Nuvoton-Israel/nuvoton-info/README.md

# Nuvoton Info
Information of Nuvoton's NPCM7xx:
 - Evaluation Board (EVB)
     https://github.com/Nuvoton-Israel/nuvoton-info/blob/master/npcm7xx-poleg/evaluation-board
 - RunBMC
     https://github.com/Nuvoton-Israel/nuvoton-info/blob/master/npcm7xx-poleg/RunBMC
 - graphics
     https://github.com/Nuvoton-Israel/nuvoton-info/blob/master/npcm7xx-poleg/Graphics
 
Contains BootBlock, u-boot and OpenBMC programming guide, tools and SW.

Openbmc features and capabilities on the EVB are are described [here](https://github.com/Nuvoton-Israel/openbmc/blob/master/meta-evb/meta-evb-nuvoton/meta-evb-npcm750/README.md).
