Nuvoton-Israel/nuvoton-info/npcm7xx-poleg/readme.txt

------------------------------------------------------------------------
Nuvoton Technology Corporation - Confidential
Poleg OpenBMC files and instructions
Copyright (c) 2017-2019 Nuvoton Technology Corporation. All Rights Reserved.
------------------------------------------------------------------------

Poleg npcm7xx-poleg files and instructions
==========================================

Folder content
==============
--evaluation-board - EVB board and SW (see readme.txt inside
--RunBMC           - RunBMC board and SW (see readme.txt inside
--Graphics         - Graphic drivers

----------------------------
For any help please contact:
tomer.maimon@nuvoton.com
avi.fishman@nuvoton.com
tali.perry@nuvoton.com
oshri.alkoby@nuvoton.com
----------------------------
