Nuvoton-Israel/nuvoton-info/npcm7xx-poleg/RunBMC/board_deliverables/Nuvoton_RunBMC_Module/RunBMC_NPCM7mnx_BOM_A.1.0.xlsx

Quantity | Value | Description | Part Reference
145 | 0.1uF | CAP CER X5R SMD 0.1uF 10% 10V 0201 | C1 C2 C3 C4 C5 C6 C7 C8 C9 C10 C11 C12 C13 C14 C15 C16 C17 C18 C19 C23 C25 C26 C28 C29 C31 C33 C34 C35 C37 C38 C39 C40 C41 C42 C43 C44 C45 C46 C47 C48 C49 C50 C51 C52 C53 C54 C55 C56 C61 C63 C64 C66 C67 C68 C72 C73 C74 C75 C76 C77 C78 C79 C80 C81 C82 C83 C84 C85 C89 C90 C91 C92 C93 C94 C95 C96 C97 C98 C99 C100 C101 C102 C103 C104 C105 C106 C107 C108 C109 C112 C113 C114 C116 C117 C118 C119 C120 C121 C123 C127 C128 C129 C131 C133 C134 C135 C136 C137 C138 C139 C141 C142 C143 C144 C146 C148 C150 C152 C154 C155 C157 C158 C161 C162 C164 C165 C167 C170 C171 C172 C174 C175 C176 C178 C179 C180 C181 C182 C183 C193 C194 C195 C200 C201 C202
28 | 4.7uF | CAP CER X5R SMD 4.7uF 10% 16V 0402 | C20 C21 C24 C30 C32 C36 C57 C58 C65 C70 C71 C87 C88 C110 C111 C115 C122 C124 C130 C140 C145 C163 C168 C169 C173 C177 C188 C191
22 | 22uF | CAP CER X5R SMD 22uF 20% 6.3V 0603 | C22 C27 C59 C60 C69 C86 C147 C149 C151 C153 C160 C166 C186 C187 C189 C190 C192 C196 C197 C199 C203 C204
1 | 1nF | CAP CER X5R SMD 1nF 10% 10V 0201 | C62
3 | 22pF | CAP CER X5R SMD 22pF 10% 10V 0201 | C125 C126 C184
1 | 1uF | CAP CER X7R SMD 1uF 10% 10V 0402 | C132
2 | 18pF | CAP CER NPO SMD 18pF 5% 16V 0402 | C156 C159
1 | 33pF | CAP CER X5R SMD 33pF 10% 10V 0201 | C185
2 | 2700pF | CAP CER X5R SMD 2700pF 10% 6.3V 0201 | C198 C205
2 | DSF01S30SL | Diode SMD Schottky 30V 100mA | D1 D2
1 | LED Green | FHD1105P-TR, 5mA, Green, 0402 | D3
1 | LED Amber | FHA1105P-TR, 5mA, Amber, 0402 | D4
1 | SMD D-ROW 8P 1.25MM | Con Recept SMD D-ROW 8P 1.25MM | J1
1 | SODIMM_260P | SODIMM_260P | J2
1 | 47uH | Inductor SMD 47uH 75mA SRF=11Mhz 10% 0805 | L1
11 | BK0603HR102-T | Bead SMD 1K@100MHz 220mA 1.15R 0201 | L2 L3 L4 L5 L7 L10 L11 L12 L13 L14 L15
3 | BK1005HS102-T | Bead SMD 1K@100MHz 300mA 580mR 0402 | L6 L18 L19
5 | BLM15PX121SN1D | Bead SMD 120R@100MHz 2A 55mR 0402 | L8 L9 L16 L17 L20
2 | 1.5uH | Inductor SMD 1.5uH at 1MHz 20% 54mR 3A | L21 L22
37 | 0R | RES SMD 0R 0201 | R1 R2 R53 R62 R66 R67 R138 R185 R193 R195 R196 R197 R198 R199 R200 R201 R202 R203 R204 R205 R206 R207 R208 R209 R216 R230 R231 R232 R233 R241 R242 R243 R244 R251 R252 R253 R274
25 | 10K | RES SMD 10K 1% 0201 | R3 R4 R5 R6 R8 R9 R163 R164 R165 R166 R167 R168 R169 R170 R171 R172 R173 R214 R215 R262 R265 R268 R269 R273 R275
91 | 24.9R | RES SMD 24.9R 1% 0201 | R7 R47 R48 R54 R57 R58 R59 R109 R110 R111 R112 R113 R114 R115 R116 R117 R118 R119 R120 R121 R122 R123 R124 R125 R126 R127 R128 R129 R130 R131 R132 R133 R134 R135 R136 R137 R139 R140 R141 R142 R143 R144 R145 R146 R147 R148 R149 R150 R151 R152 R153 R154 R155 R156 R174 R175 R176 R177 R178 R179 R180 R181 R182 R183 R184 R210 R211 R212 R213 R217 R218 R219 R220 R221 R222 R223 R224 R225 R226 R227 R228 R229 R248 R254 R255 R256 R257 R258 R259 R260 R261
9 | 100K | RES SMD 100K 1% 0201 | R10 R70 R71 R72 R73 R74 R75 R76 R77
20 | 4.7K | RES SMD 4.7K 1% 0201 | R11 R12 R55 R56 R189 R190 R191 R192 R234 R235 R236 R237 R238 R239 R240 R245 R246 R247 R249 R250
24 | 17R | RES SMD 17R 1% 0201 | R13 R14 R15 R16 R17 R18 R19 R20 R21 R22 R23 R24 R25 R26 R27 R28 R29 R30 R31 R32 R33 R34 R35 R36
4 | 240R | RES SMD 240R 0.5% 0201 | R37 R38 R158 R161
2 | 49R | RES SMD 49R 1% 0201 | R39 R40
4 | 1K | RES SMD 1K 1% 0201 | R41 R42 R159 R162
3 | 200R | RES SMD 200R 1% 0201 | R43 R186 R187
3 | 75R | RES SMD 75R 0201 | R44 R45 R46
3 | 150R | RES SMD 150R 0201 | R49 R50 R51
1 | 3.74K | RES SMD 3.74K 1% 0201 | R52
2 | 220R | RES SMD 220R 1% 0201 | R60 R61
13 | 100R | RES SMD 100R 1% 0201 | R63 R64 R65 R68 R69 R101 R102 R103 R104 R105 R106 R107 R108
22 | 6.8K | RES SMD 6.8K 1% 0201 | R78 R79 R80 R81 R82 R83 R84 R85 R86 R87 R88 R89 R90 R91 R92 R93 R94 R95 R96 R97 R98 R99
1 | 20R | RES SMD 20R 1% 0201 | R100
2 | 100K | RES SMD 100K 1% 0201 | R157 R160
1 | 1.5K | RES SMD 1.5K 1% 0201 | R188
1 | 1.24K | RES SMD 1.24K 1% 0201 | R194
1 | 51K | RES SMD 51K 1% 0201 | R263
4 | 24K | RES SMD 24K 1% 0201 | R264 R267 R272 R278
1 | 30K | RES SMD 30K 1% 0201 | R266
2 | 8.2K | RES SMD 8.2K 1% 0201 | R270 R276
1 | 12K | RES SMD 12K 1% 0201 | R271
1 | 11.3K | RES SMD 11.3K 1% 0201 | R277
14 | Test Point Pad 20X20mil | Test Point Pad 20X20 mil for Scope Probing | TP1 TP2 TP3 TP4 TP5 TP6 TP7 TP8 TP9 TP10 TP11 TP12 TP13 TP14
2 | 74LVC1G11DW-7 | IC Single 3 Input AND Gate | U2 U4
1 | ECS-2520MV-250-CN-TR | Crystal Clock OSC SMD | U3
1 | ATtiny1634 QFN20 | Micro-Controller | U5
1 | TXS0102DCUR | IC 2-Bit Bidirectional Voltage-Level Translator for Open-Drain and Push-Pull 8-VFSOP | U8
1 | BCM54612EB1KMLG | IC 10/100/1000 BASE-T Gigabit Ethernet transceiver with RGMII MAC 3.3V MLP-48 | U9
1 | 74CBTLV3245 | Bus-Switch 8bit | U10
1 | AP22802AW5-7 | Load Switch | U11
1 | 74AHC1G00SE-7 | IC Single 3 Input AND Gate | U12
2 | MX66L51235F | IC Memory SMD Quad / Dual SPI Flash 512Mbit 2.7-3.6V 8-WSON | U13 U14
1 | M24xxx | I2C EEPROM M24xxx | U15
1 | M95512 | IC Memory SMD Quad / Dual SPI Flash 512Mbit 2.7-3.6V 8-WSON | U16
1 | TMP75 | TMP75 | U17
1 | SPI-2-Dual_UART_SC16IS75(6)2IBS | SC16IS75(6)2IBS | U18
2 | RT9059GQW | IC Linear SMD Regulator 3A 10WDFN | U19 U20
1 | NPCM750R | IC Microcontroller SMD BMC 2D Graphic Core KVM FCBGA-517 3.3V-2.5V | U1
2 | BD9A300MUV | IC Synchronous PWM Switching Buck Regulator 18Vmax SOIC8 | U21 U22
1 | APX823-29W5G-7 | IC Logic SMD Reset Controller Cirquit 2.973V | U23
1 | MT40A512M16HA-083E | IC Memory SMD SDRAM (DDR4-3200) 4Gb (256MX16) 1.2V FBGA-96 | U6
1 | H26M41204HPR | IC Memory eMMC 8GB v5.0-compliant 3.3V WFBGA-153 | U7
1 | 25MHz | Crystal SMD 25MHz 30ppm 18pF 3.2 X 2.5mm BGA-4 | Y1
1 | 24Mhz | Crystal SMD 24MHz 30ppm 10pF 3.2 X 2.5mm BGA-4 | Y2
