Nuvoton-Israel/nuvoton-info/npcm7xx-poleg/evaluation-board/readme.txt

------------------------------------------------------------------------
Nuvoton Technology Corporation - Confidential
Poleg OpenBMC files and instructions
Copyright (c) 2017-2018 Nuvoton Technology Corporation. All Rights Reserved.
------------------------------------------------------------------------

Poleg OpenBMC files and instructions
====================================

Building instructions:
======================
	In order to build Nuvoton OpenBMC use:
	======================================
	https://github.com/Nuvoton-Israel/openbmc/releases/tag/npcm-v2.3-181030
	Follow instructions at the README.md inside
	Nuvoton OpenBMC builds both Nuvoton u-boot and linux.
	
	To build them separately:

	In order to build Nuvoton linux use:
	====================================
	https://github.com/Nuvoton-Israel/linux
	Branch Poleg-4.17.04-OpenBMC
	To build it run:
		make ARCH=arm PolegSVB_defconfig
		make uImage nuvoton-npcm750-evb.dtb modules CROSS_COMPILE=arm-none-linux-gnueabi- ARCH=arm LOADADDR=0x8000

	In order to build Nuvoton u-boot use:
	=====================================
	https://github.com/Nuvoton-Israel/u-boot
	Follow build instructions see:
	https://github.com/Nuvoton-Israel/u-boot/blob/npcm7xx/HowToBuild-npcm7xx.txt

Loading to Evaluation Board and running instructions:
=====================================================
	Use the provided Evaluation board (EB) with the pre-built images:
	=================================================================
	For initial EB setup see:
	- ./board_deliverables/NPCM750x_EVB_Quick_Setup_Guide.pdf
	For loading images to EB and running them.
	- ./sw_deliverables/NPCM7xx_OpenBMC_Programming.pdf
	
	Testing your peripheral access:
	===============================
	The following shell script contains examples for reading / writing to peripherals
	- ./sw_deliverables/linux_peripheral_testings.sh

FTP CONTENTS
============
Eval_Board
|   readme.txt - this readme file
|
|---sw_deliverables
|   |   NPCM7xx_OpenBMC_Programming.pdf - describes how to update the EB
|   |   uboot_env_parameters.txt - uboot environment that will load and run the OpenBMC_linux_X.X.X
|   |   linux_peripheral_testings.sh - shell script with examples for reading / writing to peripherals
|   |
|   \---npcm7xx_v2.3 - built images of Nuvoton OpenBMC
|           image-bmc    - The entire 32MB image including BootBlock, u-boot, linux kernel
|                          and file system, can be programmed into the beginning of flash
|           image-u-boot - Includes only BootBlock and u-boot and their headers can be
|                          programmed into the beginning of flash
|           image-kernel - FIT image that includes linux kernel, device tree and an
|                          initial file system, can be loaded to the linux area in flash
|           image-rofs   - Main (and large) OpenBMC file system, can be loaded to the
|                          rofs area in flash
|           uboot_env_parameters.txt - uboot environment that will load this image
|
|---board_deliverables
|       NPCM750x_EVB_Quick_Setup_Guide.pdf  - How to work with the EB 
|       NPCM750x_EB_ver.A1.1_COMPLETE.pdf   - EVB schematics
|
\---Graphics
        Poleg_Graphics_Drivers_3.0.zip - Graphic drivers for BIOS, UEFI, Windows and linux

----------------------------
For any help please contact:
tomer.maimon@nuvoton.com
avi.fishman@nuvoton.com
tali.perry@nuvoton.com
oshri.alkoby@nuvoton.com
----------------------------
