Nuvoton-Israel/nuvoton-info/npcm7xx-poleg/evaluation-board/board_deliverables/NPCM750x_EB_ver.A1.1_COMPLETE.pdf

# NPCM750x Evaluation Board

# Schematics, Layout, Assembly and BOM

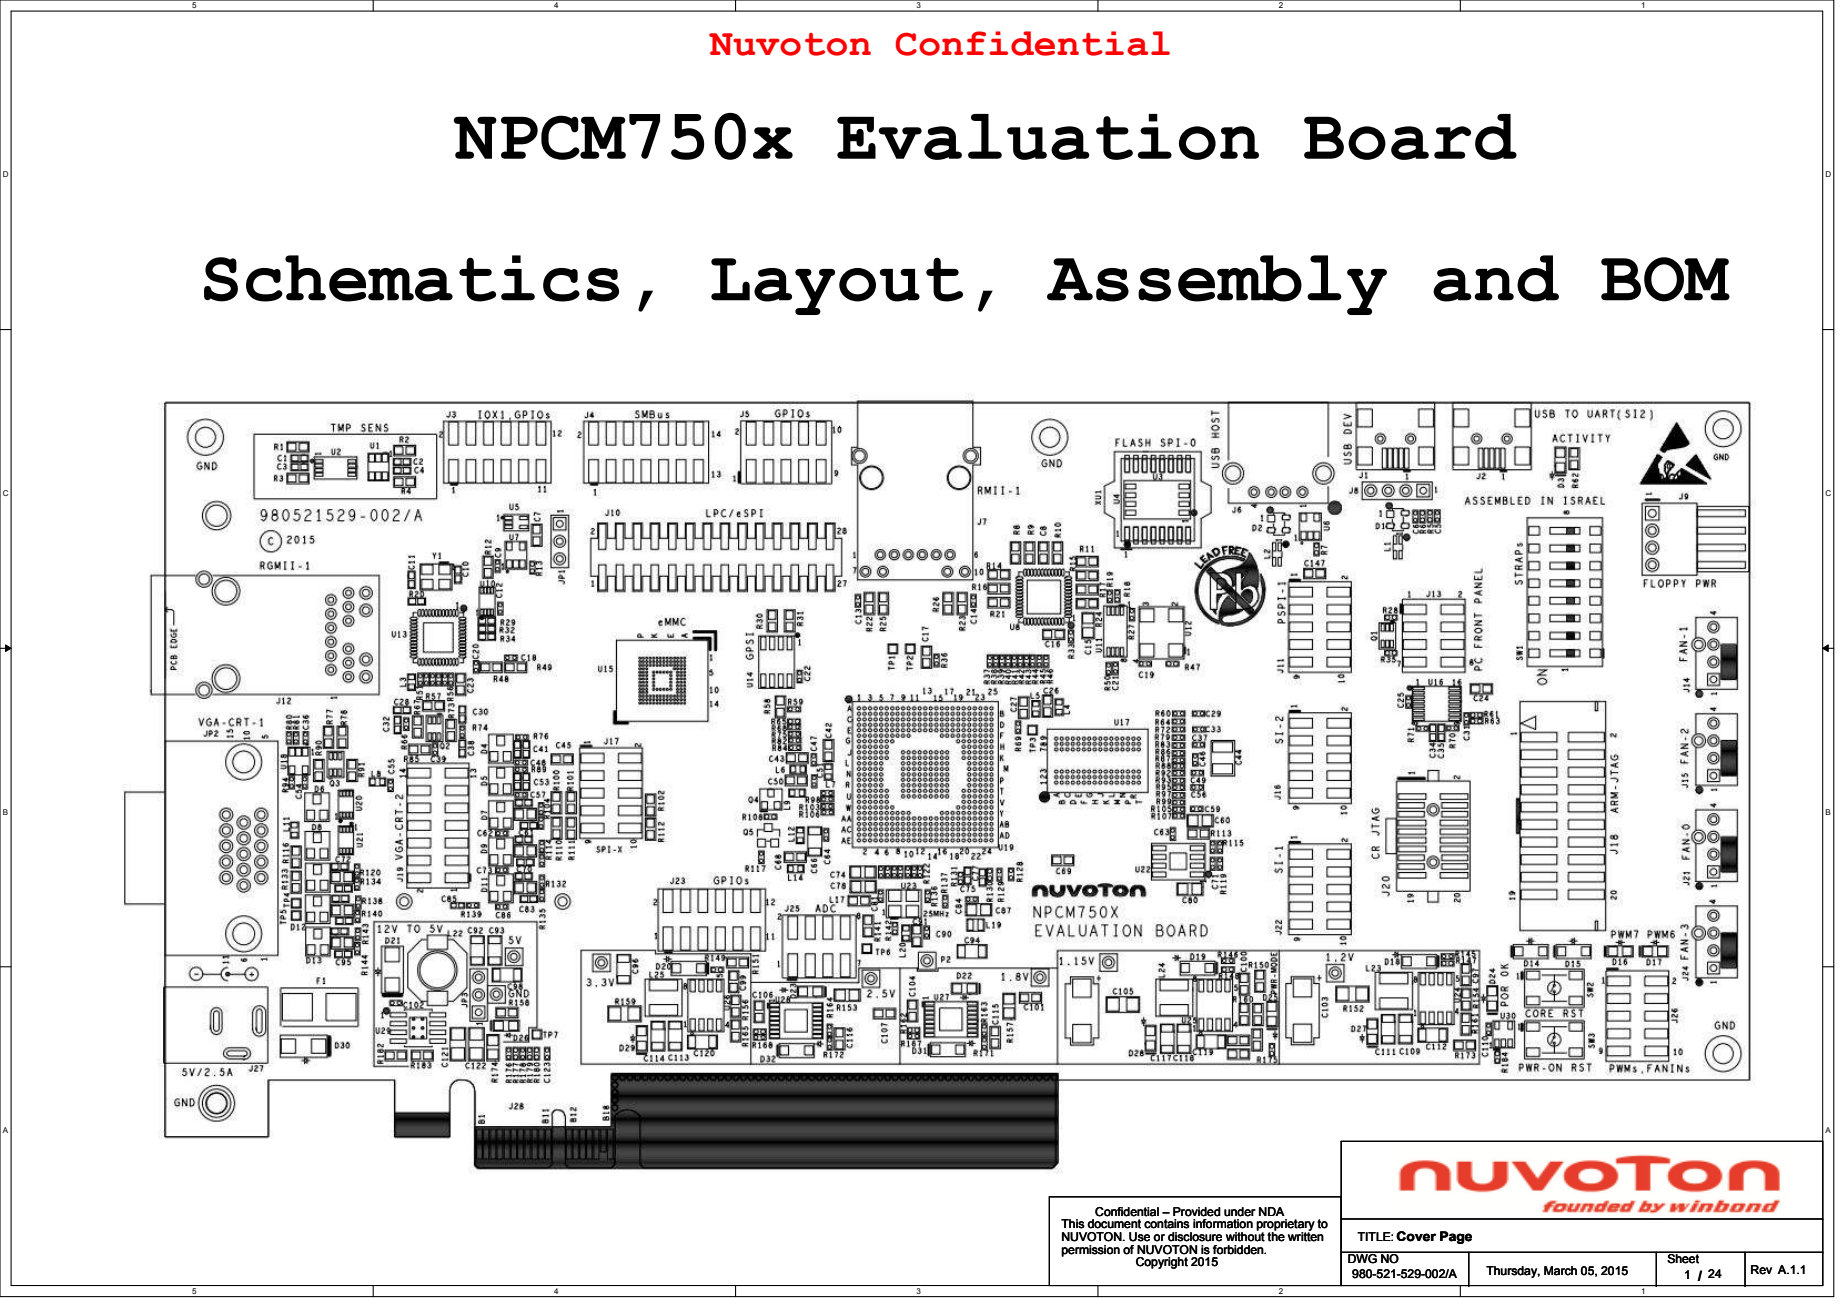
[picture p30: page 1]
Nuvoton Confidential; DWG NO; Rev; Sheet; TITLE:; Copyright 2015; Cover Page; Thursday, March 05, 2015

This document contains information proprietary to
NUVOTON. Use or disclosure without the written
permission of NUVOTON is forbidden.

Confidential – Provided under NDA

# NPCM750x

## PCIe x1

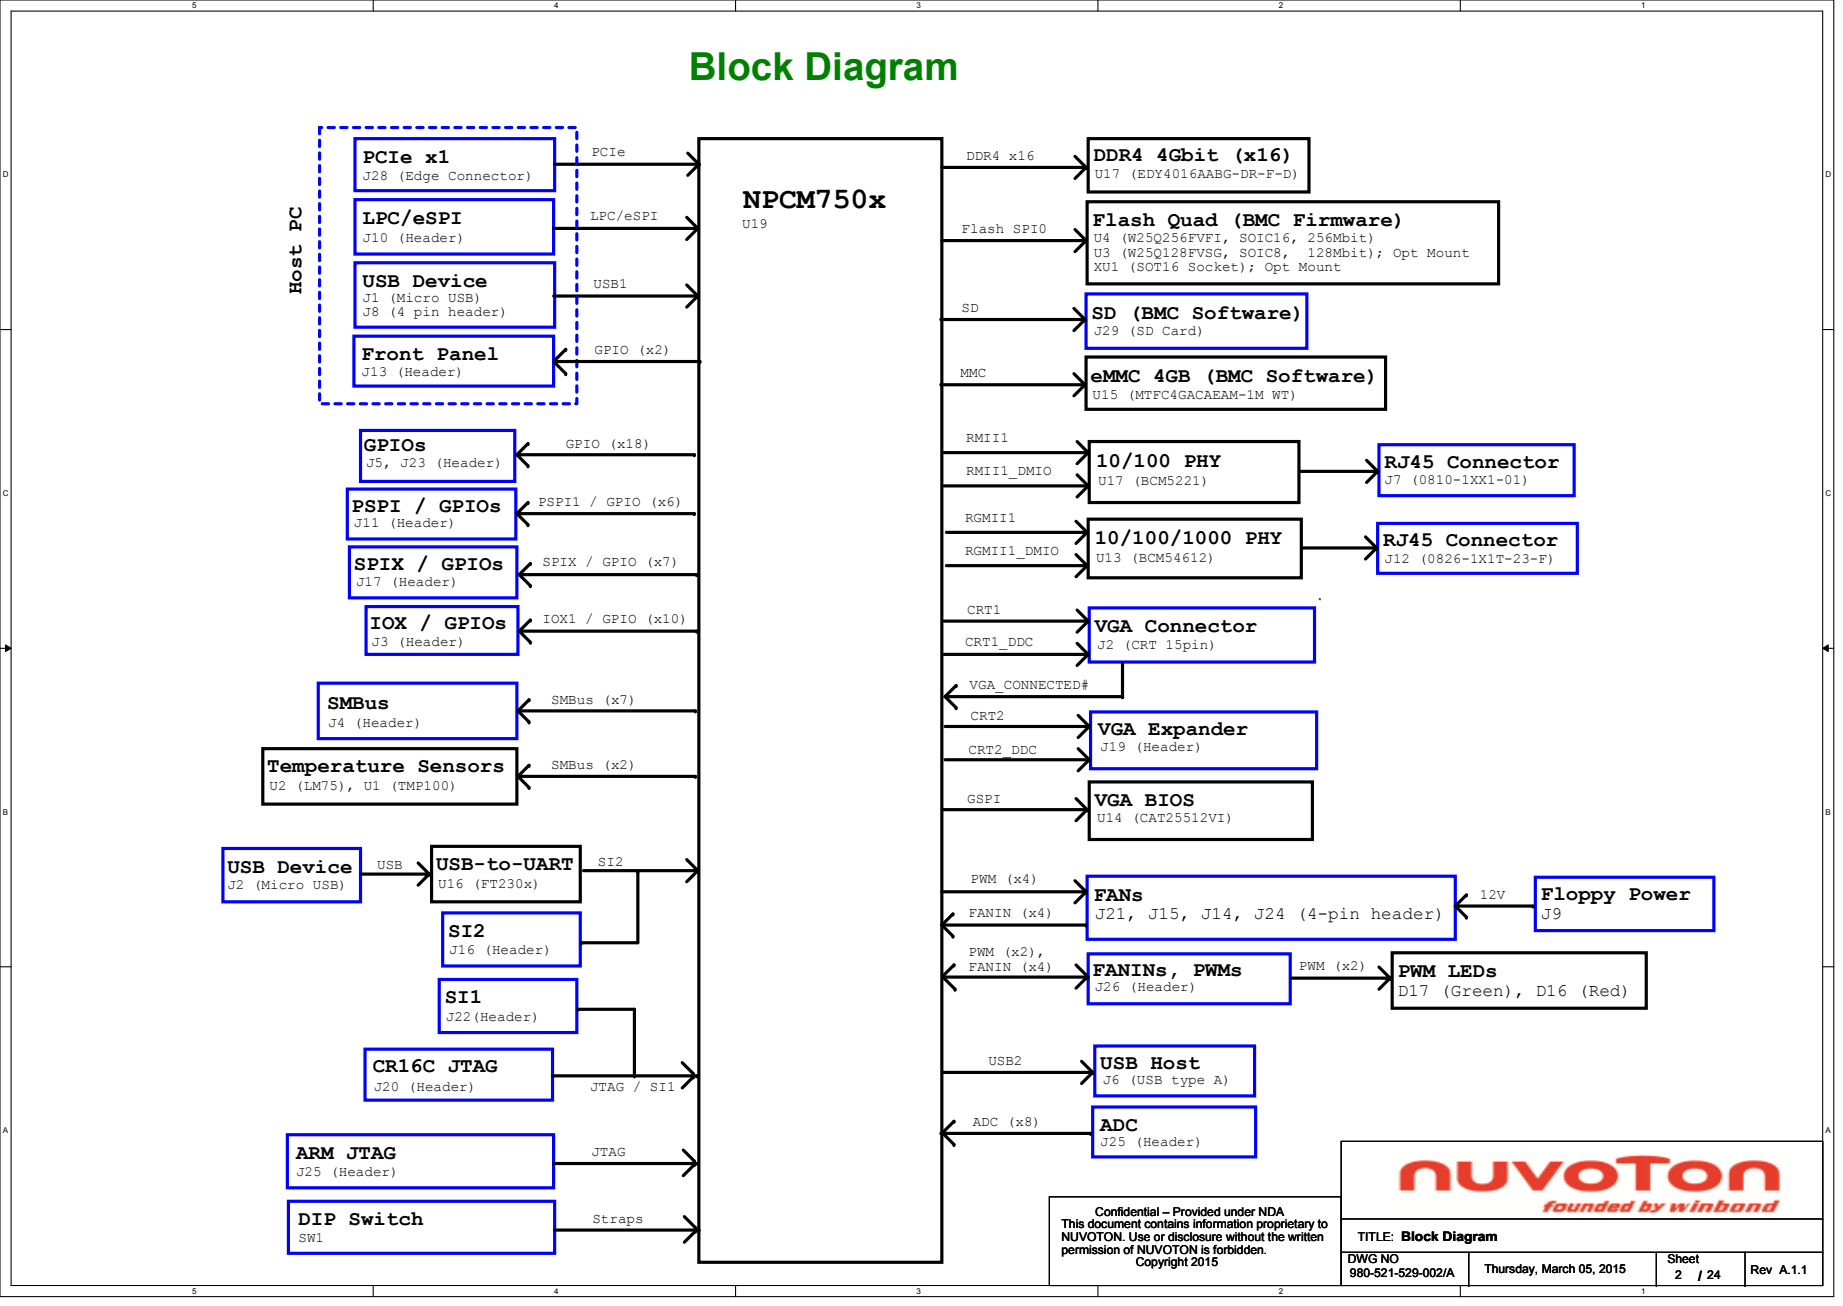
[picture p31: page 2]

Flash Quad (BMC Firmware)
U4 (W25Q256FVFI, SOIC16, 256Mbit)
U3 (W25Q128FVSG, SOIC8, 128Mbit); Opt Mount
XU1 (SOT16 Socket); Opt Mount

# Power Tree

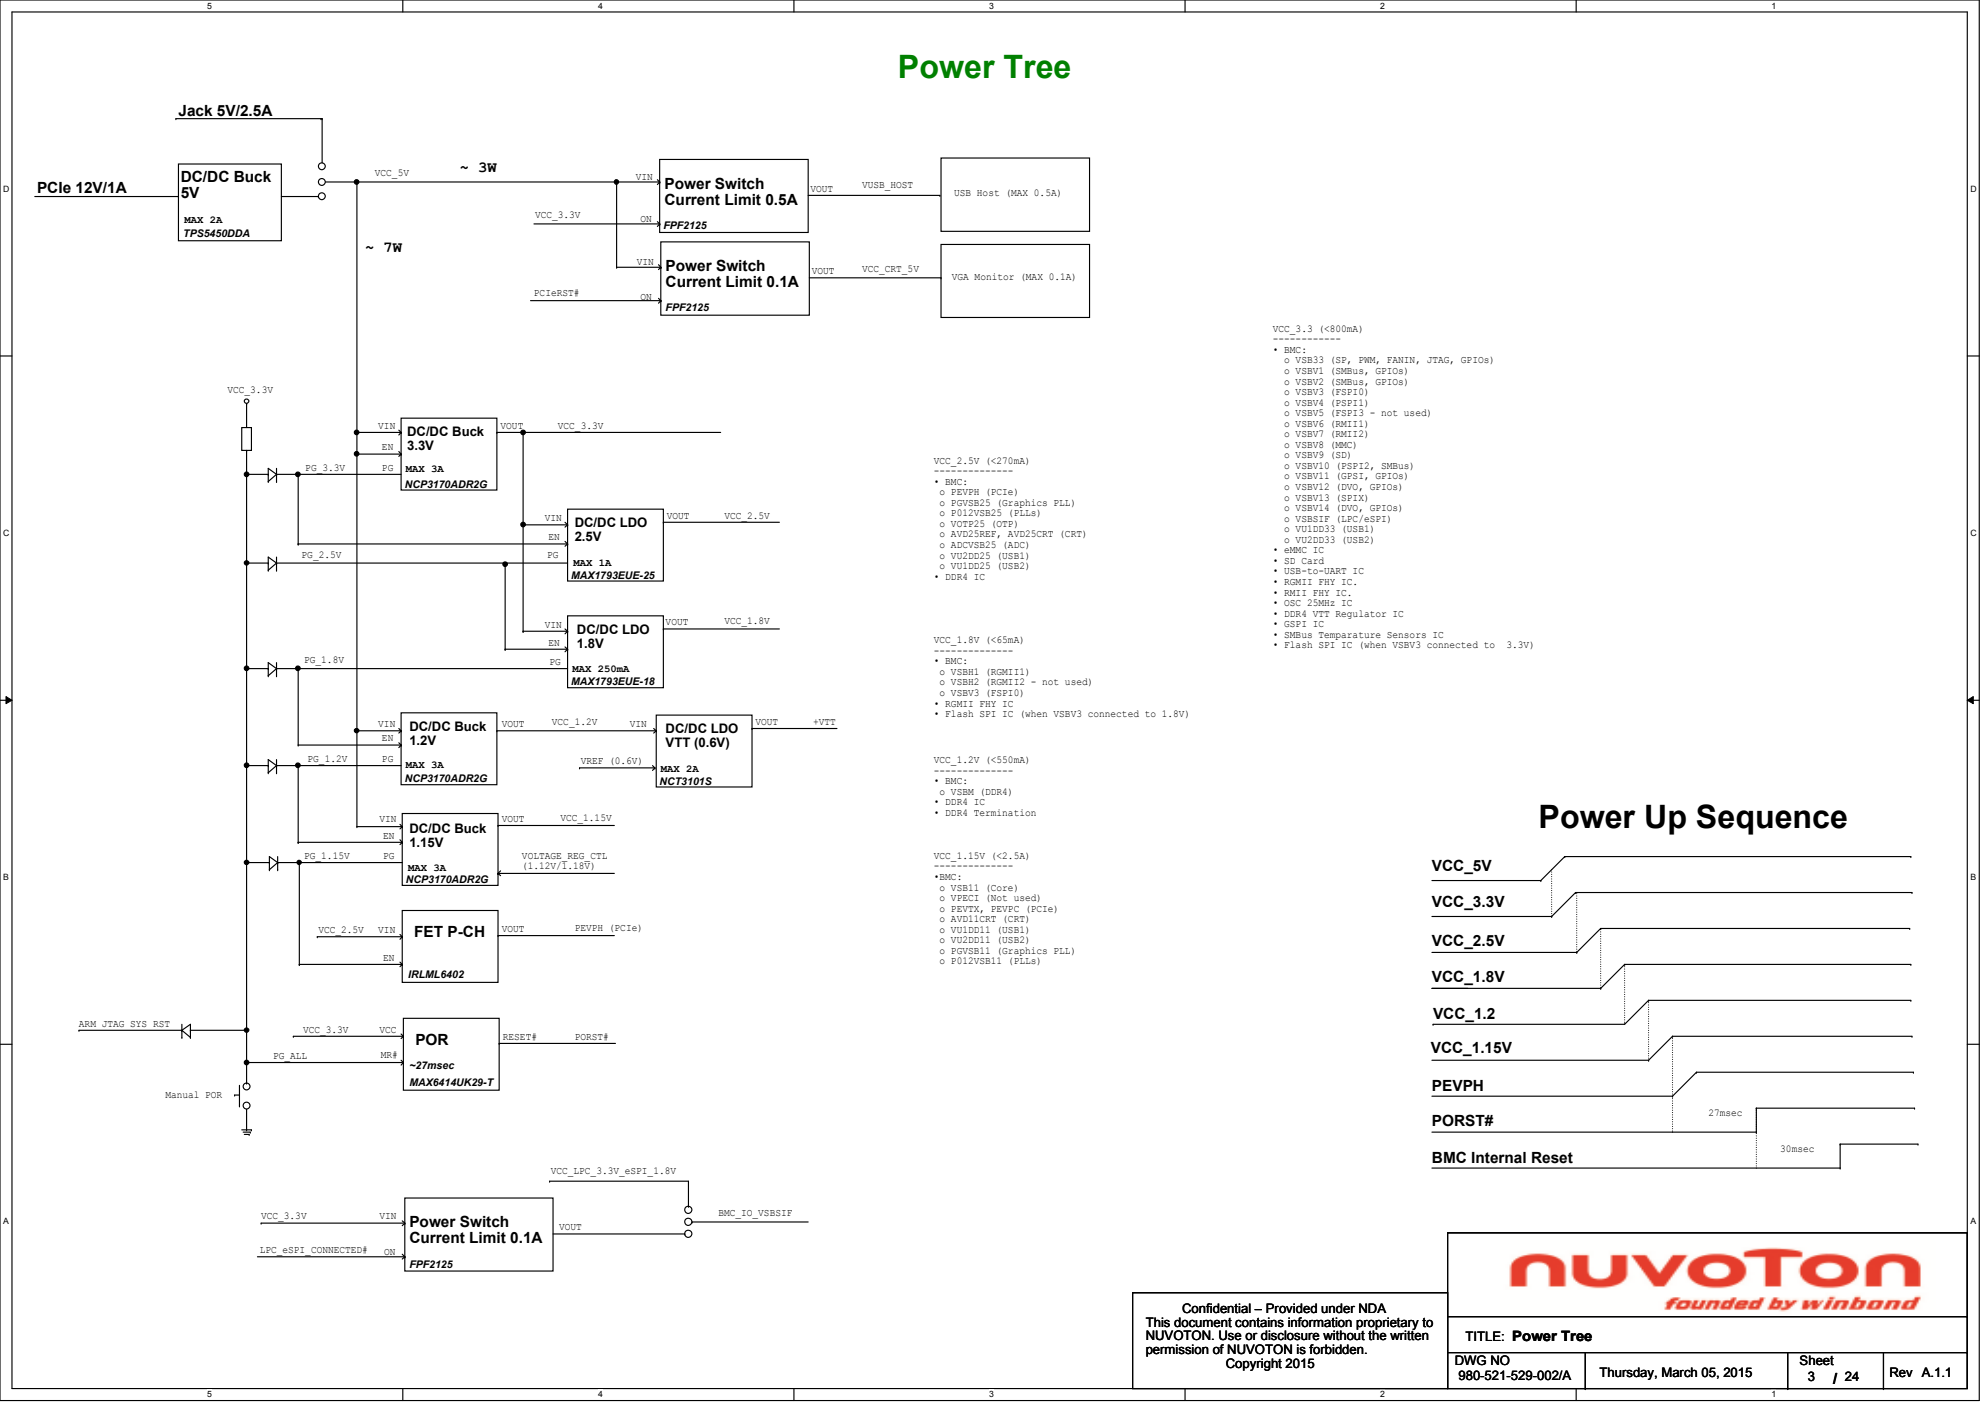
[picture p32: page 3]
VCC_5V; Power Switch; Current Limit 0.5A; FPF2125; Power Switch Current Limit 0.1A; PCIeRST#; VIN; VOUT; VCC_3.3V; DC/DC Buck 3.3V; NCP3170ADR2G; DC/DC Buck 1.2V; DC/DC Buck 1.15V; VCC_1.2V; VCC_1.15V; FET P-CH VOUT; PEVPH (PCIe); IRLML6402; POR; RESET#; PORST#; MAX6414UK29-T; ~27msec PG_ALL; VCC ARM JTAG SYS RST; Manual POR; VOLTAGE_REG_CTL (1.12V/1.18V); VCC_2.5V; VCC_3.3 (<800mA) ------------ • BMC:; 27msec; VCC_1.8V; VCC_1.2; PEVPH; VCC_CRT_5V; VUSB_HOST; LPC_eSPI_CONNECTED#; BMC_IO_VSBSIF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

USB Host (MAX 0.5A)

VGA Monitor (MAX 0.1A)

• VSB33 (SP, PWM, FANIN, JTAG, GPIOs)
• VSBV1 (SMBus, GPIOs)
• VSBV2 (SMBus, GPIOs)
• VSBV3 (FSPI0)
• VSBV4 (PSPI1)
• VSBV5 (FSPI3 - not used)
• VSBV6 (RMII1)
• VSBV7 (RMII2)
• VSBV8 (MMC)
• VSBV9 (SD)
• VSBV10 (PSPI2, SMBus)
• VSBV11 (GPSI, GPIOs)
• VSBV12 (DVO, GPIOs)
• VSBV13 (SPIX)
• VSBV14 (DVO, GPIOs)
• VSBSIF (LPC/eSPI)
• VU1DD33 (USB1)
• VU2DD33 (USB2)
• eMMC IC
• SD Card
• USB-to-UART IC
• RGMII FHY IC.
• RMII FHY IC.
• OSC 25MHz IC
• DDR4 VTT Regulator IC
• GSPI IC
• SMBus Temparature Sensors IC
• Flash SPI IC (when VSBV3 connected to 3.3V)

• VSBH1 (RGMII1)
• VSBH2 (RGMII2 - not used)
• RGMII FHY IC
• Flash SPI IC (when VSBV3 connected to 1.8V)

DC/DC LDO
VTT (0.6V)

Power Up Sequence

30msec BMC Internal Reset

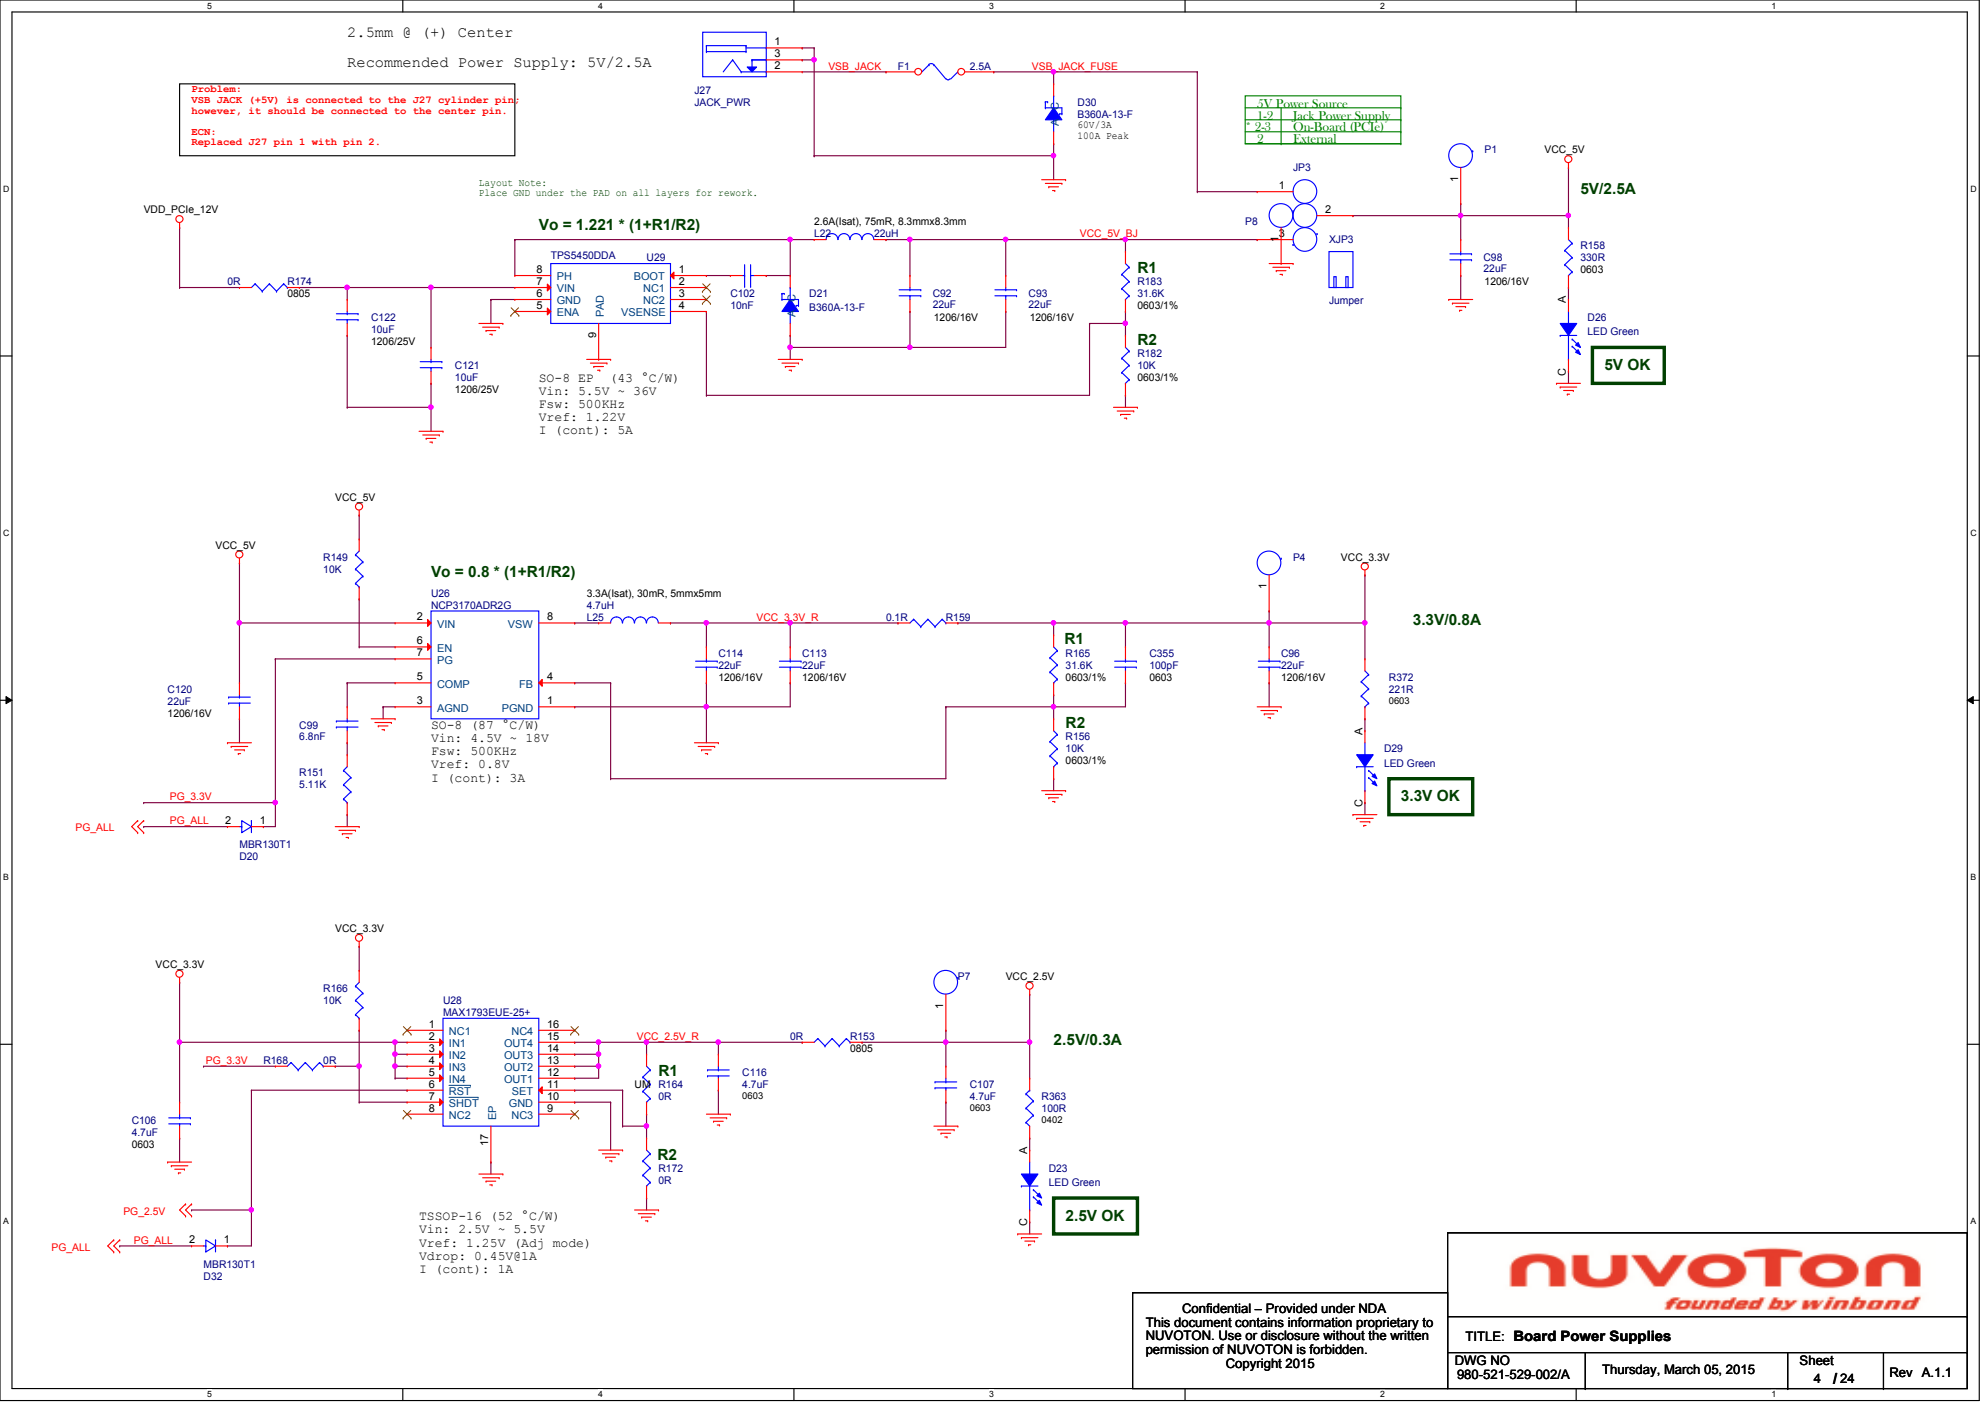
[picture p33: page 4]

Problem:
VSB JACK (+5V) is connected to the J27 cylinder pin;
however, it should be connected to the center pin.

ECN:
Replaced J27 pin 1 with pin 2.

Layout Note:
Place GND under the PAD on all layers for rework.

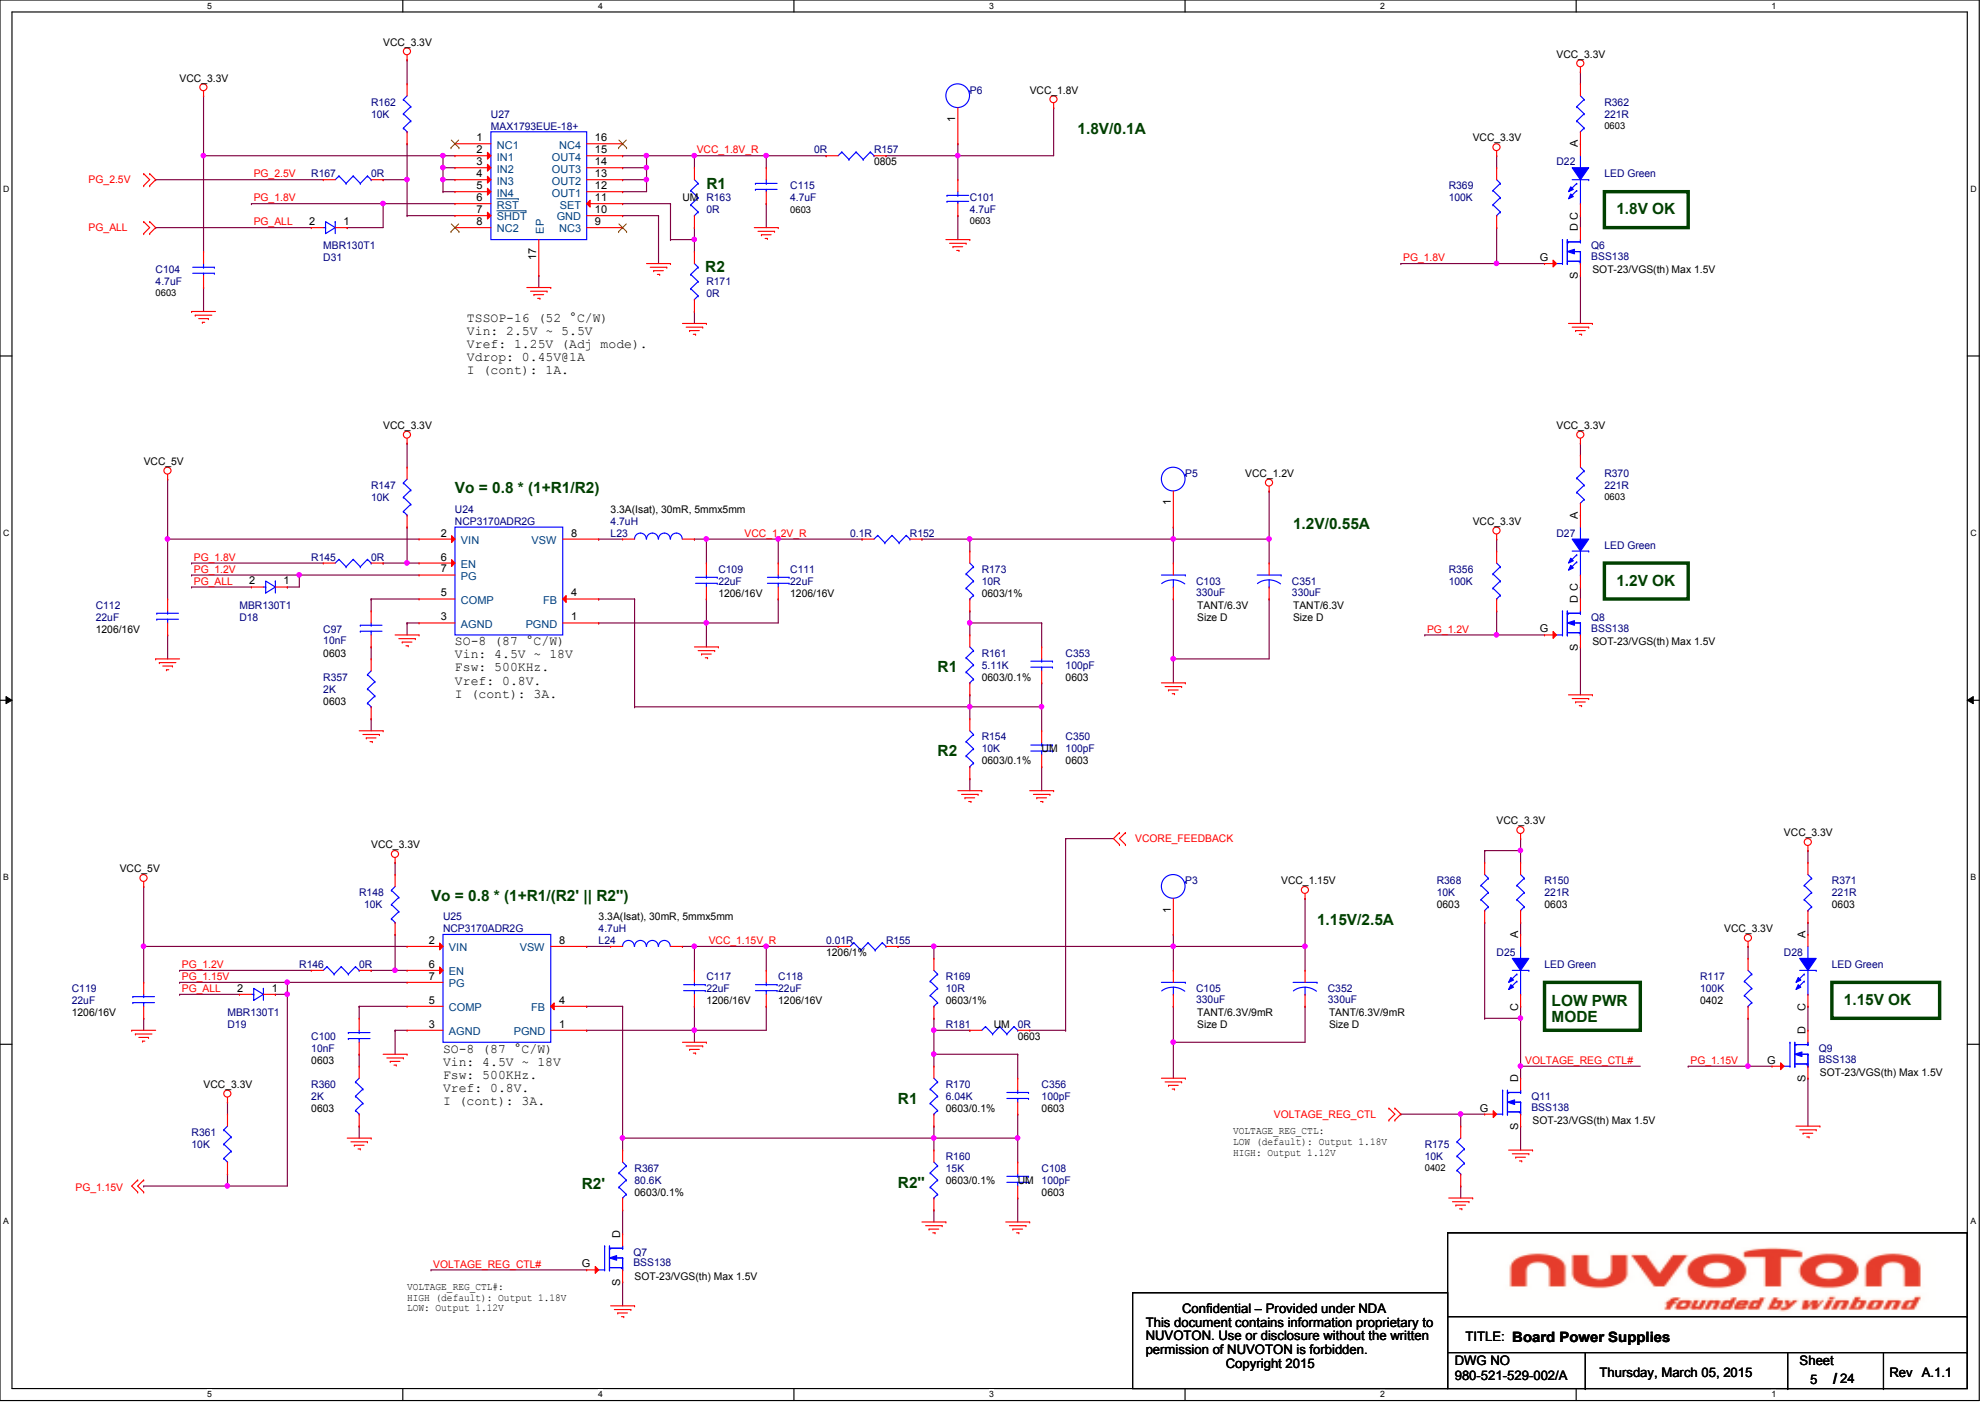
[picture p34: page 5]

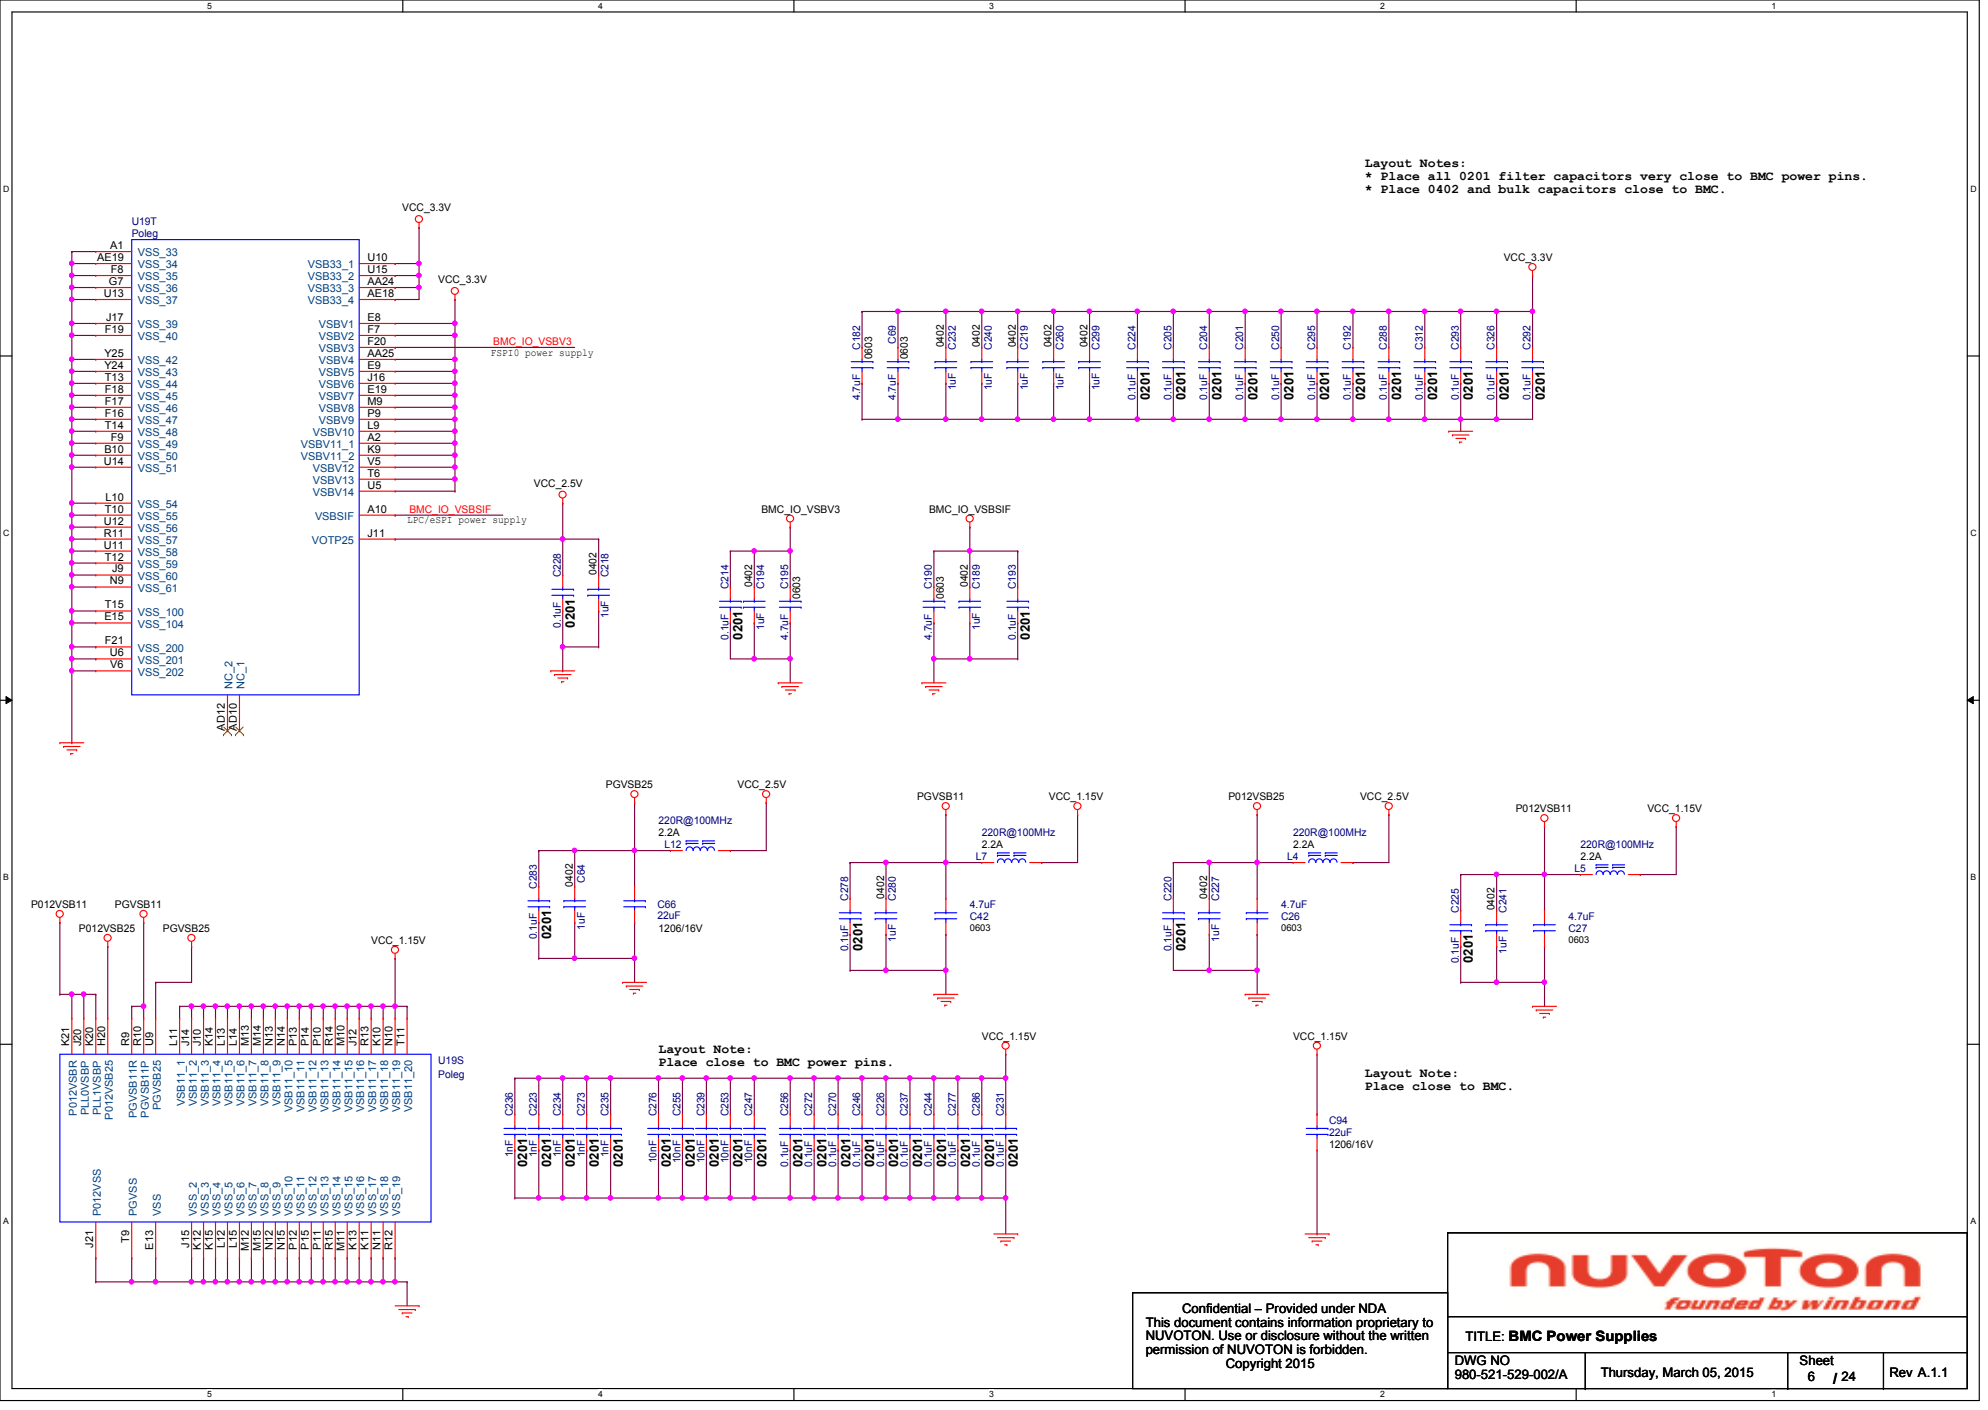
[picture p35: page 6]

Layout Notes:
* Place all 0201 filter capacitors very close to BMC power pins.
* Place 0402 and bulk capacitors close to BMC.

BMC_IO_VSBSIF
LPC/eSPI power supply

Layout Note:
Place close to BMC power pins.

Place close to BMC.

# Clock and Resets

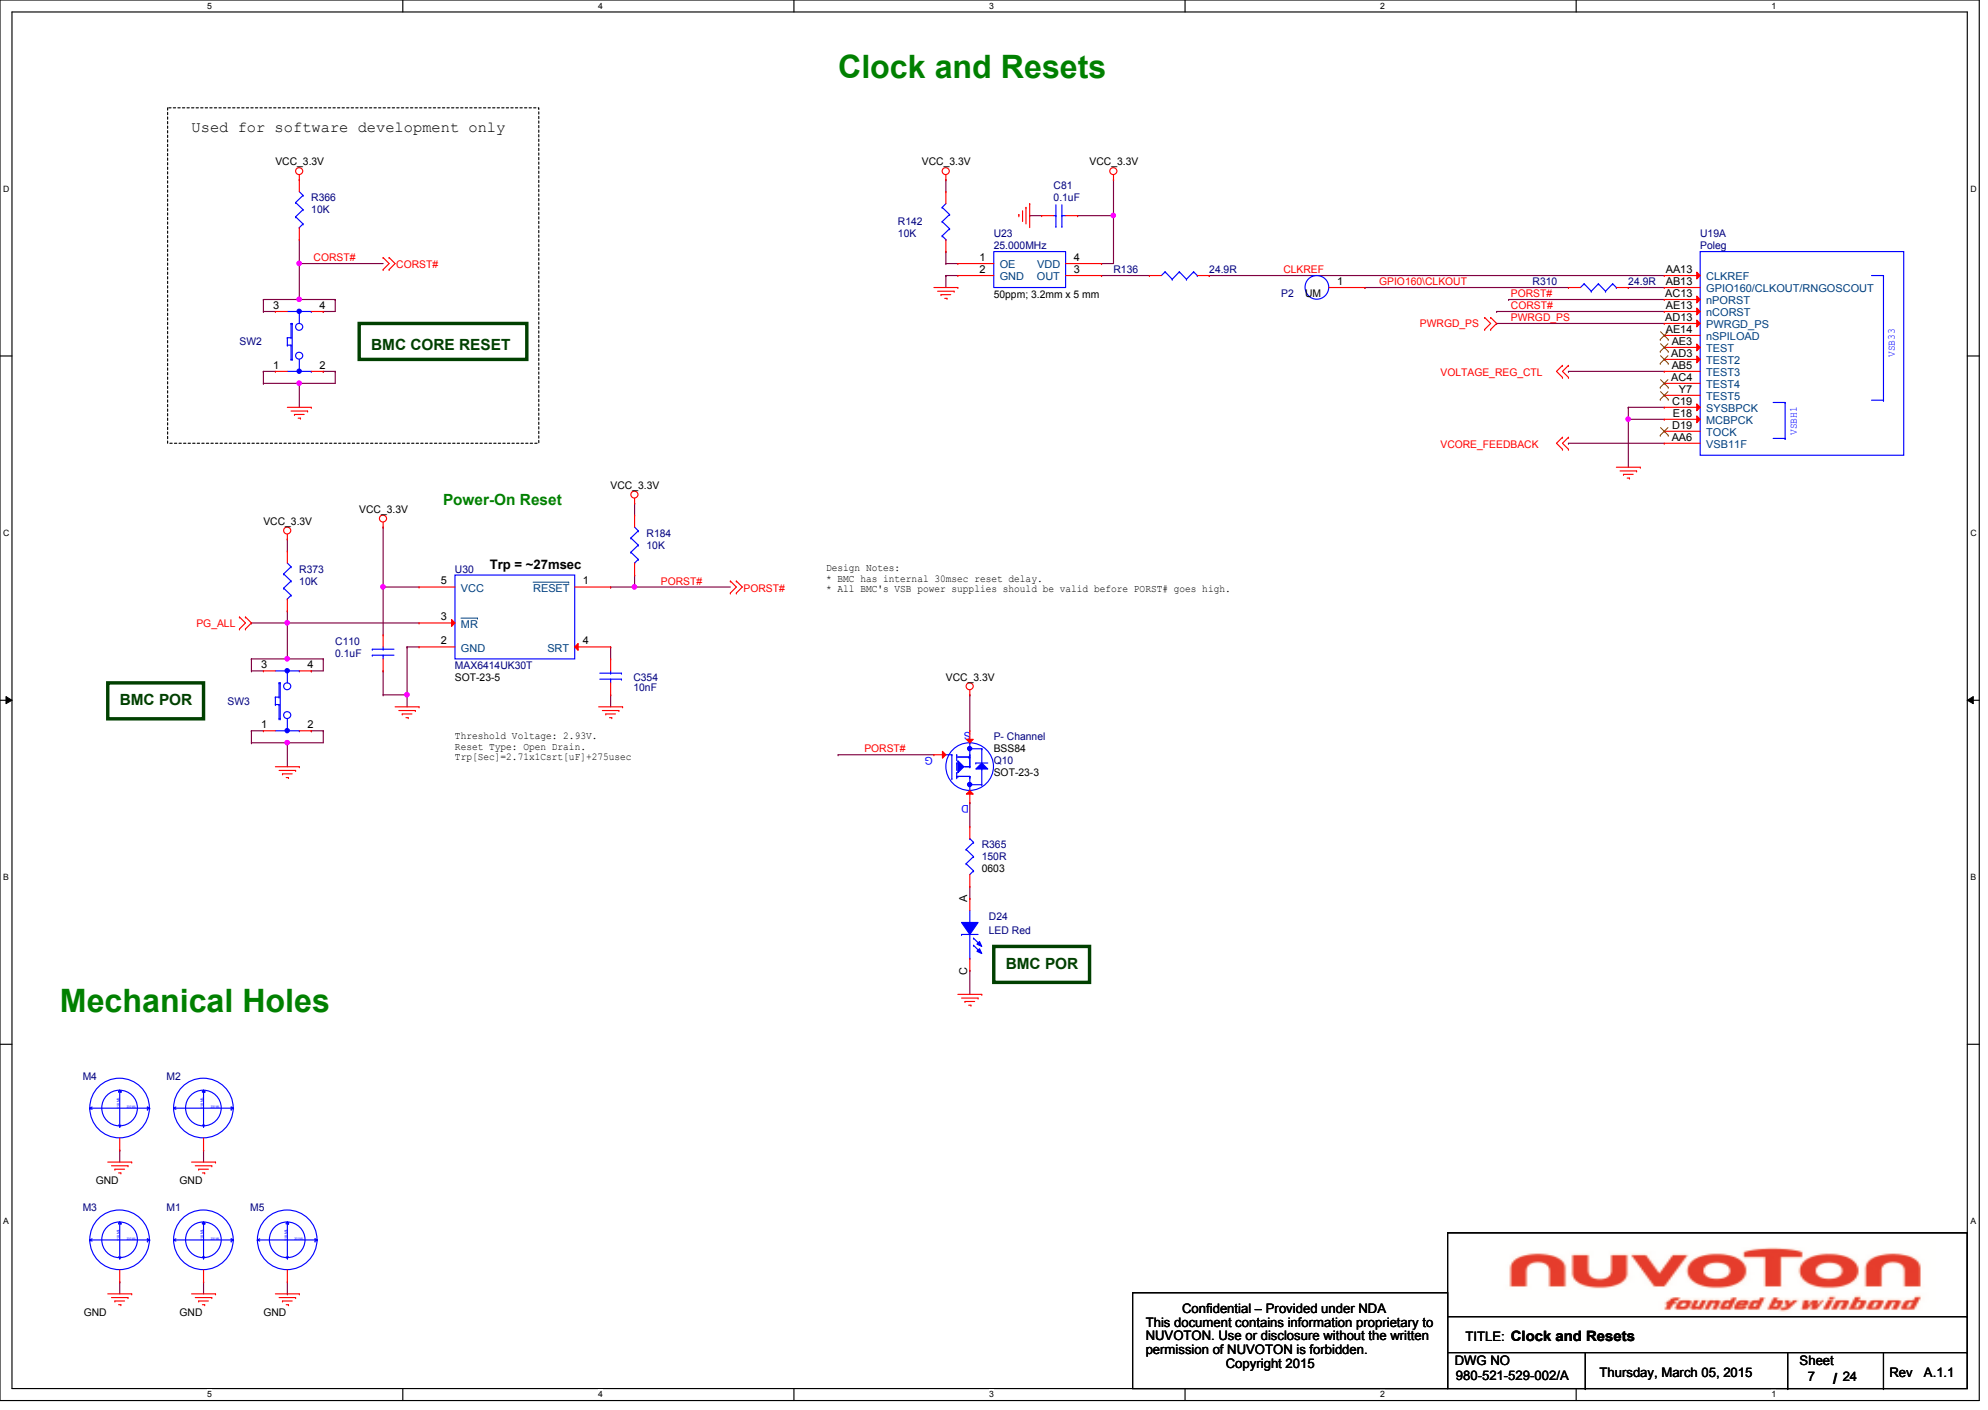
[picture p36: page 7]

Used for software development only

Design Notes:
* BMC has internal 30msec reset delay.
* All BMC's VSB power supplies should be valid before PORST# goes high.

Threshold Voltage: 2.93V.
Reset Type: Open Drain.
Trp[Sec]=2.71x1Csrt[uF]+275usec

# DDR4

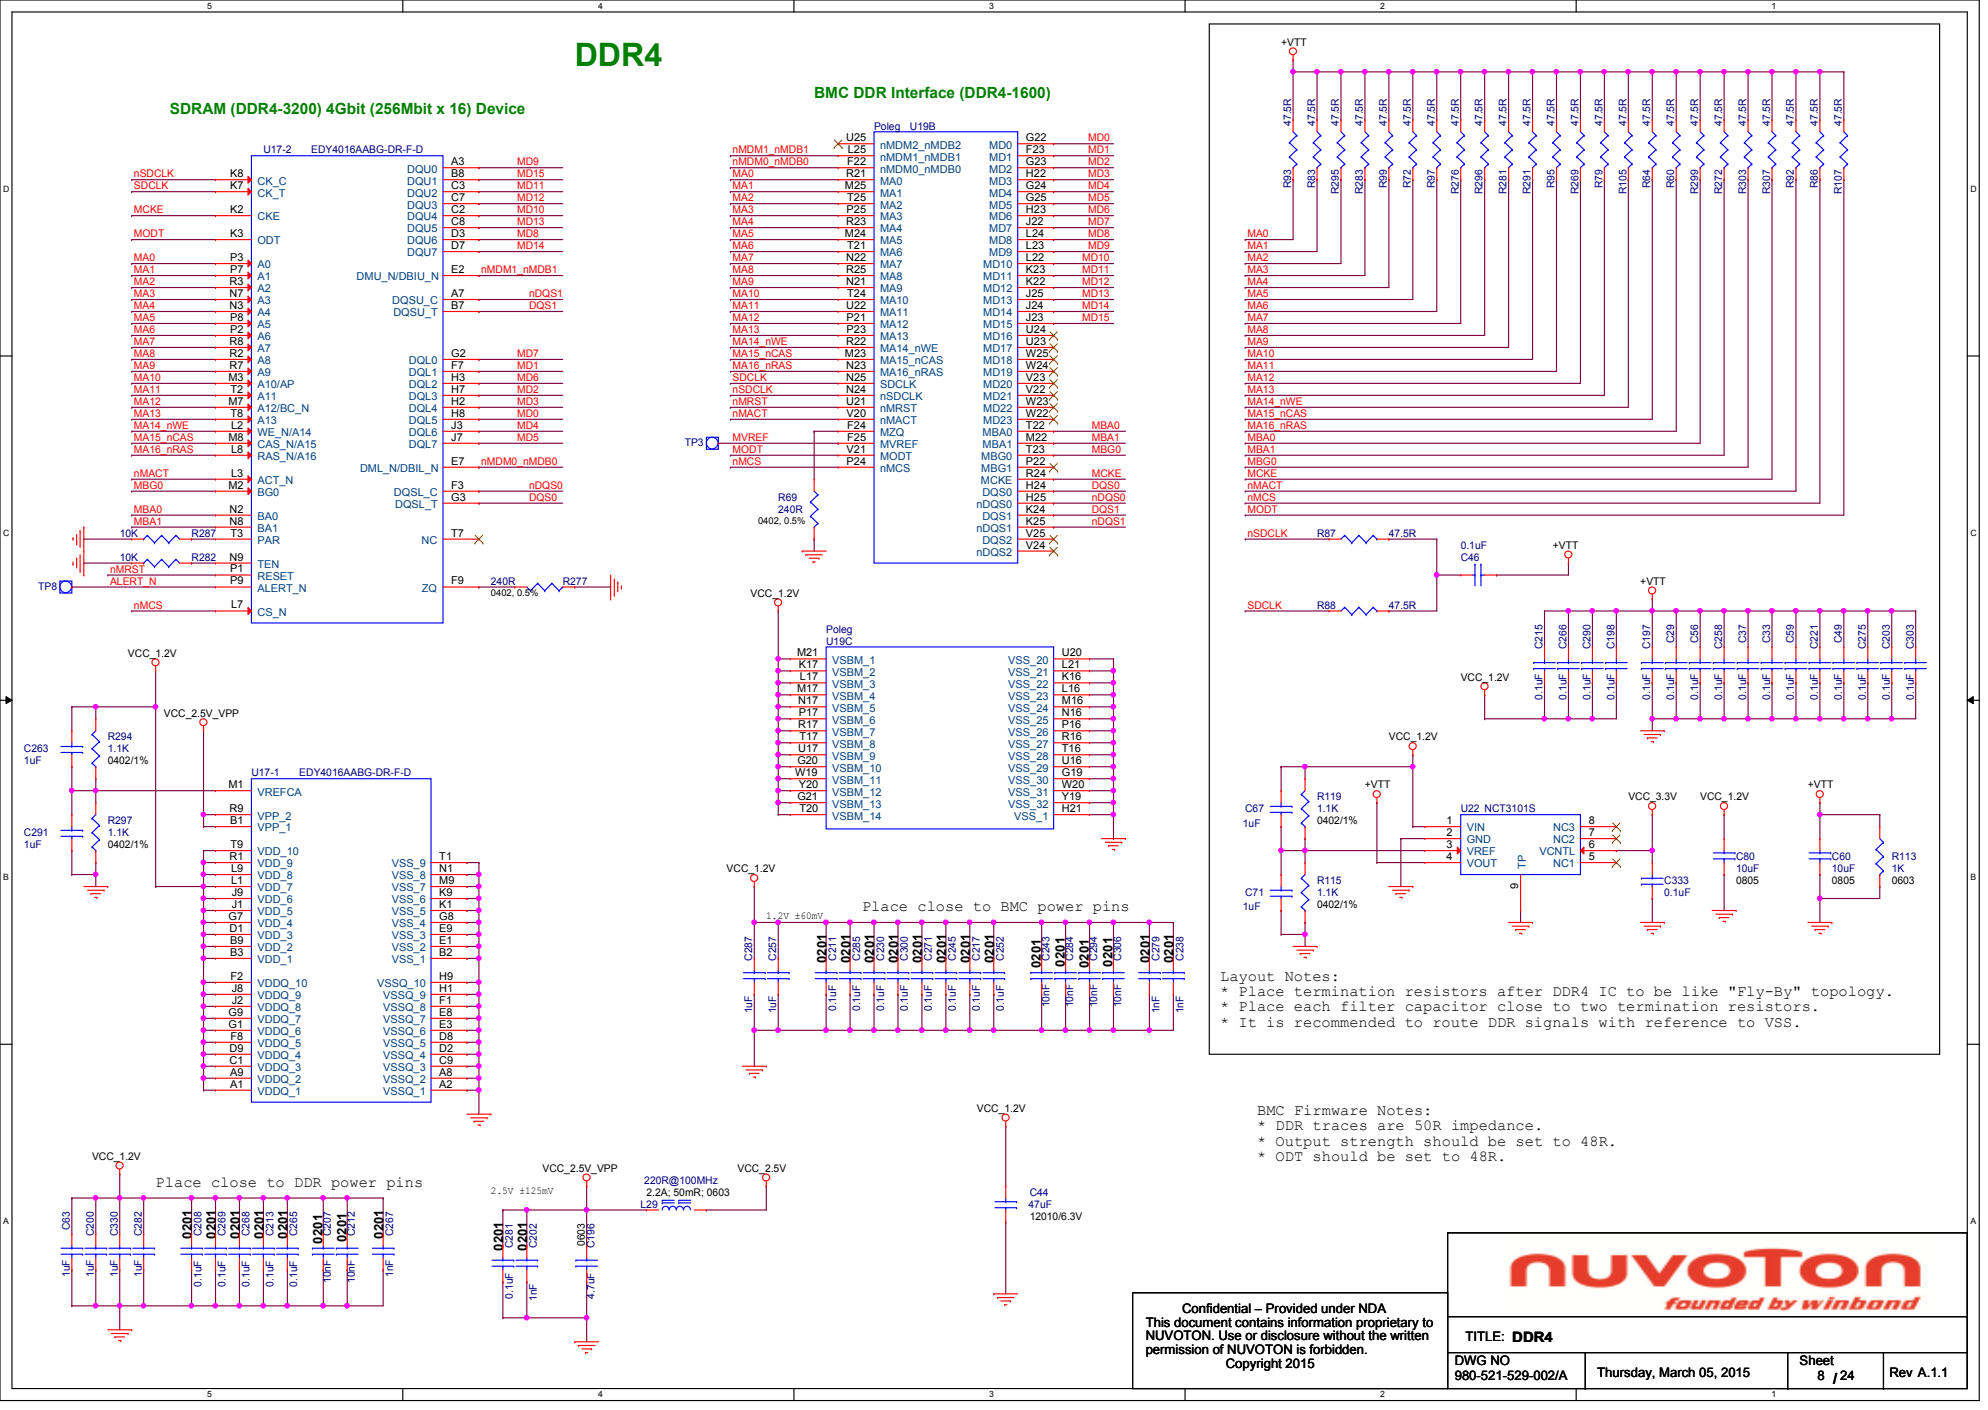
[picture p37: page 8]

Place close to BMC power pins

Layout Notes:
* Place termination resistors after DDR4 IC to be like "Fly-By" topology.
* Place each filter capacitor close to two termination resistors.
* It is recommended to route DDR signals with reference to VSS.

BMC Firmware Notes:
* DDR traces are 50R impedance.
* Output strength should be set to 48R.
* ODT should be set to 48R.

Place close to DDR power pins

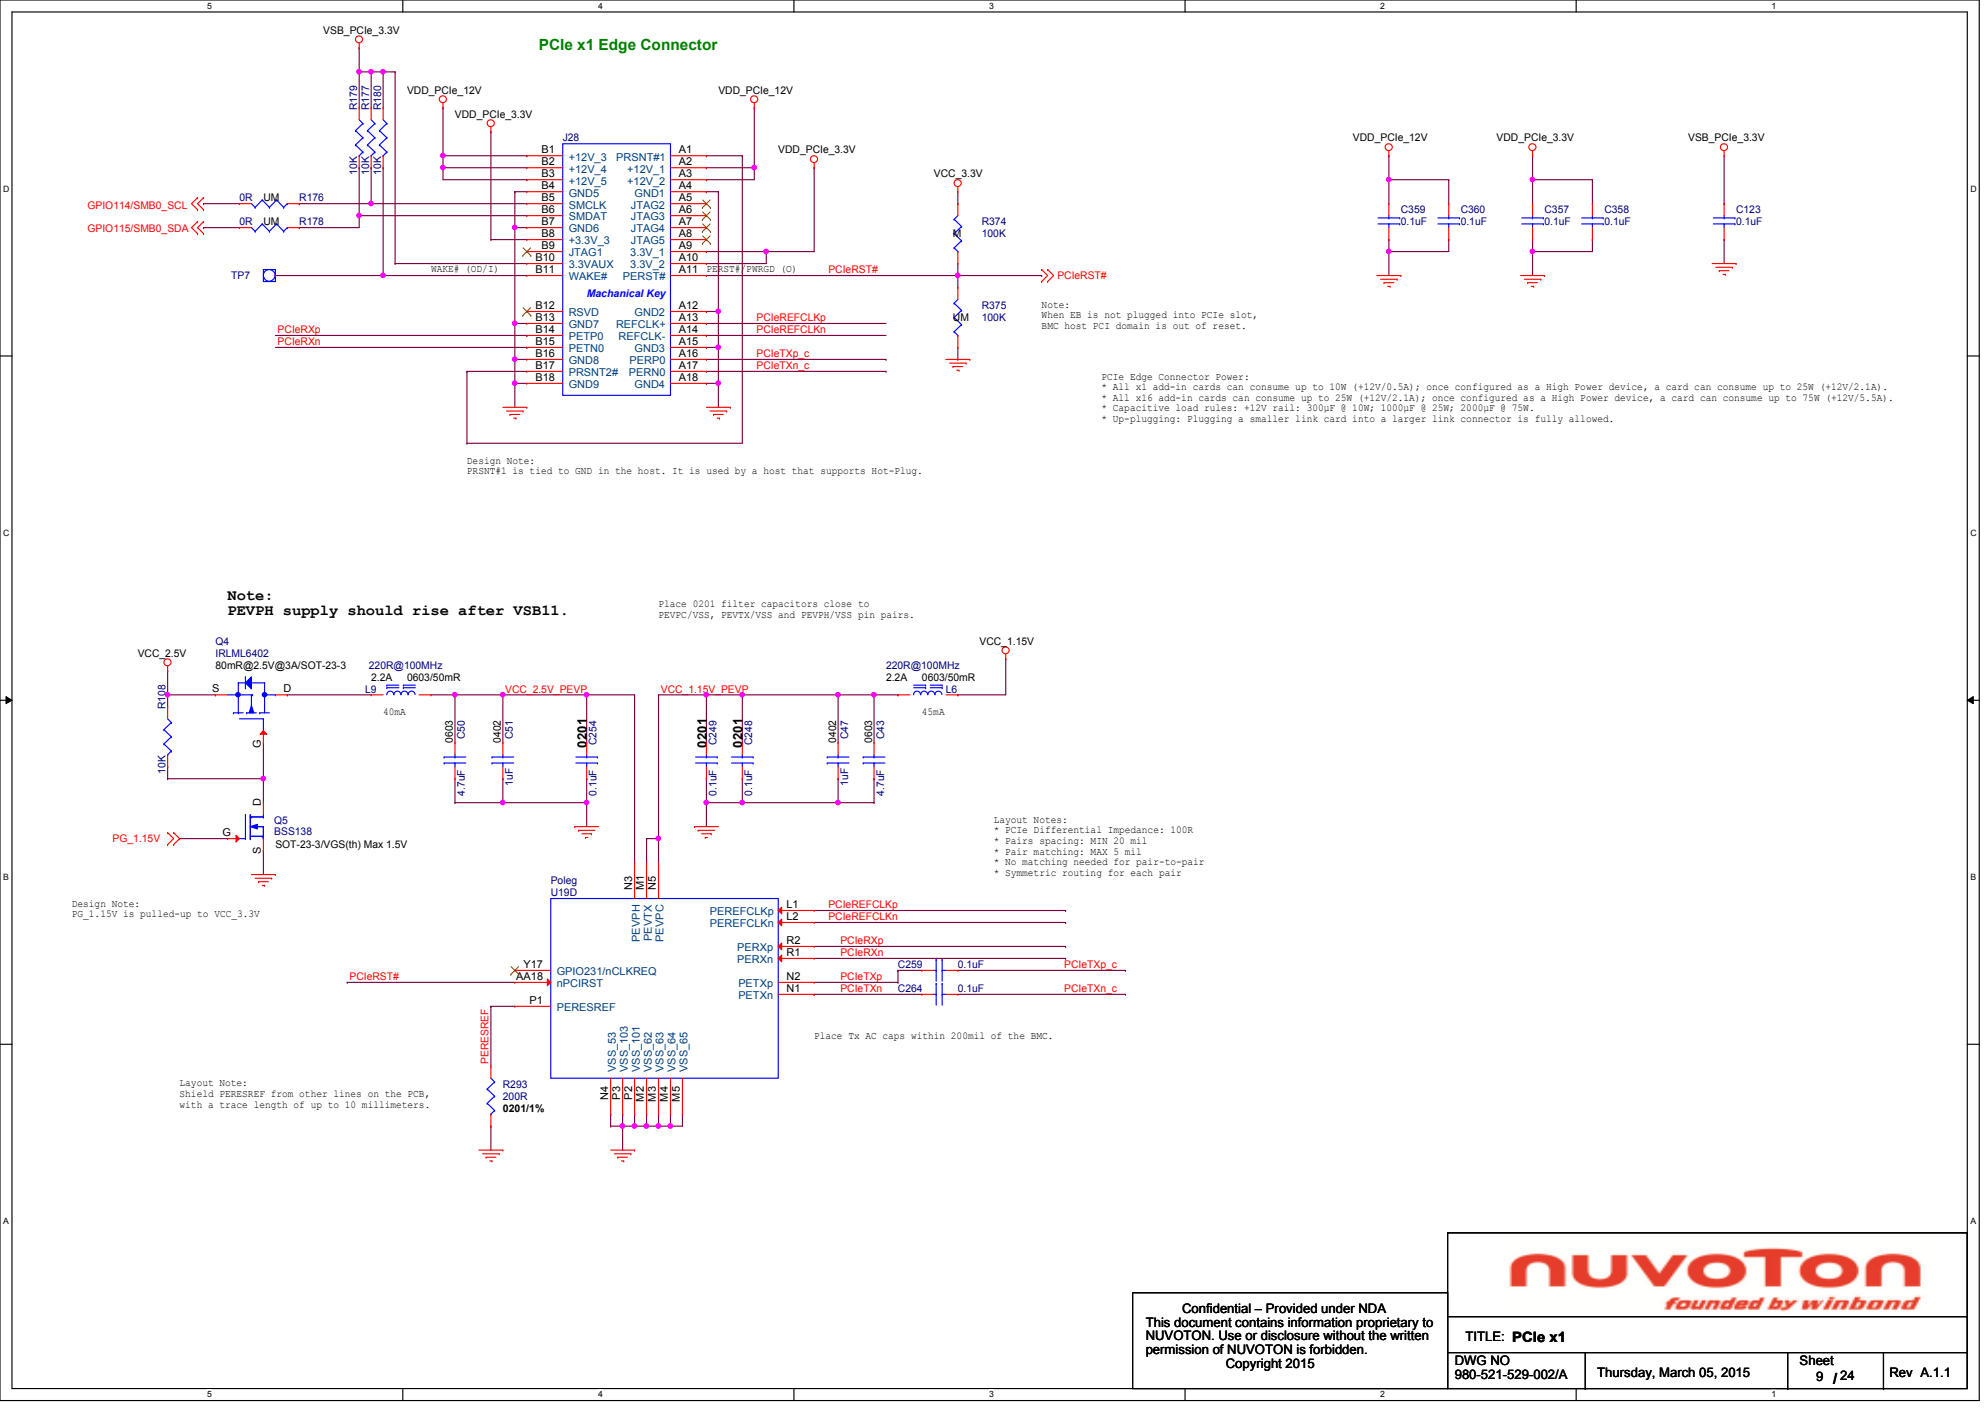
[picture p38: page 9]

Note:
When EB is not plugged into PCIe slot,
BMC host PCI domain is out of reset.

PCIe Edge Connector Power:
* All x1 add-in cards can consume up to 10W (+12V/0.5A); once configured as a High Power device, a card can consume up to 25W (+12V/2.1A).
* All x16 add-in cards can consume up to 25W (+12V/2.1A); once configured as a High Power device, a card can consume up to 75W (+12V/5.5A).
* Capacitive load rules: +12V rail: 300µF @ 10W; 1000µF @ 25W; 2000µF @ 75W.
* Up-plugging: Plugging a smaller link card into a larger link connector is fully allowed.

Design Note:
PRSNT#1 is tied to GND in the host. It is used by a host that supports Hot-Plug.

PEVPH supply should rise after VSB11.

Place 0201 filter capacitors close to
PEVPC/VSS, PEVTX/VSS and PEVPH/VSS pin pairs.

Layout Notes:
* PCIe Differential Impedance: 100R
* Pairs spacing: MIN 20 mil
* Pair matching: MAX 5 mil
* No matching needed for pair-to-pair
* Symmetric routing for each pair

PG_1.15V is pulled-up to VCC_3.3V

Place Tx AC caps within 200mil of the BMC.

Layout Note:
Shield PERESREF from other lines on the PCB,
with a trace length of up to 10 millimeters.

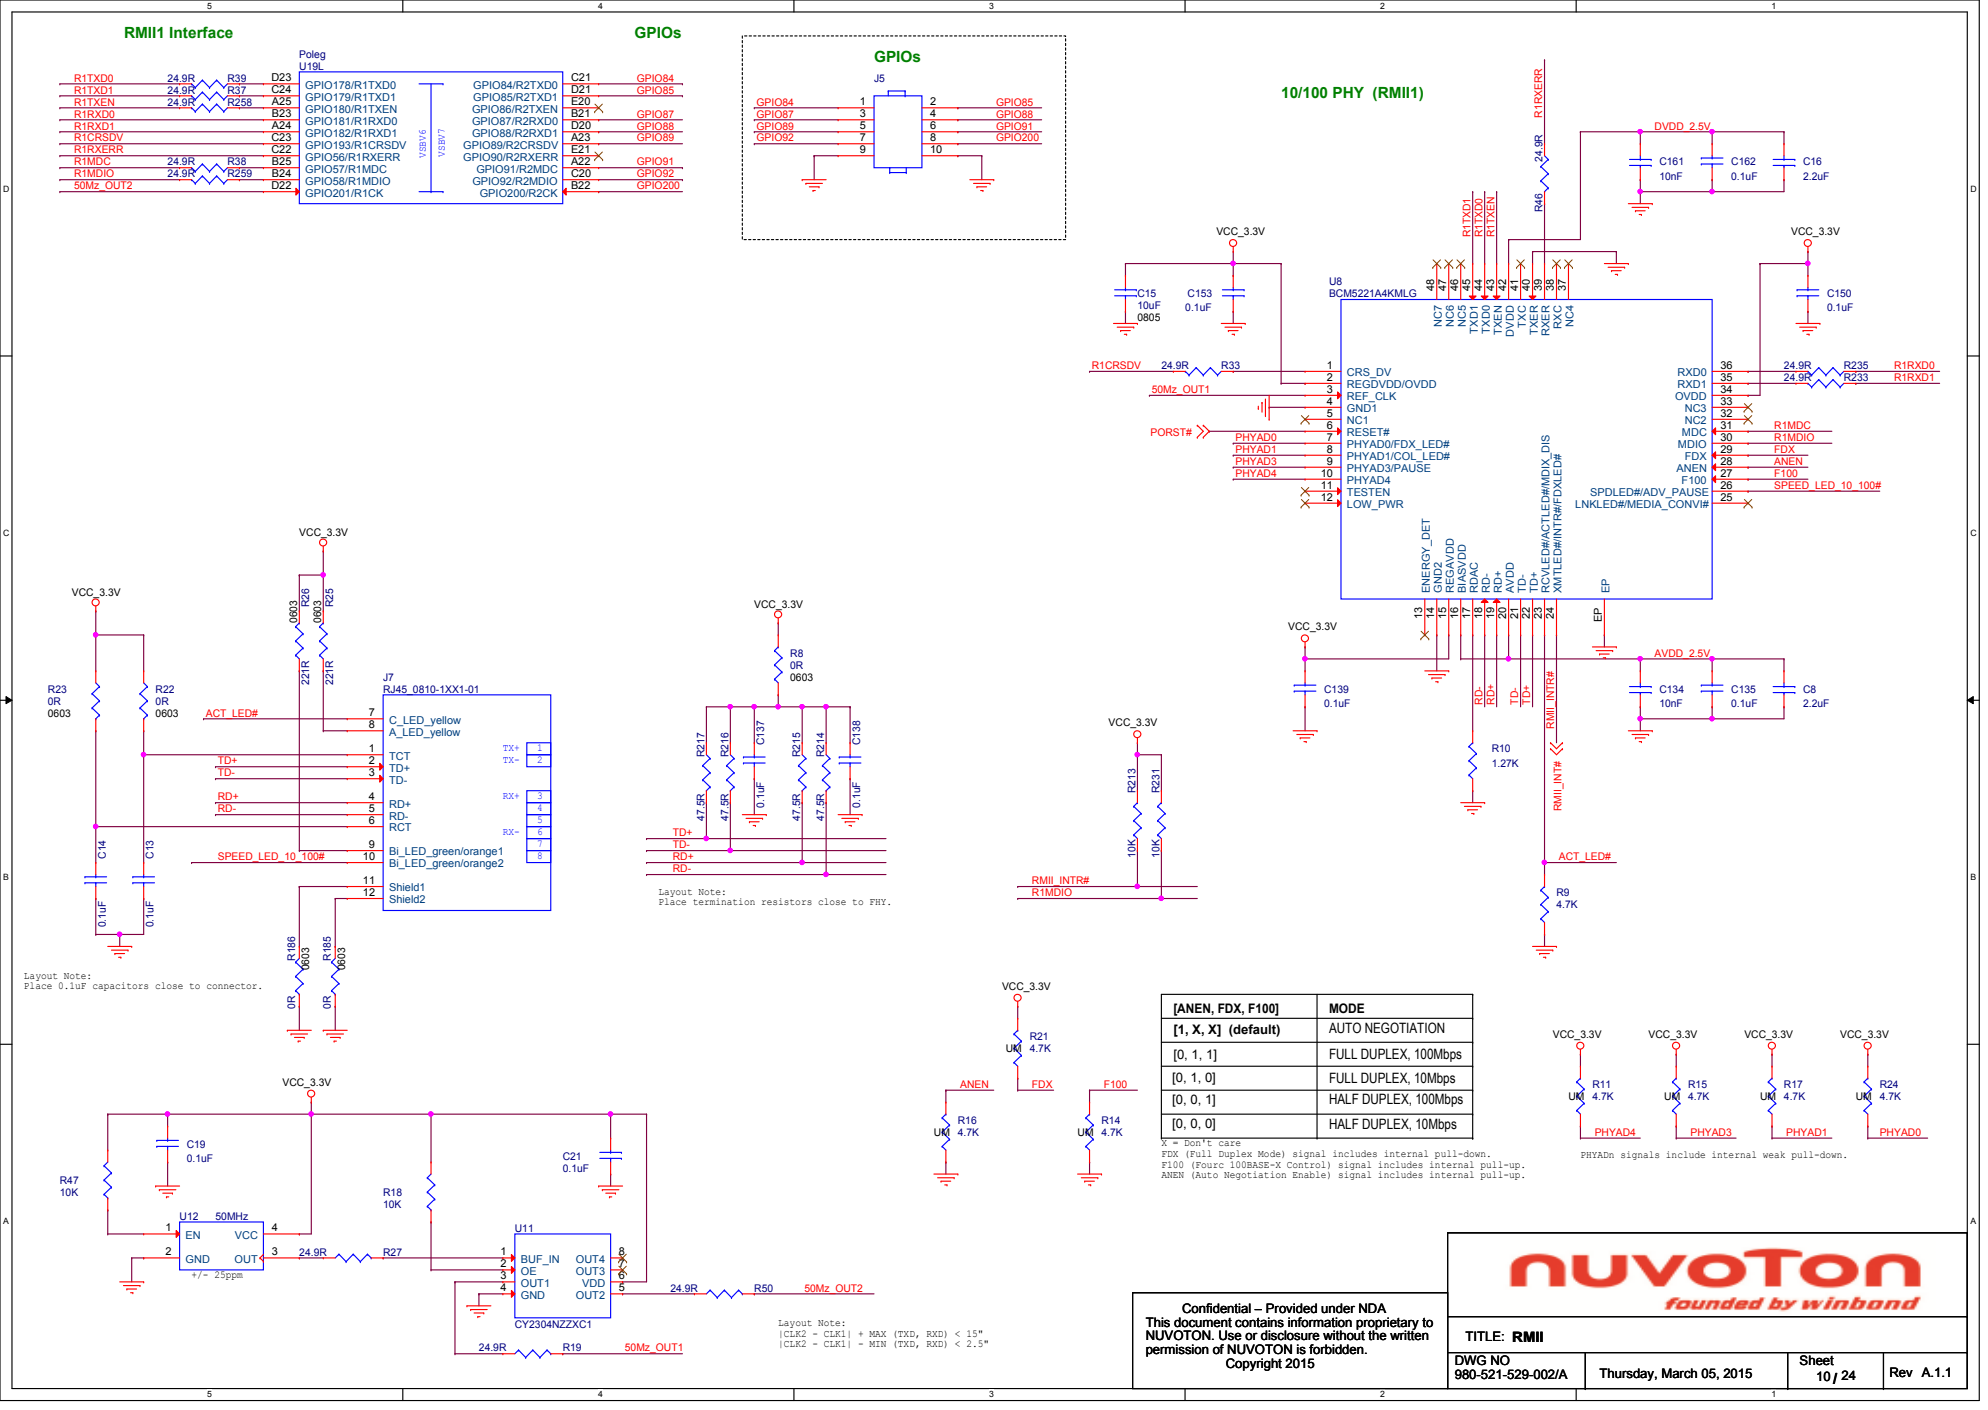
[picture p39: page 10]

Layout Note:
Place termination resistors close to FHY.

Place 0.1uF capacitors close to connector.

[ANEN, FDX, F100] | MODE
[1, X, X] (default) | AUTO NEGOTIATION

[0, 1, 1] | FULL DUPLEX, 100Mbps

[0, 1, 0] | FULL DUPLEX, 10Mbps
[0, 0, 1] | HALF DUPLEX, 100Mbps

[0, 0, 0] | HALF DUPLEX, 10Mbps

X = Don't care
FDX (Full Duplex Mode) signal includes internal pull-down.
F100 (Fourc 100BASE-X Control) signal includes internal pull-up.
ANEN (Auto Negotiation Enable) signal includes internal pull-up.

PHYADn signals include internal weak pull-down.

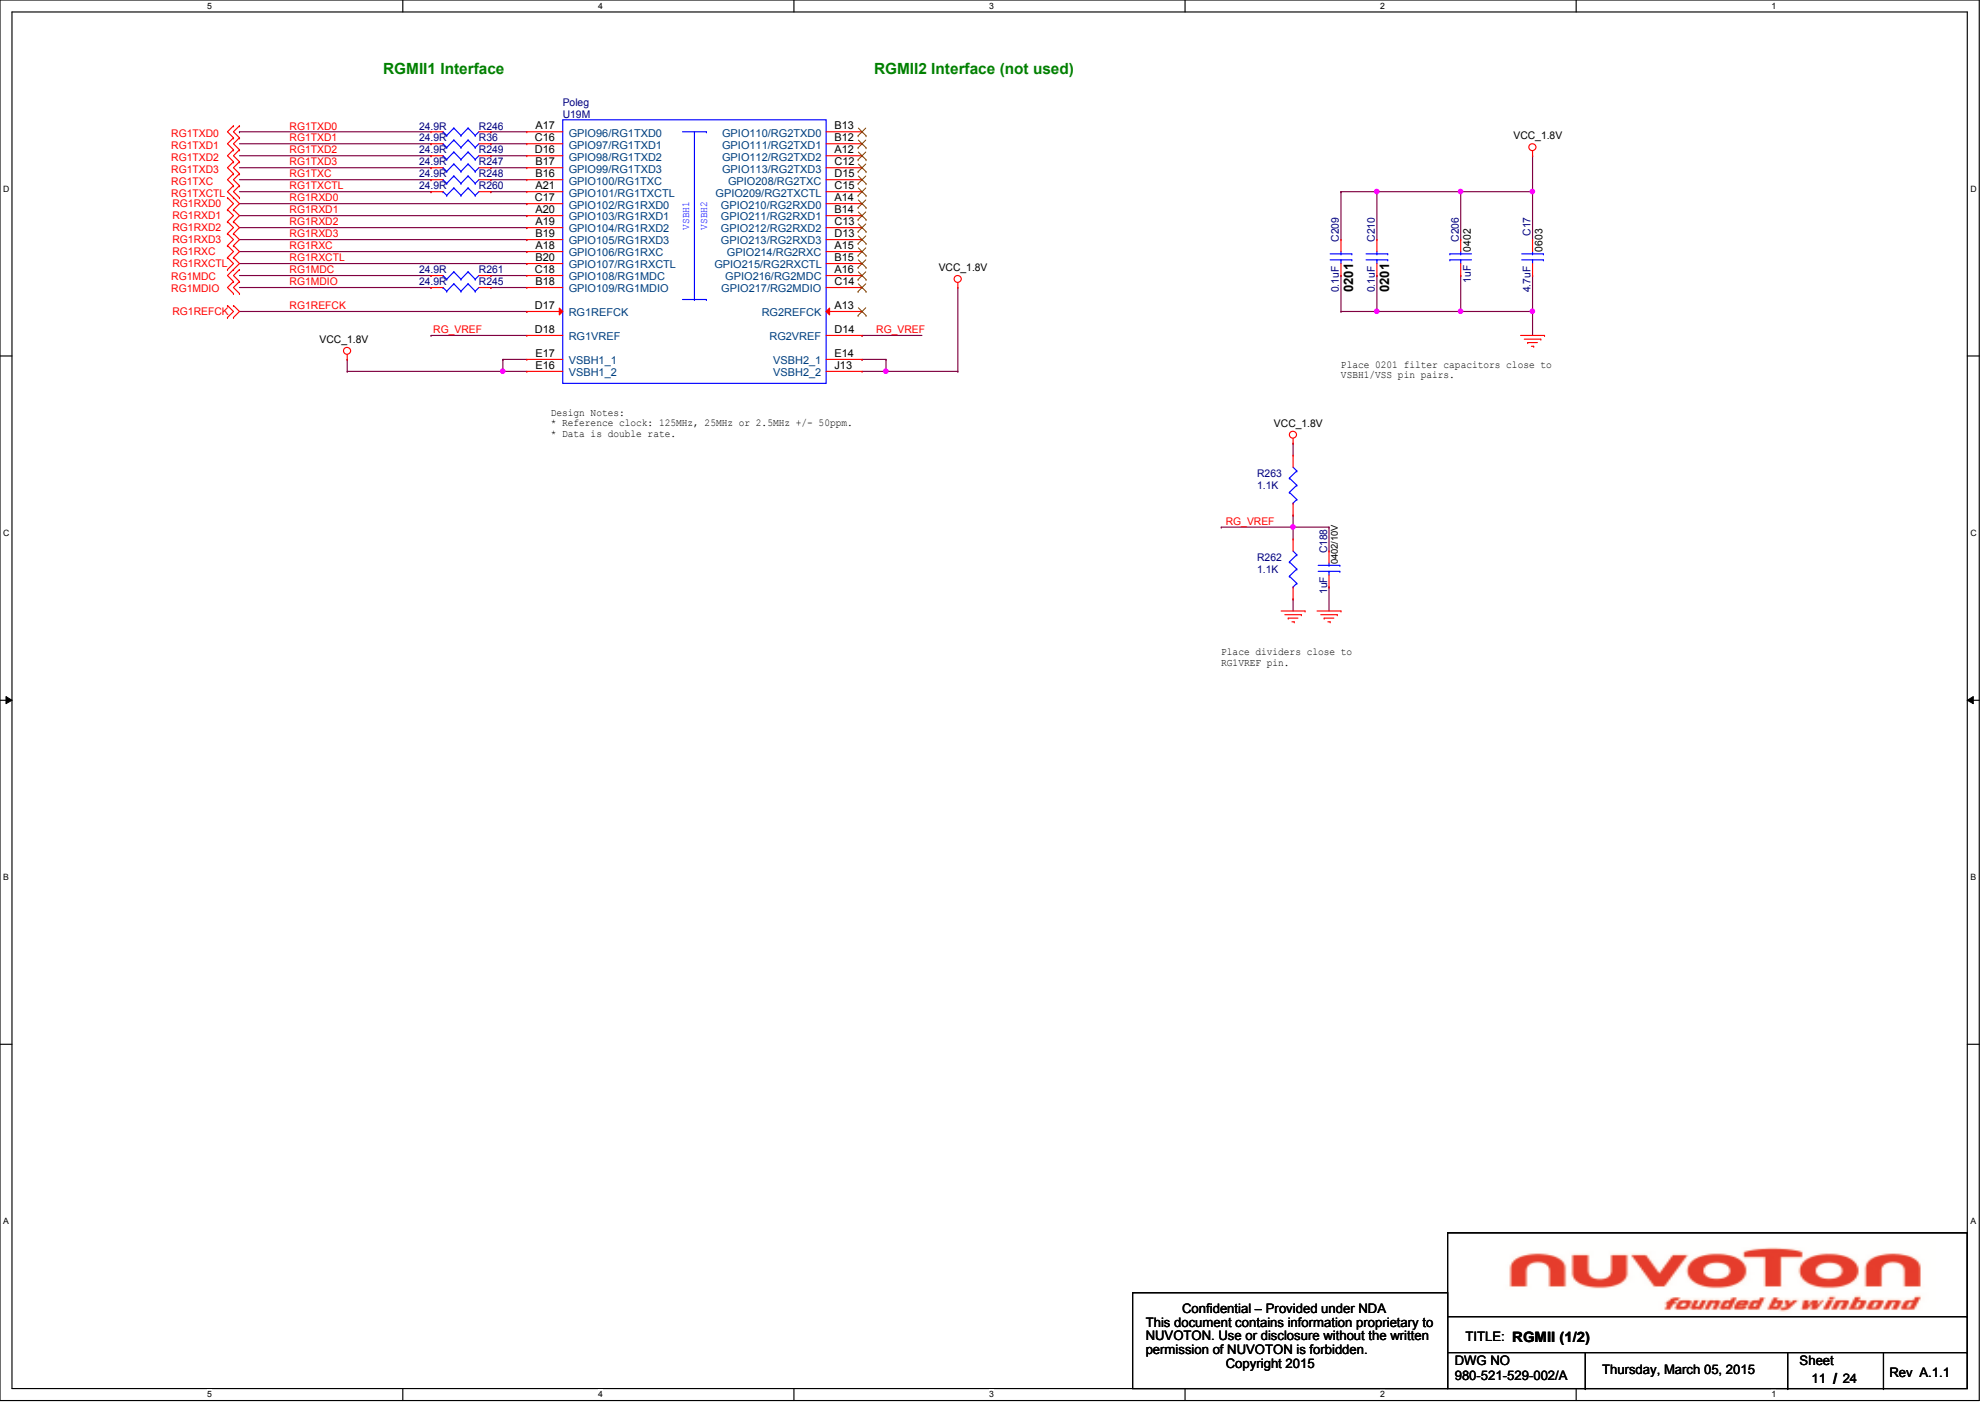
[picture p40: page 11]

Place 0201 filter capacitors close to
VSBH1/VSS pin pairs.

Design Notes:
* Reference clock: 125MHz, 25MHz or 2.5MHz +/- 50ppm.
* Data is double rate.

Place dividers close to
RG1VREF pin.

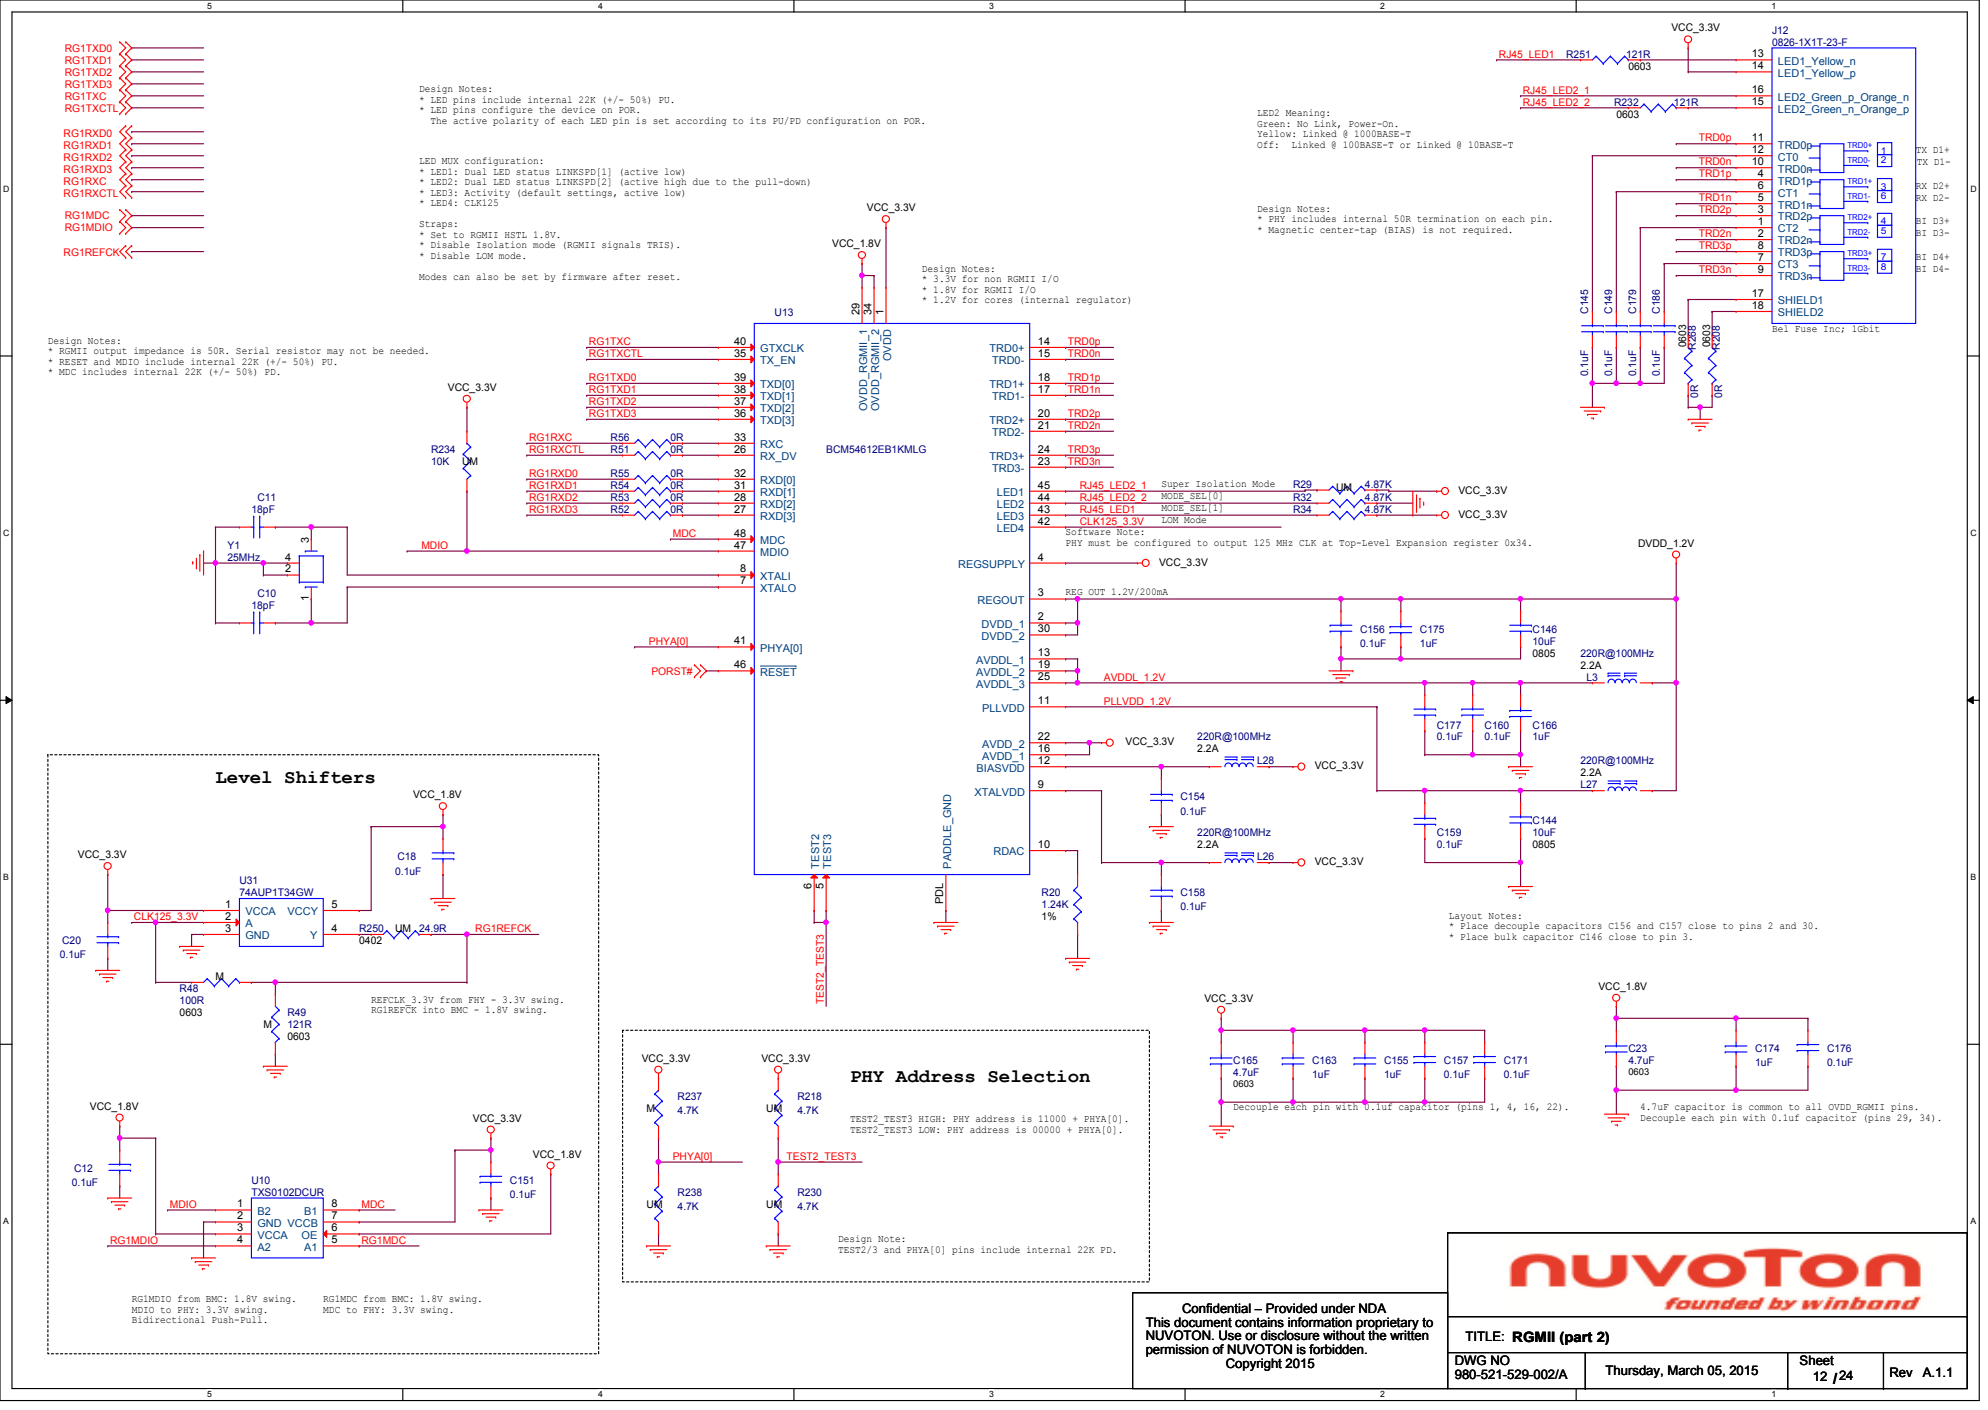
[picture p41: page 12]

Design Notes:
* LED pins include internal 22K (+/- 50%) PU.
* LED pins configure the device on POR.
The active polarity of each LED pin is set according to its PU/PD configuration on POR.

LED2 Meaning:
Green: No Link, Power-On.
Yellow: Linked @ 1000BASE-T
Off: Linked @ 100BASE-T or Linked @ 10BASE-T

LED MUX configuration:
* LED1: Dual LED status LINKSPD[1] (active low)
* LED2: Dual LED status LINKSPD[2] (active high due to the pull-down)
* LED3: Activity (default settings, active low)
* LED4: CLK125

* PHY includes internal 50R termination on each pin.
* Magnetic center-tap (BIAS) is not required.

Straps:
* Set to RGMII HSTL 1.8V.
* Disable Isolation mode (RGMII signals TRIS).
* Disable LOM mode.

Modes can also be set by firmware after reset.

* 3.3V for non RGMII I/O
* 1.8V for RGMII I/O
* 1.2V for cores (internal regulator)

* RGMII output impedance is 50R. Serial resistor may not be needed.
* RESET and MDIO include internal 22K (+/- 50%) PU.
* MDC includes internal 22K (+/- 50%) PD.

RJ45_LED2_1
RJ45_LED2_2
RJ45_LED1
CLK125_3.3V
Software Note:
PHY must be configured to output 125 MHz CLK at Top-Level Expansion register 0x34.

Layout Notes:
* Place decouple capacitors C156 and C157 close to pins 2 and 30.
* Place bulk capacitor C146 close to pin 3.

TEST2_TEST3 HIGH: PHY address is 11000 + PHYA[0].
TEST2_TEST3 LOW: PHY address is 00000 + PHYA[0].

Decouple each pin with 0.1uf capacitor (pins 29, 34).

Design Note:
TEST2/3 and PHYA[0] pins include internal 22K PD.

RG1MDIO from BMC: 1.8V swing.
MDIO to PHY: 3.3V swing.
Bidirectional Push-Pull.

RG1MDC from BMC: 1.8V swing.
MDC to FHY: 3.3V swing.

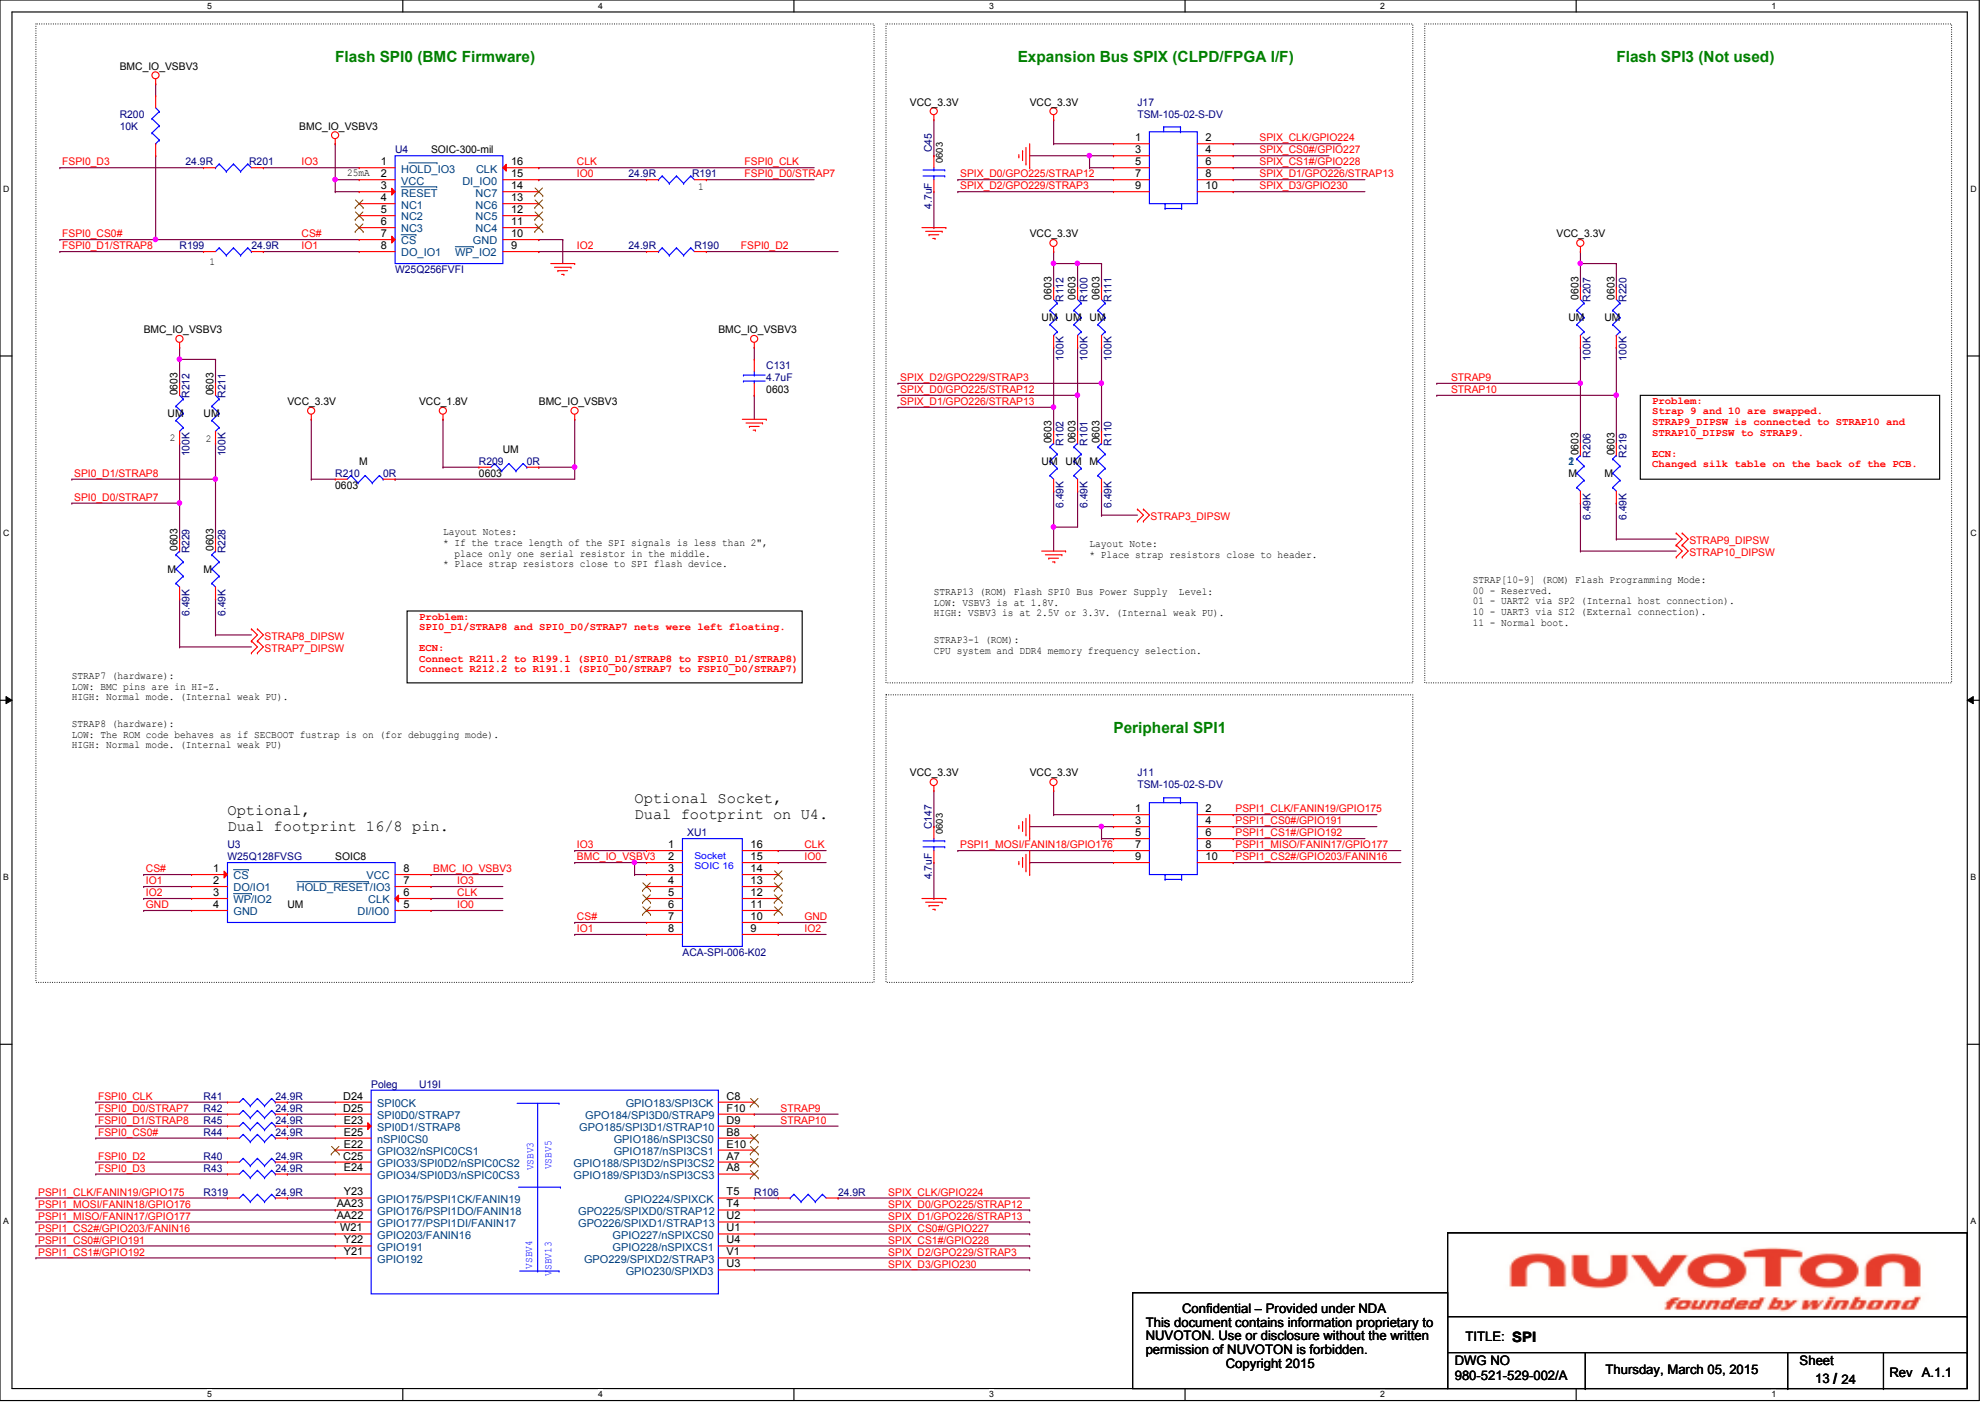
[picture p42: page 13]

Problem:
Strap 9 and 10 are swapped.
STRAP9_DIPSW is connected to STRAP10 and
STRAP10_DIPSW to STRAP9.

ECN:
Changed silk table on the back of the PCB.

Layout Notes:
* If the trace length of the SPI signals is less than 2",
place only one serial resistor in the middle.
* Place strap resistors close to SPI flash device.

Layout Note:
* Place strap resistors close to header.

STRAP[10-9] (ROM) Flash Programming Mode:
00 - Reserved.
01 - UART2 via SP2 (Internal host connection).
10 - UART3 via SI2 (External connection).
11 - Normal boot.

STRAP13 (ROM) Flash SPI0 Bus Power Supply Level:
LOW: VSBV3 is at 1.8V.
HIGH: VSBV3 is at 2.5V or 3.3V. (Internal weak PU).

SPI0_D1/STRAP8 and SPI0_D0/STRAP7 nets were left floating.

STRAP3-1 (ROM):
CPU system and DDR4 memory frequency selection.

Connect R211.2 to R199.1 (SPI0_D1/STRAP8 to FSPI0_D1/STRAP8) Connect R212.2 to R191.1 (SPI0_D0/STRAP7 to FSPI0_D0/STRAP7)

STRAP7 (hardware):
LOW: BMC pins are in HI-Z.
HIGH: Normal mode. (Internal weak PU).

STRAP8 (hardware):
LOW: The ROM code behaves as if SECBOOT fustrap is on (for debugging mode).
HIGH: Normal mode. (Internal weak PU)

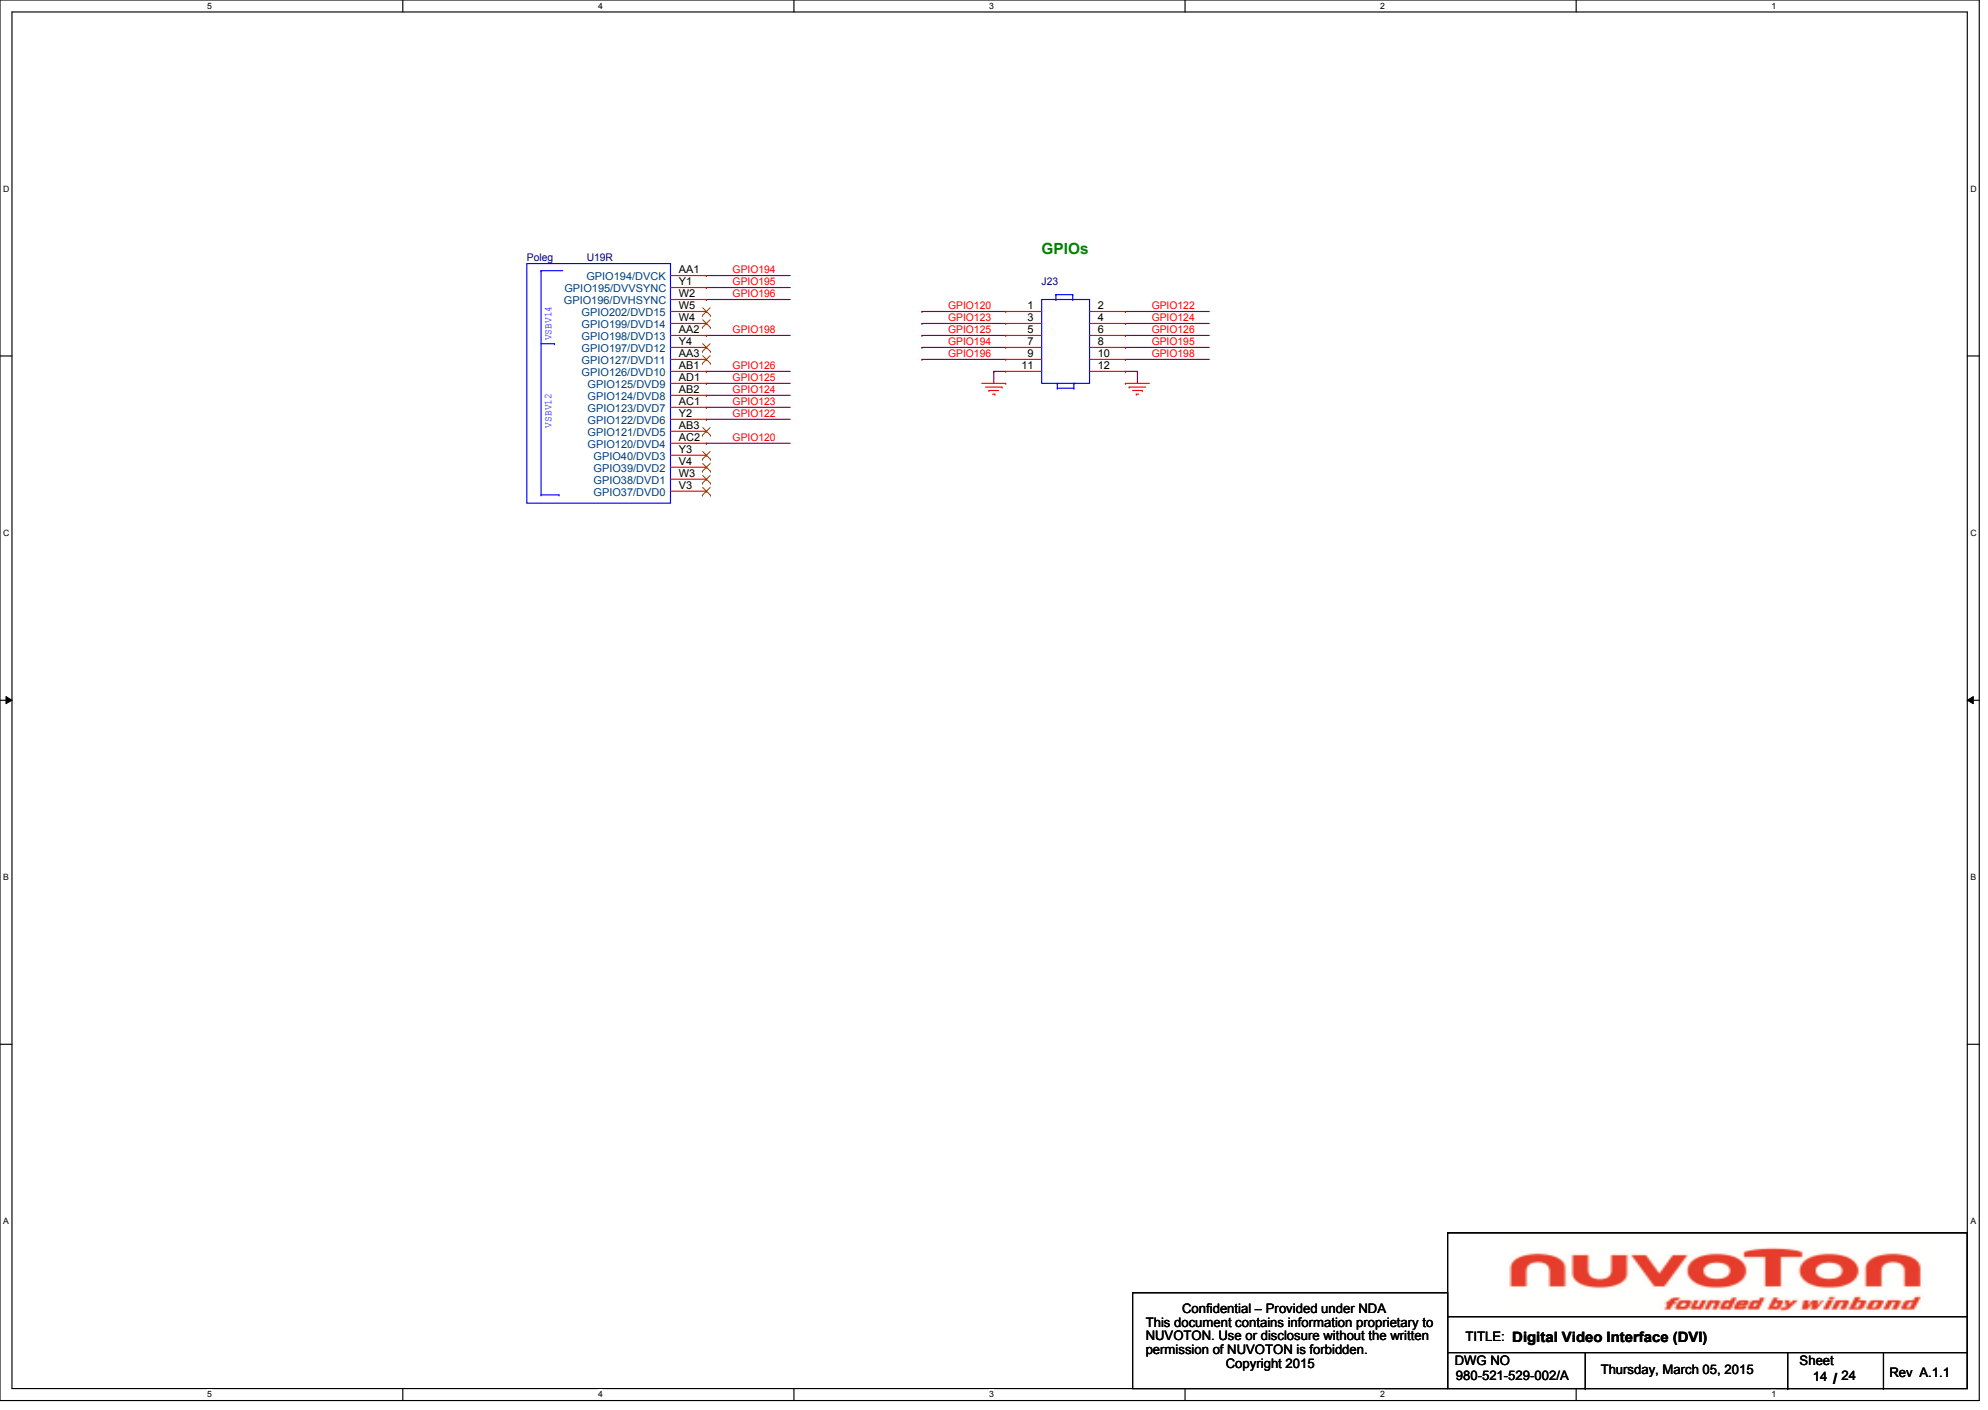
[picture p43: page 14]
GPIOs; GPIO194 GPIO195 GPIO196; GPIO198; GPIO126 GPIO125; GPIO123; GPIO120; GPIO124; GPIO122; GPIO125; GPIO126; GPIO194; GPIO195; GPIO196; Thursday, March 05, 2015; 14 24 DWG NO; Rev Sheet; VSBV12 VSBV14; Poleg; GPIO194/DVCK; GPIO195/DVVSYNC; GPIO196/DVHSYNC; GPIO37/DVD0; V3 GPIO38/DVD1; W3 GPIO39/DVD2; V4 GPIO40/DVD3; Y3 GPIO120/DVD4; AC2 GPIO121/DVD5; AB3 GPIO122/DVD6; Y2 GPIO123/DVD7; AC1 GPIO124/DVD8; AB2 GPIO125/DVD9; AD1 GPIO126/DVD10; AB1 GPIO127/DVD11; AA3 GPIO197/DVD12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

Digital Video Interface (DVI)

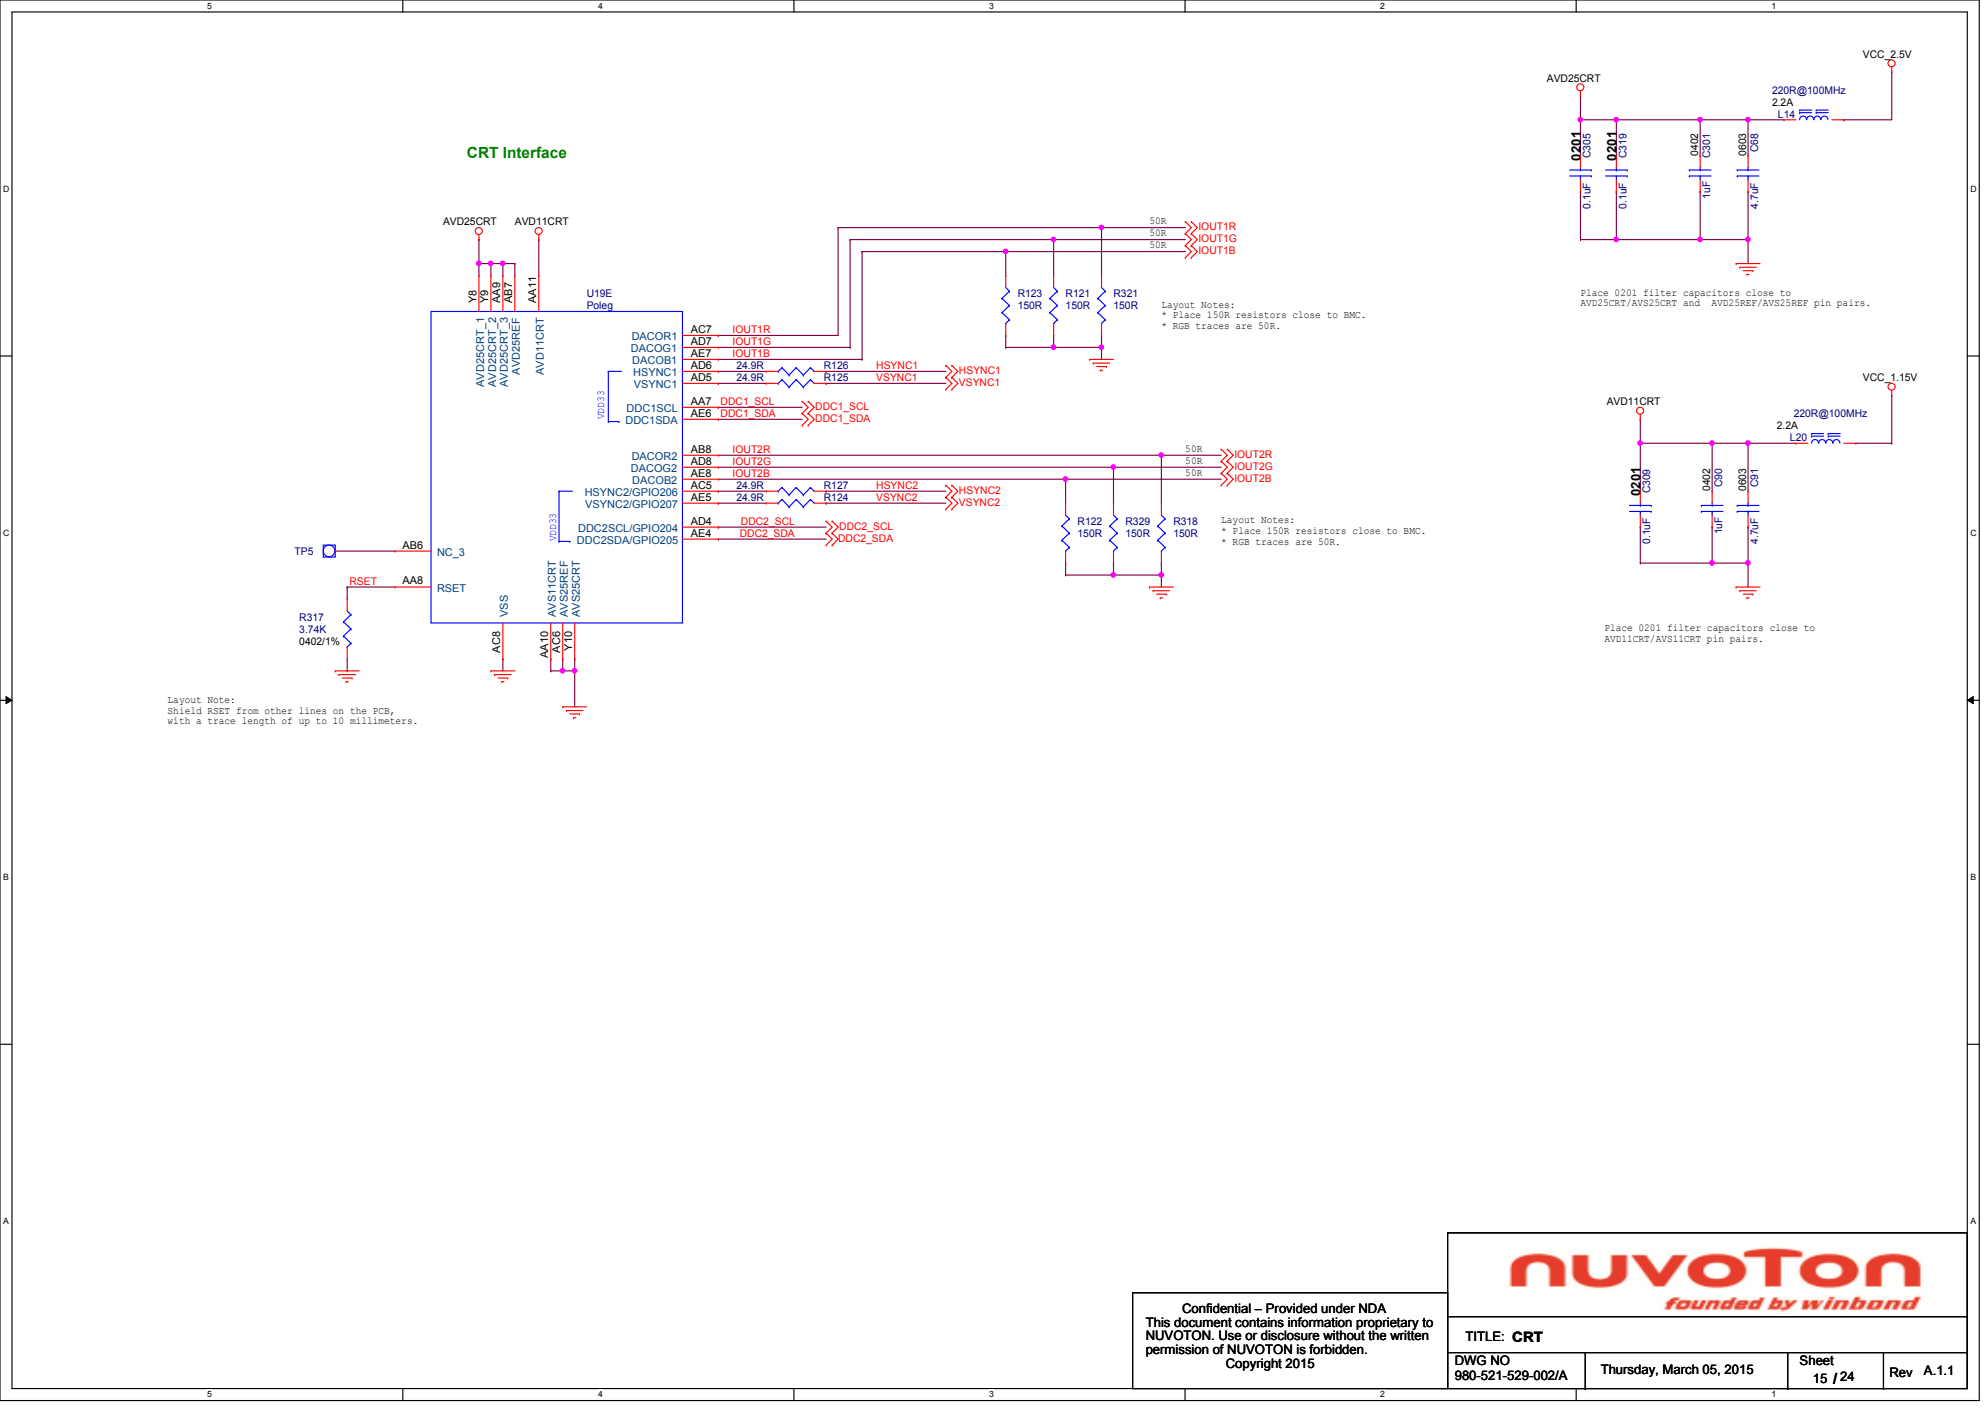
[picture p44: page 15]

Place 0201 filter capacitors close to
AVD25CRT/AVS25CRT and AVD25REF/AVS25REF pin pairs.

Layout Notes:
* Place 150R resistors close to BMC.
* RGB traces are 50R.

AVD11CRT/AVS11CRT pin pairs.

Layout Note:
Shield RSET from other lines on the PCB,
with a trace length of up to 10 millimeters.

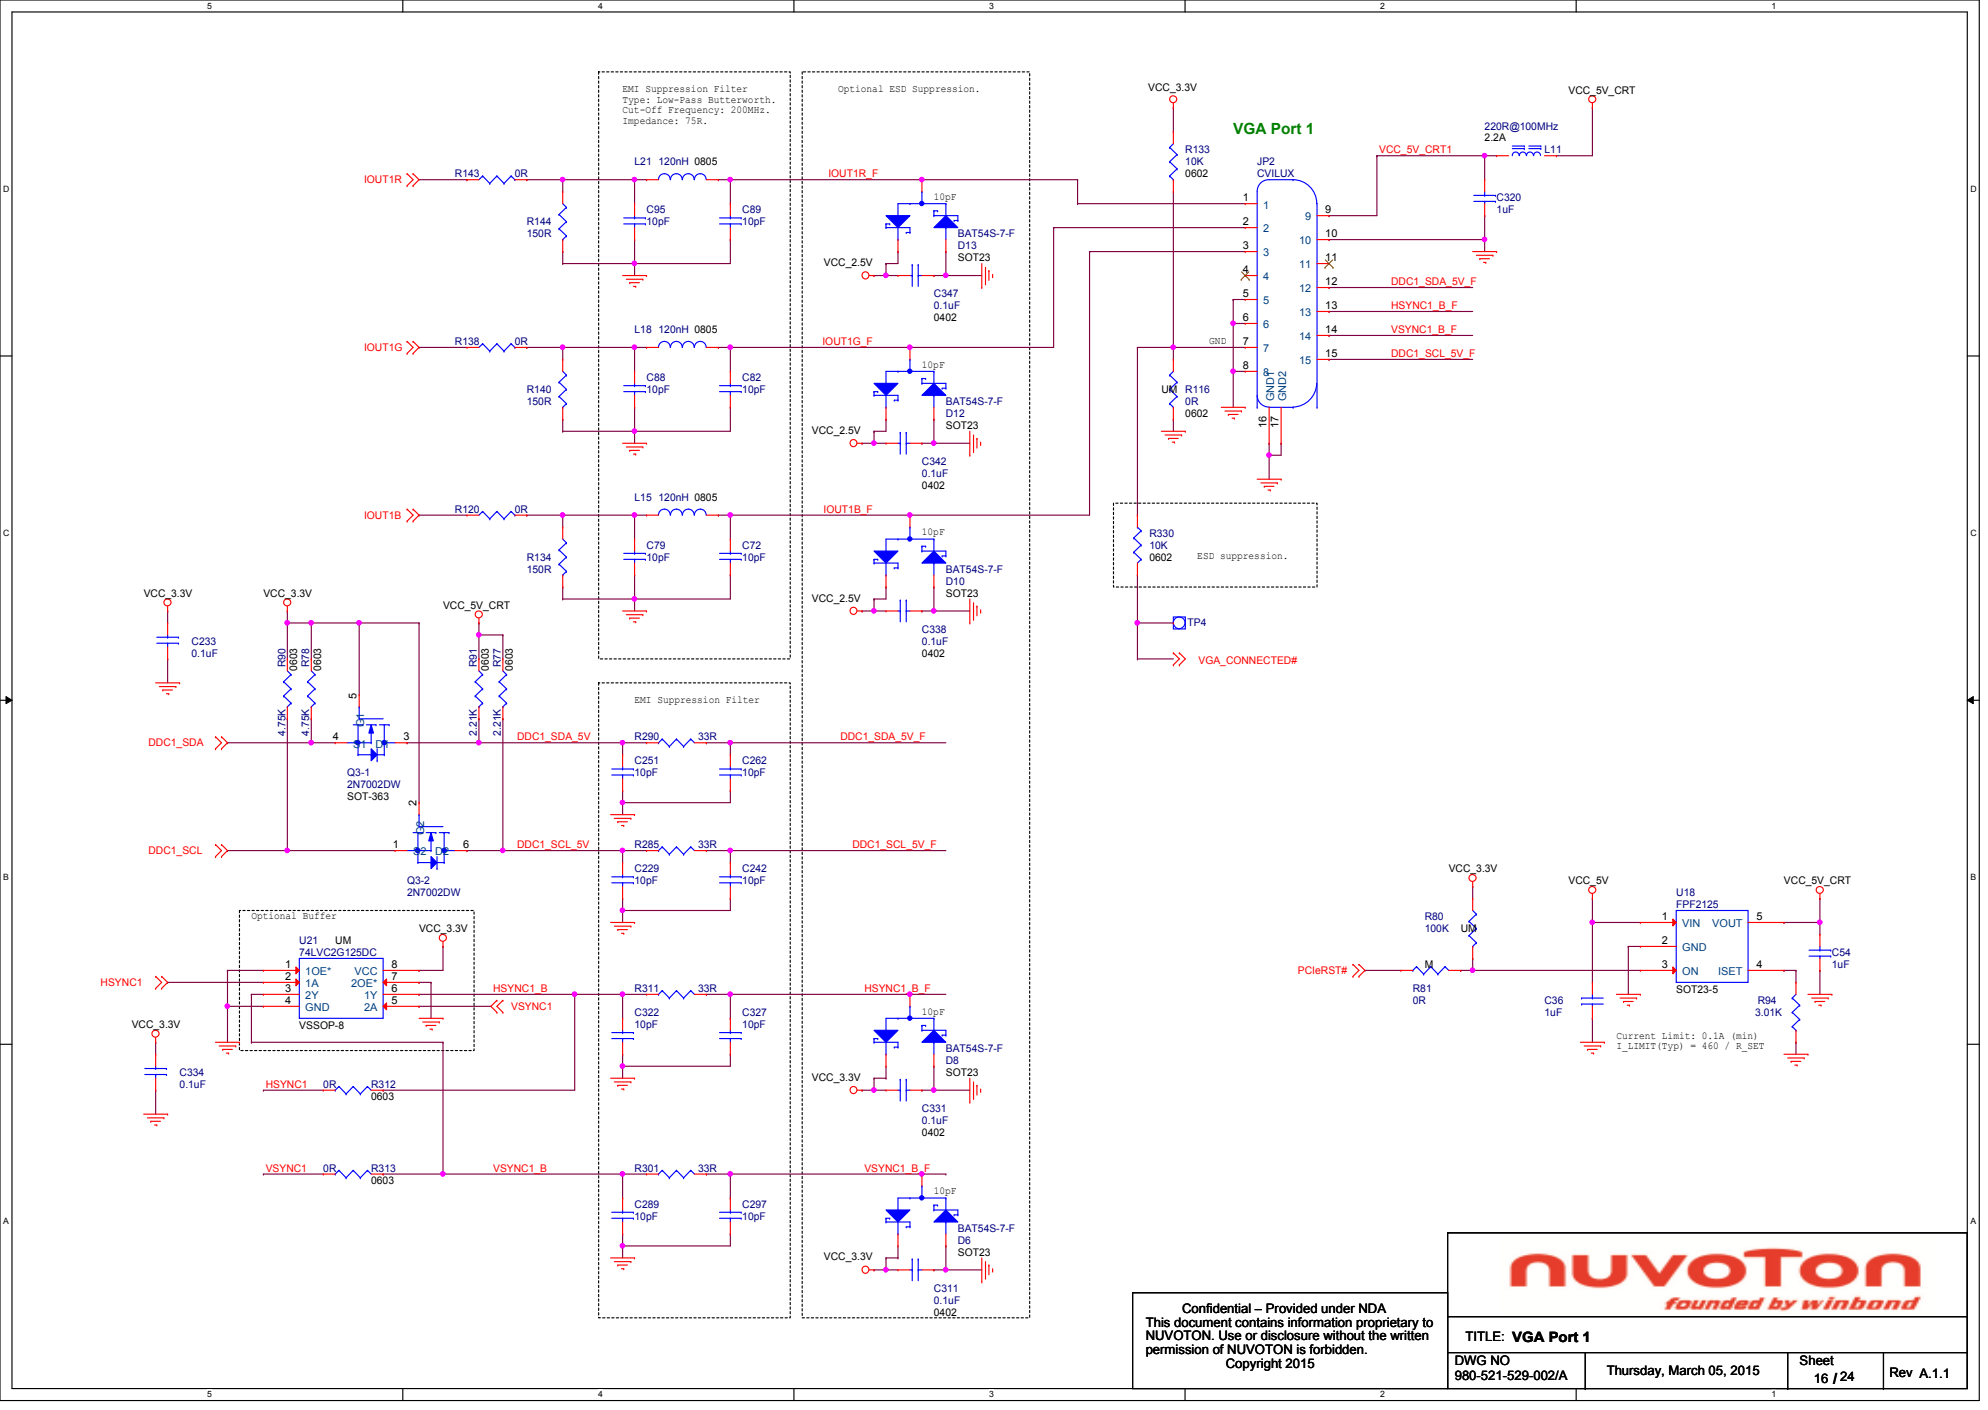
[picture p45: page 16]

EMI Suppression Filter
Type: Low-Pass Butterworth.
Cut-Off Frequency: 200MHz.
Impedance: 75R.

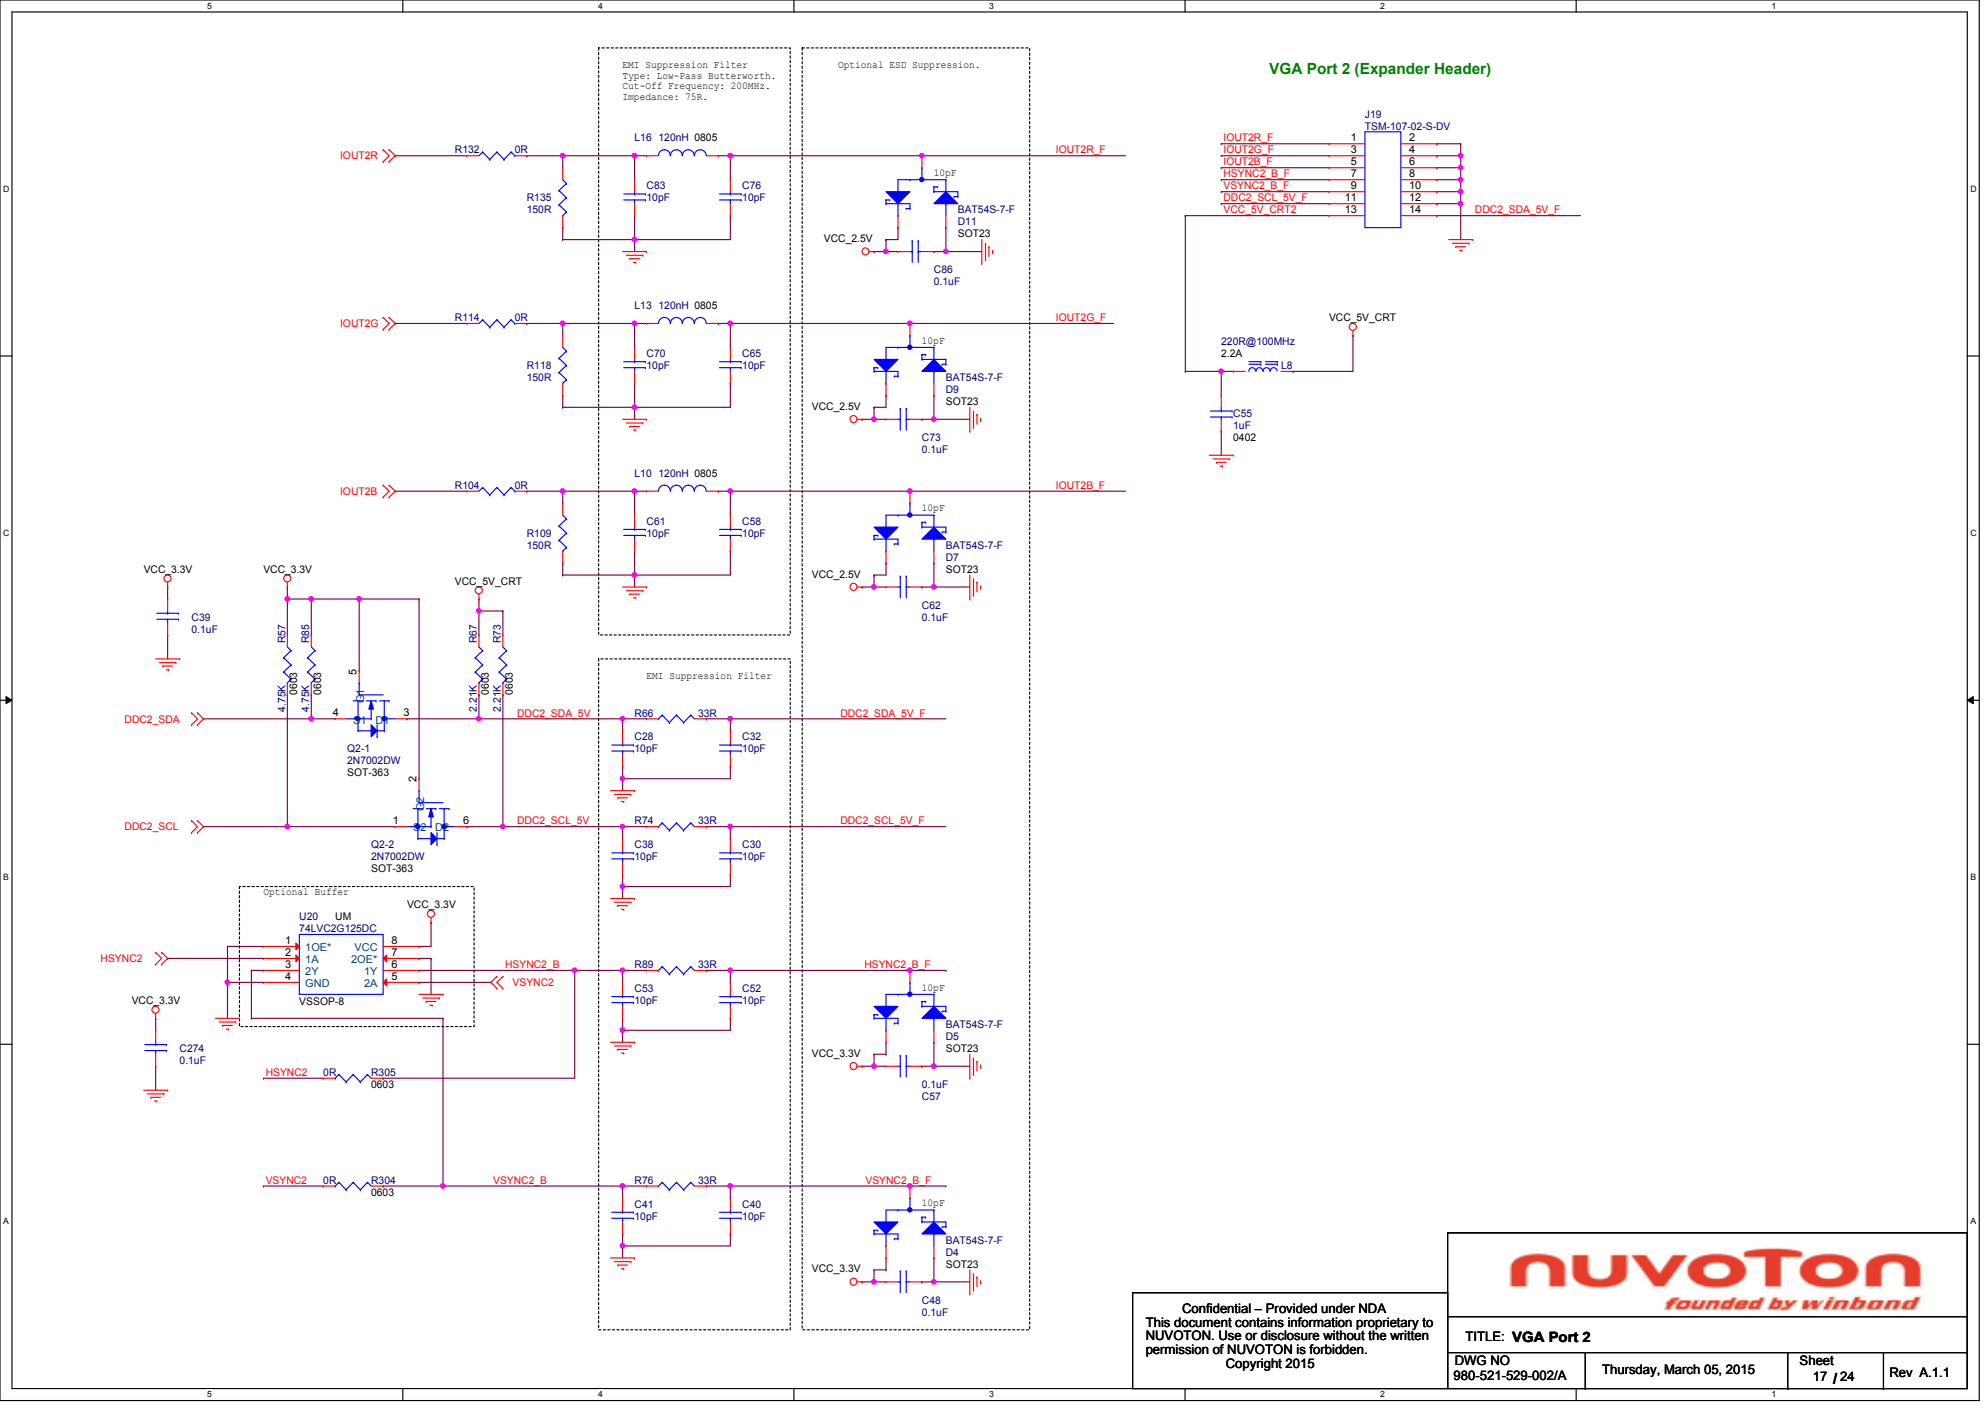
[picture p46: page 17]

EMI Suppression Filter
Type: Low-Pass Butterworth.
Cut-Off Frequency: 200MHz.
Impedance: 75R.

VGA Port 2 (Expander Header)

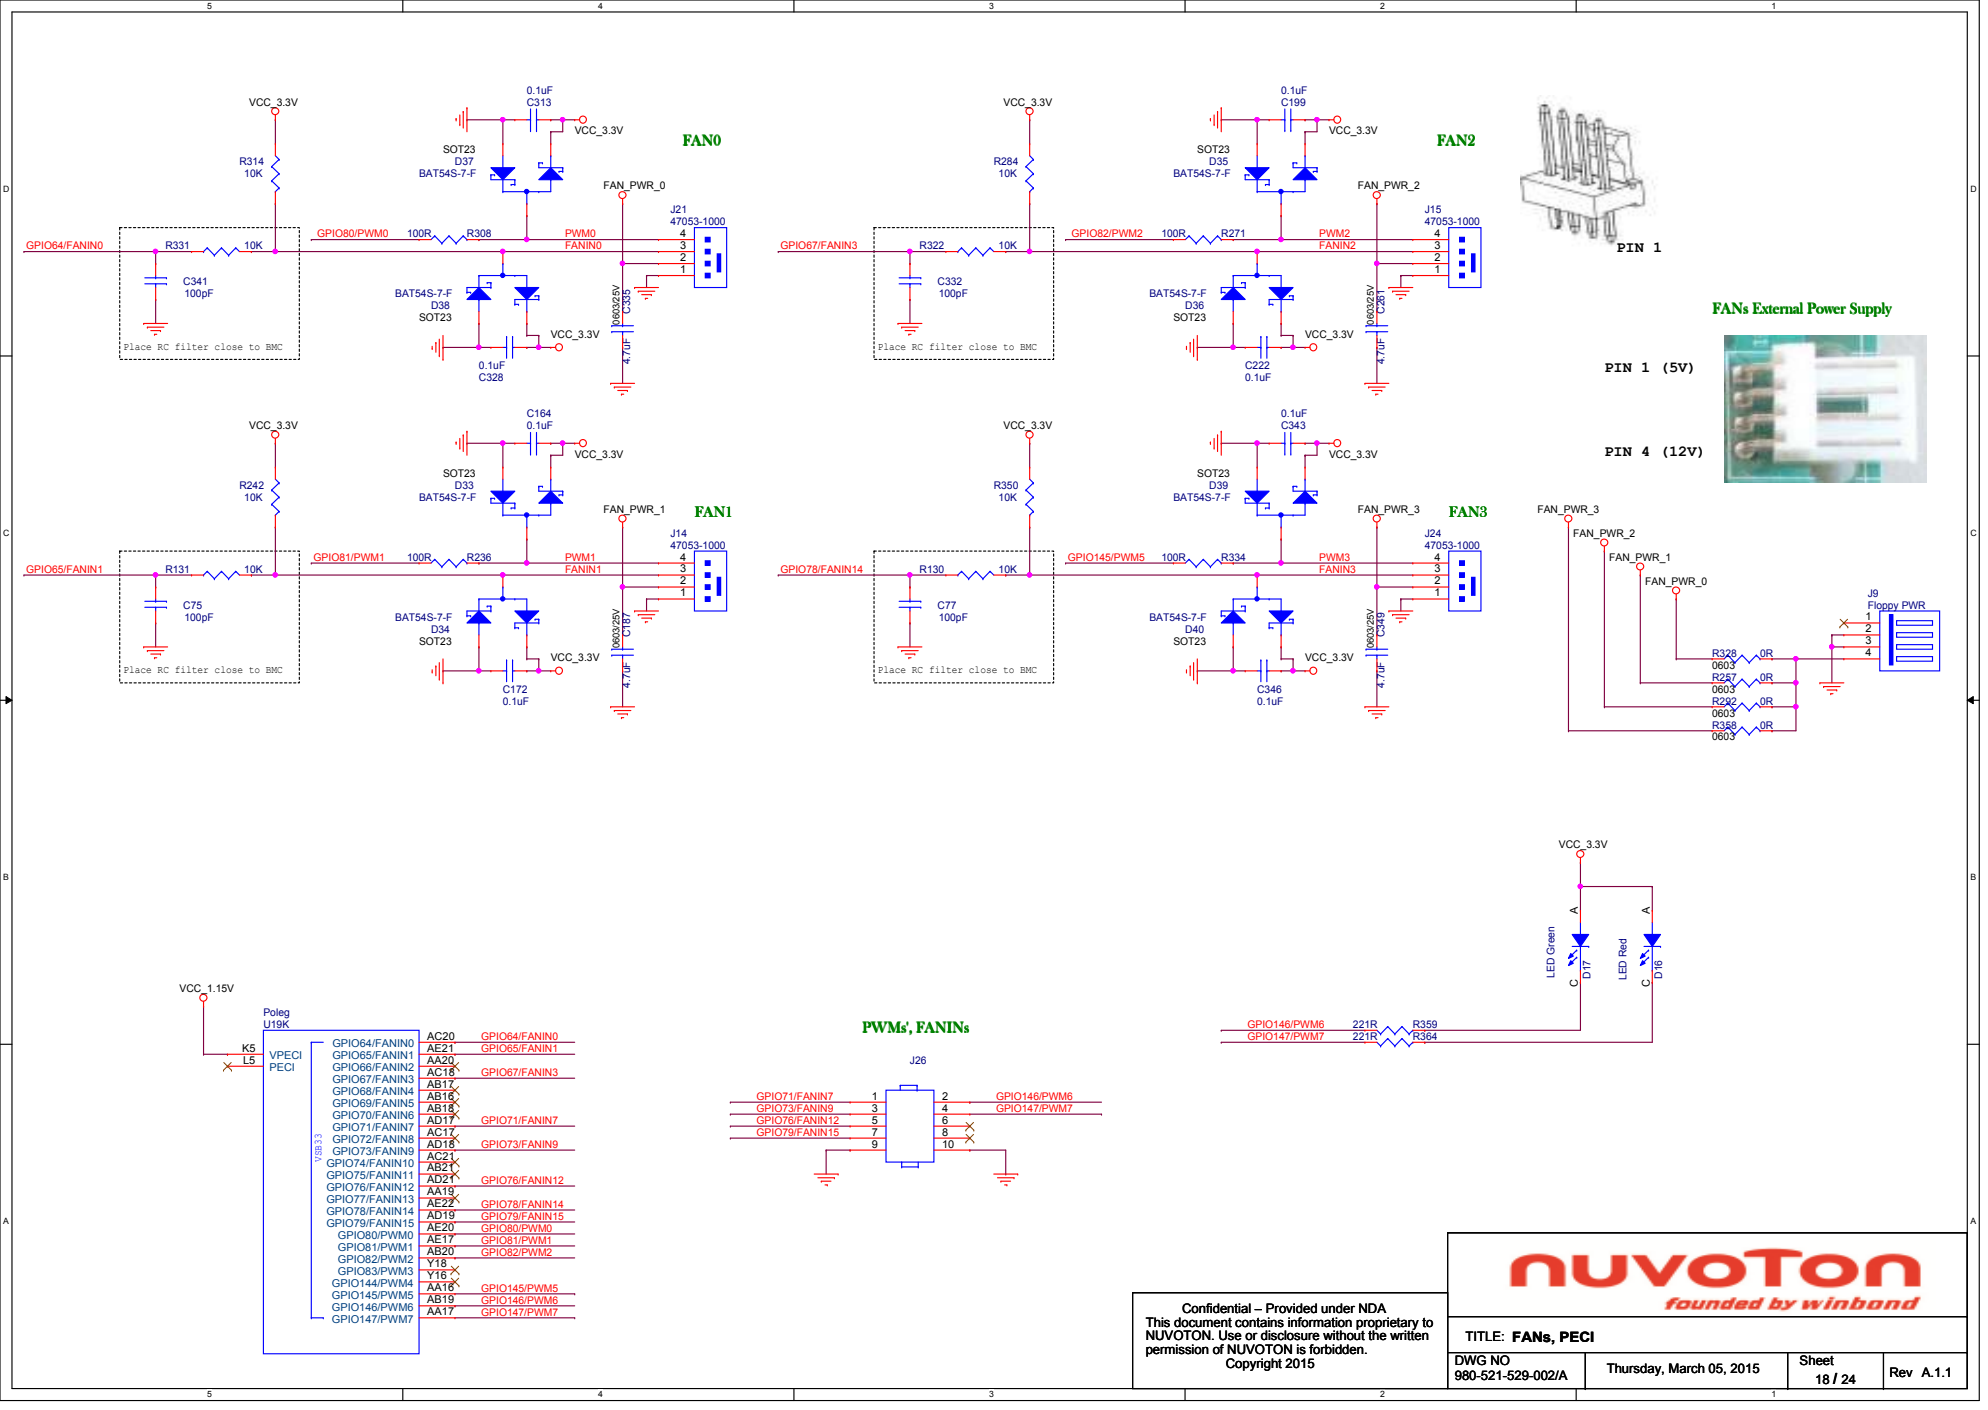
[picture p47: page 18]

FANs External Power Supply

Place RC filter close to BMC

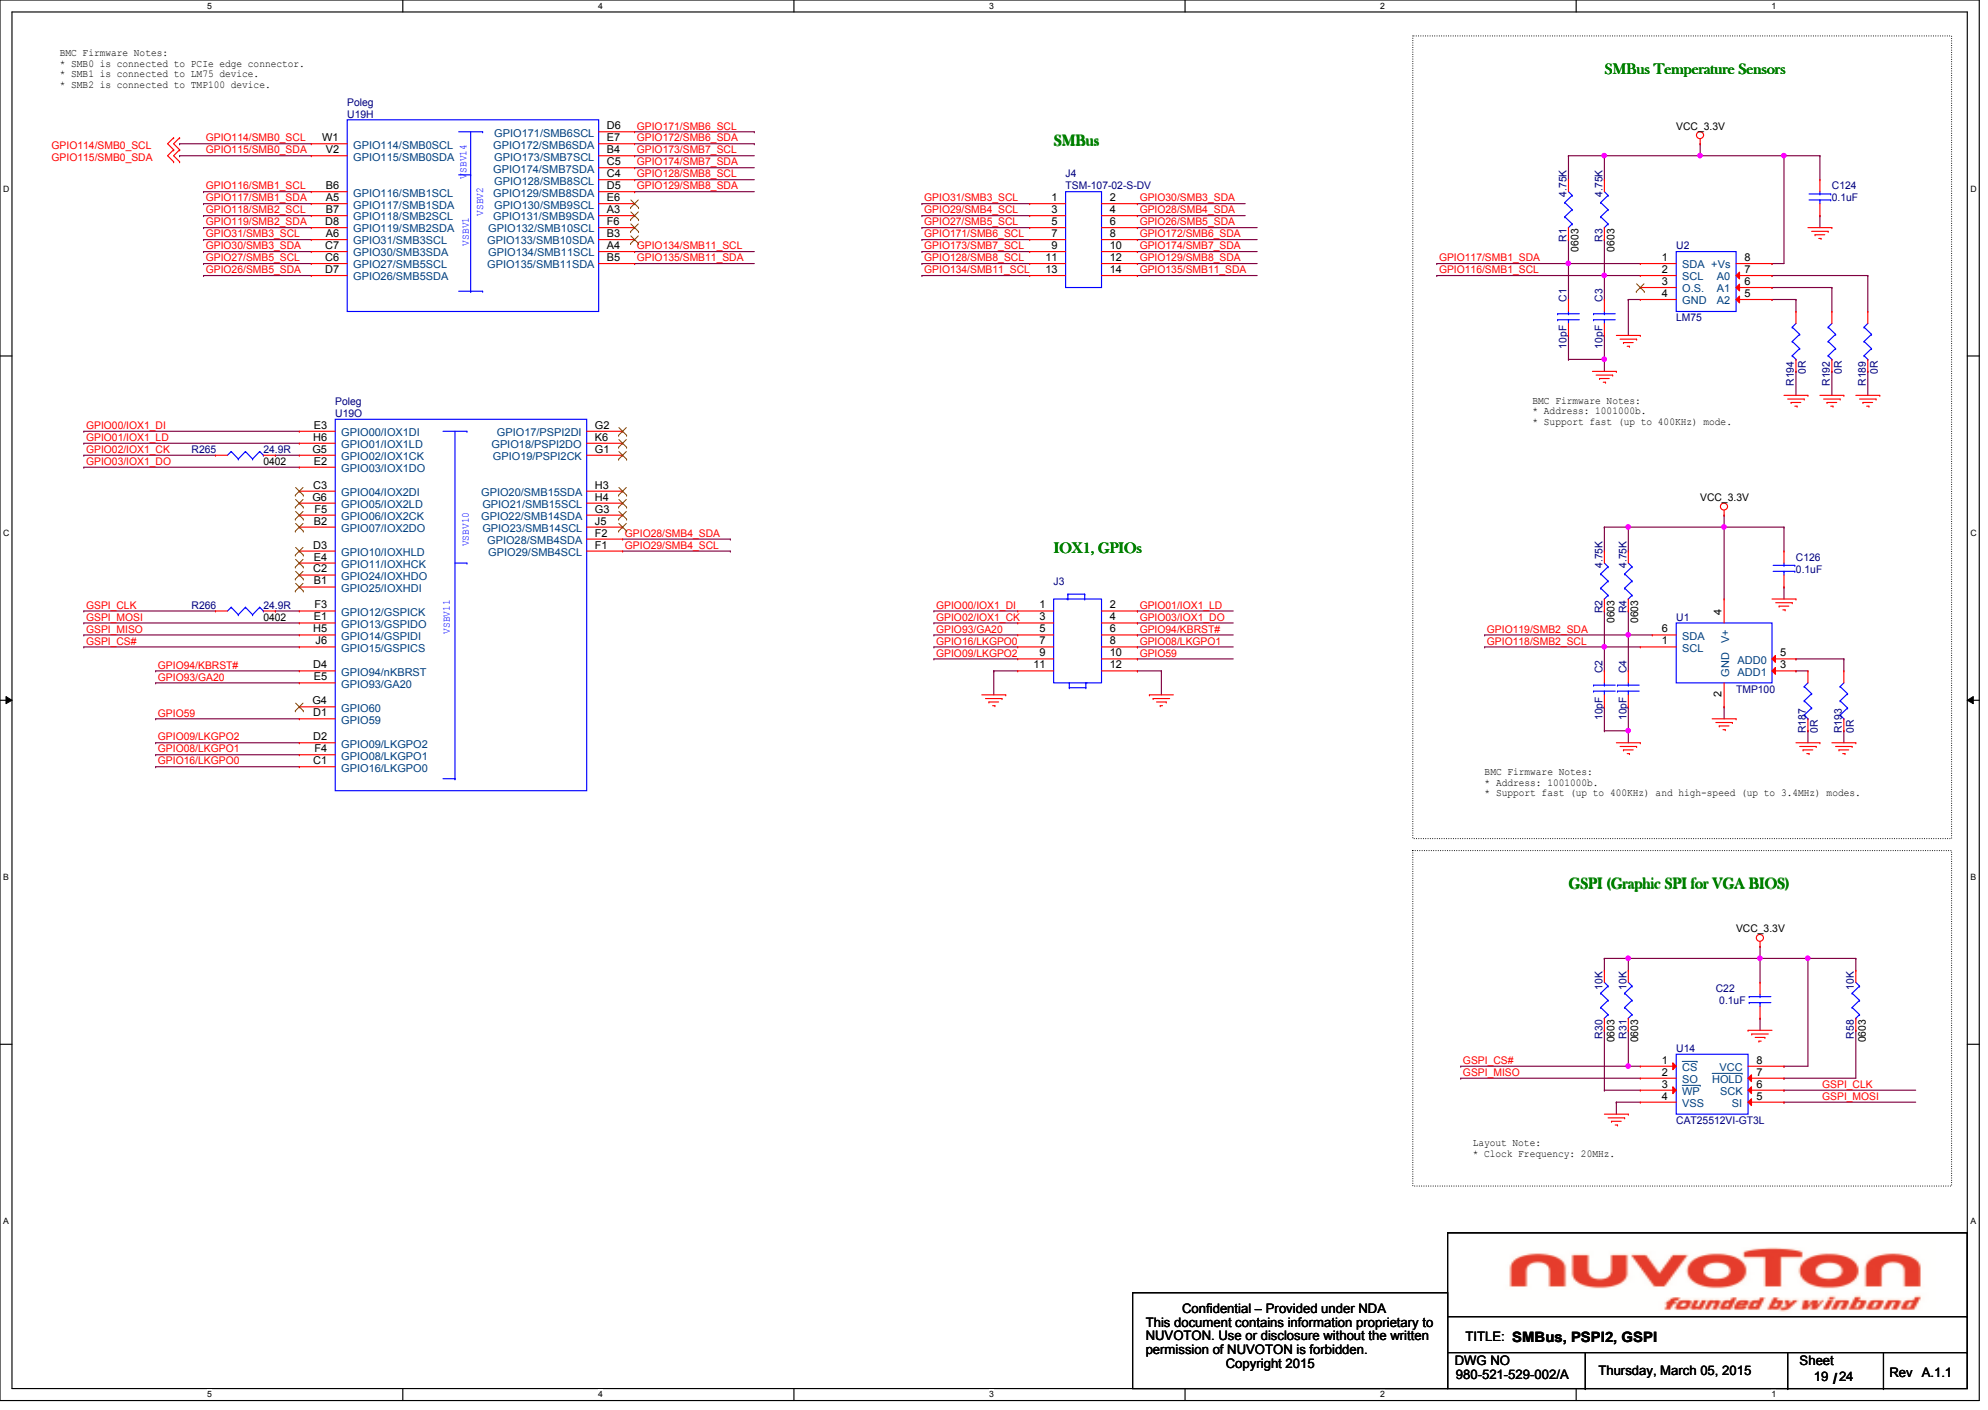
[picture p48: page 19]

BMC Firmware Notes:
* SMB0 is connected to PCIe edge connector.
* SMB1 is connected to LM75 device.
* SMB2 is connected to TMP100 device.

* Address: 1001000b.
* Support fast (up to 400KHz) mode.

* Support fast (up to 400KHz) and high-speed (up to 3.4MHz) modes.

GSPI (Graphic SPI for VGA BIOS)

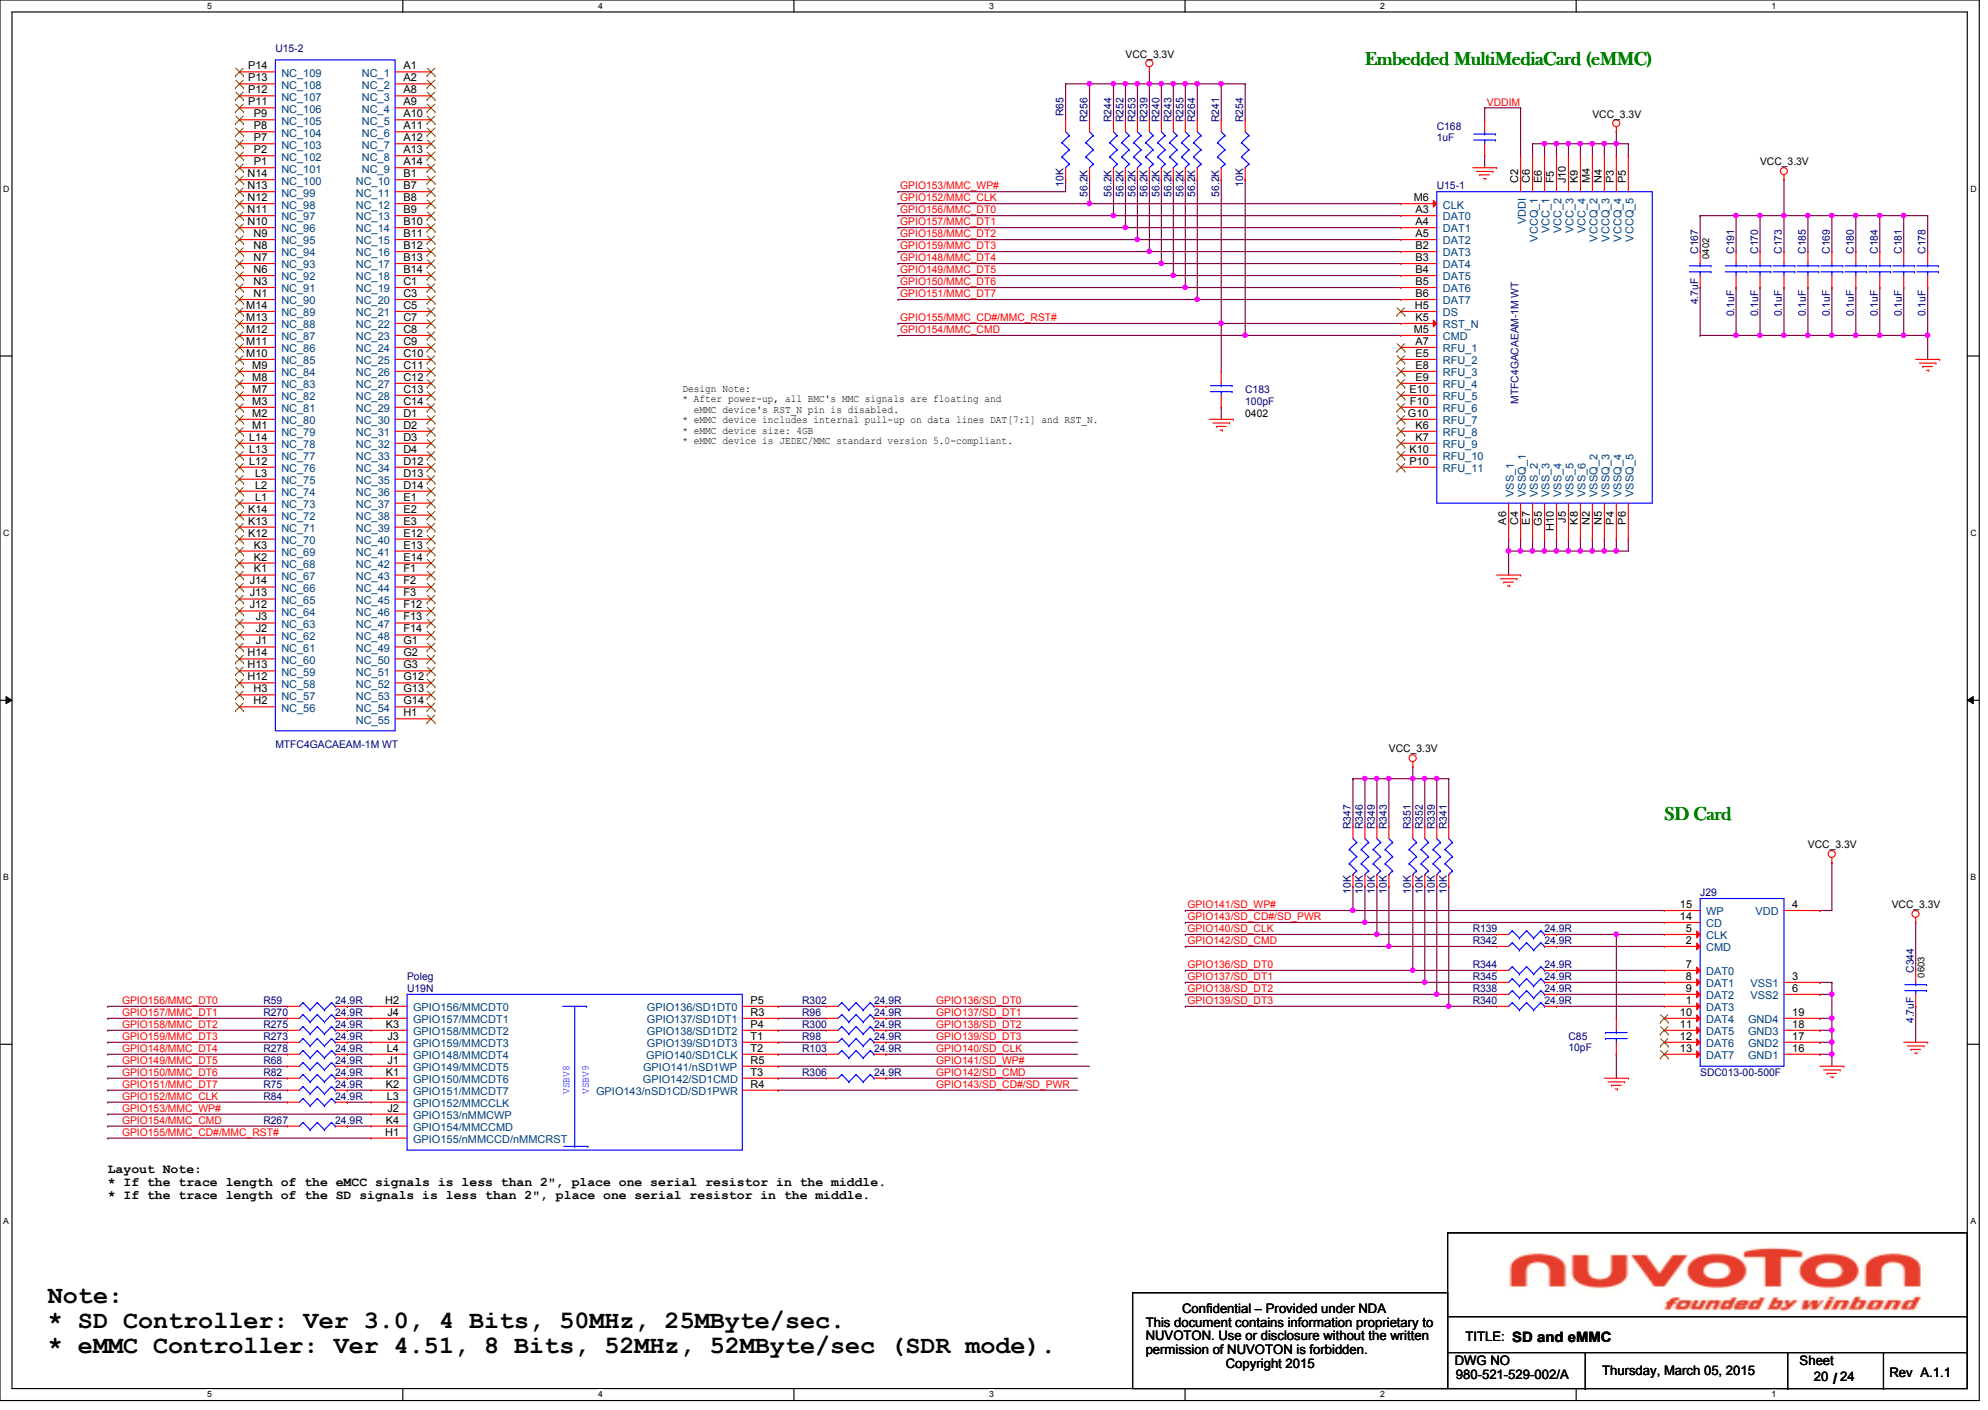
[picture p49: page 20]

Design Note:
* After power-up, all BMC's MMC signals are floating and
eMMC device's RST_N pin is disabled.
* eMMC device includes internal pull-up on data lines DAT[7:1] and RST_N.
* eMMC device size: 4GB
* eMMC device is JEDEC/MMC standard version 5.0-compliant.

Layout Note:
* If the trace length of the eMCC signals is less than 2", place one serial resistor in the middle.
* If the trace length of the SD signals is less than 2", place one serial resistor in the middle.

Note:
* SD Controller: Ver 3.0, 4 Bits, 50MHz, 25MByte/sec.
* eMMC Controller: Ver 4.51, 8 Bits, 52MHz, 52MByte/sec (SDR mode).

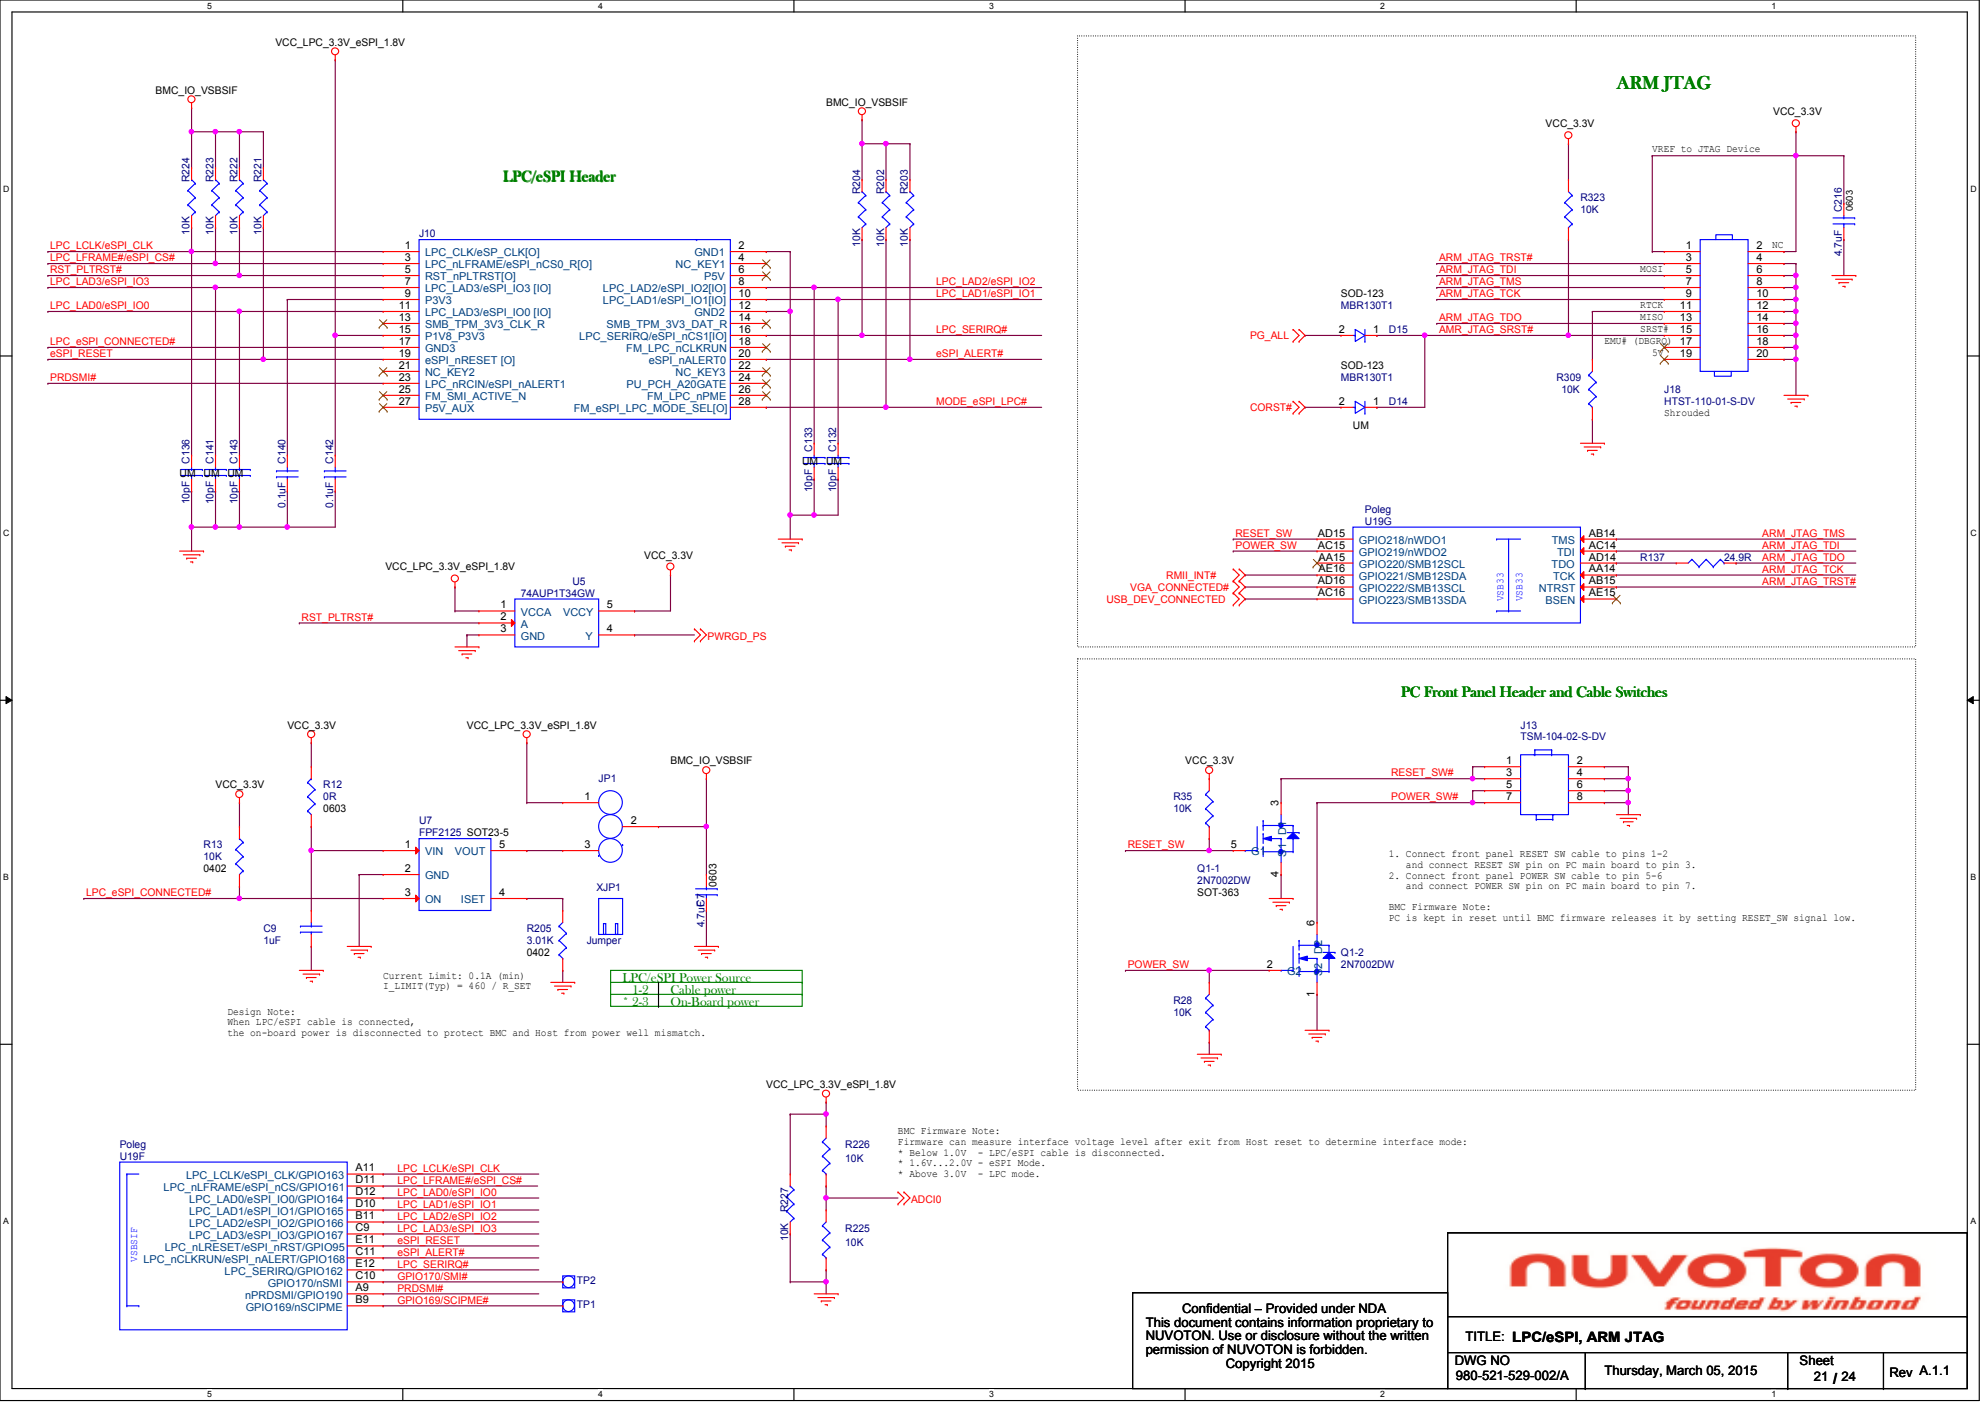
[picture p50: page 21]

VREF to JTAG Device

PC Front Panel Header and Cable Switches

1. Connect front panel RESET SW cable to pins 1-2
and connect RESET SW pin on PC main board to pin 3.
2. Connect front panel POWER SW cable to pin 5-6
and connect POWER SW pin on PC main board to pin 7.

BMC Firmware Note:
PC is kept in reset until BMC firmware releases it by setting RESET_SW signal low.

On-Board power Design Note:

When LPC/eSPI cable is connected,
the on-board power is disconnected to protect BMC and Host from power well mismatch.

Firmware can measure interface voltage level after exit from Host reset to determine interface mode:
* Below 1.0V - LPC/eSPI cable is disconnected.
* 1.6V...2.0V - eSPI Mode.
* Above 3.0V - LPC mode.

LPC/eSPI, ARM JTAG

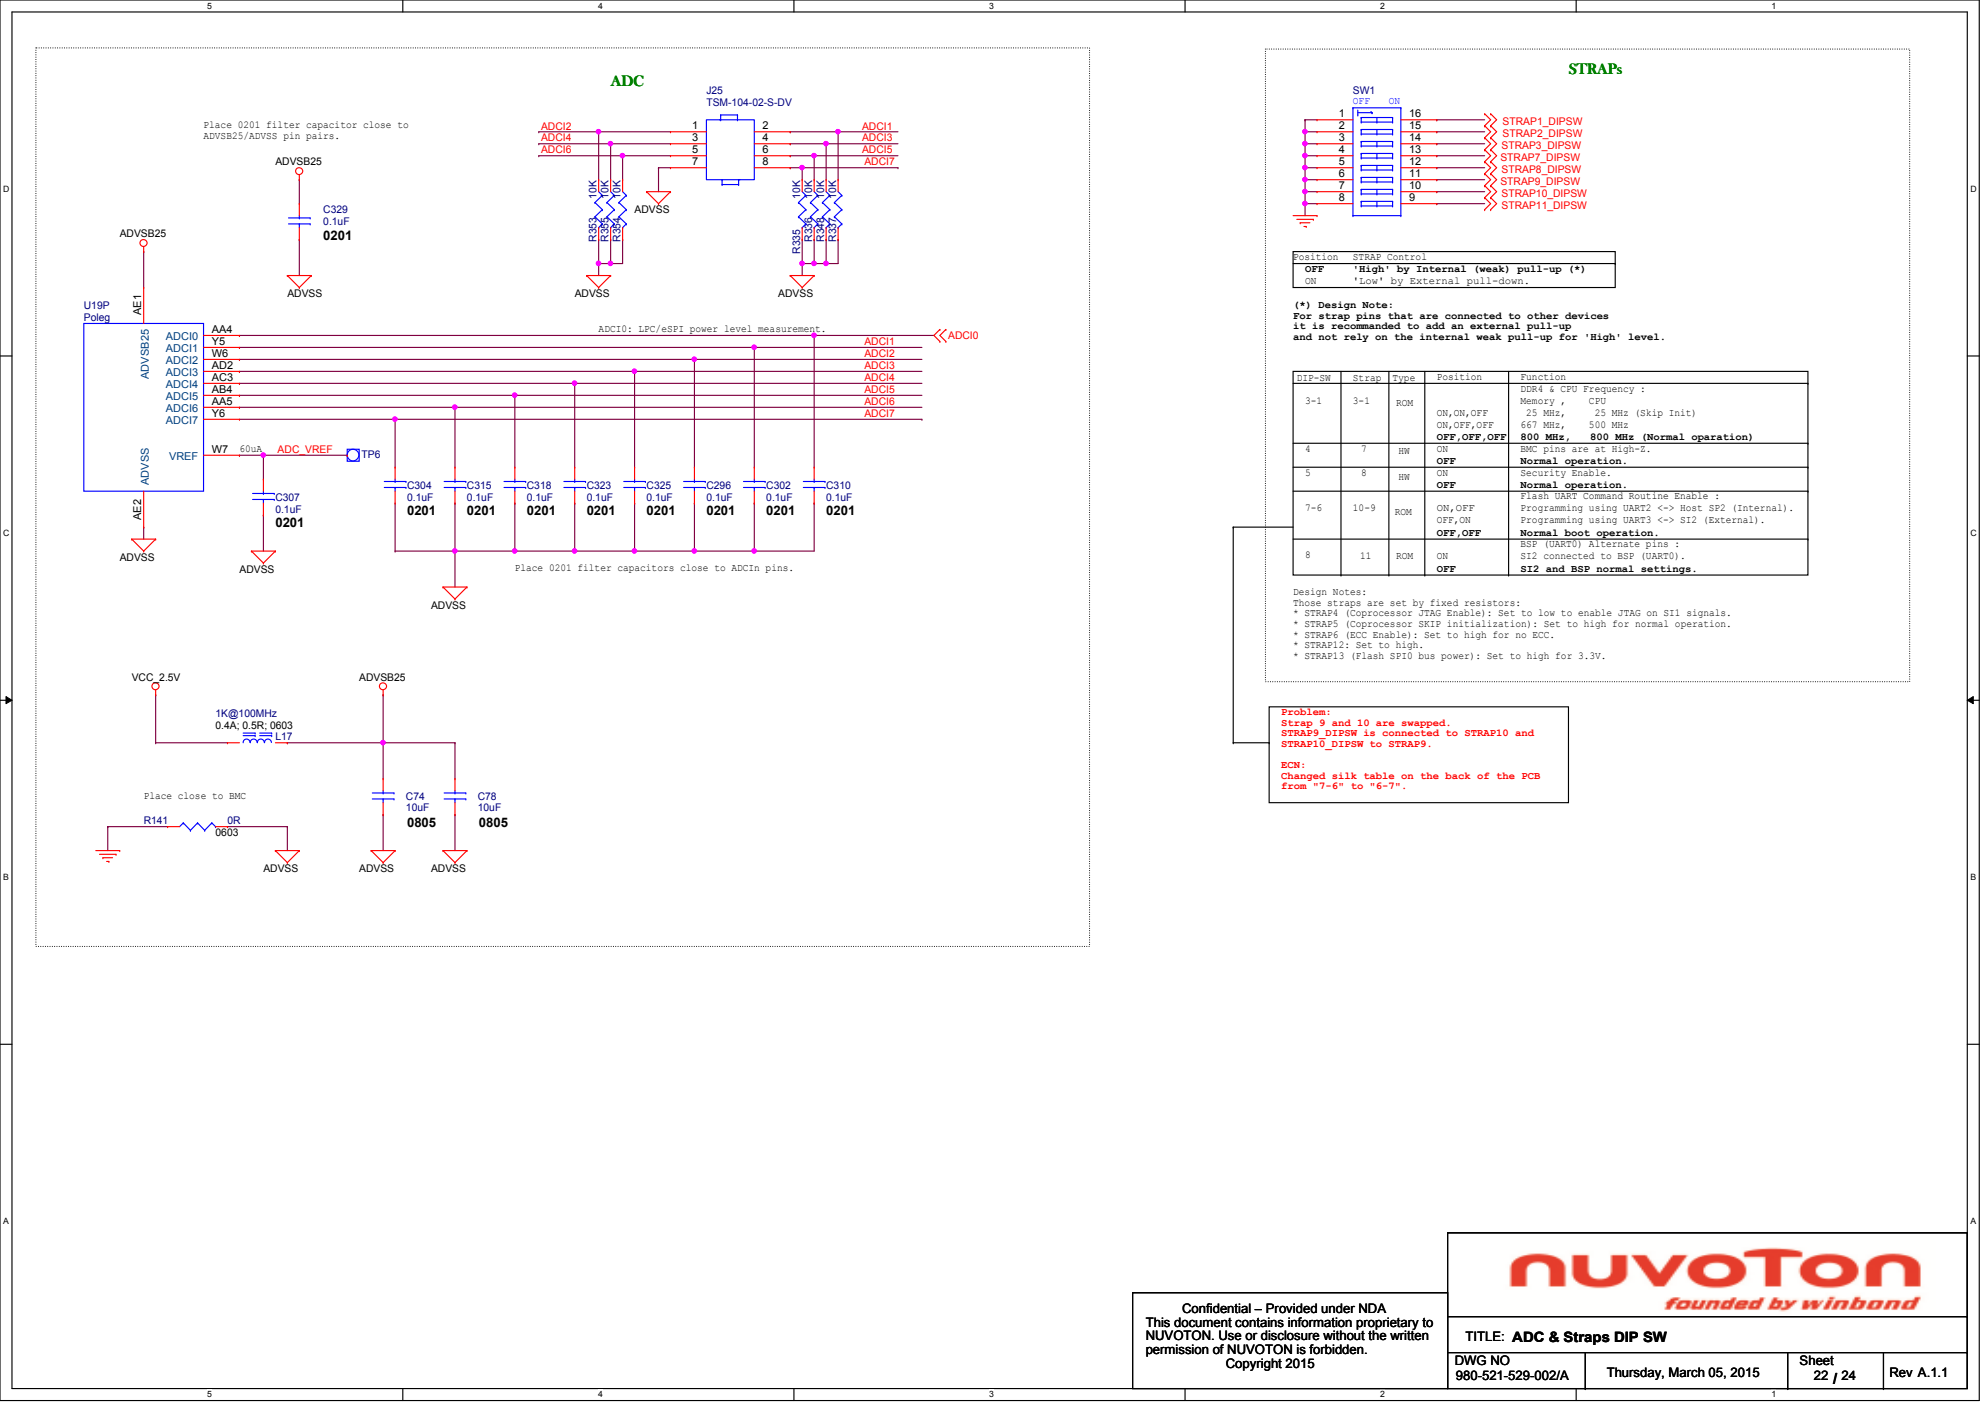
[picture p51: page 22]

Place 0201 filter capacitor close to
ADVSB25/ADVSS pin pairs.

STRAP Control
'High' by Internal (weak) pull-up (*)

(*) Design Note:
For strap pins that are connected to other devices
it is recommanded to add an external pull-up
and not rely on the internal weak pull-up for 'High' level.

ADCI0: LPC/eSPI power level measurement.

Security Enable.
Normal operation.
Flash UART Command Routine Enable :
Programming using UART2 <-> Host SP2 (Internal).
Programming using UART3 <-> SI2 (External).
Normal boot operation.
BSP (UART0) Alternate pins :
SI2 connected to BSP (UART0).
SI2 and BSP normal settings.

Place 0201 filter capacitors close to ADCIn pins.

Design Notes:
Those straps are set by fixed resistors:
* STRAP4 (Coprocessor JTAG Enable): Set to low to enable JTAG on SI1 signals.
* STRAP5 (Coprocessor SKIP initialization): Set to high for normal operation.
* STRAP6 (ECC Enable): Set to high for no ECC.
* STRAP12: Set to high.
* STRAP13 (Flash SPI0 bus power): Set to high for 3.3V.

Problem:
Strap 9 and 10 are swapped.
STRAP9_DIPSW is connected to STRAP10 and
STRAP10_DIPSW to STRAP9.

ECN:
Changed silk table on the back of the PCB
from "7-6" to "6-7".

Place close to BMC

ADC & Straps DIP SW

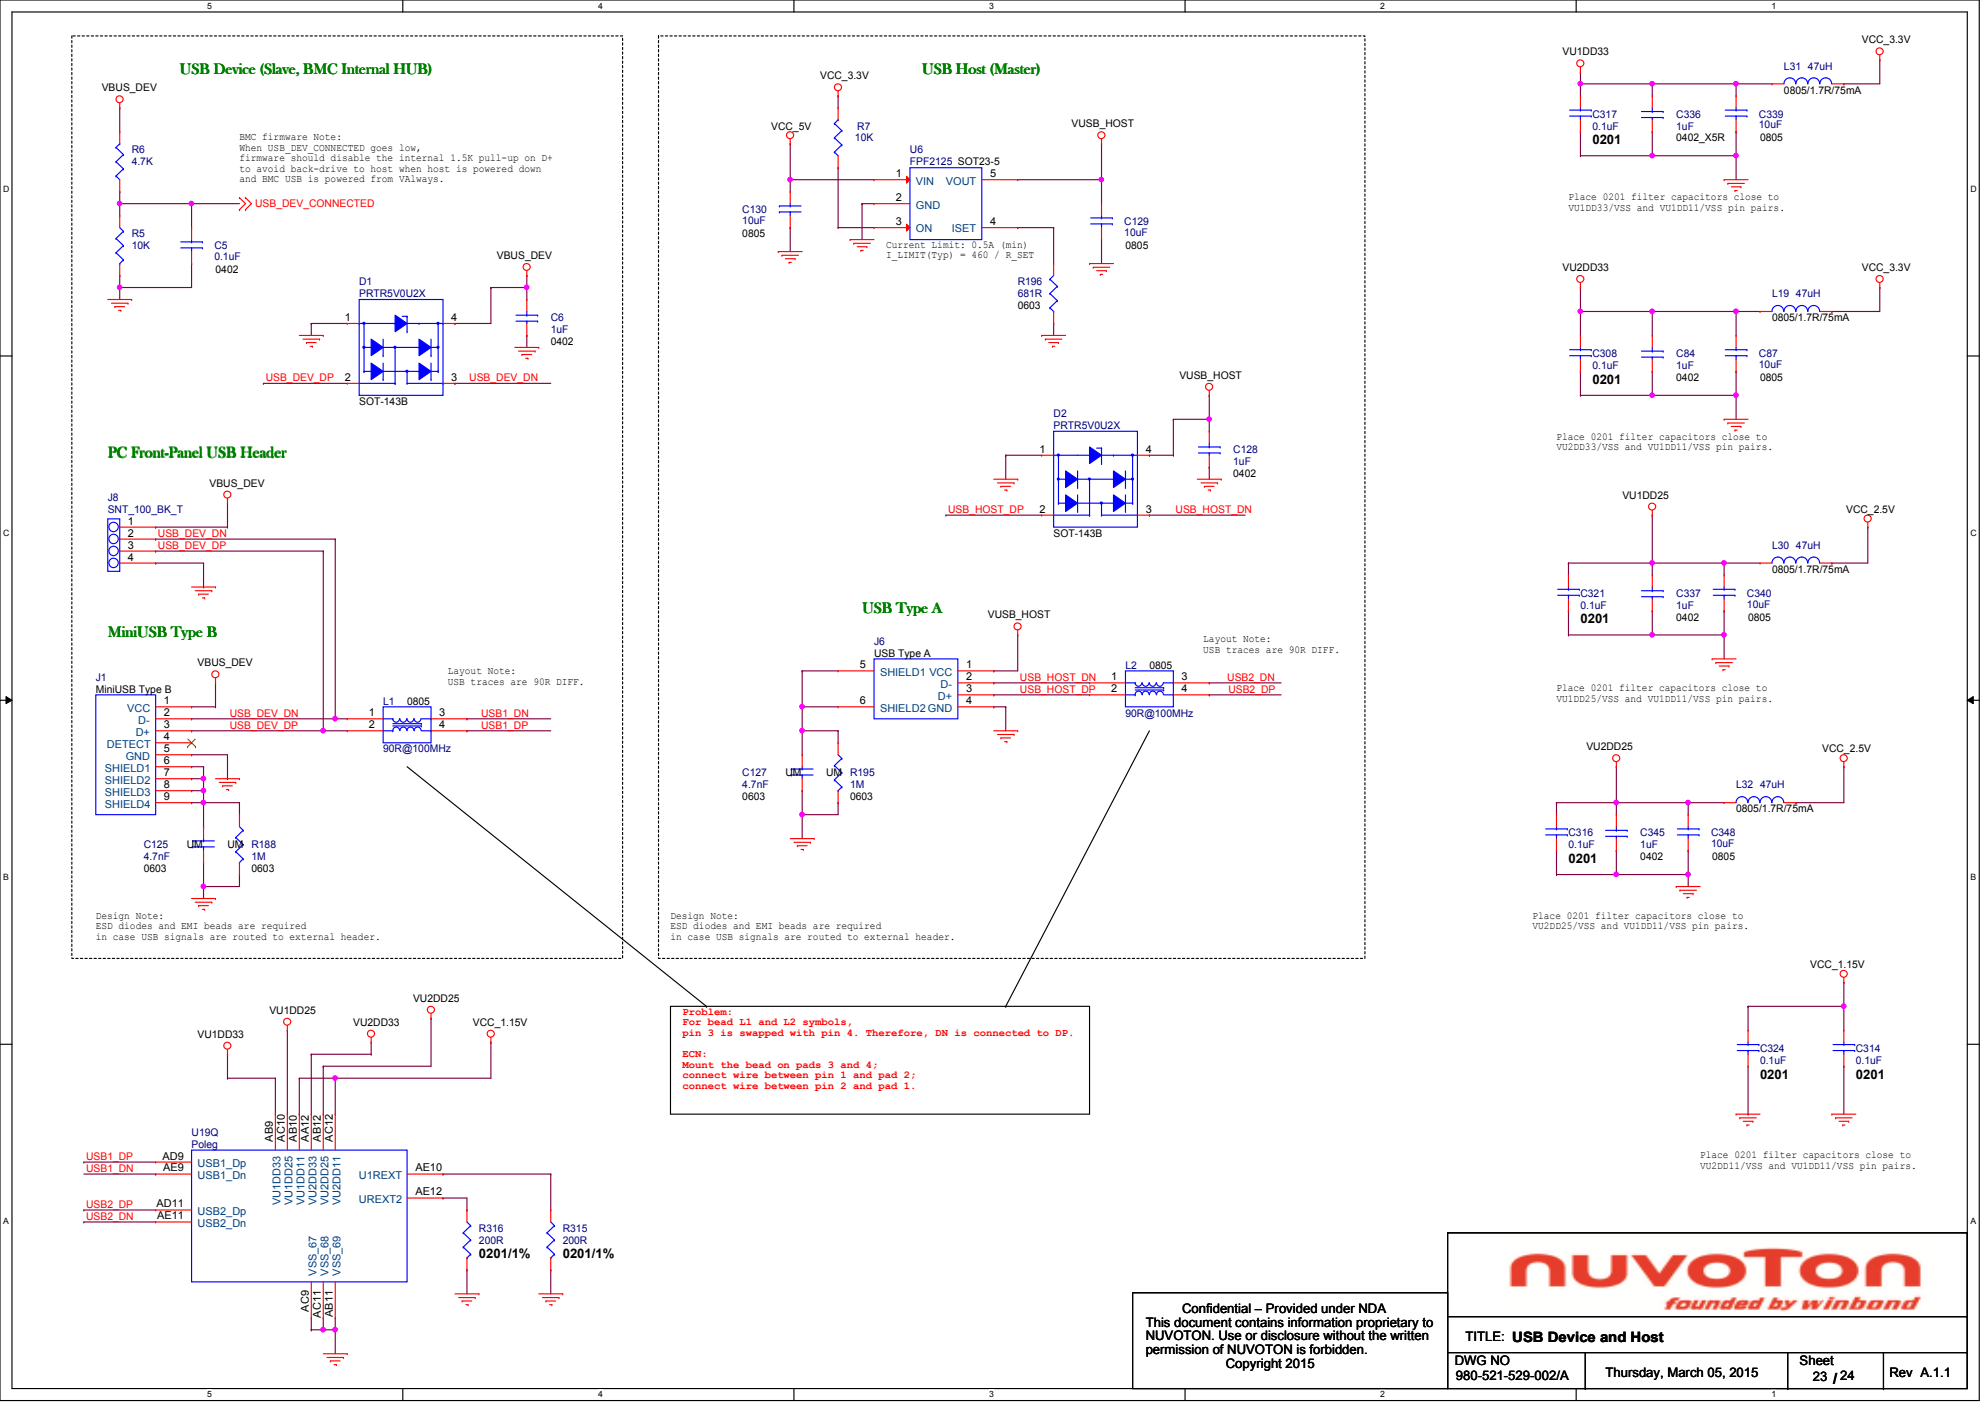
[picture p52: page 23]

BMC firmware Note:
When USB_DEV_CONNECTED goes low,
firmware should disable the internal 1.5K pull-up on D+
to avoid back-drive to host when host is powered down
and BMC USB is powered from VAlways.

Place 0201 filter capacitors close to
VU1DD33/VSS and VU1DD11/VSS pin pairs.

PC Front-Panel USB Header

VU2DD33/VSS and VU1DD11/VSS pin pairs.

Layout Note:
USB traces are 90R DIFF.

VU1DD25/VSS and VU1DD11/VSS pin pairs.

Design Note:
ESD diodes and EMI beads are required
in case USB signals are routed to external header.

VU2DD25/VSS and VU1DD11/VSS pin pairs.

Problem:
For bead L1 and L2 symbols,
pin 3 is swapped with pin 4. Therefore, DN is connected to DP.

ECN:
Mount the bead on pads 3 and 4;
connect wire between pin 1 and pad 2;
connect wire between pin 2 and pad 1.

VU2DD11/VSS and VU1DD11/VSS pin pairs.

USB Device and Host

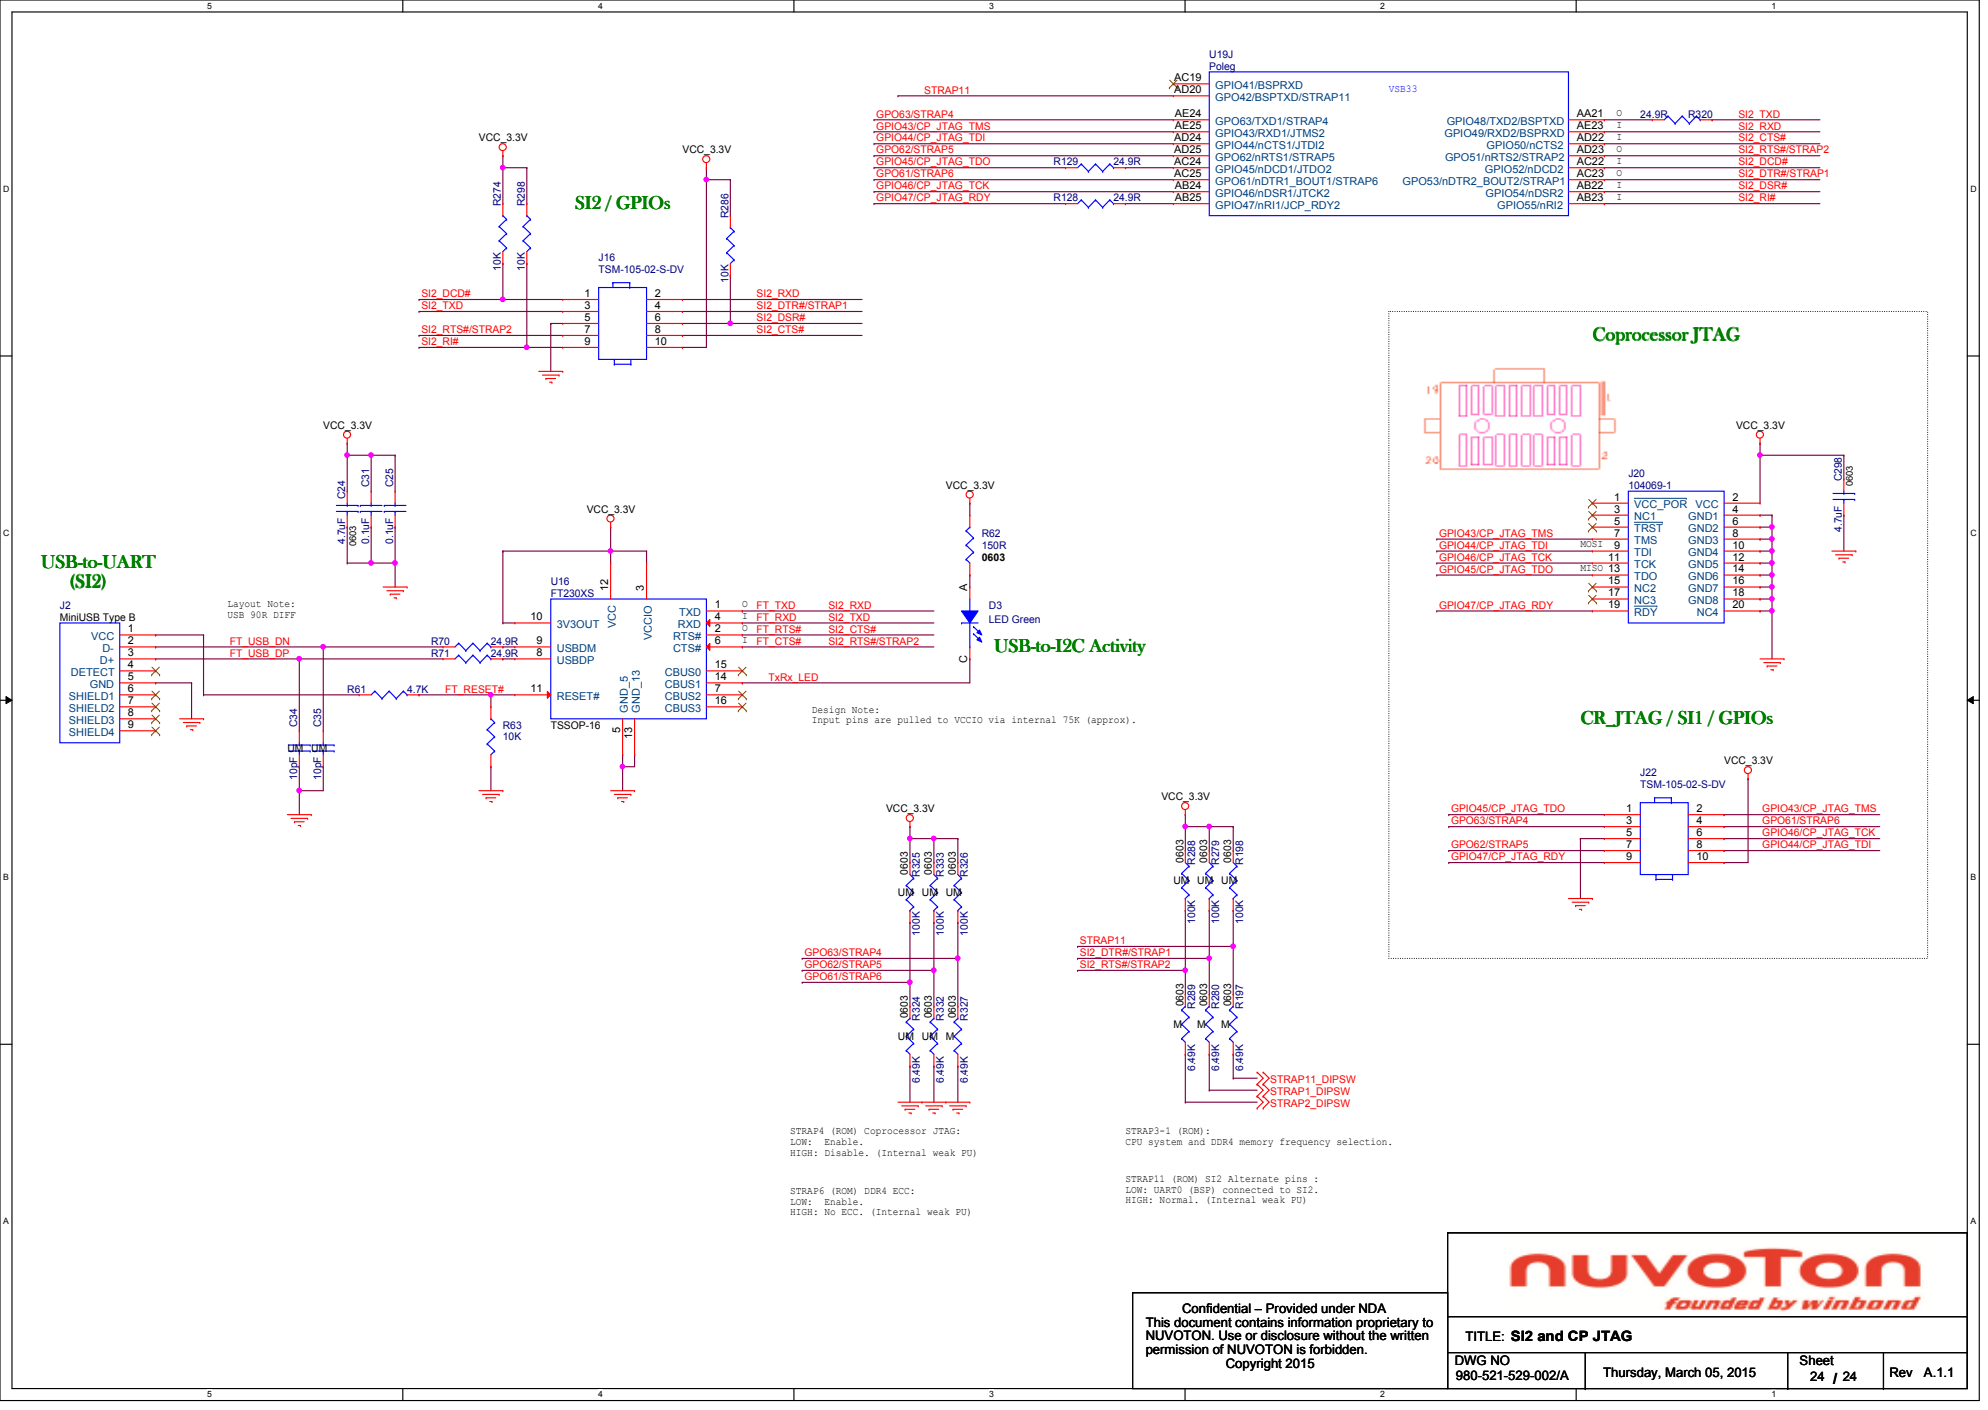
[picture p53: page 24]

Design Note:
Input pins are pulled to VCCIO via internal 75K (approx).

STRAP4 (ROM) Coprocessor JTAG:
LOW: Enable.
HIGH: Disable. (Internal weak PU)

STRAP3-1 (ROM):
CPU system and DDR4 memory frequency selection.

STRAP6 (ROM) DDR4 ECC:
HIGH: No ECC. (Internal weak PU)

STRAP11 (ROM) SI2 Alternate pins :
LOW: UART0 (BSP) connected to SI2.
HIGH: Normal. (Internal weak PU)

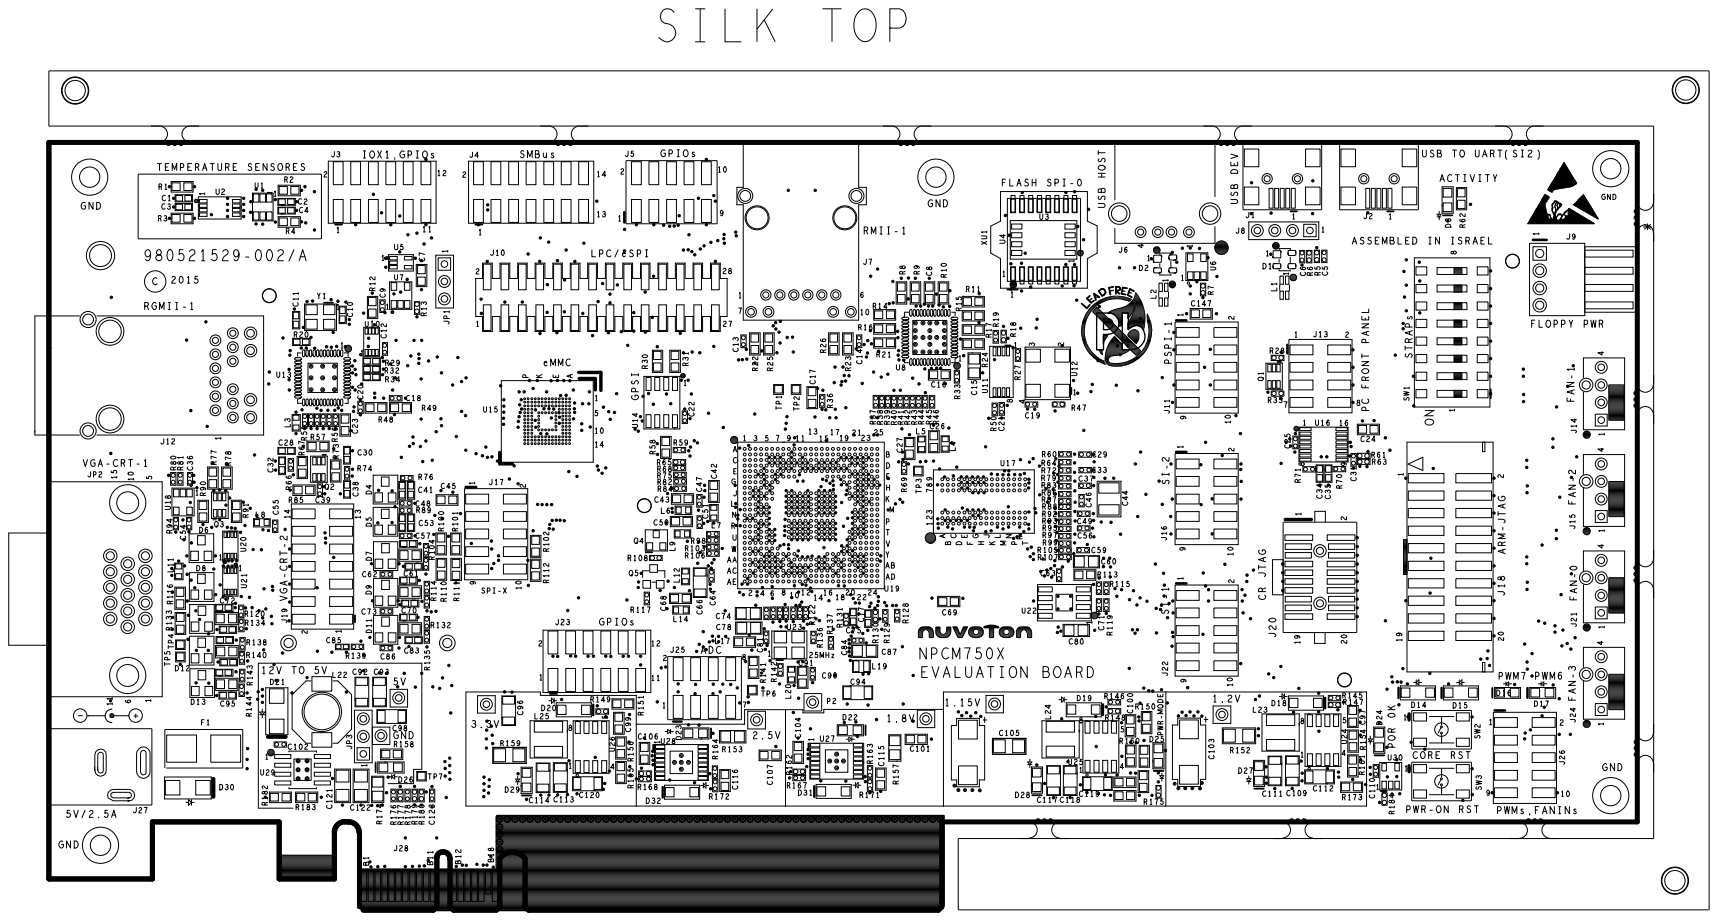
[picture p54: page 25]

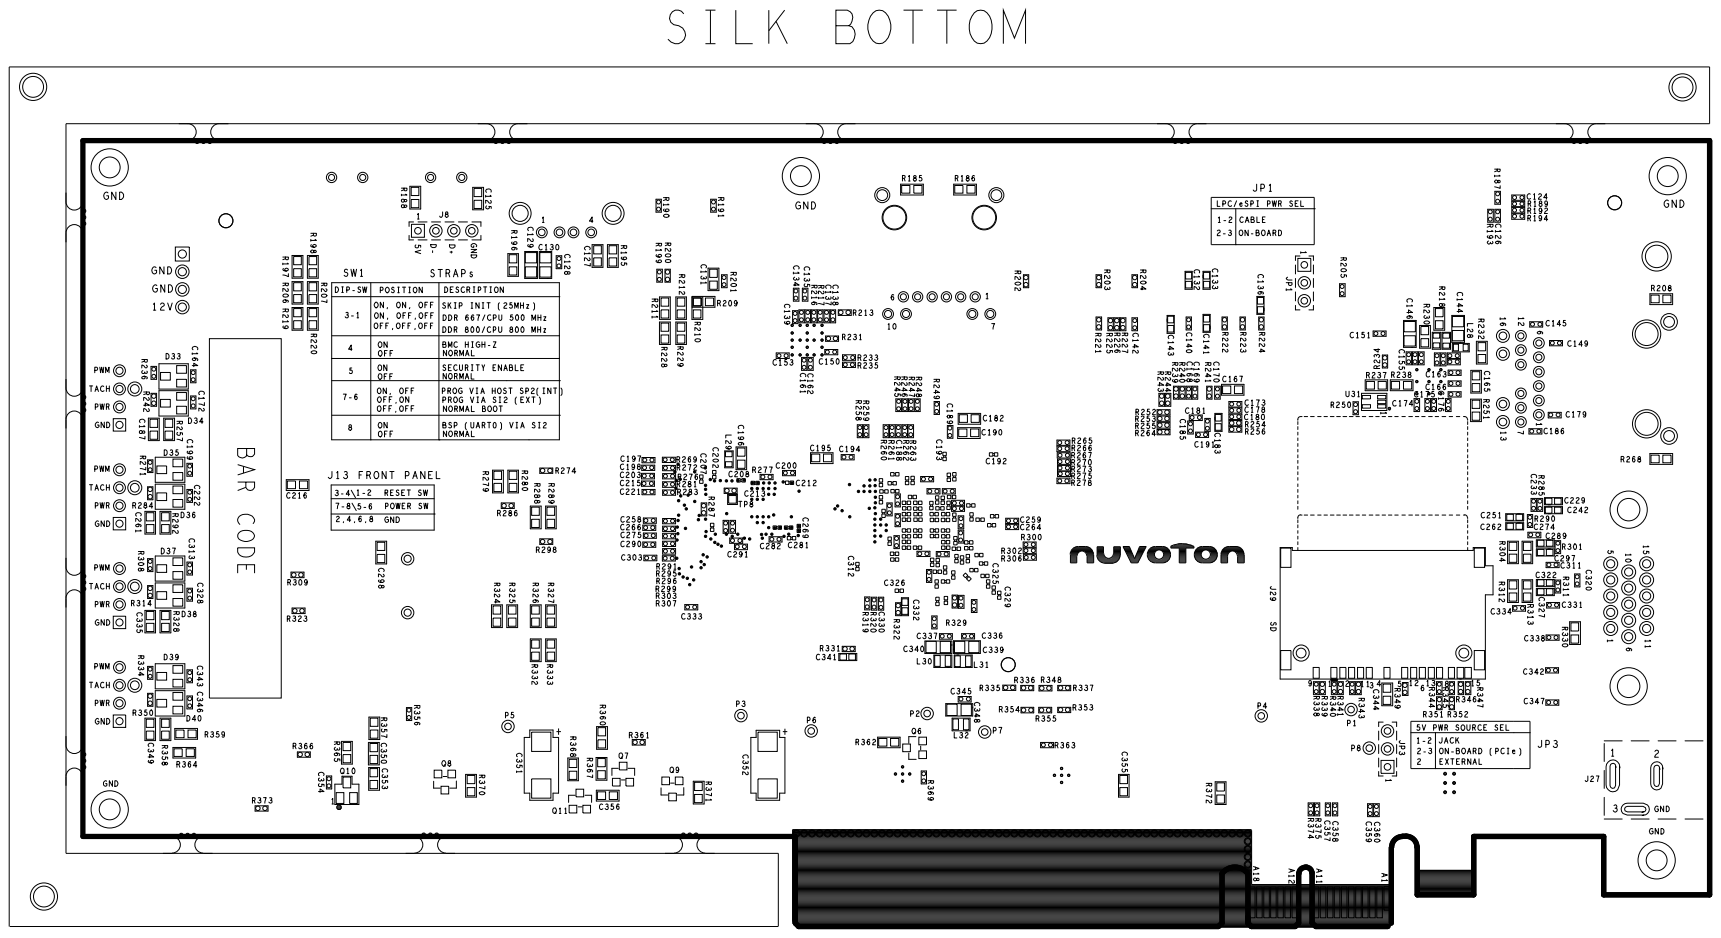
[picture p55: page 26]

# ASSEMBLY TOP

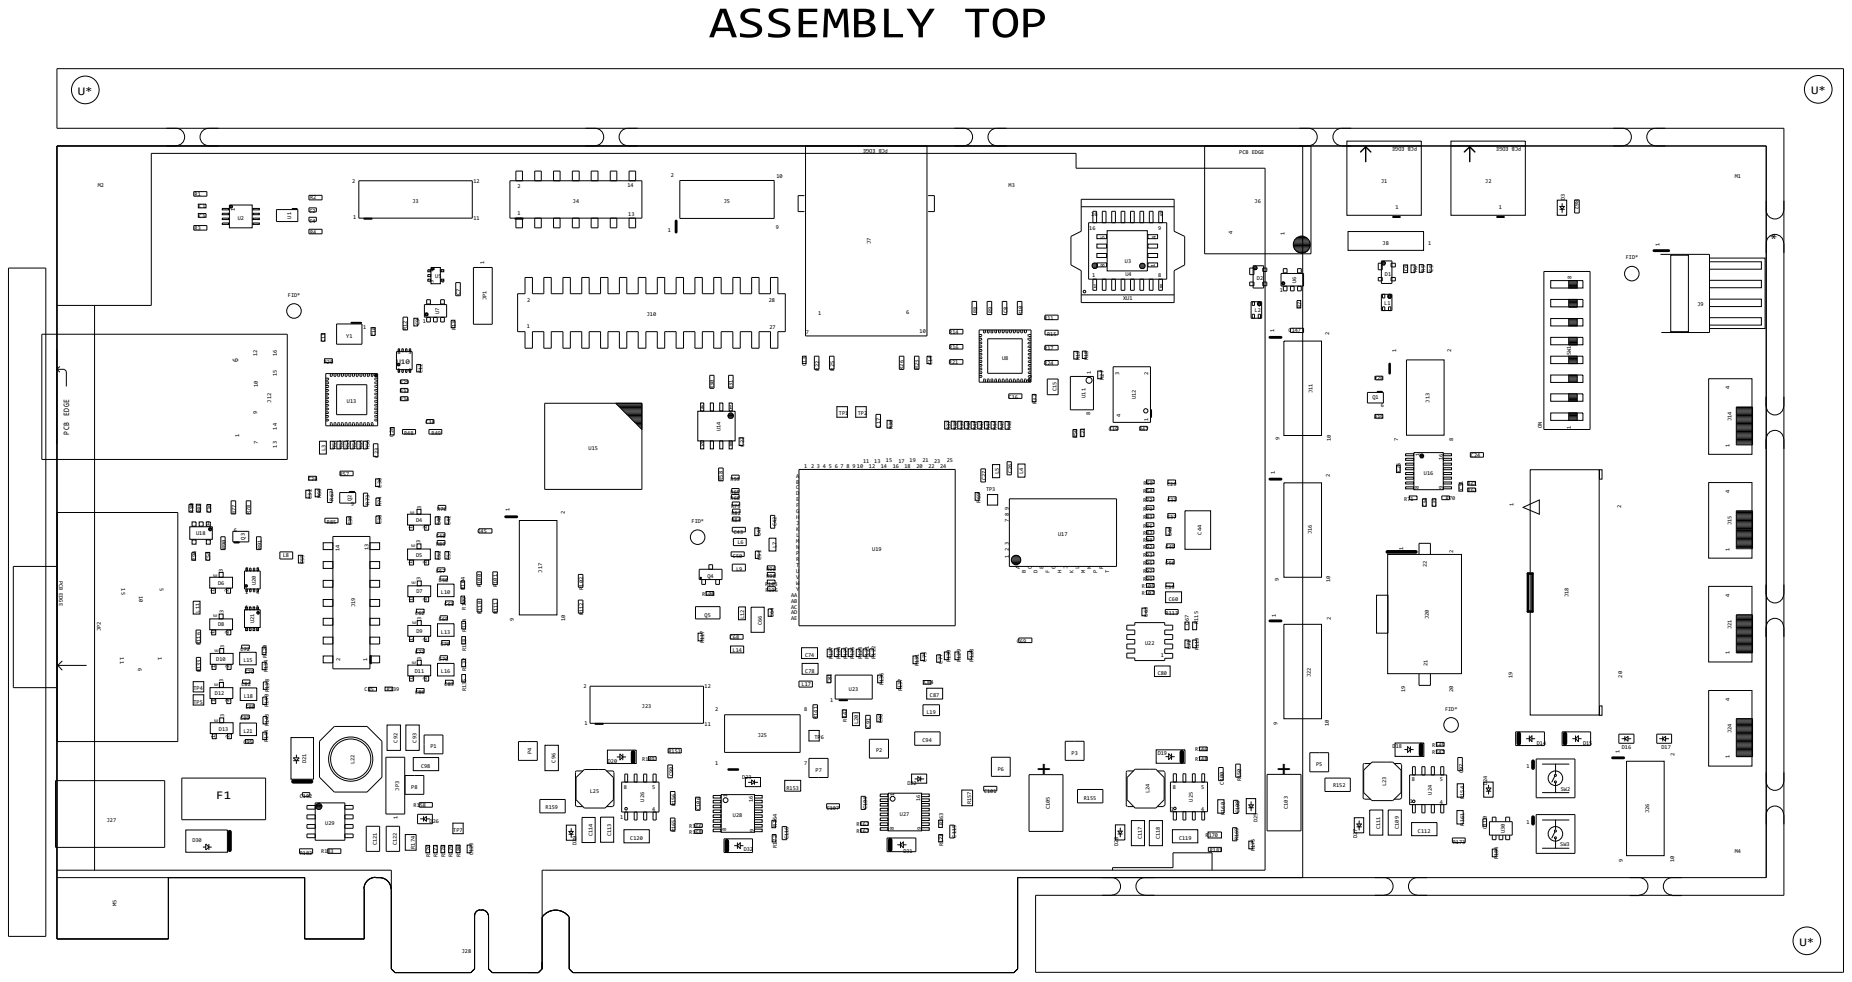
[picture p56: page 27]

PCB EDGE | J1 J8

# ASSEMBLY BOTTOM

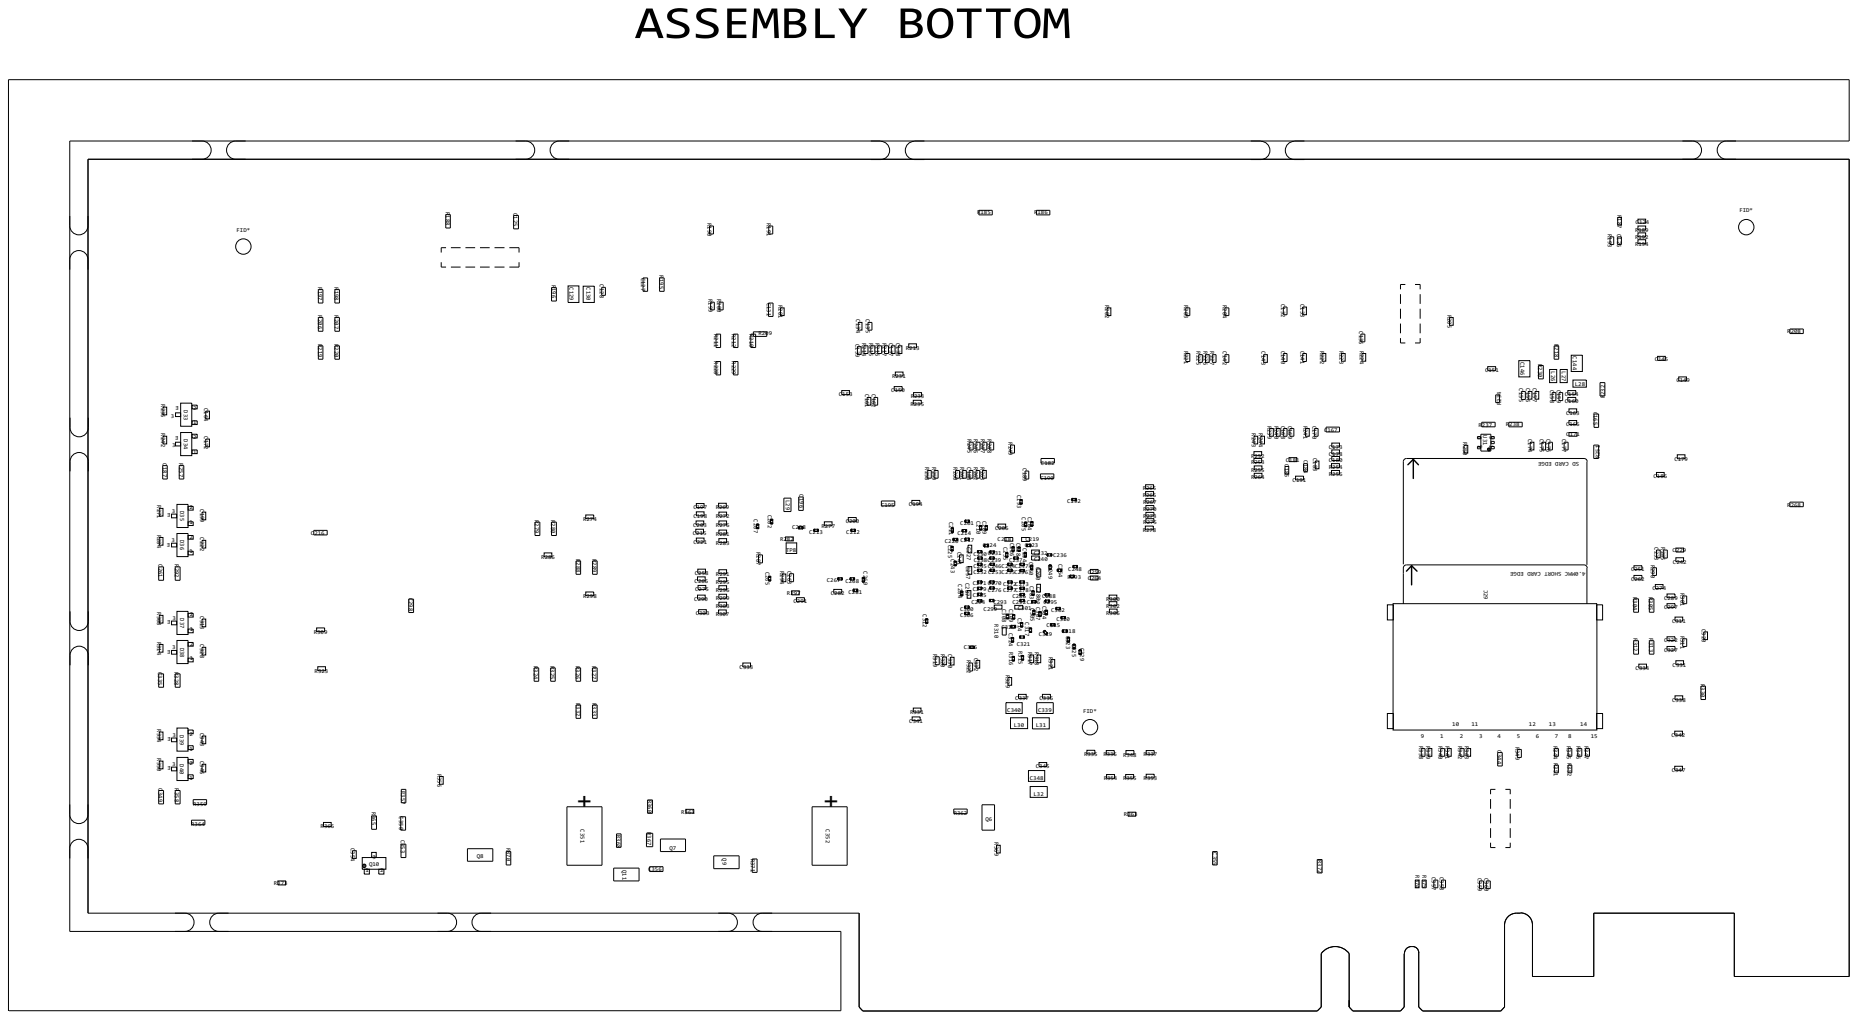
[picture p57: page 28]

# BOM

Part Number | Value | Mount | Part Reference | Description
880100015 | | UM | J28 | PCB PCIe Edge Connector X1
880400377 | | M | SW1 | SWITCH DIP SMD SPST 8 Switches FP=2.54mmX7.62mm
880500732 | 0.01R | M | R155 | RES SMD 0.01R 2W 1206
880500716 | 0.1R | M | R152 | RES SMD 0.1R 2W 1206
880500716 | 0.1R | M | R159 | RES SMD 0.1R 2W 1206
880600313 | 0.1uF | M | C5 | CAP CER X7R SMD 0.1uF 10% 16V 0402
880600313 | 0.1uF | M | C12 | CAP CER X7R SMD 0.1uF 10% 16V 0402
880600313 | 0.1uF | M | C13 | CAP CER X7R SMD 0.1uF 10% 16V 0402
880600313 | 0.1uF | M | C14 | CAP CER X7R SMD 0.1uF 10% 16V 0402
880600313 | 0.1uF | M | C18 | CAP CER X7R SMD 0.1uF 10% 16V 0402
880600313 | 0.1uF | M | C19 | CAP CER X7R SMD 0.1uF 10% 16V 0402
880600313 | 0.1uF | M | C20 | CAP CER X7R SMD 0.1uF 10% 16V 0402
880600313 | 0.1uF | M | C21 | CAP CER X7R SMD 0.1uF 10% 16V 0402
880600313 | 0.1uF | M | C22 | CAP CER X7R SMD 0.1uF 10% 16V 0402
880600313 | 0.1uF | M | C25 | CAP CER X7R SMD 0.1uF 10% 16V 0402
880600313 | 0.1uF | M | C29 | CAP CER X7R SMD 0.1uF 10% 16V 0402
880600313 | 0.1uF | M | C31 | CAP CER X7R SMD 0.1uF 10% 16V 0402
880600313 | 0.1uF | M | C33 | CAP CER X7R SMD 0.1uF 10% 16V 0402
880600313 | 0.1uF | M | C37 | CAP CER X7R SMD 0.1uF 10% 16V 0402
880600313 | 0.1uF | M | C39 | CAP CER X7R SMD 0.1uF 10% 16V 0402
880600313 | 0.1uF | M | C46 | CAP CER X7R SMD 0.1uF 10% 16V 0402
880600313 | 0.1uF | M | C48 | CAP CER X7R SMD 0.1uF 10% 16V 0402
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
880600337 | 1uF | M | C301 | CAP CER X7R SMD 1uF 10% 10V 0402
880600337 | 1uF | M | C320 | CAP CER X7R SMD 1uF 10% 10V 0402
880600337 | 1uF | M | C330 | CAP CER X7R SMD 1uF 10% 10V 0402
880600337 | 1uF | M | C336 | CAP CER X7R SMD 1uF 10% 10V 0402
880600337 | 1uF | M | C337 | CAP CER X7R SMD 1uF 10% 10V 0402
880600337 | 1uF | M | C345 | CAP CER X7R SMD 1uF 10% 10V 0402
880500455 | 2.21K | M | R67 | RES SMD 2.21K 1% 0603
880500455 | 2.21K | M | R73 | RES SMD 2.21K 1% 0603
880500455 | 2.21K | M | R77 | RES SMD 2.21K 1% 0603
880500455 | 2.21K | M | R91 | RES SMD 2.21K 1% 0603
880600308 | 2.2uF | M | C8 | CAP CER X7R SMD2.2uF 10% 16V 0603
880600308 | 2.2uF | M | C16 | CAP CER X7R SMD2.2uF 10% 16V 0603
880900889 | 2.5A | M | F1 | Fuse Block SMD Very-Fast-Acting 2.5A 125V
880500767 | 200R | M | R293 | RES SMD 200R 1% 0201
880500767 | 200R | M | R315 | RES SMD 200R 1% 0201
880500767 | 200R | M | R316 | RES SMD 200R 1% 0201
880900834 | 220R@100MHz | M | L3 | Bead SMD 220R@100MHz 2.2A 50mR 0603
880900834 | 220R@100MHz | M | L4 | Bead SMD 220R@100MHz 2.2A 50mR 0603
880900834 | 220R@100MHz | M | L5 | Bead SMD 220R@100MHz 2.2A 50mR 0603
880900834 | 220R@100MHz | M | L6 | Bead SMD 220R@100MHz 2.2A 50mR 0603
880900834 | 220R@100MHz | M | L7 | Bead SMD 220R@100MHz 2.2A 50mR 0603
880900834 | 220R@100MHz | M | L8 | Bead SMD 220R@100MHz 2.2A 50mR 0603
880900834 | 220R@100MHz | M | L9 | Bead SMD 220R@100MHz 2.2A 50mR 0603
880900834 | 220R@100MHz | M | L11 | Bead SMD 220R@100MHz 2.2A 50mR 0603
880900834 | 220R@100MHz | M | L12 | Bead SMD 220R@100MHz 2.2A 50mR 0603
880900834 | 220R@100MHz | M | L14 | Bead SMD 220R@100MHz 2.2A 50mR 0603
880900834 | 220R@100MHz | M | L20 | Bead SMD 220R@100MHz 2.2A 50mR 0603
880900834 | 220R@100MHz | M | L26 | Bead SMD 220R@100MHz 2.2A 50mR 0603
880900834 | 220R@100MHz | M | L27 | Bead SMD 220R@100MHz 2.2A 50mR 0603
880900834 | 220R@100MHz | M | L28 | Bead SMD 220R@100MHz 2.2A 50mR 0603
880900834 | 220R@100MHz | M | L29 | Bead SMD 220R@100MHz 2.2A 50mR 0603

880500621 | 221R | M | R25 | RES SMD 221R 1% 0603
880500621 | 221R | M | R26 | RES SMD 221R 1% 0603
880500621 | 221R | M | R150 | RES SMD 221R 1% 0603
880500621 | 221R | M | R359 | RES SMD 221R 1% 0603
880500621 | 221R | M | R362 | RES SMD 221R 1% 0603
880500621 | 221R | M | R364 | RES SMD 221R 1% 0603
880500621 | 221R | M | R370 | RES SMD 221R 1% 0603
880500621 | 221R | M | R371 | RES SMD 221R 1% 0603
880500621 | 221R | M | R372 | RES SMD 221R 1% 0603
880600357 | 22uF | M | C66 | CAP CER X5R SMD 22uF 10% 16V 1206
880600357 | 22uF | M | C92 | CAP CER X5R SMD 22uF 10% 16V 1206
880600357 | 22uF | M | C93 | CAP CER X5R SMD 22uF 10% 16V 1206
880600357 | 22uF | M | C94 | CAP CER X5R SMD 22uF 10% 16V 1206
880600357 | 22uF | M | C96 | CAP CER X5R SMD 22uF 10% 16V 1206
880600357 | 22uF | M | C98 | CAP CER X5R SMD 22uF 10% 16V 1206
880600357 | 22uF | M | C109 | CAP CER X5R SMD 22uF 10% 16V 1206
880600357 | 22uF | M | C111 | CAP CER X5R SMD 22uF 10% 16V 1206
880600357 | 22uF | M | C112 | CAP CER X5R SMD 22uF 10% 16V 1206
880600357 | 22uF | M | C113 | CAP CER X5R SMD 22uF 10% 16V 1206
880600357 | 22uF | M | C114 | CAP CER X5R SMD 22uF 10% 16V 1206
880600357 | 22uF | M | C117 | CAP CER X5R SMD 22uF 10% 16V 1206
880600357 | 22uF | M | C118 | CAP CER X5R SMD 22uF 10% 16V 1206
880600357 | 22uF | M | C119 | CAP CER X5R SMD 22uF 10% 16V 1206
880600357 | 22uF | M | C120 | CAP CER X5R SMD 22uF 10% 16V 1206
880900747 | 22uH | M | L22 | INDUCTOR POWER SMD Shielded 22uH at 100KHz 75mR 2.6A
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
880900883 | 90R@100MHz | M | L2 | Bead SMD 2012 Common Mode Filter 90R@100MHz, 0.19R@DC
880400910 | ACA-SPI-006-K02 | UM (order 20) XU1 | | Socket SMD For SPI Flash FP=1.27mm SOIC-16
880900822 | B360A-13-F | M | D21 | Diode SMD Schottky Rectifier 60V 3A
880900822 | B360A-13-F | M | D30 | Diode SMD Schottky Rectifier 60V 3A
880900502 | BAT54S-7-F | M | D4 | Diode SMD Schottky Barrier 30V 200mA 200mW SOT23
880900502 | BAT54S-7-F | M | D5 | Diode SMD Schottky Barrier 30V 200mA 200mW SOT23
880900502 | BAT54S-7-F | M | D6 | Diode SMD Schottky Barrier 30V 200mA 200mW SOT23
880900502 | BAT54S-7-F | M | D7 | Diode SMD Schottky Barrier 30V 200mA 200mW SOT23
880900502 | BAT54S-7-F | M | D8 | Diode SMD Schottky Barrier 30V 200mA 200mW SOT23
880900502 | BAT54S-7-F | M | D9 | Diode SMD Schottky Barrier 30V 200mA 200mW SOT23
880900502 | BAT54S-7-F | M | D10 | Diode SMD Schottky Barrier 30V 200mA 200mW SOT23
880900502 | BAT54S-7-F | M | D11 | Diode SMD Schottky Barrier 30V 200mA 200mW SOT23
880900502 | BAT54S-7-F | M | D12 | Diode SMD Schottky Barrier 30V 200mA 200mW SOT23
880900502 | BAT54S-7-F | M | D13 | Diode SMD Schottky Barrier 30V 200mA 200mW SOT23
880900502 | BAT54S-7-F | M | D33 | Diode SMD Schottky Barrier 30V 200mA 200mW SOT23
880900502 | BAT54S-7-F | M | D34 | Diode SMD Schottky Barrier 30V 200mA 200mW SOT23
880900502 | BAT54S-7-F | M | D35 | Diode SMD Schottky Barrier 30V 200mA 200mW SOT23
880900502 | BAT54S-7-F | M | D36 | Diode SMD Schottky Barrier 30V 200mA 200mW SOT23
880900502 | BAT54S-7-F | M | D37 | Diode SMD Schottky Barrier 30V 200mA 200mW SOT23
880900502 | BAT54S-7-F | M | D38 | Diode SMD Schottky Barrier 30V 200mA 200mW SOT23
880900502 | BAT54S-7-F | M | D39 | Diode SMD Schottky Barrier 30V 200mA 200mW SOT23
880900502 | BAT54S-7-F | M | D40 | Diode SMD Schottky Barrier 30V 200mA 200mW SOT23
880300892 | BCM5221A4KMLG | M | U8 | IC 10/100 BASE TX/FX transceiver, MII and RMII configurable 3.3V KML-48
880300893 | BCM54612EB1KMLG | M | U13 | IC 10/100/1000 BASE-T Gigabit Ethernet transceiver with RGMII MAC 3.3V MLP-48
880900765 | BSS138 | M | Q5 | TRAN MOSFET N-CHANNEL ENHANCEMENT
880900765 | BSS138 | M | Q6 | TRAN MOSFET N-CHANNEL ENHANCEMENT
880900765 | BSS138 | M | Q7 | TRAN MOSFET N-CHANNEL ENHANCEMENT
880900765 | BSS138 | M | Q8 | TRAN MOSFET N-CHANNEL ENHANCEMENT
880900765 | BSS138 | M | Q9 | TRAN MOSFET N-CHANNEL ENHANCEMENT
880900765 | BSS138 | M | Q11 | TRAN MOSFET N-CHANNEL ENHANCEMENT
880300870 | CAT25512VI-GT3L | M | U14 | IC Memory SMD 64Kx8 512 Kb SPI CMOS EEPROM SO-8 1.8V

880400809 | CVILUX | M | JP2 | CON D-TYPE VGA 15S R.A. pitch=2.29mm PCB
880300638 | CY2304NZZXC1 | M | U11 | IC Logic SMD 4-Output PCI-X & Buffer 3.3V
880300868 | EDY4016AABG-DR-F-D | M | U17 | IC Memory SMD SDRAM (DDR4-3200) 4Gb (256MX16) 1.2V FBGA-96
880400747 | Floppy PWR | M | J9 | Con floppy power
880300788 | FPF2125 | M | U6 | IC Switch Adjust Current Limit Vin=1.8-5.5V SOT23-5
880300788 | FPF2125 | M | U7 | IC Switch Adjust Current Limit Vin=1.8-5.5V SOT23-5
880300788 | FPF2125 | M | U18 | IC Switch Adjust Current Limit Vin=1.8-5.5V SOT23-5
880300899 | FT230XS | M | U16 | IC USB to serial UART interface VCC=5Vmax SSOP16
MECH_200RD118P | Hole_Spacer | UM | M1 | Plated Spacer Hole (Internal 3mm, External 5mm)
MECH_200RD118P | Hole_Spacer | UM | M2 | Plated Spacer Hole (Internal 3mm, External 5mm)
MECH_200RD118P | Hole_Spacer | UM | M3 | Plated Spacer Hole (Internal 3mm, External 5mm)
MECH_200RD118P | Hole_Spacer | UM | M4 | Plated Spacer Hole (Internal 3mm, External 5mm)
MECH_200RD118P | Hole_Spacer | UM | M5 | Plated Spacer Hole (Internal 3mm, External 5mm)
880400680 | HTST-110-01-S-DV | M | J18 | Con Recept SMD D-ROW 20P 2.54MM
880900726 | IRLML6402 | M | Q4 | MOSFET SMD P-Channel SOT-23 3.7A
880400891 | JACK_PWR | M | J27 | Con DC POWER JACK RA TH 2.5mm
880400010 | Jumper | M | XJP1 | JUMPER Socket 1-ROW 2.54mm Sq Black H=13.75mm
880400010 | Jumper | M | XJP3 | JUMPER Socket 1-ROW 2.54mm Sq Black H=13.75mm
880900777 | LED Green | M | D3 | LED SMD Green 570nm 5mA 1.95V 0805
880900777 | LED Green | M | D17 | LED SMD Green 570nm 5mA 1.95V 0805
880900777 | LED Green | M | D22 | LED SMD Green 570nm 5mA 1.95V 0805
880900777 | LED Green | M | D23 | LED SMD Green 570nm 5mA 1.95V 0805
880900777 | LED Green | M | D25 | LED SMD Green 570nm 5mA 1.95V 0805
880900777 | LED Green | M | D26 | LED SMD Green 570nm 5mA 1.95V 0805
880900777 | LED Green | M | D27 | LED SMD Green 570nm 5mA 1.95V 0805
880900777 | LED Green | M | D28 | LED SMD Green 570nm 5mA 1.95V 0805
880900777 | LED Green | M | D29 | LED SMD Green 570nm 5mA 1.95V 0805
880900778 | LED Red | M | D16 | LED SMD Red 570nm 5mA 1.8V 0805
880900778 | LED Red | M | D24 | LED SMD Red 570nm 5mA 1.8V 0805
880300667 | LM75 | M | U2 | IC Linear SMD Temp sensor & Watchdog 3.3V MSOP-8
880300553 | MAX1793EUE-18+ | M | U27 | IC Linear SMD Regulator 1A 1.8V TSSOP-16
880300554 | MAX1793EUE-25+ | M | U28 | IC Linear SMD Regulator 1A 3.3V TSSOP-16
880300776 | MAX6414UK30T | M | U30 | IC Reset Supervisor Low Power 6V 20mA
880900738 | MBR130T1 | UM | D14 | Diode Schottky SMD 1A 30V SOD-123
880900738 | MBR130T1 | M | D15 | Diode Schottky SMD 1A 30V SOD-123
880900738 | MBR130T1 | M | D18 | Diode Schottky SMD 1A 30V SOD-123
880900738 | MBR130T1 | M | D19 | Diode Schottky SMD 1A 30V SOD-123
880900738 | MBR130T1 | M | D20 | Diode Schottky SMD 1A 30V SOD-123
880900738 | MBR130T1 | M | D31 | Diode Schottky SMD 1A 30V SOD-123
880900738 | MBR130T1 | M | D32 | Diode Schottky SMD 1A 30V SOD-123
880300876 | MTFC4GACAEAM-1M WT | M | U15 | IC Memory eMMC 4GB v5.0-compliant 3.3V WFBGA-153
880400740 | MUSB-05-X-AB-SM-A | M | J1 | CON MINI USB Type AB
880400740 | MUSB-05-X-AB-SM-A | M | J2 | CON MINI USB Type AB
880300837 | NCP3170ADR2G | M | U24 | IC Synchronous PWM Switching Buck Regulator 18Vmax SOIC8
880300837 | NCP3170ADR2G | M | U25 | IC Synchronous PWM Switching Buck Regulator 18Vmax SOIC8
880300837 | NCP3170ADR2G | M | U26 | IC Synchronous PWM Switching Buck Regulator 18Vmax SOIC8
880300877 | NCT3101S | M | U22 | IC Bus Termination Regulator for DDR4 2A 7Vmax ESOP8
880900650 | P- Channel | M | Q10 | MOSFET SMD P-Channel Ehancment 50V 130mA 200mW SOT-23
880400774 | PH1M25-206GDBOOR8.3/7.5/3.81-U | M | J3 | Header SMD 2-ROW 12P FP=2.54mm Sq
880400774 | PH1M25-206GDBOOR8.3/7.5/3.81-U | M | J23 | Header SMD 2-ROW 12P FP=2.54mm Sq
880200714 | Poleg | M | U19 | IC Microcontroller SMD BMC 2D Graphic Core KVM FCBGA-517 3.3V-2.5V
880900884 | PRTR5V0U2X | M | D1 | Diode SMD Ultra low cap double rail2rail ESD Vr=3V SOT-143
880900884 | PRTR5V0U2X | M | D2 | Diode SMD Ultra low cap double rail2rail ESD Vr=3V SOT-143
880400793 | PTS525-S-M-10 | M | SW2 | Switch TACT SMD
880400793 | PTS525-S-M-10 | M | SW3 | Switch TACT SMD
880400968 | RJ45_0810-1XX1-01 | M | J7 | CON LAN TH include magnetics 10/100BASE-TX for BroadCom
880400888 | SDC013-00-500F | M | J29 | CONN SD MMC SMD SHORT 19P
880400038 | SNT_100_BK_T | M | J8 | Header S-row 4P male Straight 2.54 square
880300760 | TMP100 | M | U1 | IC Temprature Sensor With I²C Interface 2.7-5.5V SOT-23
880100008 | TP | M | TP1 | Terminal Test Point SMD 1mmX1mm
880100008 | TP | M | TP2 | Terminal Test Point SMD 1mmX1mm
880100008 | TP | M | TP3 | Terminal Test Point SMD 1mmX1mm
880100008 | TP | M | TP4 | Terminal Test Point SMD 1mmX1mm
880100008 | TP | M | TP5 | Terminal Test Point SMD 1mmX1mm
880100008 | TP | M | TP6 | Terminal Test Point SMD 1mmX1mm
880100008 | TP | M | TP7 | Terminal Test Point SMD 1mmX1mm
880100008 | TP | M | TP8 | Terminal Test Point SMD 1mmX1mm
880300882 | TPS5450DDA | M | U29 | IC SMD Step Down Converter 5A 36Vmax SOIC8
880400702 | TSM-104-02-S-DV | M | J13 | Header SMD D-ROW 8P MALE STRAIGHT
880400702 | TSM-104-02-S-DV | M | J25 | Header SMD D-ROW 8P MALE STRAIGHT
880400708 | TSM-105-02-S-DV | M | J5 | Header SMD 2-ROW 10P FP=2.54mm
880400708 | TSM-105-02-S-DV | M | J11 | Header SMD 2-ROW 10P FP=2.54mm
880400708 | TSM-105-02-S-DV | M | J16 | Header SMD 2-ROW 10P FP=2.54mm
880400708 | TSM-105-02-S-DV | M | J17 | Header SMD 2-ROW 10P FP=2.54mm
880400708 | TSM-105-02-S-DV | M | J22 | Header SMD 2-ROW 10P FP=2.54mm

880400708 | TSM-105-02-S-DV | M | J26 | Header SMD 2-ROW 10P FP=2.54mm
880400775 | TSM-107-02-S-DV | M | J4 | HEADER SMD 2-ROW 14P FP=2.54mm Sq
880400775 | TSM-107-02-S-DV | M | J19 | HEADER SMD 2-ROW 14P FP=2.54mm Sq
880400970 | TSM-114-02-S-DV | M | J10 | HEADER SMD 2-ROW 28P FP=2.54mm Sq
880300901 | TXS0102DCUR | M | U10 | IC 2-Bit Bidirectional Voltage-Level Translator for Open-Drain and Push-Pull SO-8
880400812 | USB-A-S_S-W-Th | M | J6 | CON USB TH TYPA A R.A
880300852 | W25Q128FVSG | UM | U3 | IC Memory SMD Quad / Dual SPI Flash 128Mbit 2.7-3.6V SOIC8
880300872 | W25Q256FVFI | M | U4 | IC Memory SMD Quad Flash 50MHz-SPI-QPI-Interface 256Mb 2.7V/3.6V SO-16
880100008 | TP | M | TP6 | Terminal Test Point SMD 1mmX1mm
880100008 | TP | M | TP7 | Terminal Test Point SMD 1mmX1mm
880100008 | TP | M | TP8 | Terminal Test Point SMD 1mmX1mm
880300882 | TPS5450DDA | M | U29 | IC SMD Step Down Converter 5A 36Vmax SOIC8
880400702 | TSM-104-02-S-DV | M | J13 | Header SMD D-ROW 8P MALE STRAIGHT
880400702 | TSM-104-02-S-DV | M | J25 | Header SMD D-ROW 8P MALE STRAIGHT
880400708 | TSM-105-02-S-DV | M | J11 | Header SMD 2-ROW 10P FP=2.54mm
880400708 | TSM-105-02-S-DV | M | J16 | Header SMD 2-ROW 10P FP=2.54mm
880400708 | TSM-105-02-S-DV | M | J17 | Header SMD 2-ROW 10P FP=2.54mm
880400708 | TSM-105-02-S-DV | M | J22 | Header SMD 2-ROW 10P FP=2.54mm
880400708 | TSM-105-02-S-DV | M | J26 | Header SMD 2-ROW 10P FP=2.54mm
880400708 | TSM-105-02-S-DV | M | J5 | Header SMD 2-ROW 10P FP=2.54mm
880400775 | TSM-107-02-S-DV | M | J19 | HEADER SMD 2-ROW 14P FP=2.54mm Sq
880400775 | TSM-107-02-S-DV | M | J4 | HEADER SMD 2-ROW 14P FP=2.54mm Sq
880400970 | TSM-114-02-S-DV | M | J10 | HEADER SMD 2-ROW 28P FP=2.54mm Sq
880300901 | TXS0102DCUR | M | U10 | IC 2-Bit Bidirectional Voltage-Level Translator for Open-Drain and Push-Pull SO-8
880400812 | USB-A-S_S-W-Th | M | J6 | CON USB TH TYPA A R.A
880300852 | W25Q128FVSG | UM | U3 | IC Memory SMD Quad / Dual SPI Flash 128Mbit 2.7-3.6V SOIC8
880300872 | W25Q256FVFI | M | U4 | IC Memory SMD Quad Flash 50MHz-SPI-QPI-Interface 256Mb 2.7V/3.6V SO-16
