Nuvoton-Israel/nuvoton-info/npcm7xx-poleg/RunBMC/board_deliverables/Nuvoton_RunBMC_Module/RunBMC_NPCM7mnx_schematics_A.1.0.pdf

# Nuvoton RunBMC NPCM7mnx-Based Module Reference Design

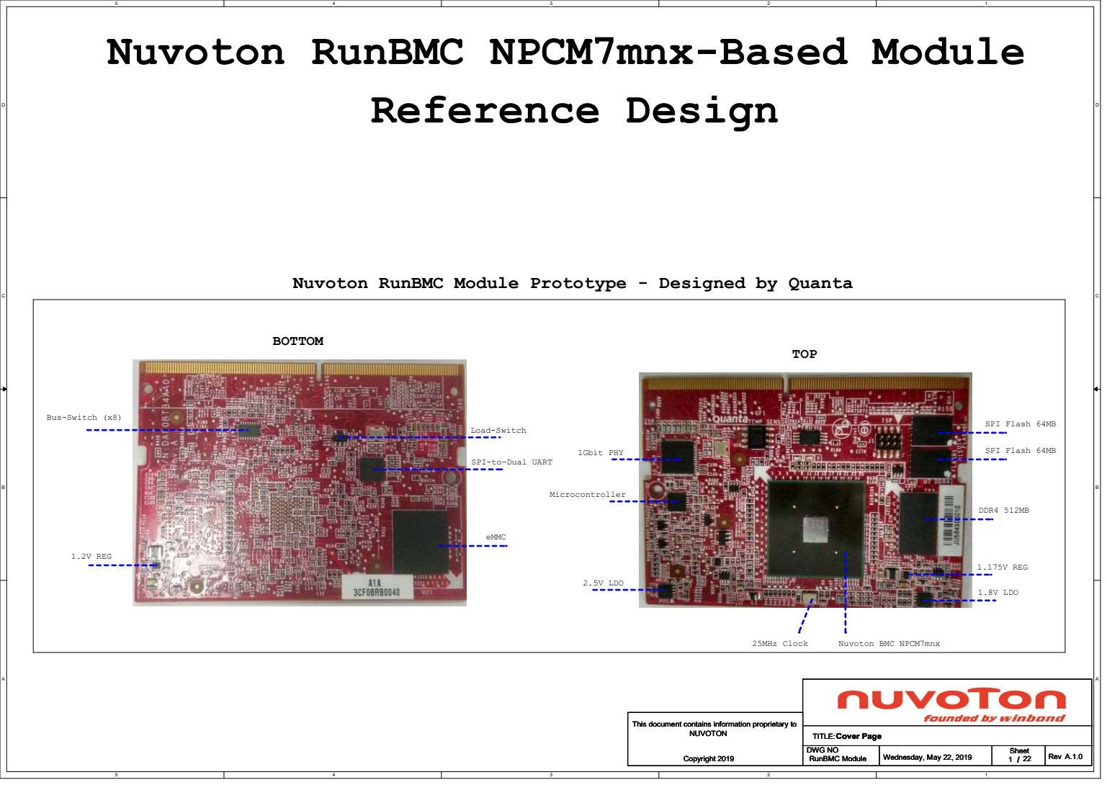
[picture p58: page 1]
Nuvoton BMC NPCM7mnx; DDR4 512MB; SPI Flash 64MB; 1Gbit PHY; Microcontroller; 25MHz Clock; eMMC; Bus-Switch (x8); Load-Switch; TOP; BOTTOM; 1.8V LDO; 2.5V LDO; 1.175V REG; 1.2V REG; DWG NO; Copyright 2019 NUVOTON; RunBMC Module; A.1.0 Cover Page; Wednesday, May 22, 2019; 22 DWG NO

Nuvoton RunBMC Module Prototype - Designed by Quanta

SPI-to-Dual UART

This document contains information proprietary to

Rev Sheet TITLE:

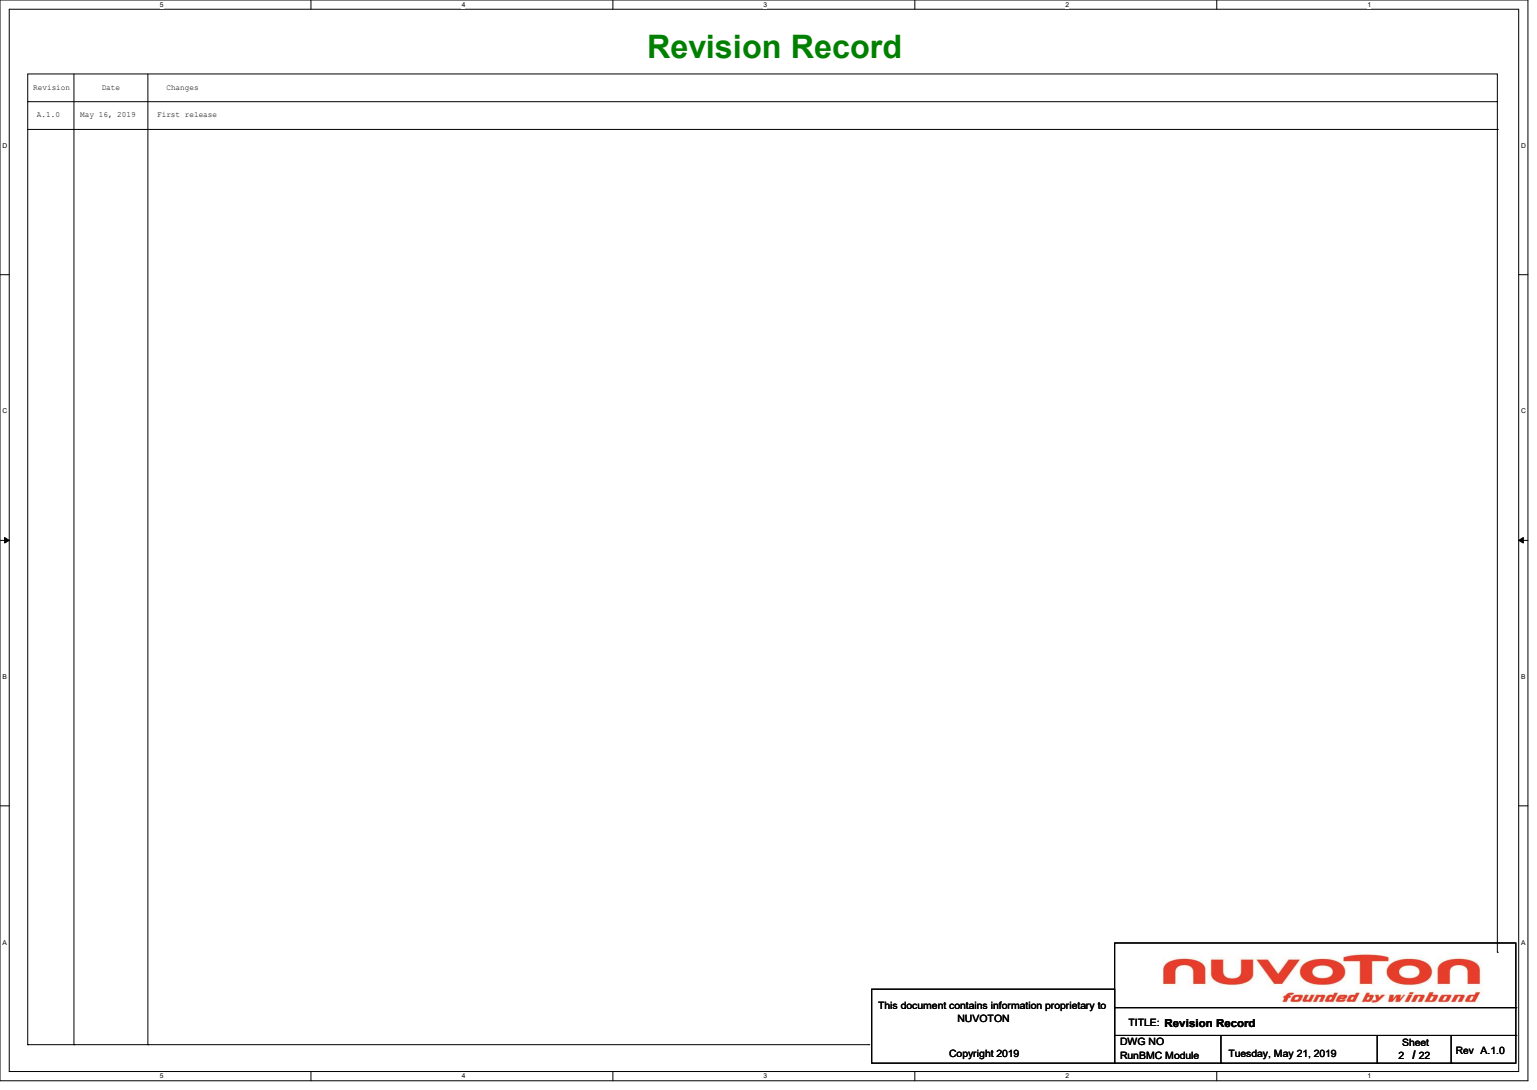
[picture p59: page 2]
Revision Record Revision; Changes; First release May 16, 2019; Date; Tuesday, May 21, 2019; 22 DWG NO

A.1.0 RunBMC Module Revision Record
DWG NO

# NPCM7mnx

# Connector I/F

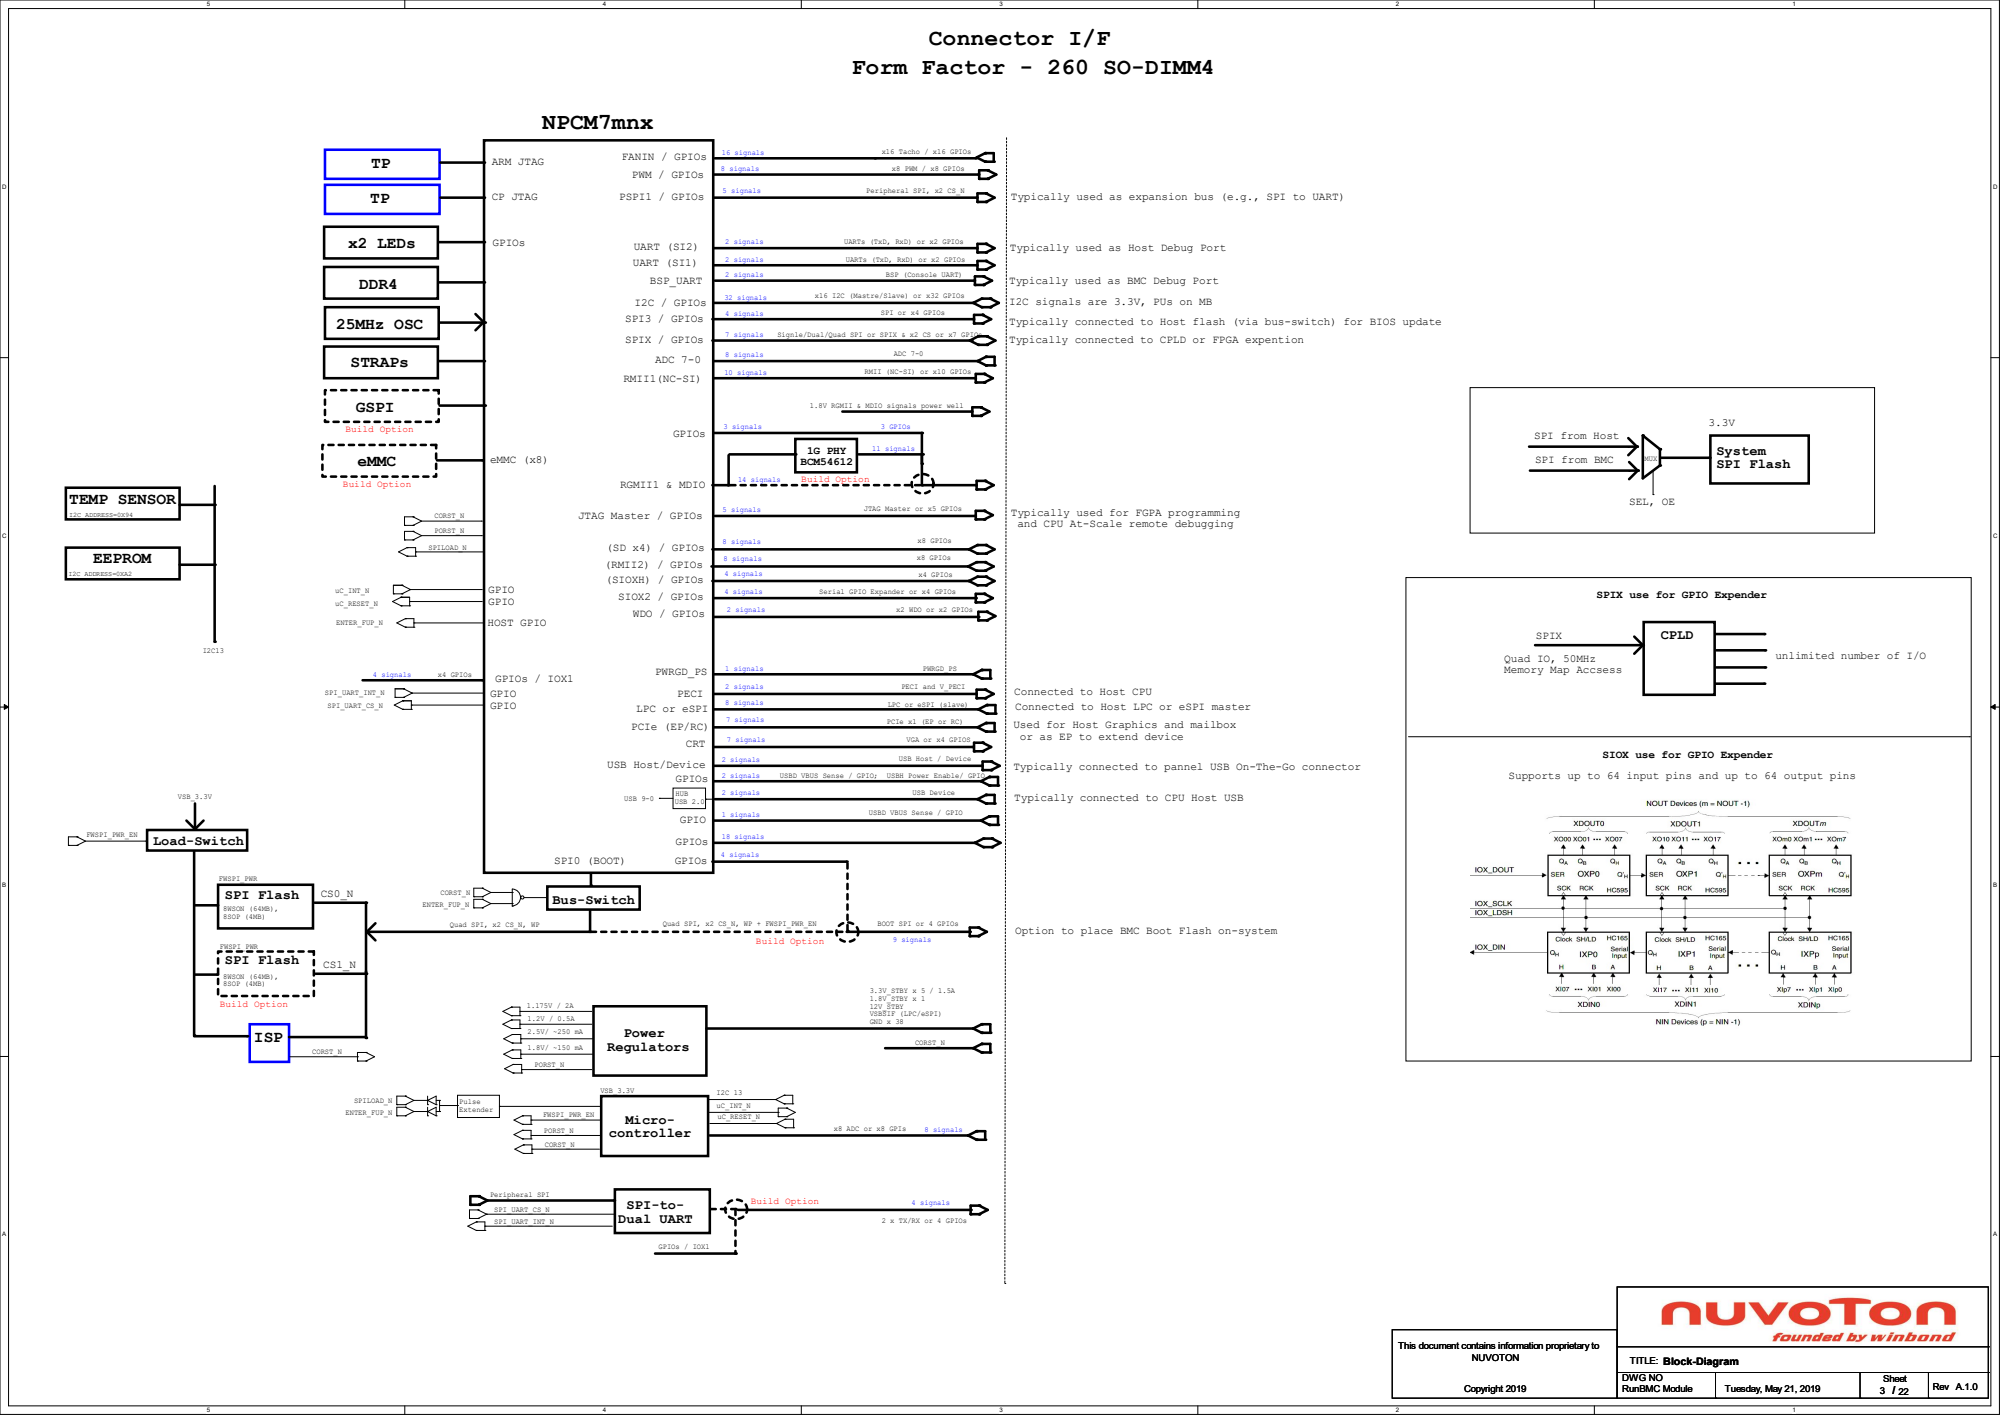
[picture p60: page 3]
RMII1(NC-SI); ADC 7-0; 10 signals; PCIe (EP/RC); 7 signals; FWSPI_PWR; VSB_3.3V; 4 signals SPI3 / GPIOs; 32 signals I2C / GPIOs; 2 signals UART (SI2); PSPI1 / GPIOs; HUB; 2 signals; USB 2.0 USB 9-0; 3.3V_STBY x 5 / 1.5A 1.8V_STBY x 1 12V_STBY VSBSIF (LPC/eSPI) GND x 38; BSP_UART; PWM / GPIOs; 16 signals; USB Device; 5 signals; 8 signals; 25MHz OSC; SPI0 (BOOT); 9 signals; SPI Flash; Build Option; Bus-Switch; Load-Switch; DDR4; System SPI Flash; Power Regulators; Micro- controller PORST_N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

Form Factor - 260 SO-DIMM4

FANIN / GPIOs 8 signals

Typically used as expansion bus (e.g., SPI to UART)

Typically used as BMC Debug Port
I2C signals are 3.3V, PUs on MB
Typically connected to Host flash (via bus-switch) for BIOS update

x16 I2C (Mastre/Slave) or x32 GPIOs

SPI or x4 GPIOs

RMII (NC-SI) or x10 GPIOs

1.8V RGMII & MDIO signals power well

SPI from Host
SPI from BMC

JTAG Master / GPIOs

Typically used for FGPA programming
and CPU At-Scale remote debugging

SPIX use for GPIO Expender

Quad IO, 50MHz
Memory Map Accsess

unlimited number of I/O

Connected to Host CPU

PCIe x1 (EP or RC)

Used for Host Graphics and mailbox
or as EP to extend device

SIOX use for GPIO Expender

2 signals USB Host/Device

USB Host / Device

Typically connected to pannel USB On-The-Go connector

Typically connected to CPU Host USB

Quad SPI, x2 CS_N, WP

Quad SPI, x2 CS_N, WP + FWSPI_PWR_EN

BOOT SPI or 4 GPIOs

Option to place BMC Boot Flash on-system

x8 ADC or x8 GPIs

2 x TX/RX or 4 GPIOs

/ This document contains information proprietary to Copyright 2019 NUVOTON

# 0201 C¹³ 0.1uF 0201 C27

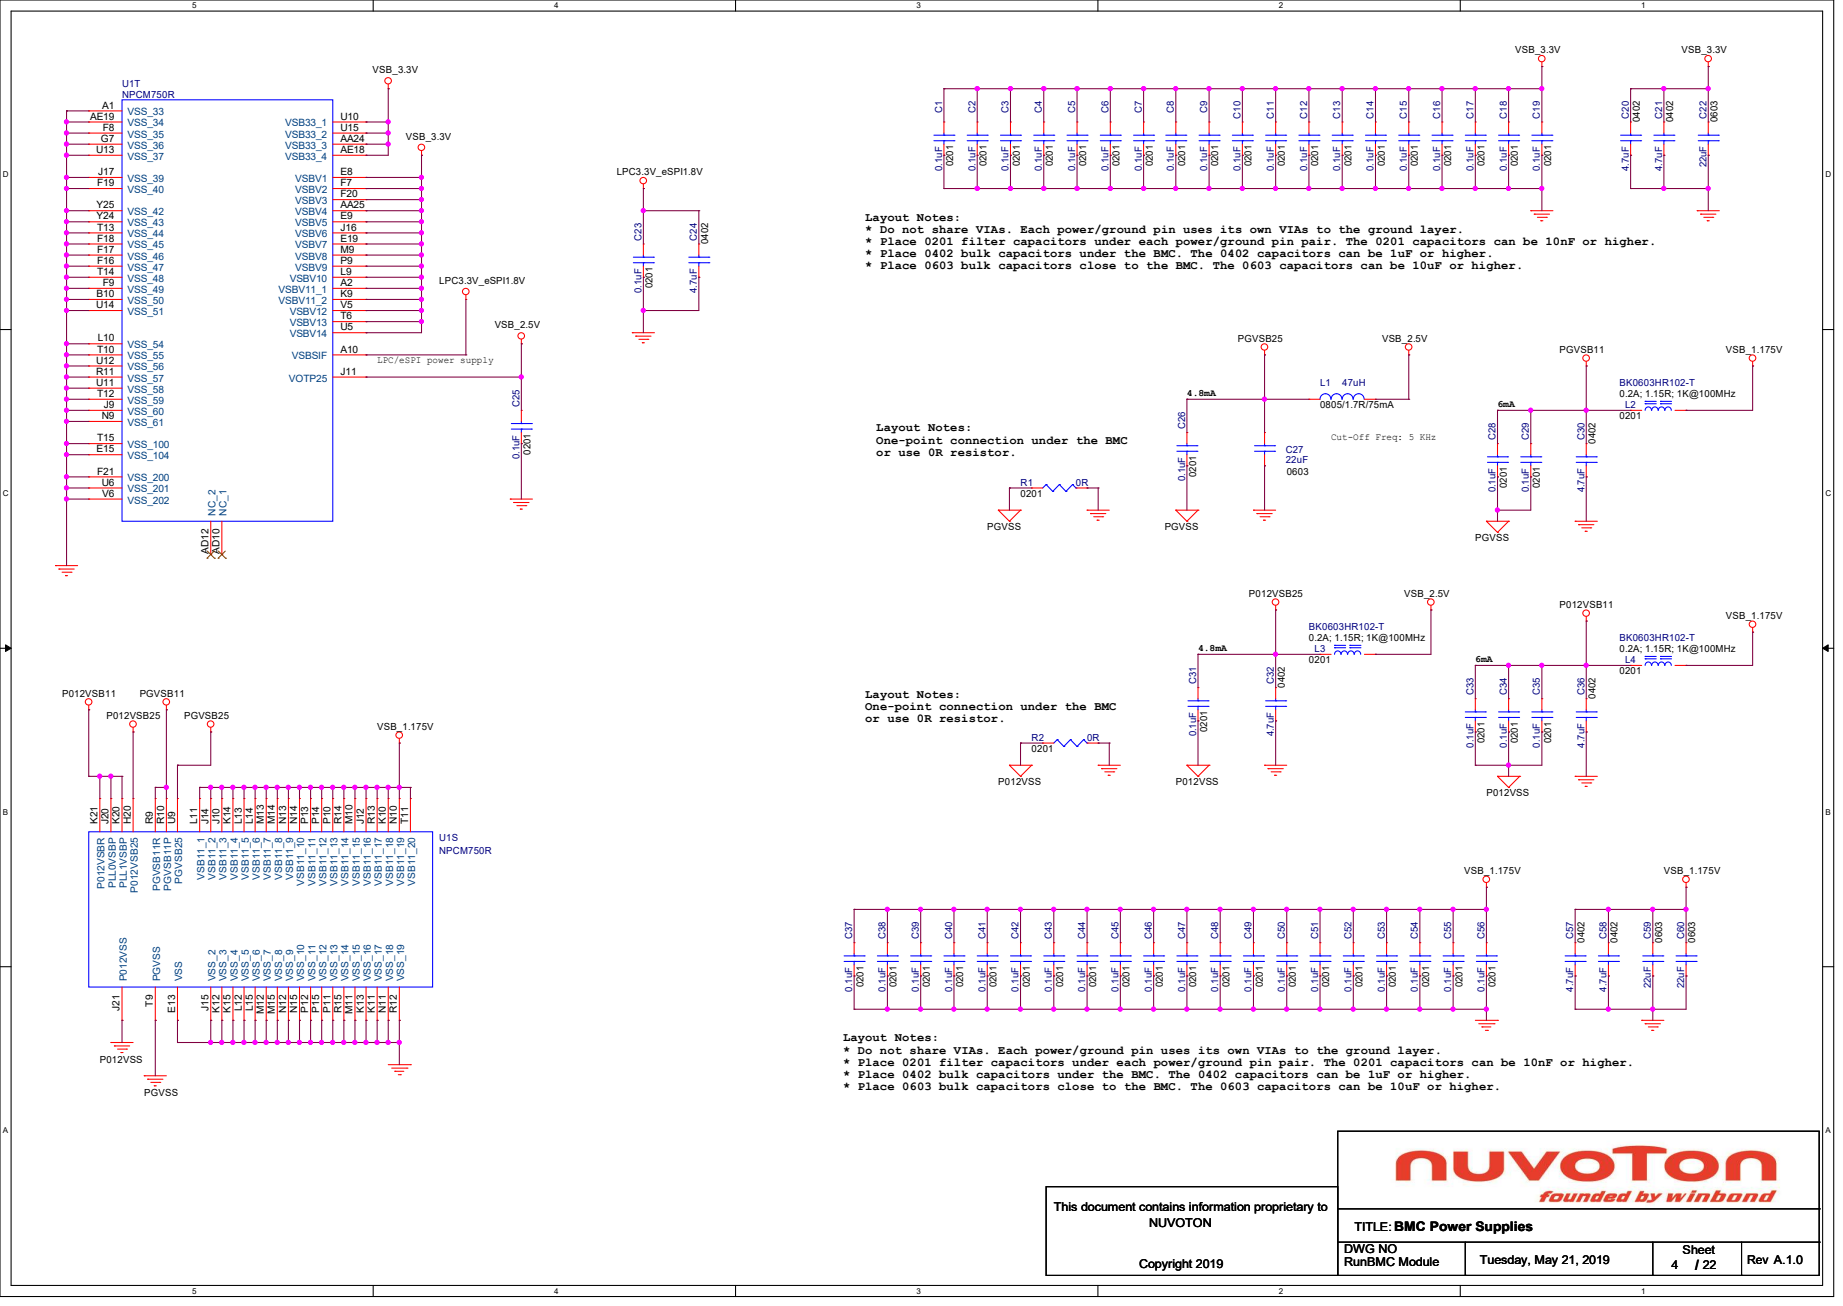
[picture p61: page 4]

Layout Notes:
* Do not share VIAs. Each power/ground pin uses its own VIAs to the ground layer.
* Place 0201 filter capacitors under each power/ground pin pair. The 0201 capacitors can be 10nF or higher.
* Place 0402 bulk capacitors under the BMC. The 0402 capacitors can be 1uF or higher.
* Place 0603 bulk capacitors close to the BMC. The 0603 capacitors can be 10uF or higher.

LPC/eSPI power supply

One-point connection under the BMC
or use 0R resistor.

* Place 0603 bulk capacitors close to the BMC. The 0603 capacitors can be 10uF or higher. VSB_1.175V

# Clock and Resets

0201 24.9R | R7 C⁶⁵ 4.7uF 0402 | U3 ECS-2520MV-250-CN-TR

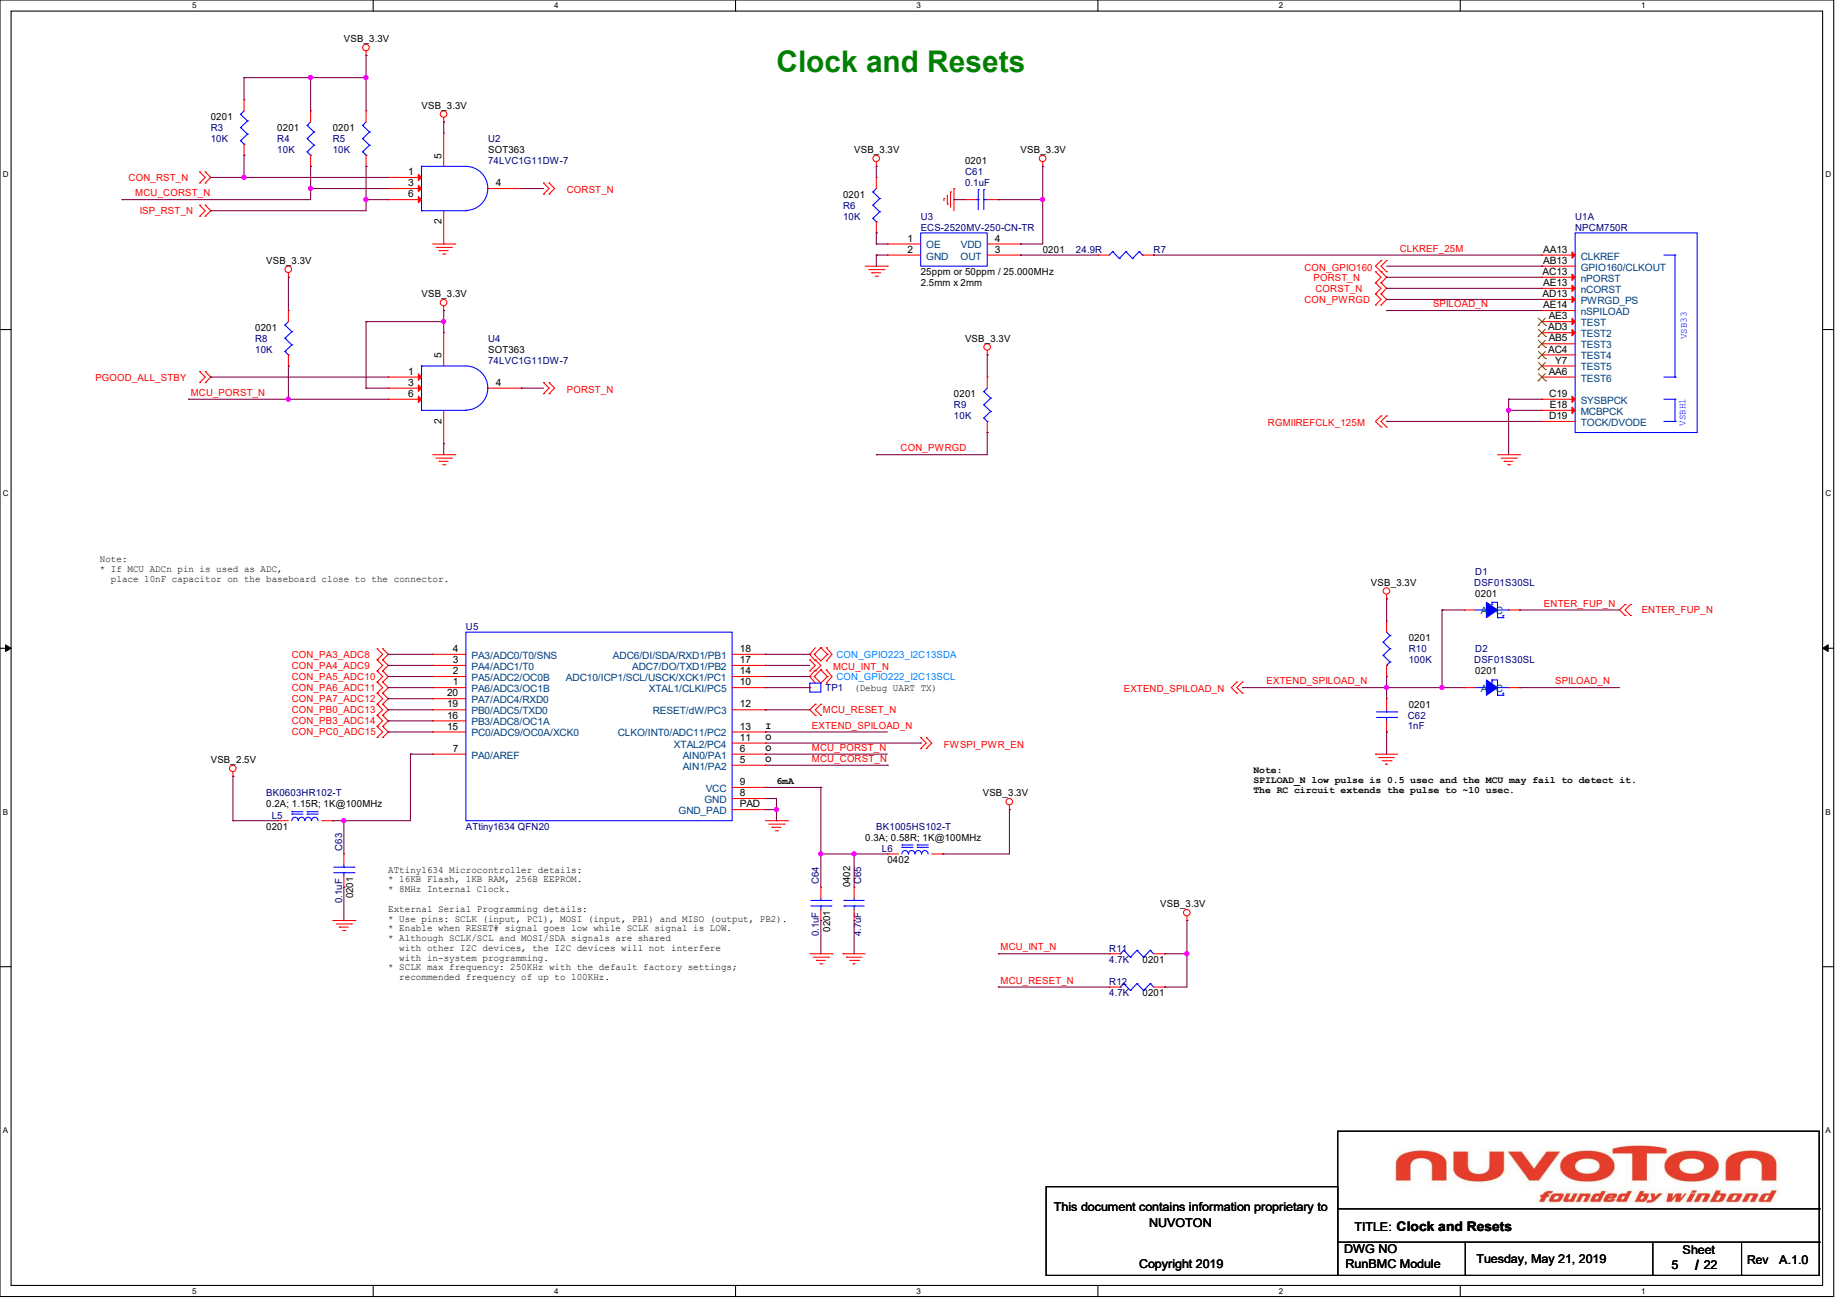
[picture p62: page 5]

nCORST AE13 PWRGD_PS AD13 TEST AE3 nSPILOAD AE14 SYSBPCK C19 MCBPCK E18 TOCK/DVODE D19 TEST6 AA6 TEST5 Y7 TEST4 AC4 TEST3 AB5 TEST2 AD3 C⁶⁴ 0.1uF 0201
CORST_N MCU_INT_N MCU_RESET_N
SPILOAD_N MCU_PORST_N MCU_CORST_N

Note:
* If MCU ADCn pin is used as ADC,
place 10nF capacitor on the baseboard close to the connector.

SPILOAD_N low pulse is 0.5 usec and the MCU may fail to detect it.
The RC circuit extends the pulse to ~10 usec.

ATtiny1634 Microcontroller details:
* 16KB Flash, 1KB RAM, 256B EEPROM.
* 8MHz Internal Clock.
External Serial Programming details:
* Use pins: SCLK (input, PC1), MOSI (input, PB1) and MISO (output, PB2).
* Enable when RESET# signal goes low while SCLK signal is LOW.
* Although SCLK/SCL and MOSI/SDA signals are shared
with other I2C devices, the I2C devices will not interfere
with in-system programming.
* SCLK max frequency: 250KHz with the default factory settings;
recommended frequency of up to 100KHz.

## SDRAM (DDR4-2400) 8Gbit (256Mbit x 16) Device

DDR4 | BMC DDR4 Interface

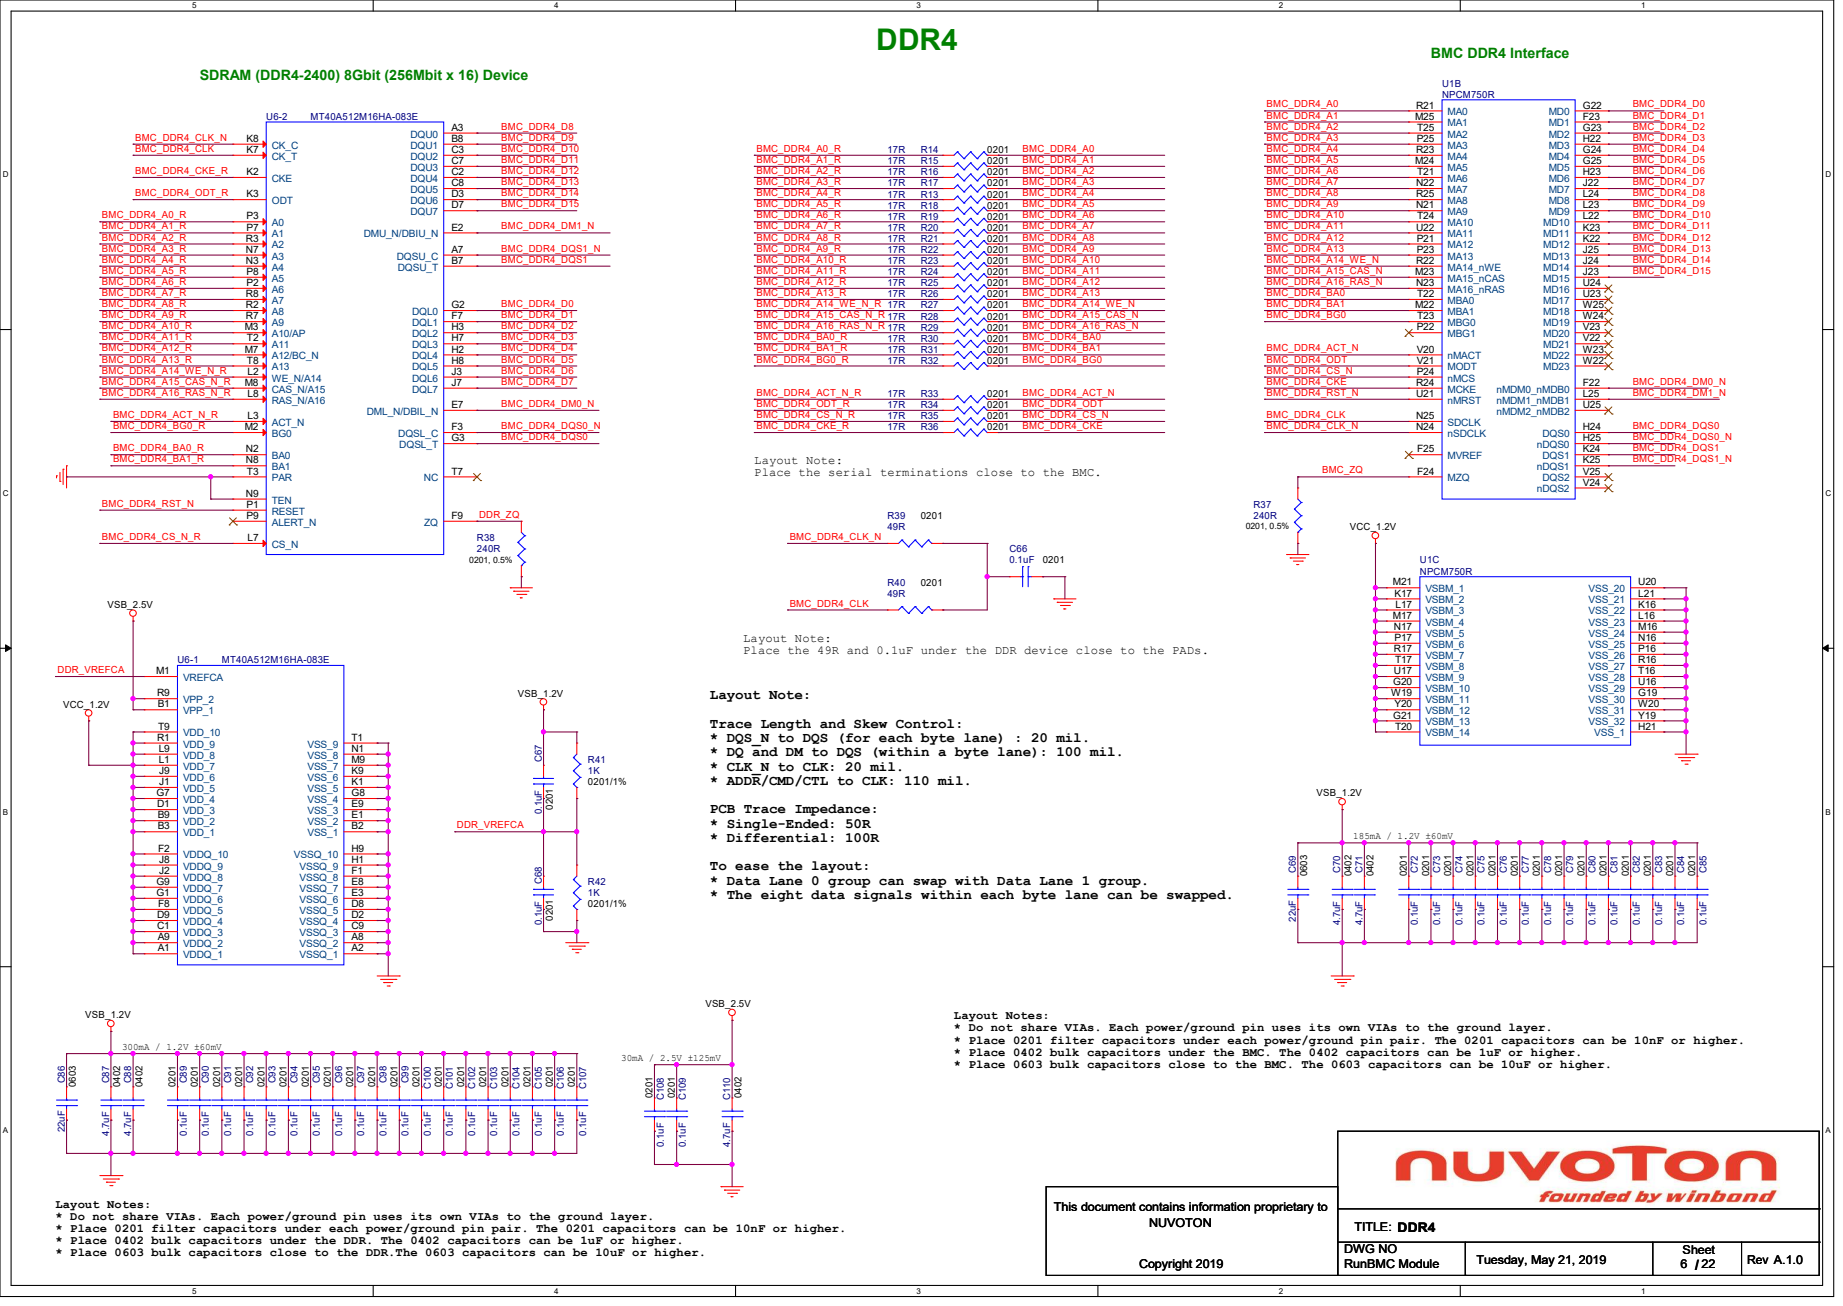
[picture p63: page 6]

Layout Note:
Place the serial terminations close to the BMC.

Place the 49R and 0.1uF under the DDR device close to the PADs.

Trace Length and Skew Control:
* DQS_N to DQS (for each byte lane) : 20 mil.
* DQ and DM to DQS (within a byte lane): 100 mil.
* CLK_N to CLK: 20 mil.
* ADDR/CMD/CTL to CLK: 110 mil.
PCB Trace Impedance:
* Single-Ended: 50R
* Differential: 100R
To ease the layout:
* Data Lane 0 group can swap with Data Lane 1 group.
* The eight data signals within each byte lane can be swapped.

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

* Place 0402 bulk capacitors under the DDR. The 0402 capacitors can be 1uF or higher.
* Place 0603 bulk capacitors close to the DDR.The 0603 capacitors can be 10uF or higher.

# PCIe

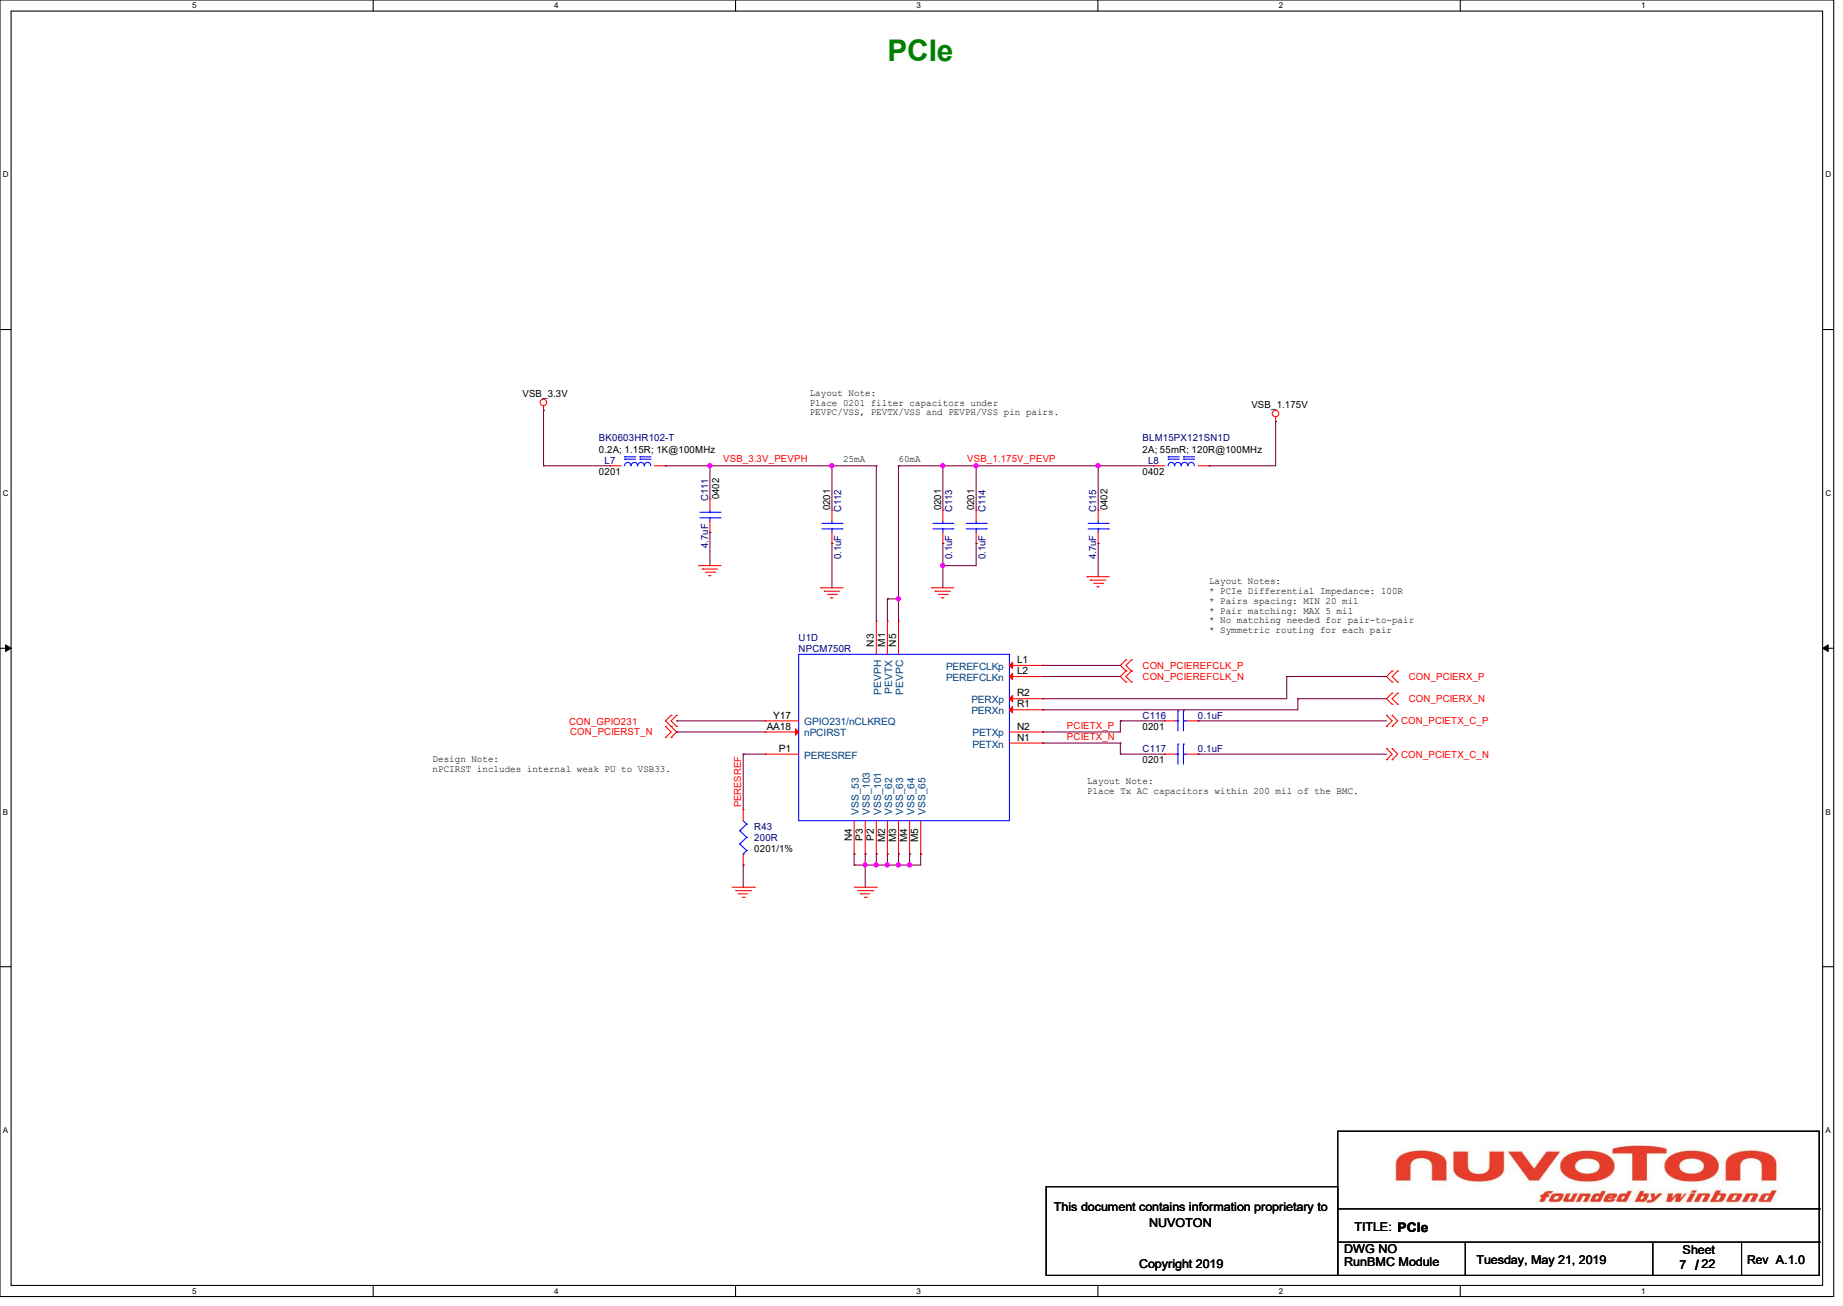
[picture p64: page 7]

Place 0201 filter capacitors under
PEVPC/VSS, PEVTX/VSS and PEVPH/VSS pin pairs.

Layout Notes:
* PCIe Differential Impedance: 100R
* Pairs spacing: MIN 20 mil
* Pair matching: MAX 5 mil
* No matching needed for pair-to-pair
* Symmetric routing for each pair

0201 NPCM750R
PETXp N2 PETXn N1 PERXp R2 PERXn R1 PEREFCLKp L1 PEREFCLKn L2 PERESREF P1

Design Note:
nPCIRST includes internal weak PU to VSB33.

Layout Note:
Place Tx AC capacitors within 200 mil of the BMC.

CRT Interface | Layout Note:

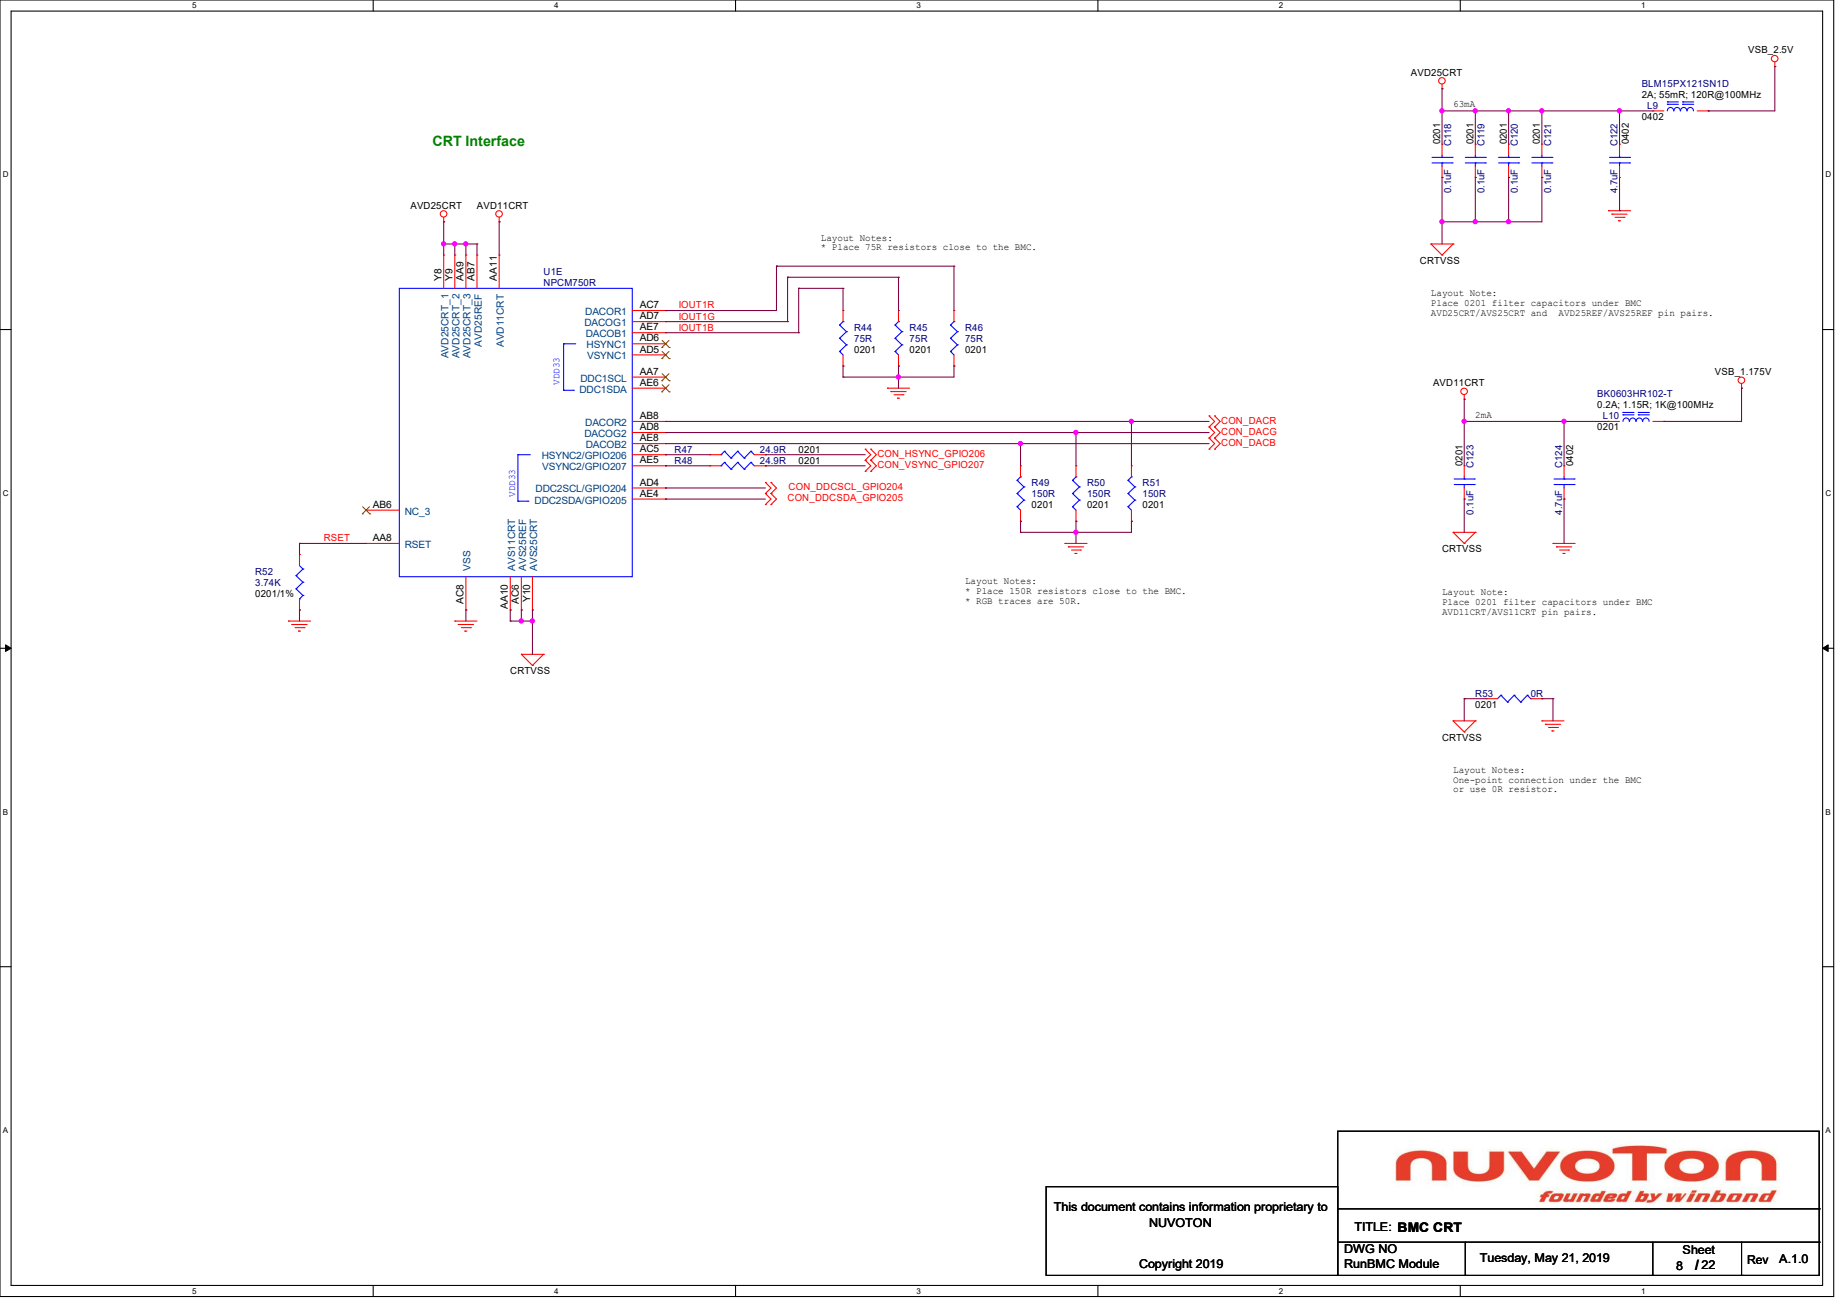
[picture p65: page 8]

Layout Notes:
* Place 75R resistors close to the BMC.

Place 0201 filter capacitors under BMC
AVD25CRT/AVS25CRT and AVD25REF/AVS25REF pin pairs.

* Place 150R resistors close to the BMC.
* RGB traces are 50R.

Layout Note:
AVD11CRT/AVS11CRT pin pairs.

One-point connection under the BMC
or use 0R resistor.

A.1.0 RunBMC Module BMC CRT

## I2C Interface I2C Interface

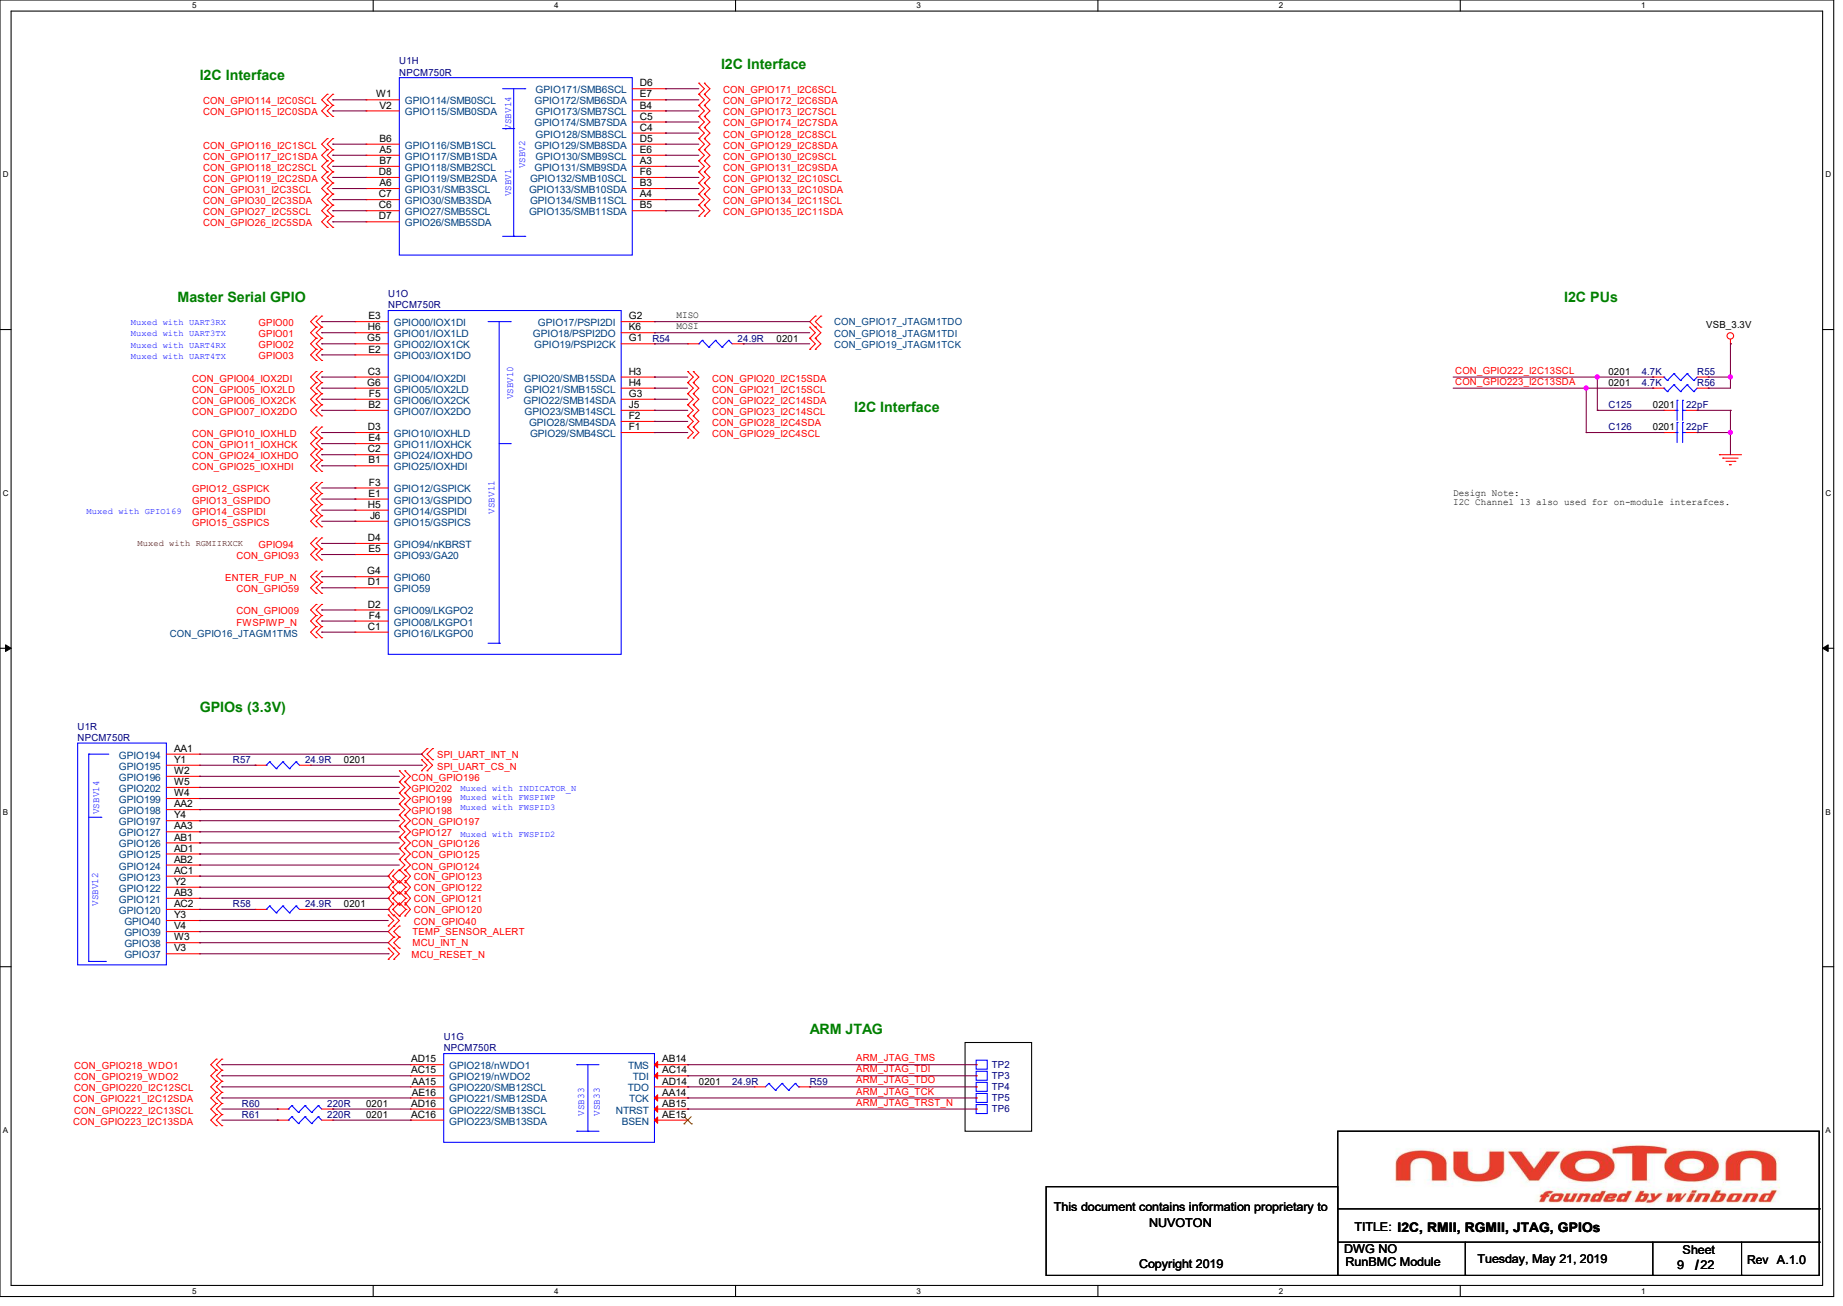
[picture p66: page 9]

GPIO00/IOX1DI E3 GPIO01/IOX1LD H6 GPIO02/IOX1CK G5 GPIO03/IOX1DO E2 GPIO04/IOX2DI C3 GPIO05/IOX2LD G6 GPIO06/IOX2CK F5 GPIO07/IOX2DO B2 GPIO08/LKGPO1 F4 GPIO09/LKGPO2 D2 GPIO10/IOXHLD D3 GPIO11/IOXHCK E4 GPIO12/GSPICK F3 GPIO13/GSPIDO E1 GPIO14/GSPIDI H5 GPIO15/GSPICS J6 GPIO16/LKGPO0 C1

I2C Channel 13 also used for on-module interafces.

TMS AB14 TDI AC14 TDO AD14 TCK AA14 NTRST AB15 BSEN AE15 GPIO218/nWDO1 AD15 GPIO219/nWDO2 AC15 GPIO220/SMB12SCL AA15 GPIO221/SMB12SDA AE16 GPIO222/SMB13SCL AD16 GPIO223/SMB13SDA AC16 VSBV12 VSBV14 NPCM750R

I2C, RMII, RGMII, JTAG, GPIOs

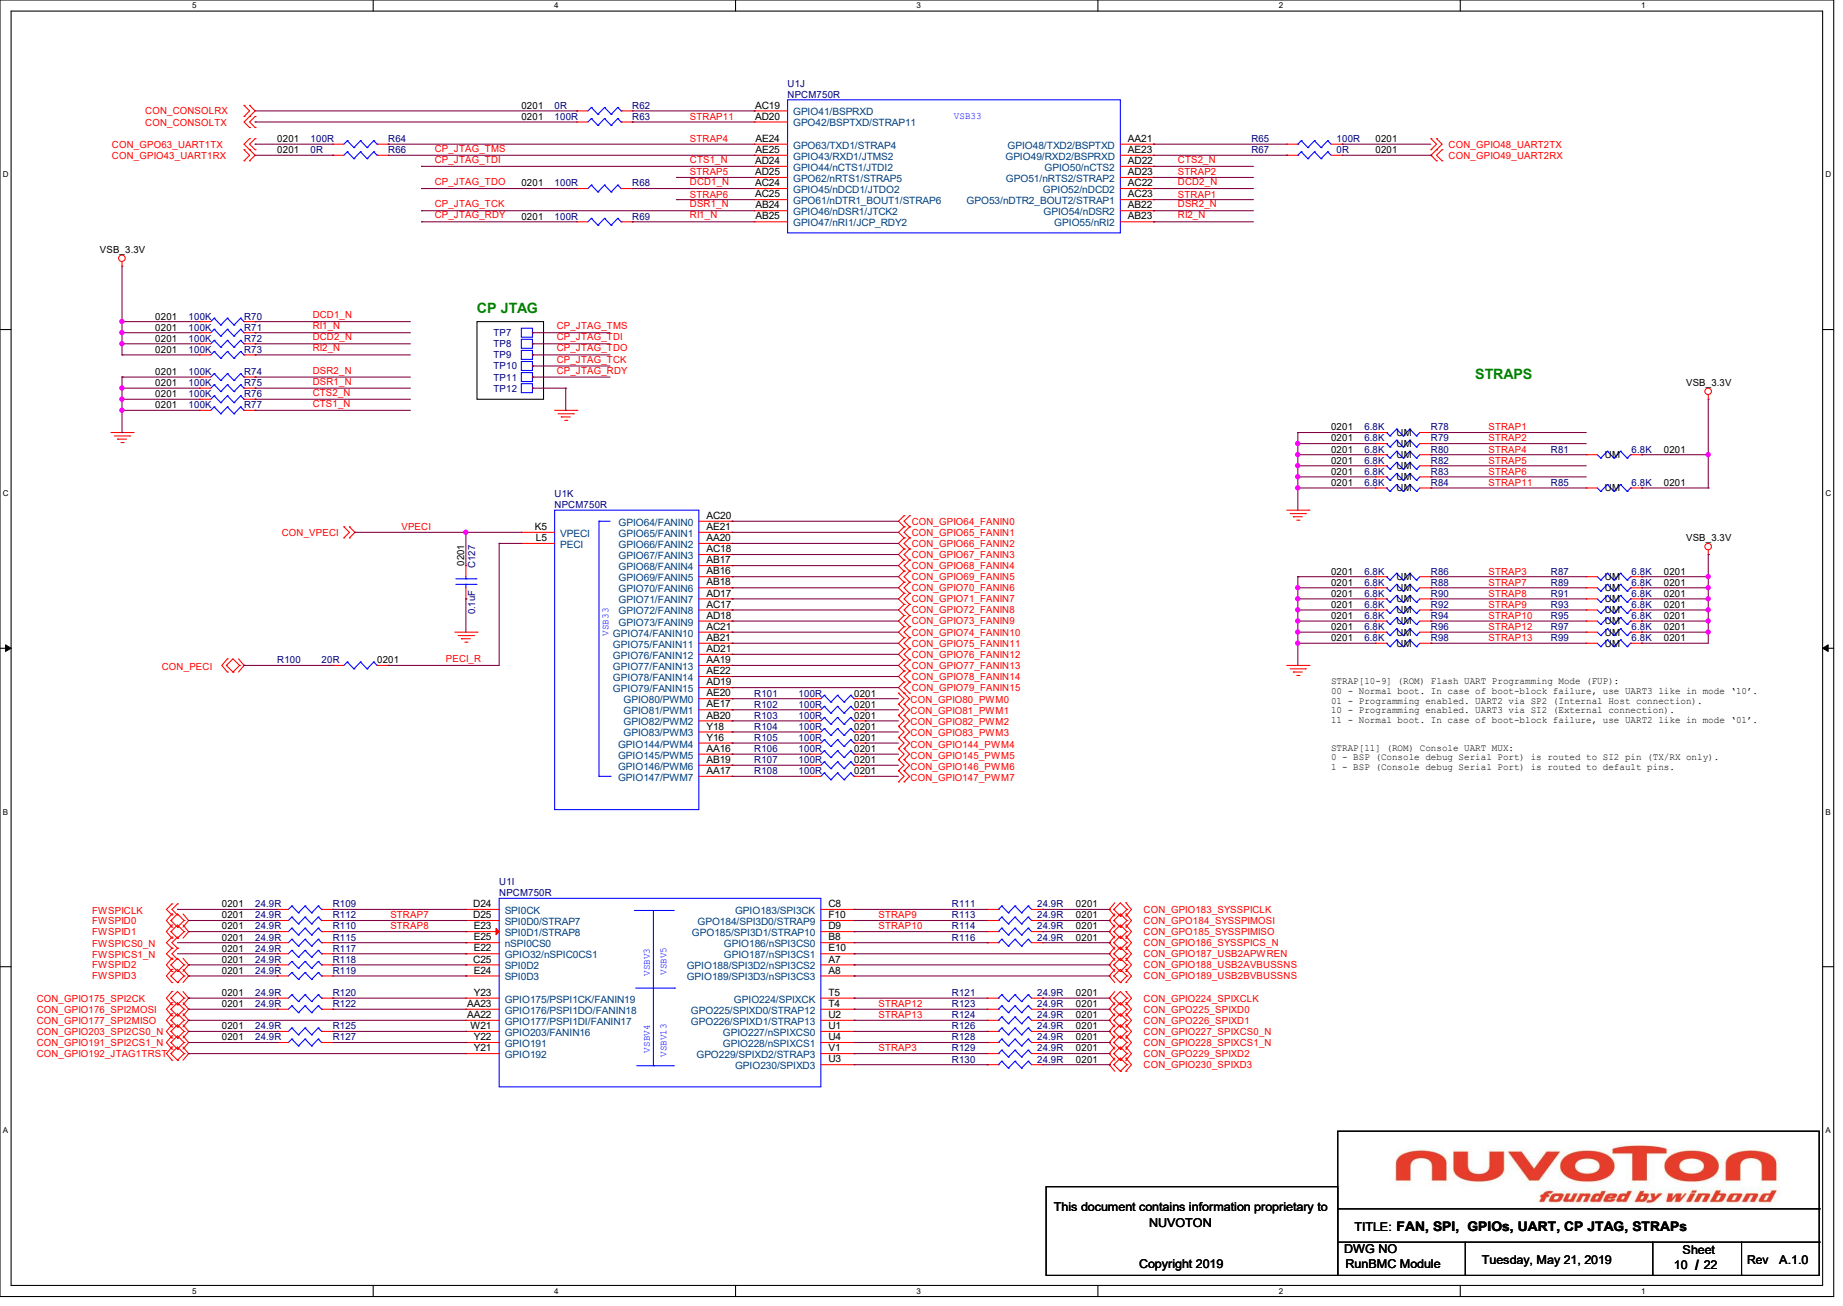
[picture p67: page 10]

STRAP[10-9] (ROM) Flash UART Programming Mode (FUP):
00 - Normal boot. In case of boot-block failure, use UART3 like in mode ‘10’.
01 - Programming enabled. UART2 via SP2 (Internal Host connection).
10 - Programming enabled. UART3 via SI2 (External connection).
11 - Normal boot. In case of boot-block failure, use UART2 like in mode ‘01’.

STRAP[11] (ROM) Console UART MUX:
0 - BSP (Console debug Serial Port) is routed to SI2 pin (TX/RX only).
1 - BSP (Console debug Serial Port) is routed to default pins.

## LPC / eSPI

R133 | 24.9R 0201 | C¹²⁹ 0.1uF 0201

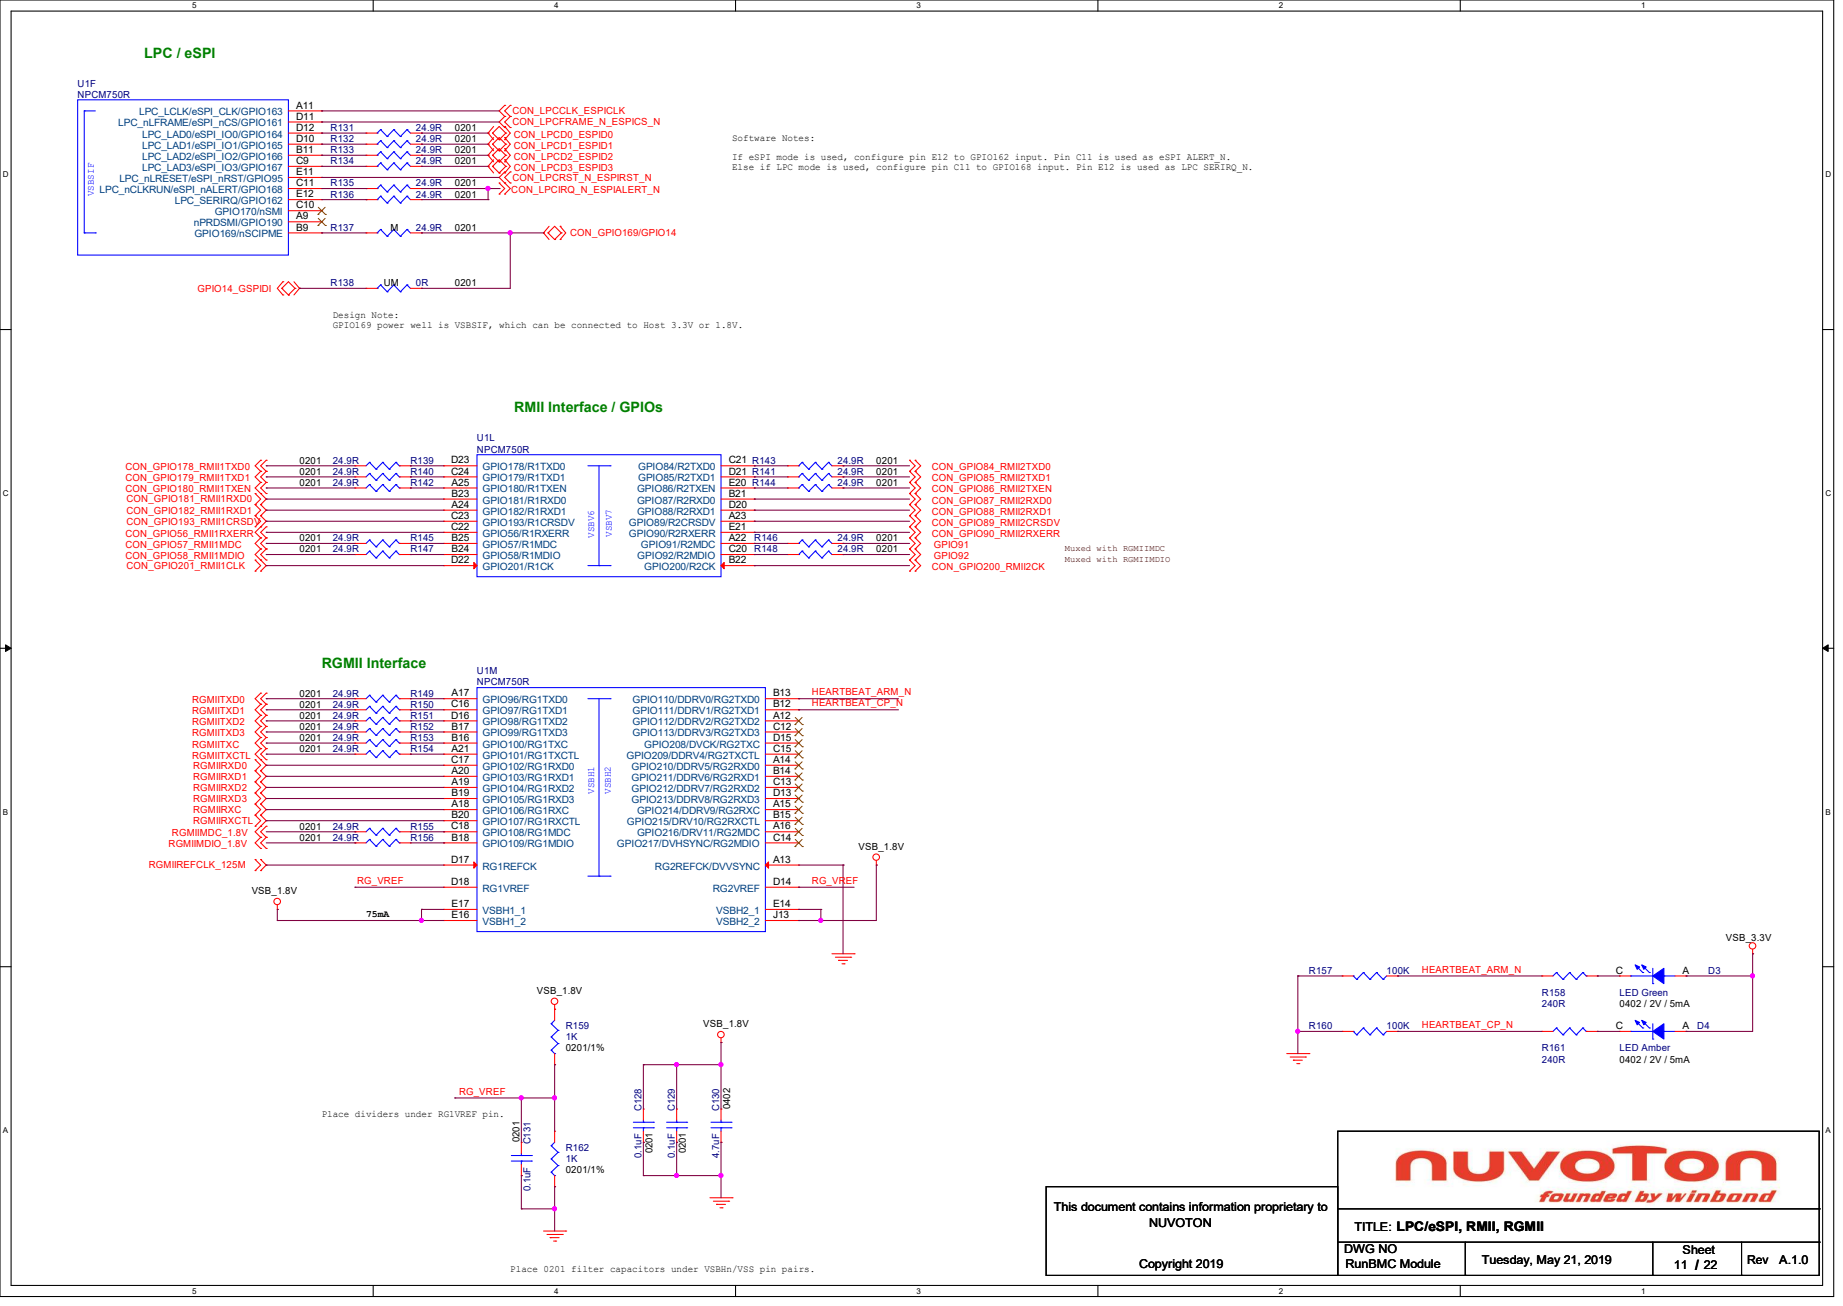
[picture p68: page 11]

Software Notes:
If eSPI mode is used, configure pin E12 to GPIO162 input. Pin C11 is used as eSPI ALERT_N.
Else if LPC mode is used, configure pin C11 to GPIO168 input. Pin E12 is used as LPC SERIRQ_N.

Design Note:
GPIO169 power well is VSBSIF, which can be connected to Host 3.3V or 1.8V.

Place dividers under RG1VREF pin.

Place 0201 filter capacitors under VSBHn/VSS pin pairs.

## Embedded MultiMediaCard (eMMC) VSB_3.3V

# Tuesday, May 21, 2019 12 22 C¹³⁵ 0.1uF 0201

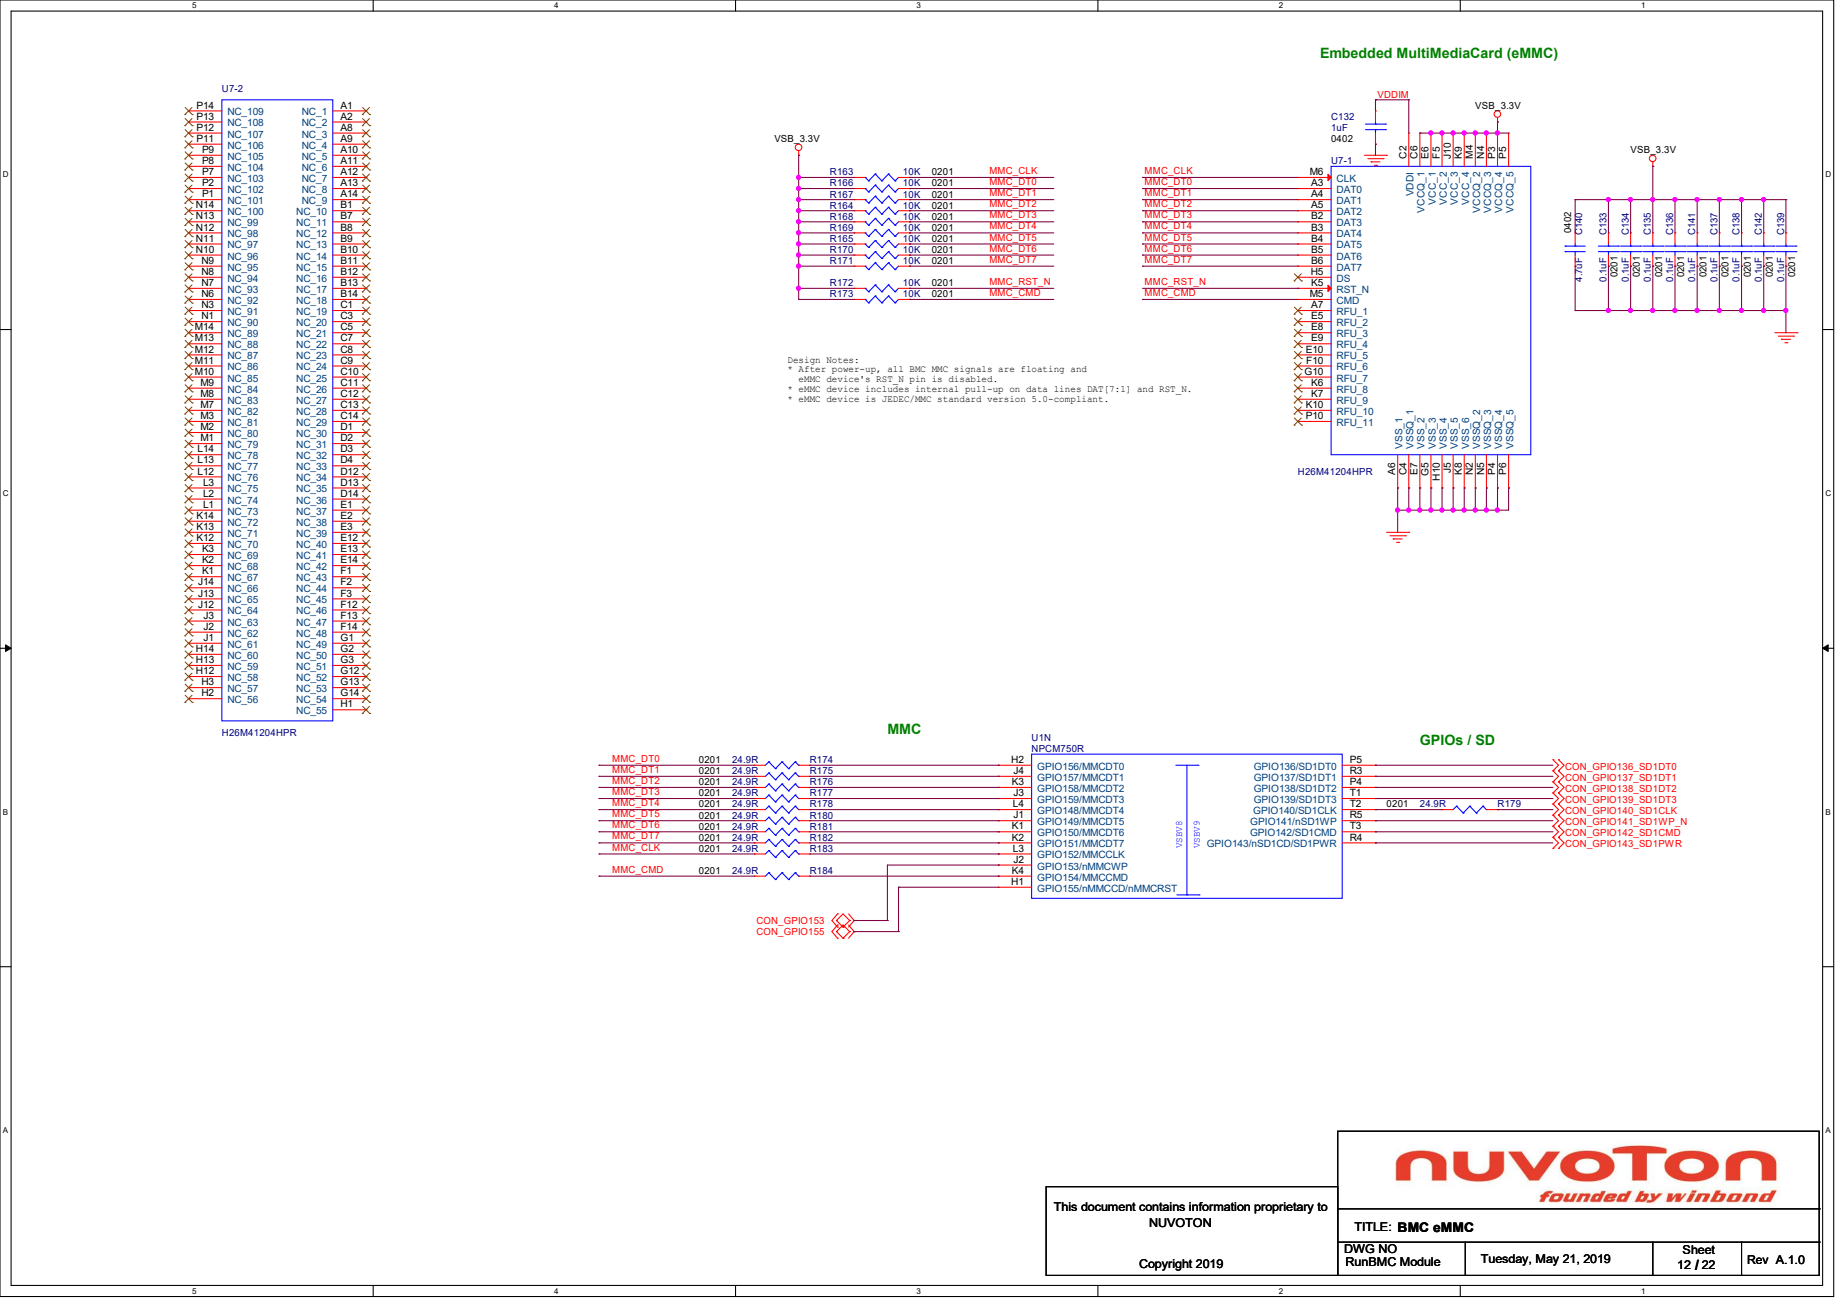
[picture p69: page 12]

Design Notes:
* After power-up, all BMC MMC signals are floating and
eMMC device's RST_N pin is disabled.
* eMMC device includes internal pull-up on data lines DAT[7:1] and RST_N.
* eMMC device is JEDEC/MMC standard version 5.0-compliant.

# ADC 7-0 ADVSS

# ADVSB25 ADVSS

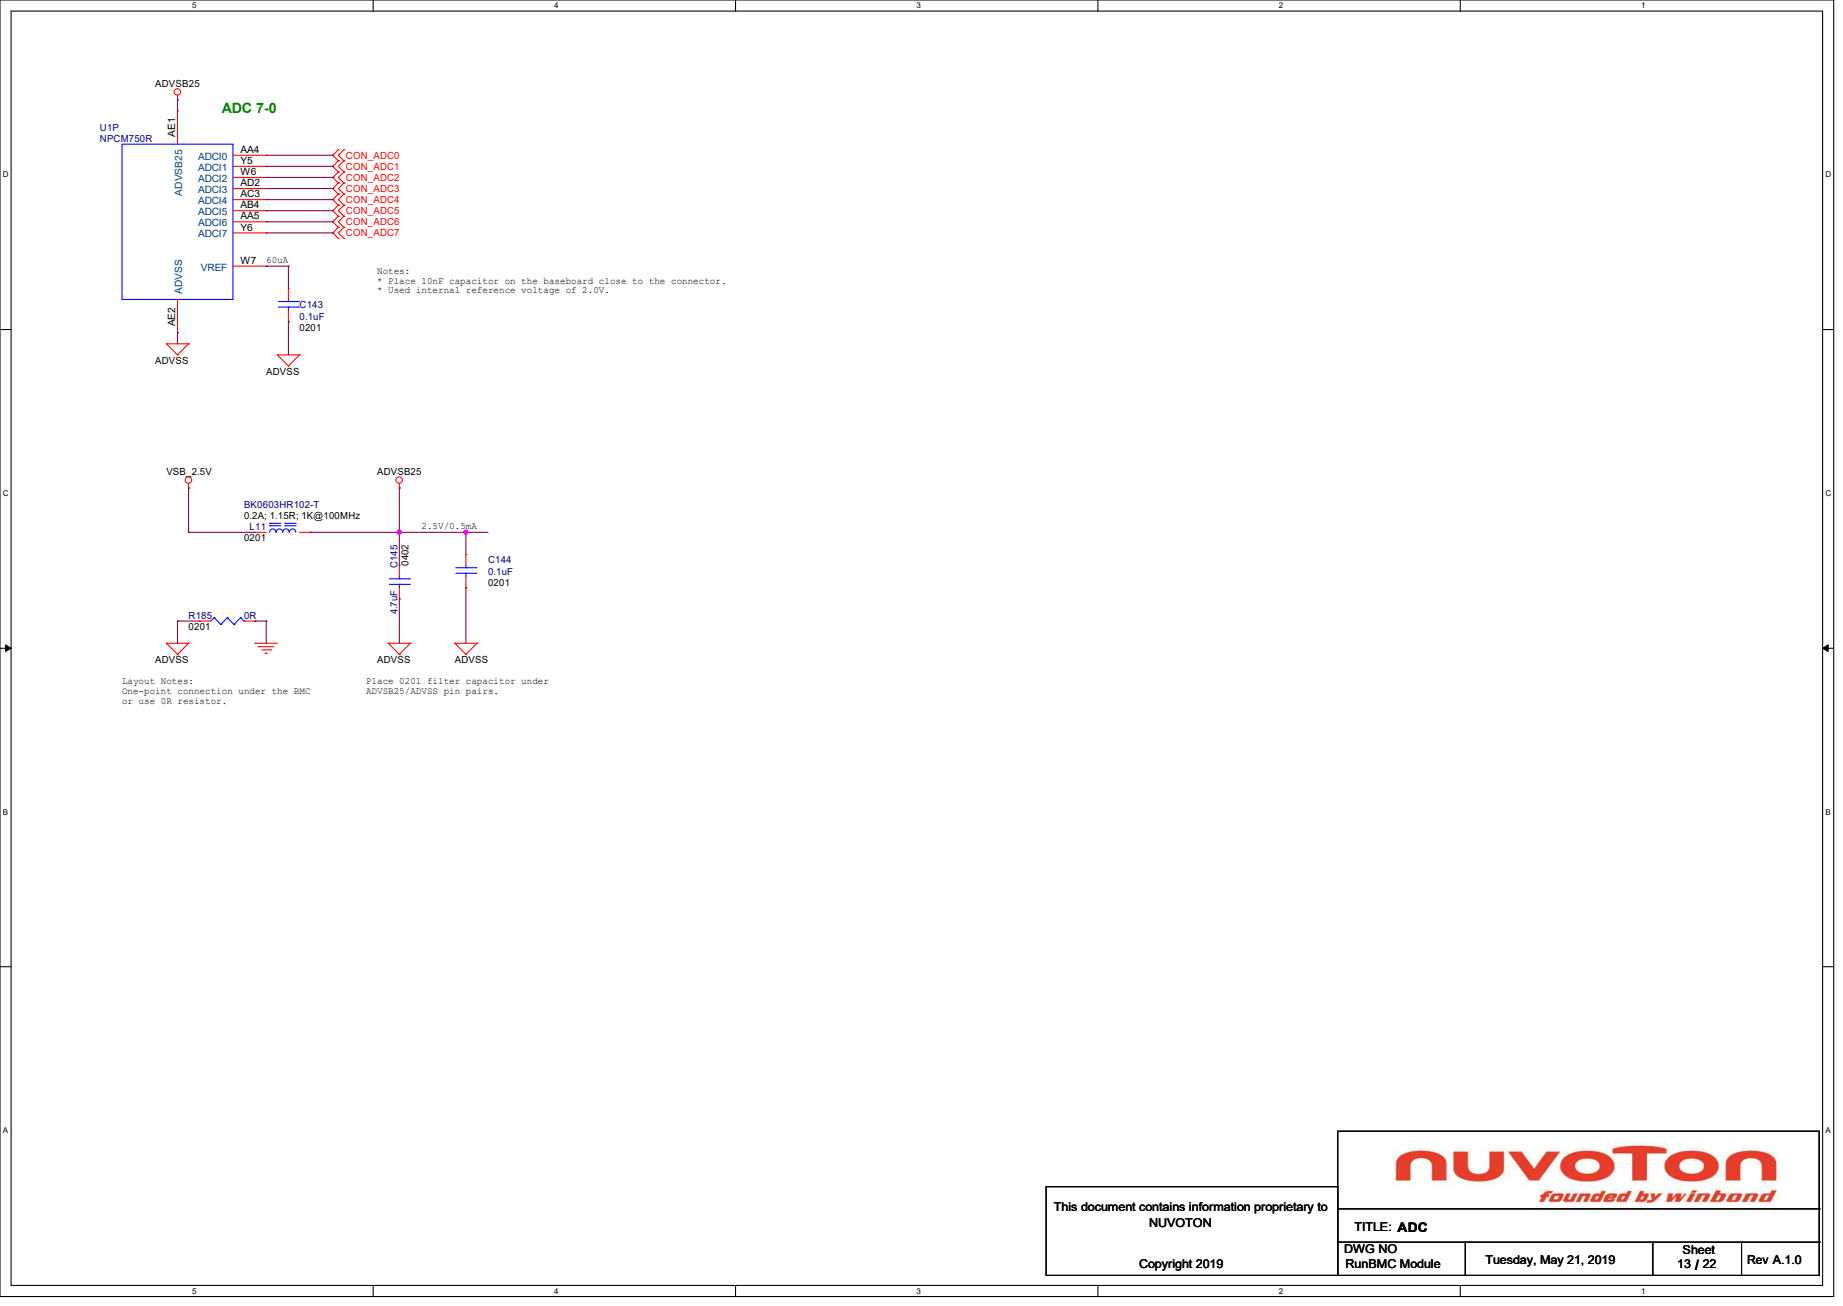
[picture p70: page 13]
VSB_2.5V; ADVSB25 ADVSS; ADVSS; CON_ADC0 CON_ADC1 CON_ADC2 CON_ADC3 CON_ADC4 CON_ADC5 CON_ADC7 CON_ADC6; RunBMC Module; A.1.0 ADC; Tuesday, May 21, 2019; 13 22 DWG NO; 0.2A; 1.15R; 1K@100MHz C143 0.1uF 0201 C144; 0201 C¹⁴⁵ 4.7uF 0402; NPCM750R; ADCI0 AA4 ADCI1 Y5 ADCI2 W6 ADCI3 AD2 ADCI4 AC3 ADCI5 AB4 ADCI6 AA5 ADCI7 Y6 VREF W7 ADVSB²⁵ AE¹ ADVSS AE²

Notes:
* Place 10nF capacitor on the baseboard close to the connector.
* Used internal reference voltage of 2.0V.

Layout Notes:
One-point connection under the BMC
or use 0R resistor.

Place 0201 filter capacitor under
ADVSB25/ADVSS pin pairs.

0201 C146

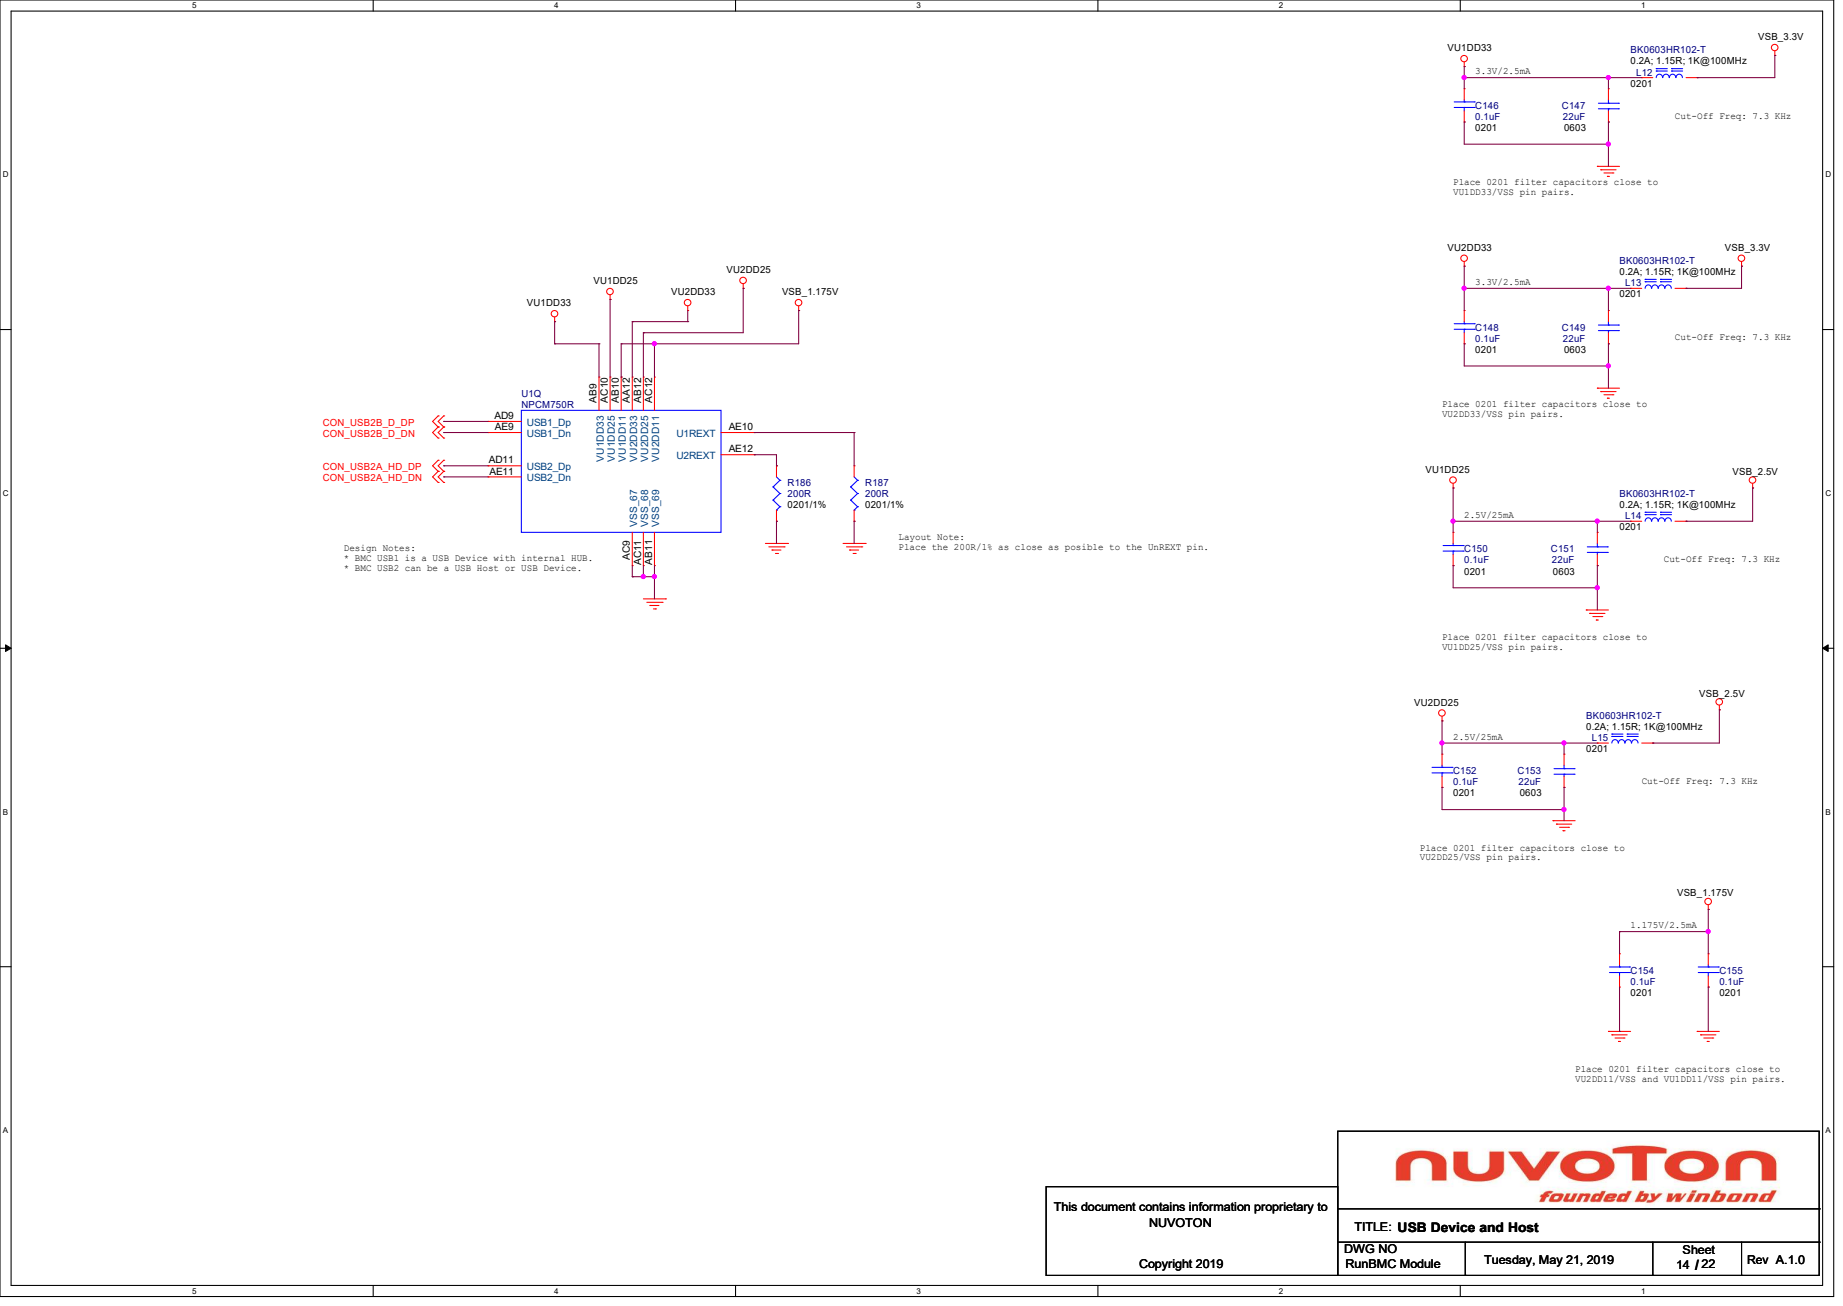
[picture p71: page 14]

Cut-Off Freq: 7.3 KHz

Place 0201 filter capacitors close to
VU1DD33/VSS pin pairs.

VU2DD33/VSS pin pairs.

Layout Note:
Place the 200R/1% as close as posible to the UnREXT pin.

Design Notes:
* BMC USB1 is a USB Device with internal HUB.

VU1DD25/VSS pin pairs.

VU2DD25/VSS pin pairs.

A A Place 0201 filter capacitors close to

VU2DD11/VSS and VU1DD11/VSS pin pairs.

## MDIO Signals Voltage Level-Shifter

## 1 Gbit PHY

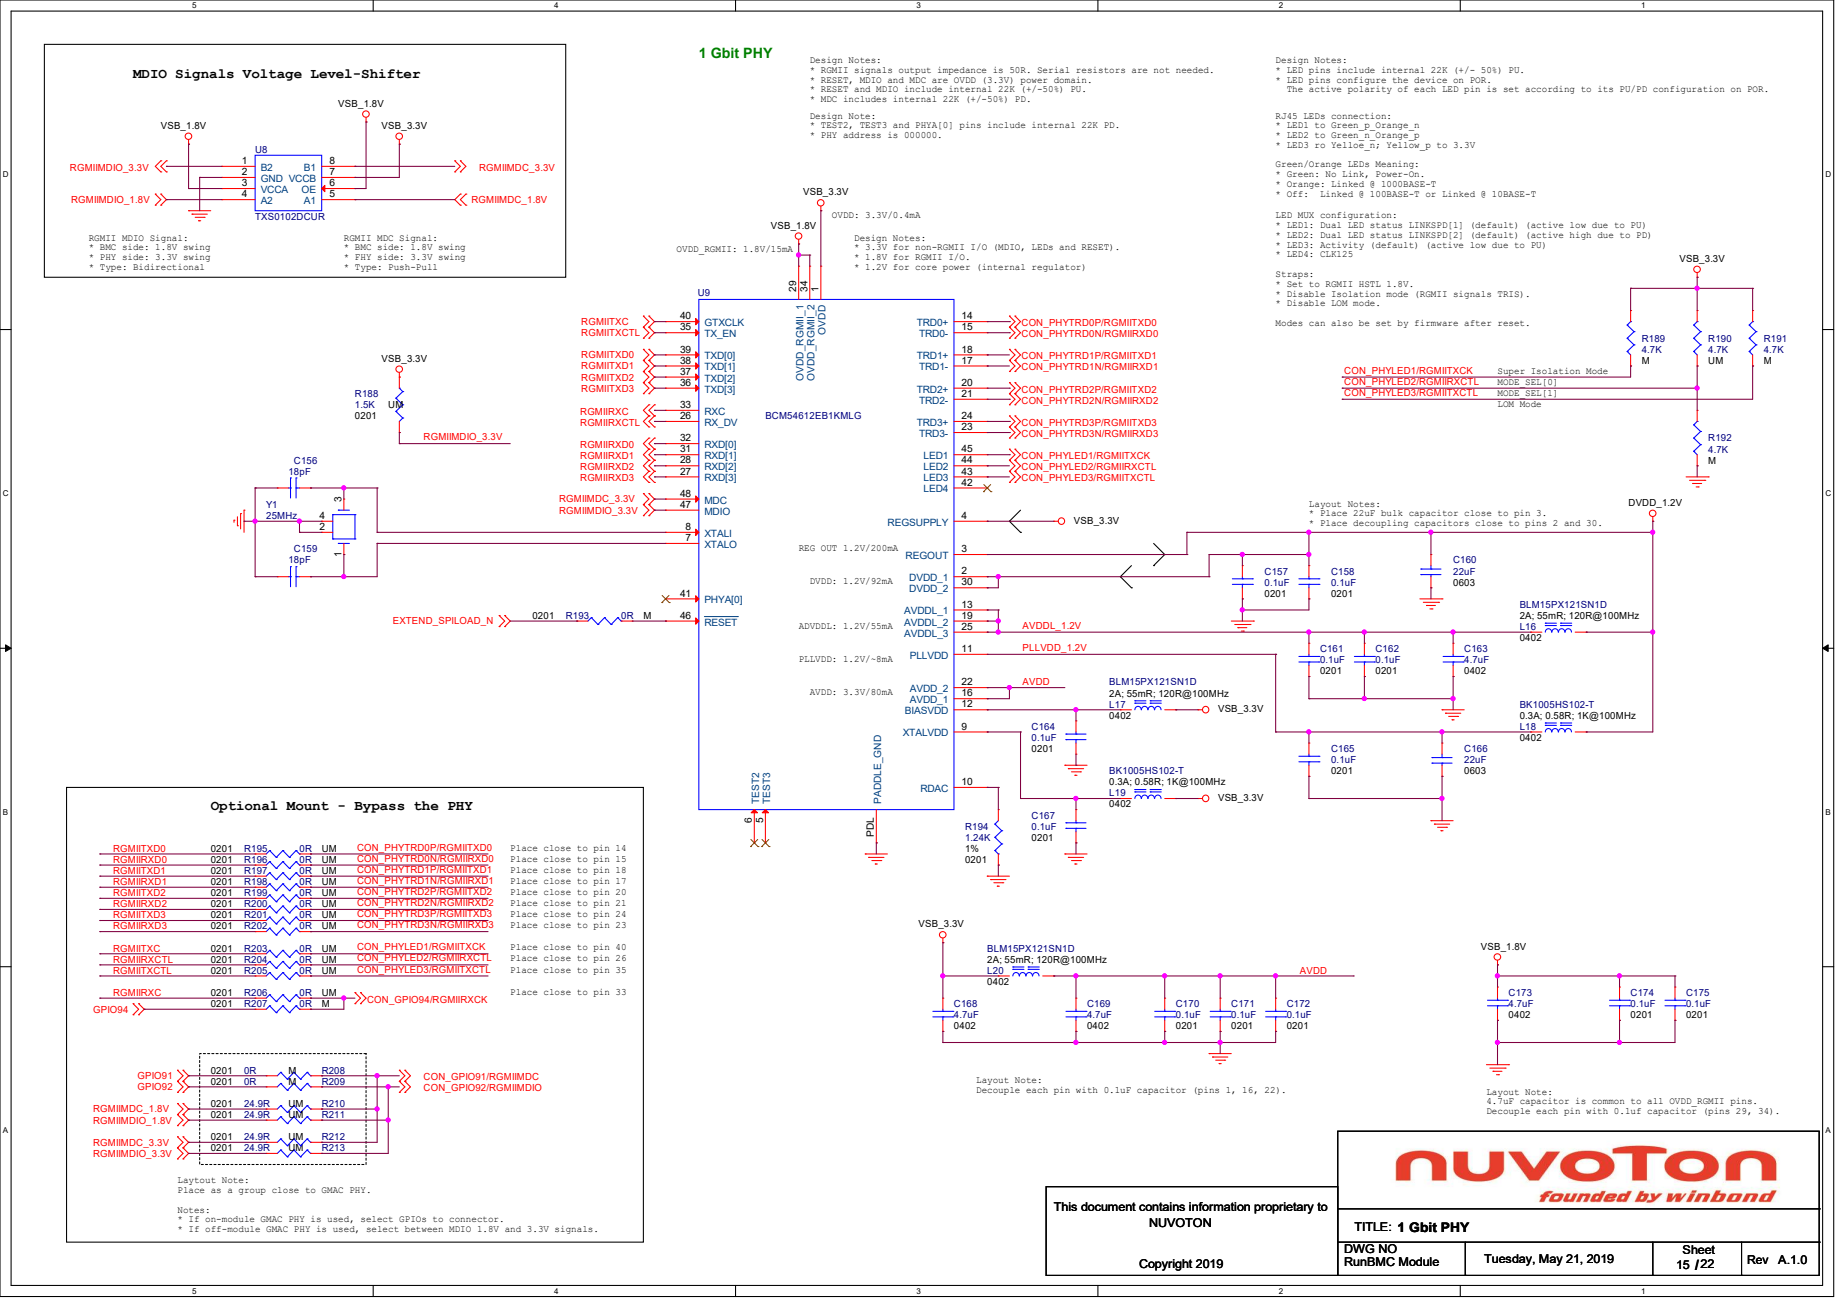
[picture p72: page 15]

Design Notes:
* RGMII signals output impedance is 50R. Serial resistors are not needed.
* RESET, MDIO and MDC are OVDD (3.3V) power domain.
* RESET and MDIO include internal 22K (+/-50%) PU.
* MDC includes internal 22K (+/-50%) PD.
Design Note:
* TEST2, TEST3 and PHYA[0] pins include internal 22K PD.
* PHY address is 000000.

* LED pins include internal 22K (+/- 50%) PU.
* LED pins configure the device on POR.
The active polarity of each LED pin is set according to its PU/PD configuration on POR.

RJ45 LEDs connection:
* LED1 to Green_p_Orange_n
* LED2 to Green_n_Orange_p
* LED3 ro Yelloe_n; Yellow_p to 3.3V
Green/Orange LEDs Meaning:
* Green: No Link, Power-On.
* Orange: Linked @ 1000BASE-T
* Off: Linked @ 100BASE-T or Linked @ 10BASE-T

LED MUX configuration:
* LED1: Dual LED status LINKSPD[1] (default) (active low due to PU)
* LED2: Dual LED status LINKSPD[2] (default) (active high due to PD)
* LED3: Activity (default) (active low due to PU)
* LED4: CLK125
Straps:
* Set to RGMII HSTL 1.8V.
* Disable Isolation mode (RGMII signals TRIS).
* Disable LOM mode.
Modes can also be set by firmware after reset.

* 3.3V for non-RGMII I/O (MDIO, LEDs and RESET).
* 1.8V for RGMII I/O.
* 1.2V for core power (internal regulator)

6 REGOUT 3 PLLVDD 11 BIASVDD 12 OVDD_RGMII_2 34 OVDD

TRD0+ 14 TRD0- 15 TRD1- 17 TRD1+ 18 TRD3+ 24 TRD3- 23 TRD2- 21 TRD2+ 20 TXD[0] 39 TXD[1] 38 TXD[2] 37 TXD[3] 36 RXD[0] 32 RXD[1] 31 RXD[2] 28 RXD[3] 27 RESET 46 RXC 33 RX_DV 26 XTALI 8 GTXCLK 40 XTALO 7 TX_EN 35 MDIO 47 MDC 48 PHYA[0] 41

Layout Notes:
* Place 22uF bulk capacitor close to pin 3.
* Place decoupling capacitors close to pins 2 and 30.

Place close to pin 14
Place close to pin 15
Place close to pin 18
Place close to pin 17
Place close to pin 20
Place close to pin 21
Place close to pin 24
Place close to pin 23

Place close to pin 40
Place close to pin 26
Place close to pin 35

4.7uF capacitor is common to all OVDD_RGMII pins.
Decouple each pin with 0.1uf capacitor (pins 29, 34).

Laytout Note:
Place as a group close to GMAC PHY.
Notes:
* If on-module GMAC PHY is used, select GPIOs to connector.
* If off-module GMAC PHY is used, select between MDIO 1.8V and 3.3V signals.

D D

C C

B B

A A

## Flash SPI0-CS0 (BMC Firmware)

Bus-Switch Design Notes:

* Select Bus Switch that is back-drive protected.
* The total value of pull-up resistors on SPI_CS_N must be 4.25K or less. See NCPM7mnx Errata section 1.64 "Internal Pull-Down During Power-Sequence".

## Flash SPI0-CS1 (BMC Firmware)

Load-Switch Design Notes,

* Select Load Switch with reverse current blocking.

0.6usec

BMC issues pulse on nSPILOAD pin
as a result of CPU CORST_N reset.
MCU must disregard this secondary pulse.

17msec
Internal Debounce BMC CPU
Internal Reset

SPILOAD_N

FWSPI_PWR_EN

FWSPI_PWR

BMC issues pulse on nSPILOAD pin as a result of CPU WD reset, Core-Reset or Power-on-Reset.

MCU releases CORST_N when
flash device is ready.

MCU turns on FWSPI_PWR
after voltage drops below Vmin.

As a result, flash device gets reset. FWSPI_BUS_EN_N

## FWSPI Power Cycle (Reset SPI Flash)

0.6usec CORST_N

MCU drives CORST_N signal low

and turns off FWSPI_PWR. | Layout Note:
* To avoid stubs, place flash devices,
ISP header and the Bus-Switch close together.

Design Notes:
* It is of utmost importance to reset the flash device connected to nSPI0CS0 when the BMC CPU is reset (e.g., a Watchdog reset).
This is most essential with flash devices above 16MB.
In this case, we use flash power-cycle method to reset the flash.
* For security, FWSPIWP_N uses a lockable I/O.
* The flash contains Boot-Block, UBOOT and (optional) Linux sections.
* An external SPI flash programmer (ISP) is typically used in the production line.
ISP can be used when the module is powered off (bare) or under power. Keep ISP_RST_N low while programming.
* FUP (Flash UART Programming) may also be used to program an empty or corrupted flash with Boot-Block and UBOOTsections. Later on, the Linux section can be programmed in UBOOT state through the network or USB storage device.

64MB

64MB

Design Notes:
* When the programmer unit is not in programming mode, I/O (pin 8) is in TRI-STATE mode. * While programming, I/O is driven low to isolate BMC's SPI signals from flash signals.
* Make sure ISP is reverse current blocking.
* Connector type and pin assigment is TBD.
* In case ISP header is mount in the final product, make sure connector height from top PCB is up to 6 mm. R.A SMD type is recommanded.

## In-System-Programming (ISP) Header

Design/Layout Note:
* Use SOP8 / 8-WSON dual footprint to meet small and big flash sizes.

Design/Layout Note:
* Use SOP8 / 8-WSON dual footprint
to meet small and big flash sizes. | FWSPI_PWR

FWSPI_PWR

VSB_3.3V | VSB_3.3V
VSB_3.3V | VSB_3.3V
FWSPI_PWR

VSB_3.3V

FWSPI_PWR

FWSPI_PWR

FWSPI_PWR

# VSB_3.3V GND

VSB_3.3V

FWSPI_PWR

FWSPIWP_N

FWSPI_PWR_EN

FWSPID0 FWSPID1 FWSPID2 FWSPID3 FWSPICLK

FWSPICS0_N
FWSPICS1_N

FWSPICLK_SW

FWSPICS0_N_SW

FWSPID0_SW
FWSPID1_SW

FWSPID2_SW
FWSPID3_SW

FWSPICS1_N_SW

FWSPIWP_N_SW

FWSPID1_SW

FWSPID0_SW

FWSPICS0_N_SW

FWSPICS1_N_SW

FWSPID3_SW

FWSPID2_SW

FWSPIWP_N_SW

FWSPICLK_SW | CON_FWSPICLK CON_FWSPICS0_N CON_FWSPICS1_N

CON_GPIO199/FWSPIWP_N

CON_GPIO198/FWSPID3 CON_GPIO127/FWSPID2 CON_FWSPID1 CON_FWSPID0 FWSPI_PWR_EN | CON_GPIO202/INDICATOR_N GPIO202

ENTER_FUP_N

CORST_N | GPIO127 GPIO199 GPIO198

ISP_RST_N

RunBMC Module | A.1.0 BMC Firmware SPI
Tuesday, May 21, 2019 | 16 22 DWG NO
RunBMC Module | A.1.0 BMC Firmware SPI
Tuesday, May 21, 2019 | 16 22 DWG NO
RunBMC Module | A.1.0 BMC Firmware SPI
Tuesday, May 21, 2019 | 16 22

R215
10K

0201 U10
74CBTLV3245 DHVQFN20 NC 1 A1 2 | VCC 20 A2 3 A3 4 A4 5 A5 6 A6 7 A7 8 A8 9 GND 10 | B1 18 B2 17 B3 16 B4 15 B5 14 B6 13 B7 12 B8 11 OE# 19 | C¹⁷⁸ 0.1uF 0201
0201 | UM 24.9R | R225
0201 4.7K | R239

J1SMD D-ROW 8P 1.25MM

VCC 1 CLK 3 MISO 5 NC 7 GND 2 CS# 4 MOSI 6

I/O 8

0201 | M 24.9R | R219
0R | M | R216 | 0201
0R | UM R231 | 0201
0R | UM R242 | 0201
0201 R241 | 0R
0201 | UM 24.9R | R229
0201 4.7K | R240
0201 | UM 24.9R | R226 C¹⁷⁶ 0.1uF 0201
0201 | UM R243 | 0R
0201 R233 | 0R
0201 4.7K | R237 C¹⁷⁹ 0.1uF 0201
0201 R230 | 0R

U14 MX66L51235F

8-WSON | M
CS 1 DO/IO1 2 WP/IO2 3 GND 4 | DI/IO0 5 CLK 6 HOLD_RESET/IO3 7 VCC 8
0201 | M 24.9R | R220
0201 | UM 24.9R | R227
0201 4.7K | R236

U12
74AHC1G00SE-7 SOT353

1

2

4

5 3 C177
4.7uF
0402
0201 | UM 24.9R | R228

U11 AP22802AW5-7 OUT 1 GND 2 FLG 3 EN 4

IN 5

0201 | UM 24.9R | R221
0201 4.7K | R235 U13 MX66L51235F
8-WSON | M
CS 1 DO/IO1 2 WP/IO2 3 GND 4 | DI/IO0 5 CLK 6 HOLD_RESET/IO3 7 VCC 8
0201 | UM 24.9R | R222
0201 4.7K | R234
0201 | UM 24.9R | R223

R214
10K

0201

0201 | UM R232 | 0R
0201 | M 24.9R | R217
0201 | UM 24.9R | R224
0201 | UM R244 | 0R
0201 4.7K | R238
0201 | M 24.9R | R218 FWSPICS0_N_SW

FWSPID1_SW
FWSPI0_D2_WP_N
FWSPID0_SW

FWSPICLK_SW

FWSPI0_D3_HOLD_N

FWSPICS1_N_SW
FWSPID1_SW

FWSPID0_SW

FWSPICLK_SW

FWSPI1_D3_HOLD_N

FWSPID2_SW
FWSPIWP_N_SW
FWSPID2_SW | FWSPI1_D2_WP_N
FWSPIWP_N_SW

FWSPID3_SW

FWSPID3_SW

FWSPI_BUS_EN_N

FWSPI1_D2_WP_N

FWSPI0_D2_WP_N

FWSPICS0_N_SW
FWSPICS1_N_SW

FWSPI1_D3_HOLD_N

FWSPI0_D3_HOLD_N

FWSPICLK_SW

FWSPICS0_N_SW

FWSPID0_SW | FWSPID1_SW FWSPICLK_SW
| FWSPICS1_N_SW

## I2C EEPROM (Addr=0xA2)

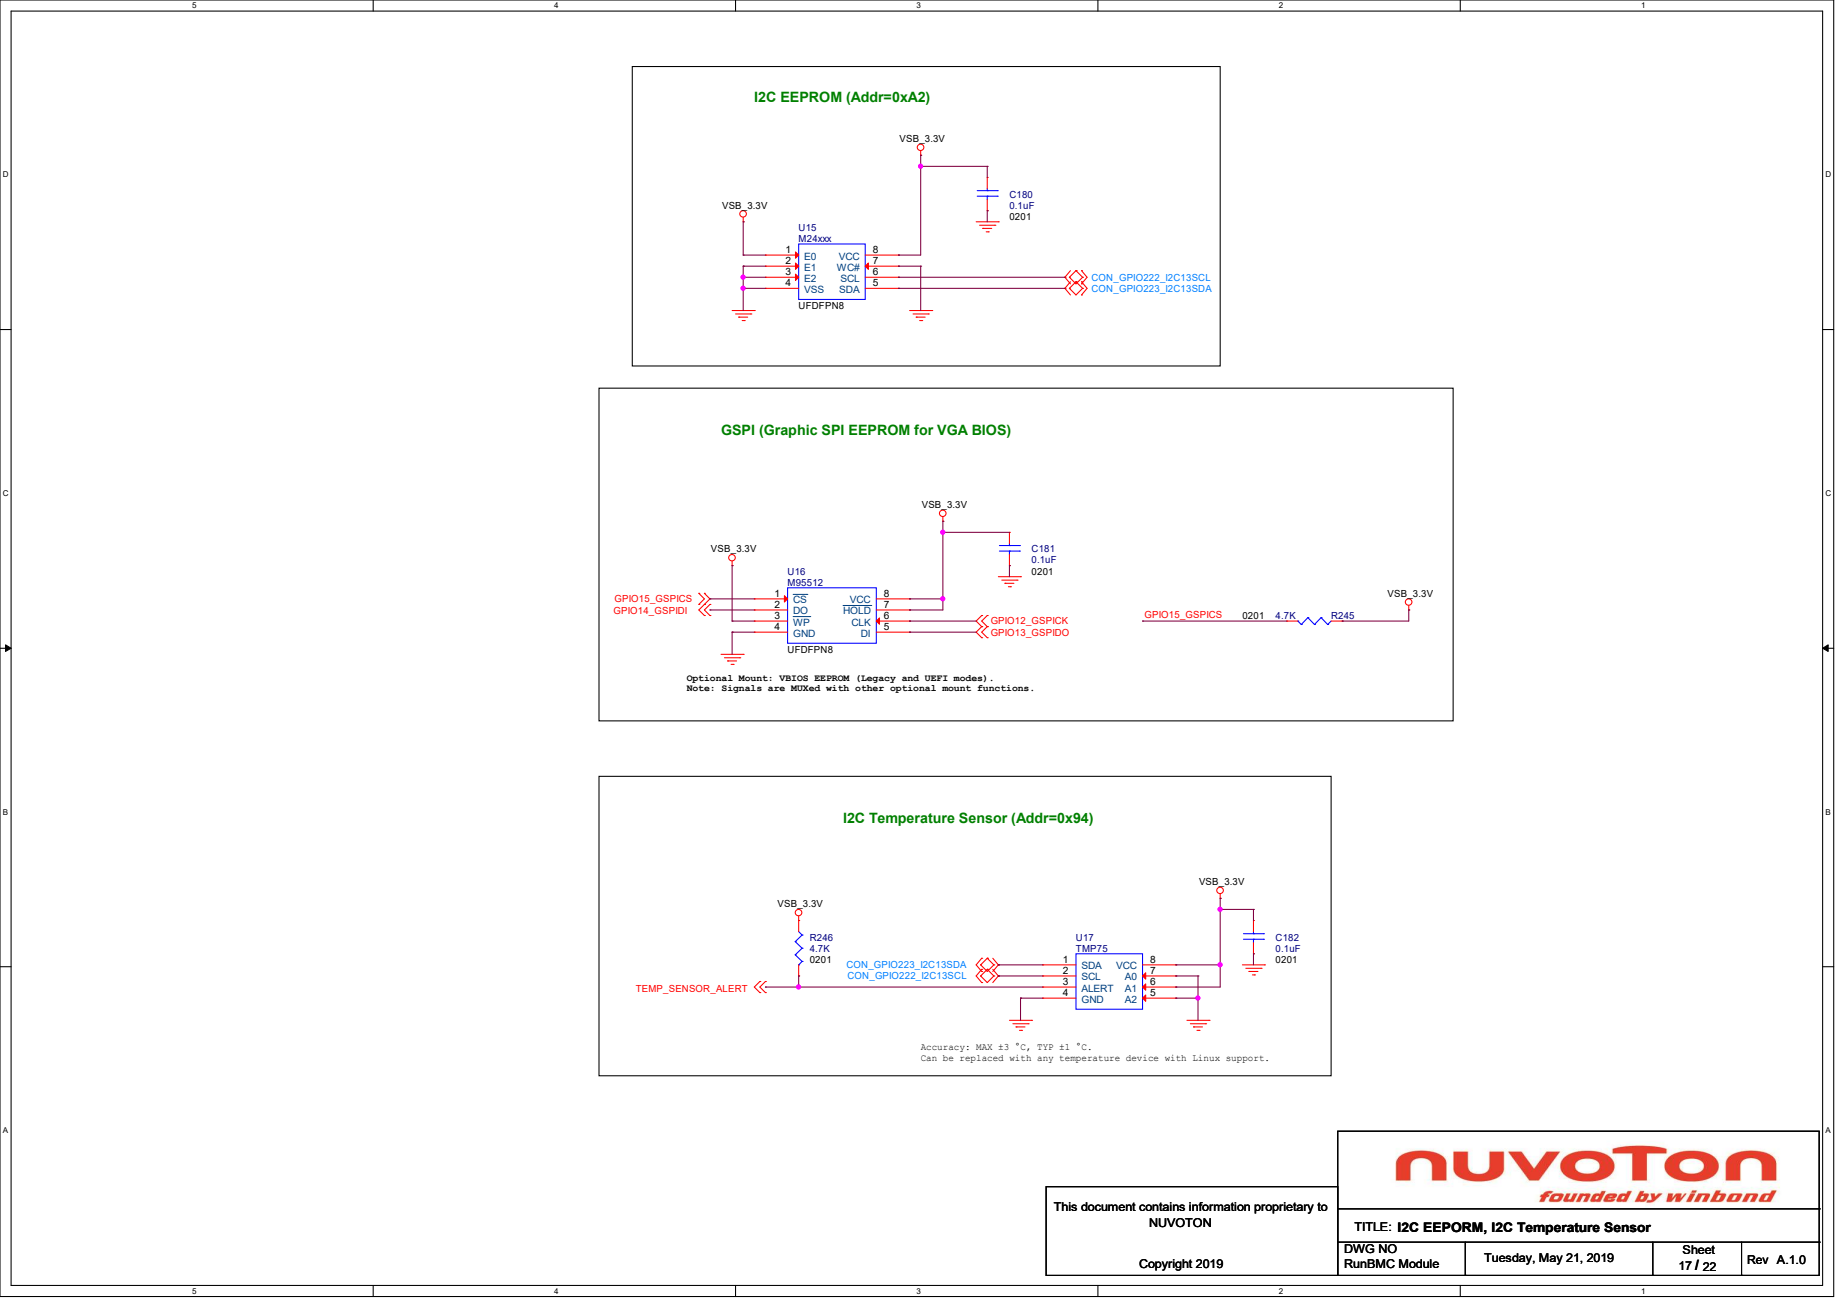
[picture p73: page 17]

GSPI (Graphic SPI EEPROM for VGA BIOS)

Optional Mount: VBIOS EEPROM (Legacy and UEFI modes).
Note: Signals are MUXed with other optional mount functions.

I2C Temperature Sensor (Addr=0x94) Accuracy: MAX ±3 °C, TYP ±1 °C.

Can be replaced with any temperature device with Linux support.

## SPI-to-Dual UART

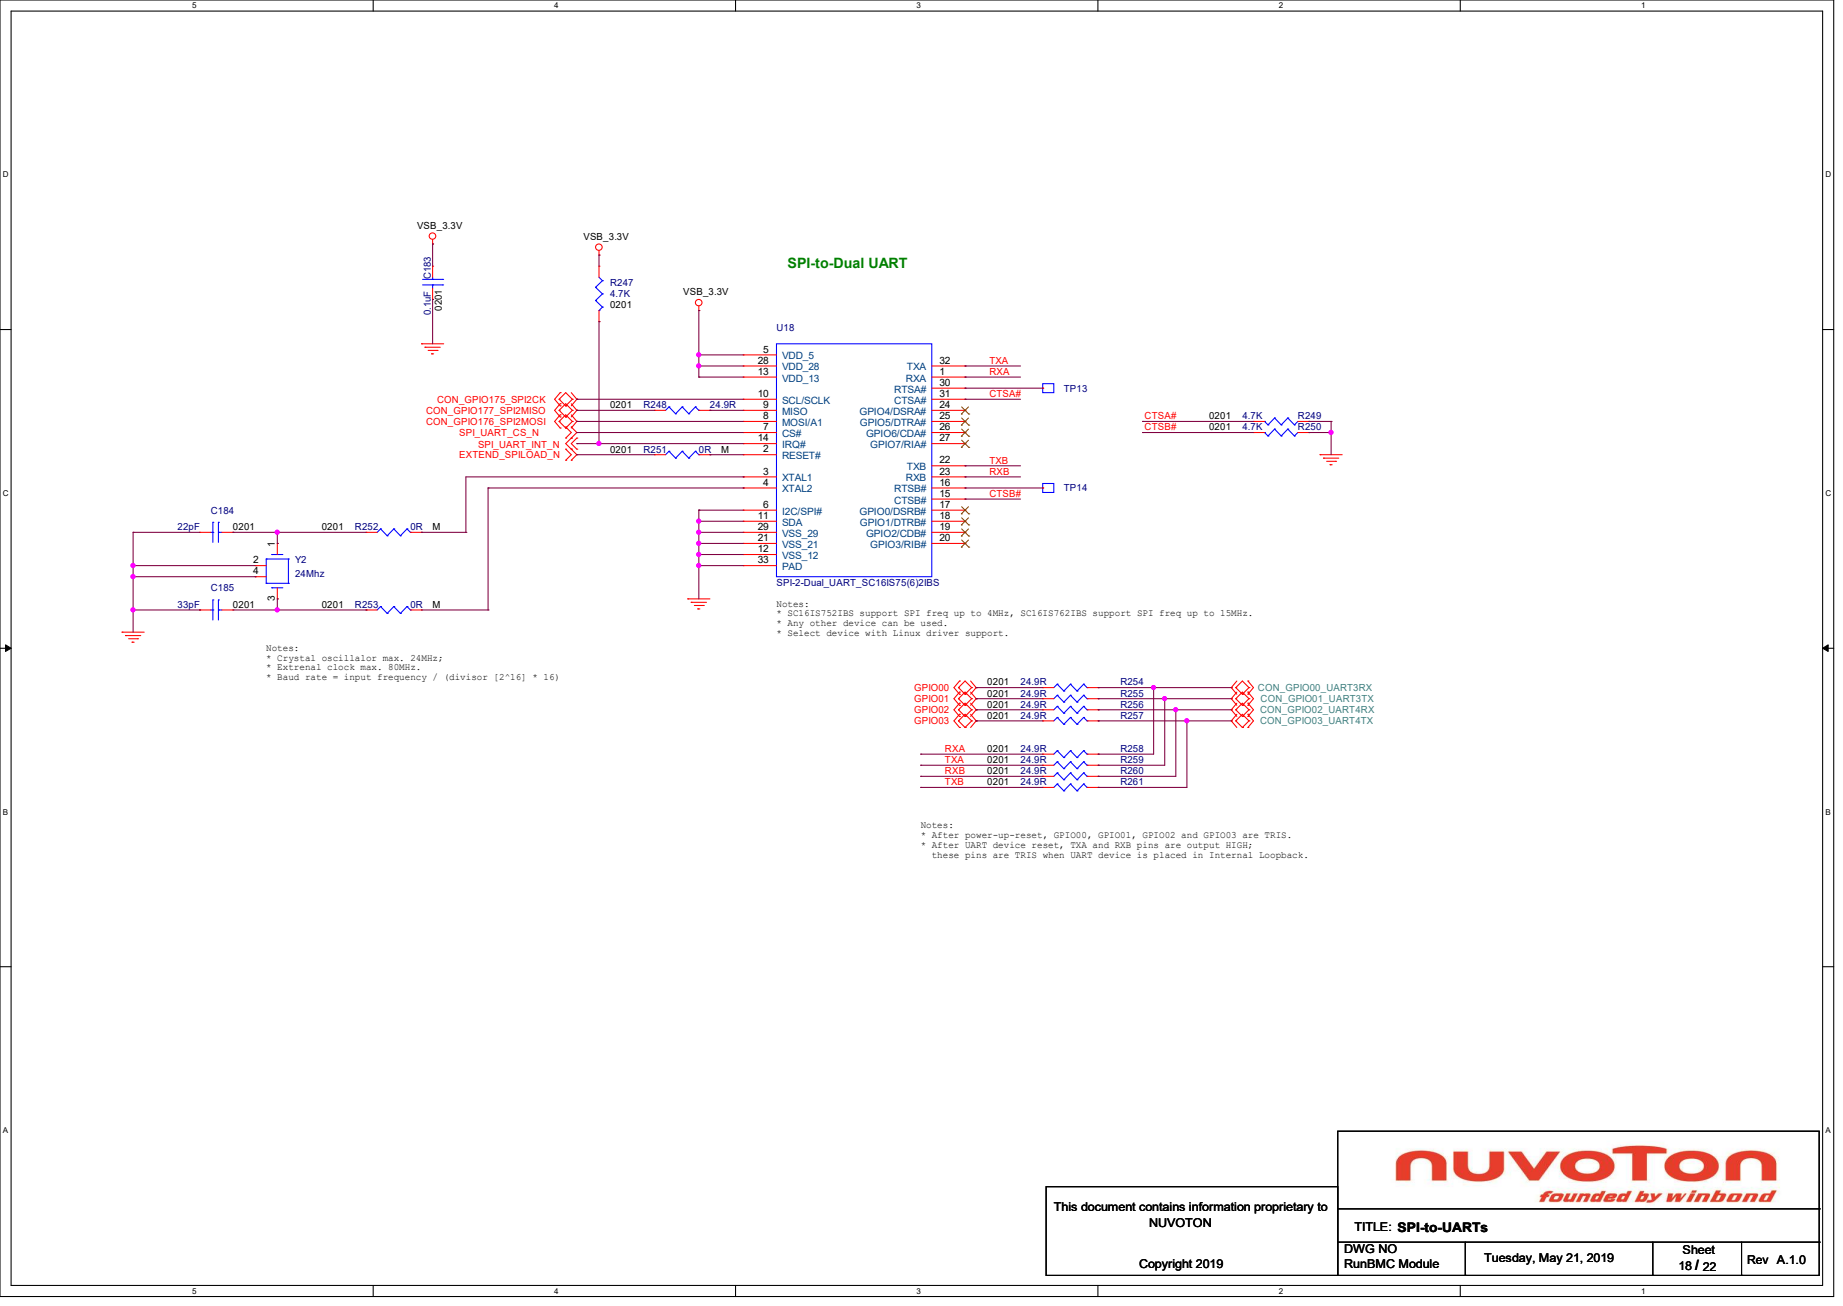
[picture p74: page 18]

IRQ# 14 RESET# 2 XTAL1 3 XTAL2 4 VDD_28 28 VSS_21 21 SDA 11 PAD 33 VSS_12 12 VDD_5 5
TXA 32 RXA 1 RTSA# 30 CTSA# 31 GPIO4/DSRA# 24 GPIO5/DTRA# 25 GPIO6/CDA# 26 GPIO7/RIA# 27 TXB 22 RXB 23 CTSB# 15 RTSB# 16 GPIO0/DSRB# 17 GPIO1/DTRB# 18 GPIO2/CDB# 19 GPIO3/RIB# 20 VDD_13 13 SCL/SCLK 10 VSS_29 29 CS# 7 MOSI/A1 8 MISO 9

Notes:
* SC16IS752IBS support SPI freq up to 4MHz, SC16IS762IBS support SPI freq up to 15MHz.
* Any other device can be used.
* Select device with Linux driver support.

* Crystal oscillalor max. 24MHz;
* Extrenal clock max. 80MHz.
* Baud rate = input frequency / (divisor [2^16] * 16)

* After power-up-reset, GPIO00, GPIO01, GPIO02 and GPIO03 are TRIS.
* After UART device reset, TXA and RXB pins are output HIGH;
these pins are TRIS when UART device is placed in Internal Loopback.

# Power-Up Sequencing

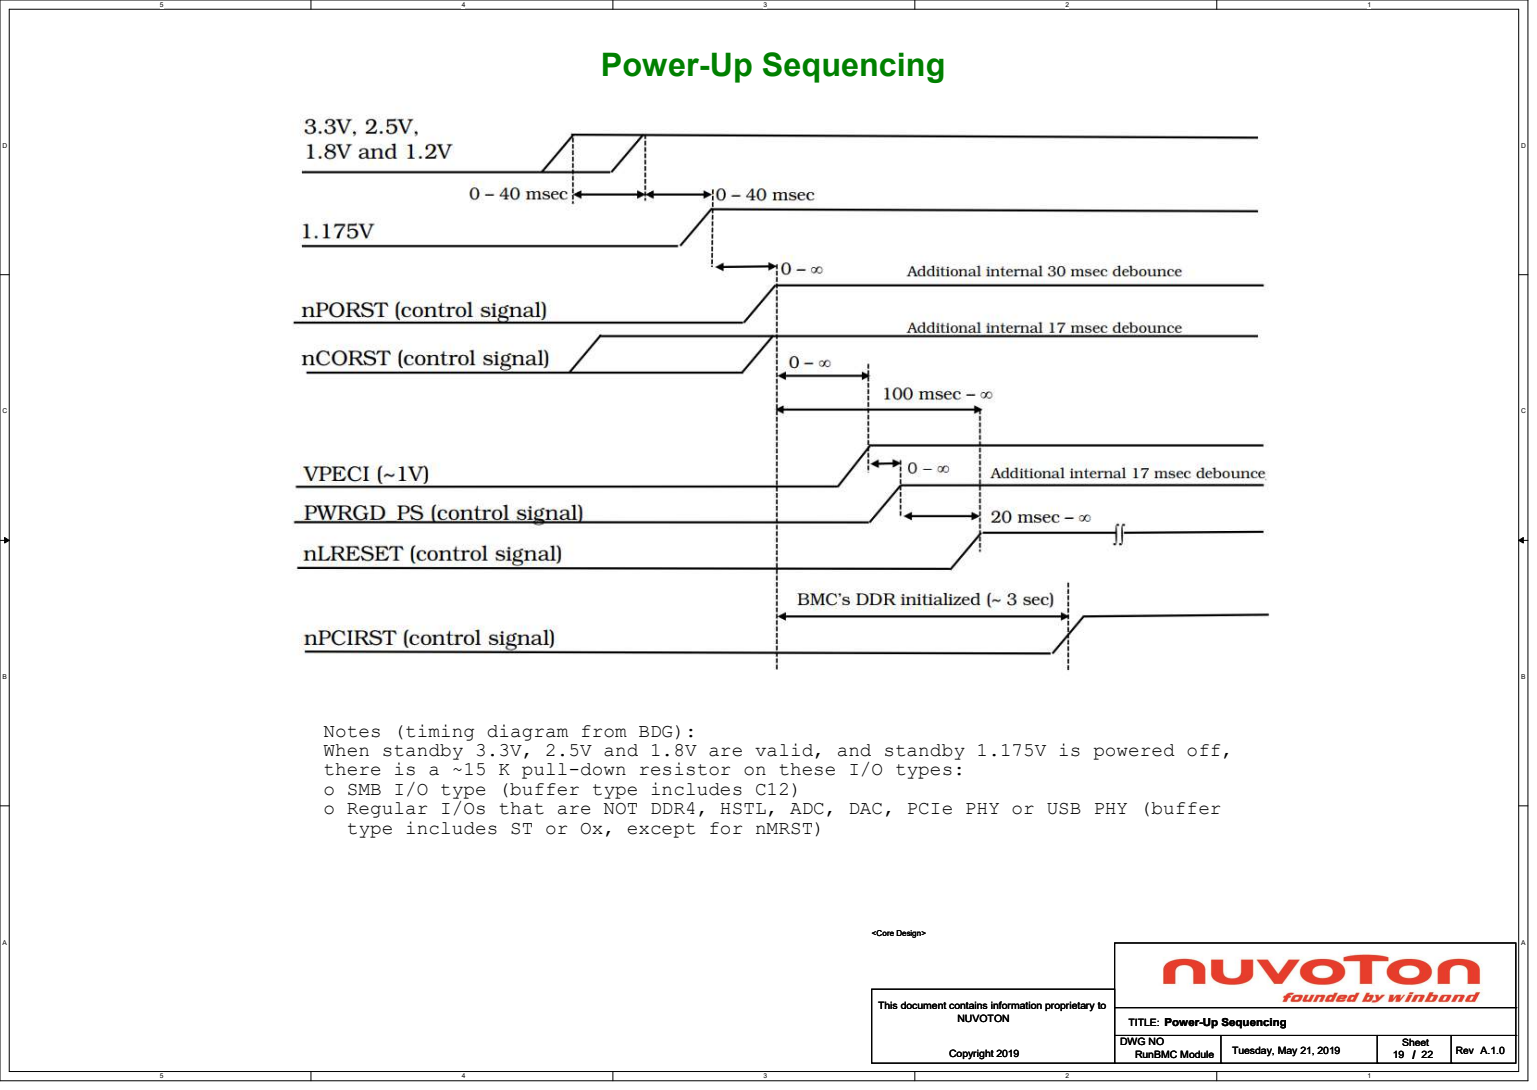
[picture p75: page 19]
type includes ST or Ox, except for nMRST); DWG NO; Tuesday, May 21, 2019; 22 <Core Design>

Notes (timing diagram from BDG):
When standby 3.3V, 2.5V and 1.8V are valid, and standby 1.175V is powered off,
there is a ~15 K pull-down resistor on these I/O types:
o SMB I/O type (buffer type includes C12)
o Regular I/Os that are NOT DDR4, HSTL, ADC, DAC, PCIe PHY or USB PHY (buffer

A.1.0 RunBMC Module Power-Up Sequencing

R1

R2

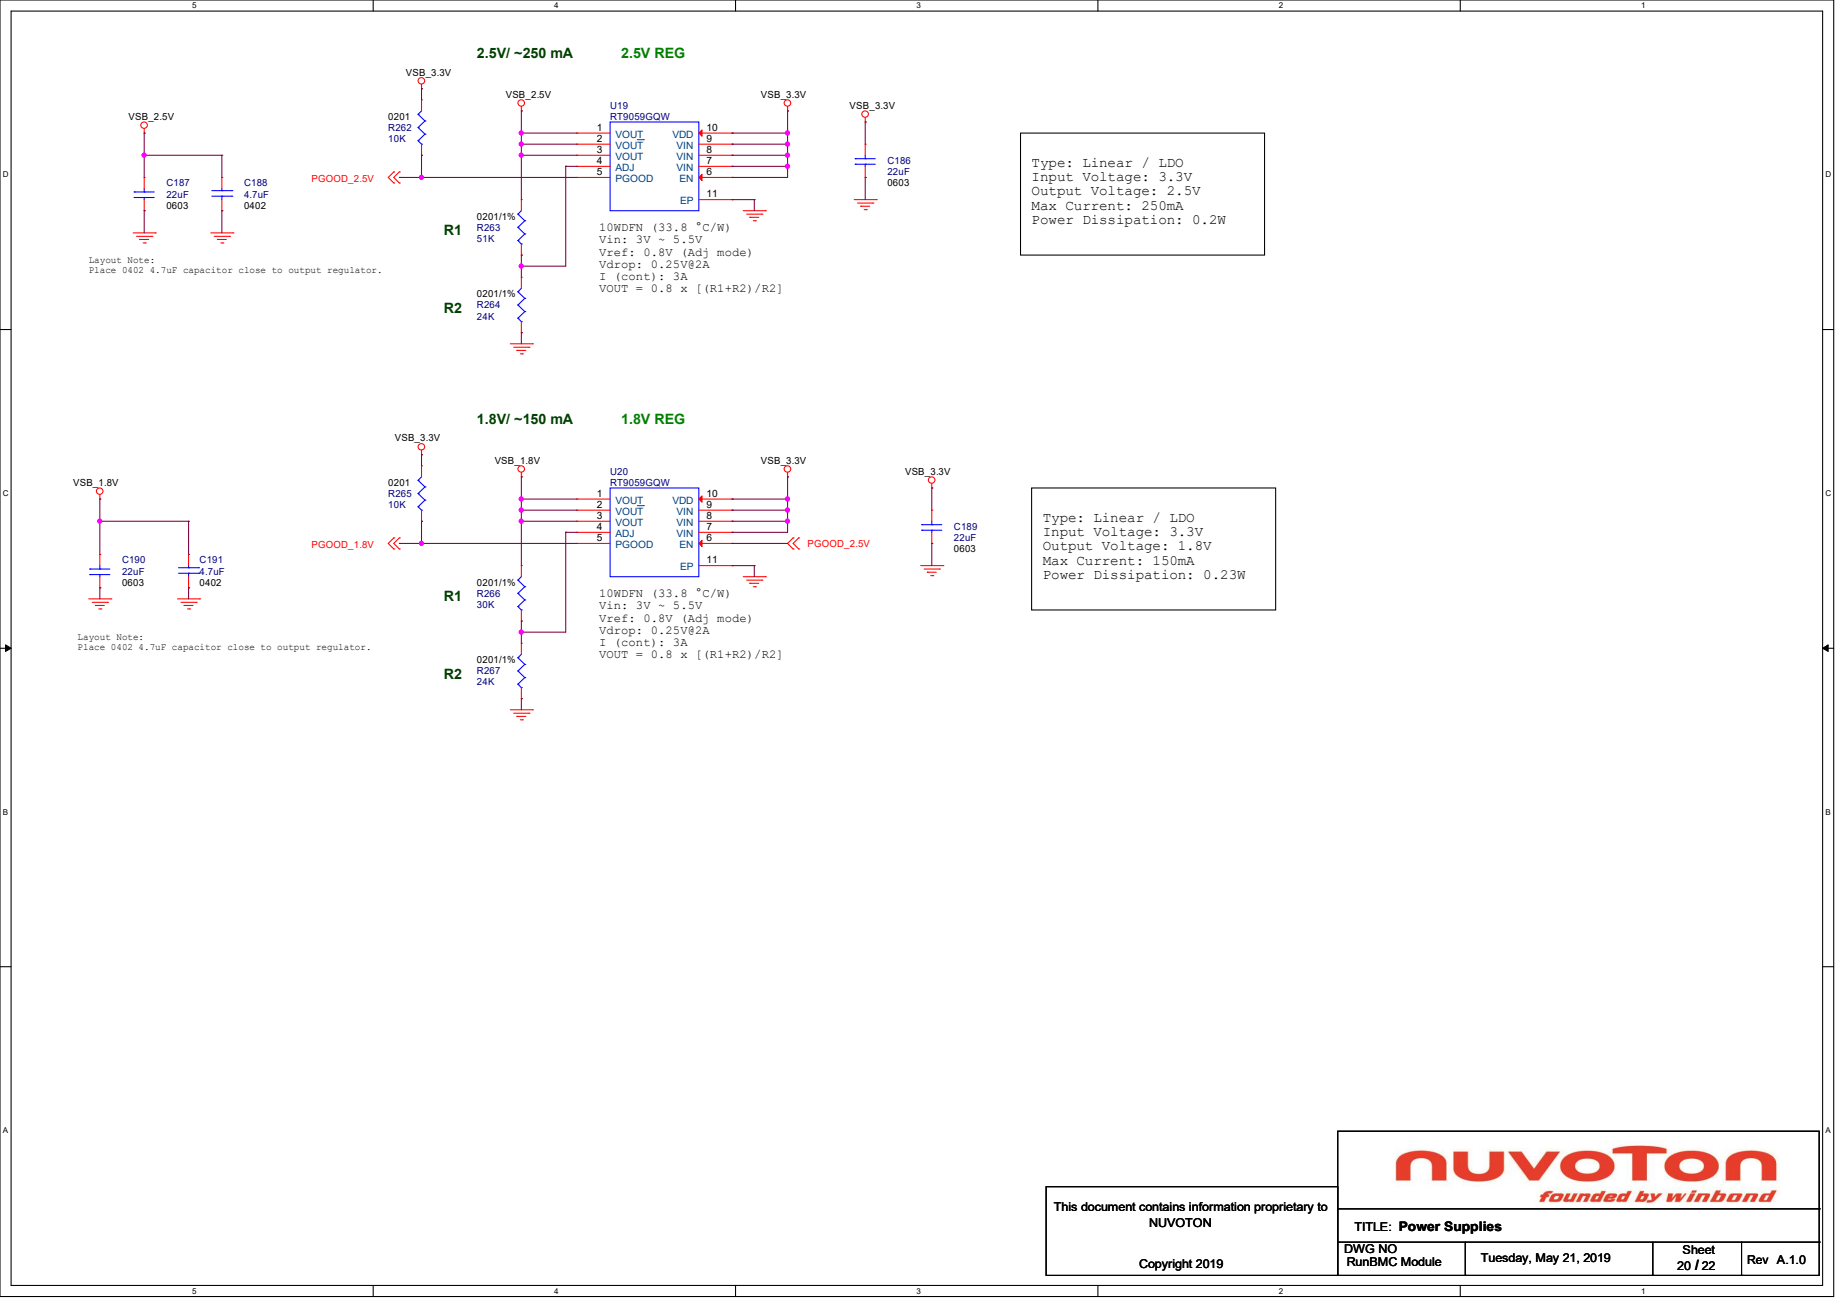
[picture p76: page 20]

1.8V/ ~150 mA Layout Note:
Place 0402 4.7uF capacitor close to output regulator.

Layout Note:

1.2V/0.5A

## Type: Buck / Switch

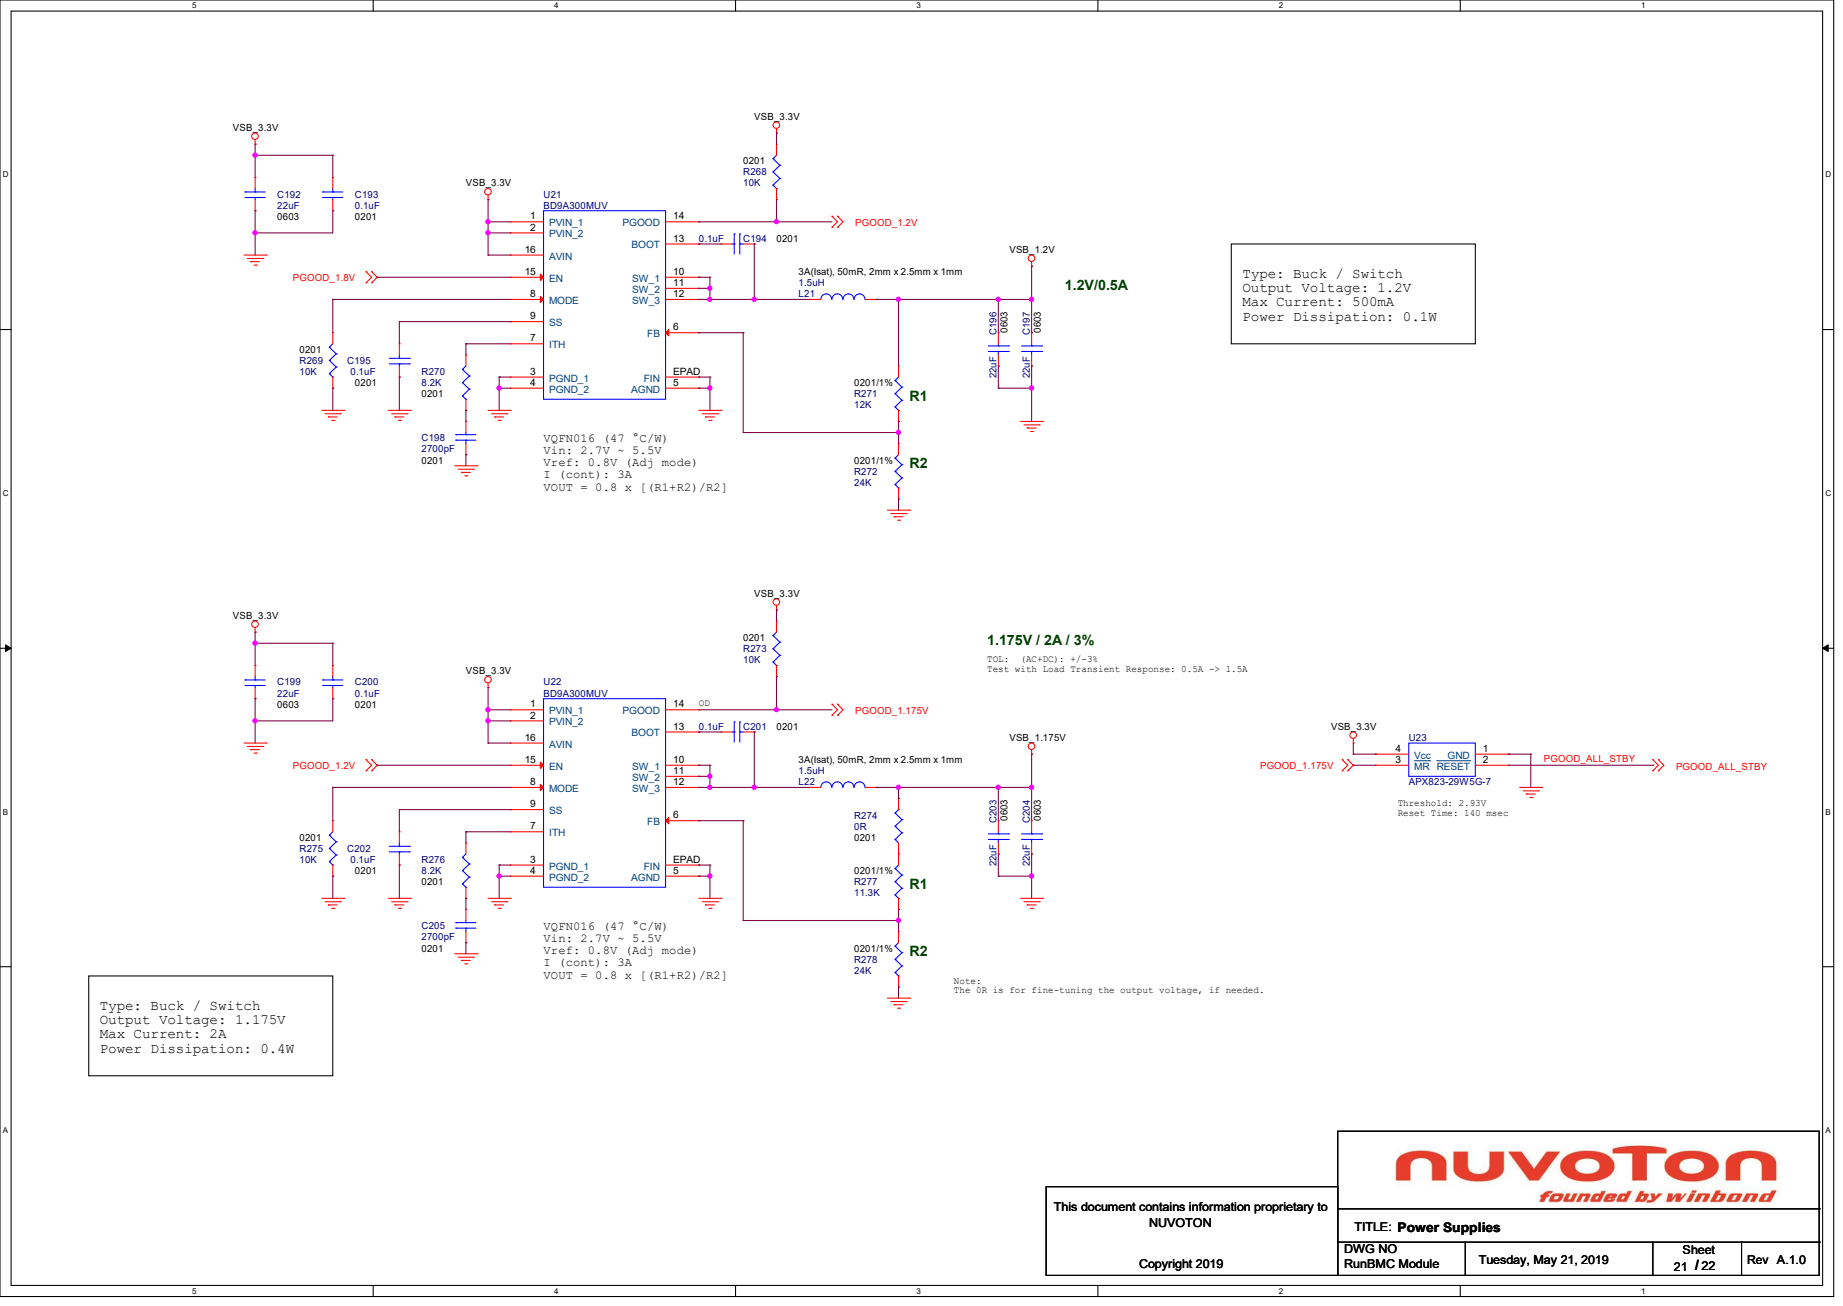
[picture p77: page 21]

Test with Load Transient Response: 0.5A -> 1.5A

U23 APX823-29W5G-7 GND 1 RESET 2 MR 3 Vcc 4

Note:
The 0R is for fine-tuning the output voltage, if needed.

## PWM

## VGA

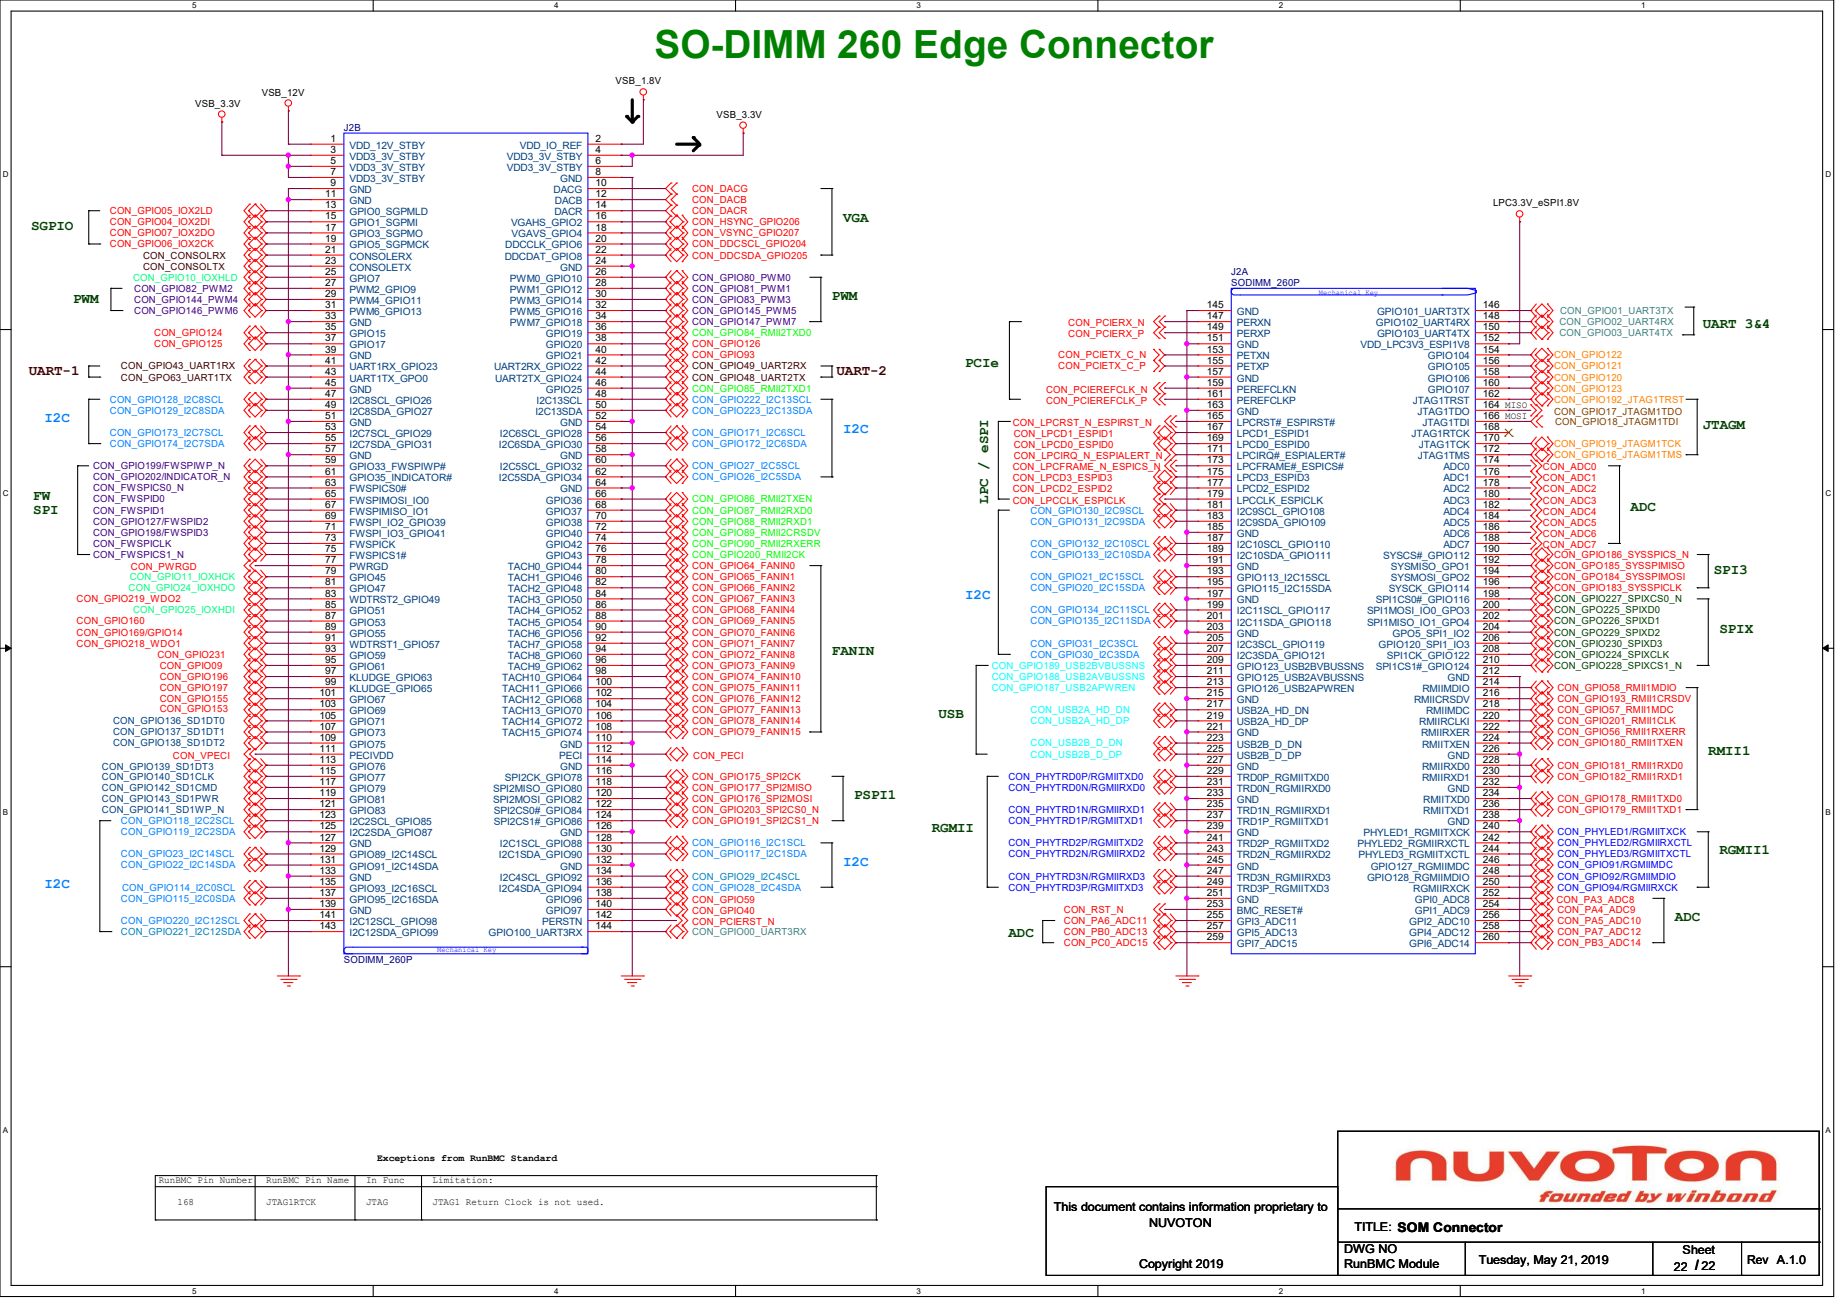
[picture p78: page 22]
RGMII; ADC; USB; PCIeLPC / eSPI; UART-2; FANIN; PSPI1; FW SPI; UART-1; RMII1; RGMII1; JTAGM; SPIX; SPI3; Exceptions from RunBMC Standard RunBMC Pin Number; RunBMC Pin Name; In Func; Limitation:; JTAG1RTCK; JTAG1 Return Clock is not used. JTAG; MISO MOSI; UART 3&4; VSB_12V; VSB_3.3V; LPC3.3V_eSPI1.8V; CON_PB0_ADC13 CON_PHYTRD3P/RGMIITXD3 CON_PHYTRD3N/RGMIIRXD3 CON_PHYTRD1N/RGMIIRXD1 CON_PHYTRD1P/RGMIITXD1 CON_USB2B_D_DN; CON_USB2B_D_DP CON_USB2A_HD_DN CON_USB2A_HD_DP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

SO-DIMM 260 Edge Connector VSB_3.3V
VDD_IO_REF 2 VDD3_3V_STBY 4 VDD3_3V_STBY 6 GND 8 DACG 10 DACB 12 DACR 14 VGAHS_GPIO2 16 VGAVS_GPIO4 18 DDCCLK_GPIO6 20 DDCDAT_GPIO8 22 GND 24 PWM0_GPIO10 26 PWM1_GPIO12 28 PWM3_GPIO14 30 PWM5_GPIO16 32 PWM7_GPIO18 34 GPIO19 36 GPIO20 38 GPIO21 40 UART2RX_GPIO22 42 UART2TX_GPIO24 44 GPIO25 46
CON_GPIO93 CON_GPIO126 CON_DACG
CON_DACB CON_DACR
PERXN 147 PERXP 149 GND 151 PETXN 153 PETXP 155 GND 157 PEREFCLKN 159 PEREFCLKP 161 GND 163

VSB_1.8V
VDD_12V_STBY 1 VDD3_3V_STBY 3 VDD3_3V_STBY 5 VDD3_3V_STBY 7 GND 9 GND 11 GPIO0_SGPMLD 13 GPIO1_SGPMI 15 GPIO3_SGPMO 17 GPIO5_SGPMCK 19 CONSOLERX 21 CONSOLETX 23 GPIO7 25 PWM2_GPIO9 27 PWM4_GPIO11 29 PWM6_GPIO13 31 GND 33 GPIO15 35 GPIO17 37 GND 39 UART1RX_GPIO23 41 UART1TX_GPO0 43 GND 45
CON_GPIO219_WDO2 CON_GPIO218_WDO1 CON_GPIO169/GPIO14 CON_GPO63_UART1TX CON_GPIO43_UART1RX CON_GPIO05_IOX2LD
SGPIO

PWM
I2C7SDA_GPIO31 55 GND 57 GPIO33_FWSPIWP# 59 GPIO35_INDICATOR# 61 FWSPICS0# 63 FWSPIMOSI_IO0 65 FWSPIMISO_IO1 67 FWSPI_IO2_GPIO39 69 FWSPI_IO3_GPIO41 71 FWSPICK 73 FWSPICS1# 75 PWRGD 77 GPIO45 79 GPIO47 81 WDTRST2_GPIO49 83 GPIO51 85 GPIO53 87 GPIO55 89 WDTRST1_GPIO57 91 GPIO59 93 GPIO61 95 KLUDGE_GPIO63 97 KLUDGE_GPIO65 99 GPIO67 101 GPIO69 103 GPIO71 105 GPIO73 107 GPIO75 109 PECIVDD 111 GPIO76 113 GPIO77 115 GPIO79 117 GPIO81 119 GPIO83 121

CON_GPIO84_RMII2TXD0 CON_GPIO85_RMII2TXD1 CON_GPIO86_RMII2TXEN
I2C5SDA_GPIO34 62 GND 64 GPIO36 66 GPIO37 68 GPIO38 70 GPIO40 72 GPIO42 74 GPIO43 76 TACH0_GPIO44 78 TACH1_GPIO46 80 TACH2_GPIO48 82 TACH3_GPIO50 84 TACH4_GPIO52 86 TACH5_GPIO54 88 TACH6_GPIO56 90 TACH7_GPIO58 92 TACH8_GPIO60 94 TACH9_GPIO62 96 TACH10_GPIO64 98 TACH11_GPIO66 100 TACH12_GPIO68 102 TACH13_GPIO70 104 TACH14_GPIO72 106 TACH15_GPIO74 108 GND 110 PECI 112 GND 114 SPI2CK_GPIO78 116 SPI2MISO_GPIO80 118 SPI2MOSI_GPIO82 120 SPI2CS0#_GPIO84 122 SPI2CS1#_GPIO86 124 GND 126

I2C3SCL_GPIO119 205
I2C3SDA_GPIO121 207 GPIO123_USB2BVBUSSNS 209 GPIO125_USB2AVBUSSNS 211 GPIO126_USB2APWREN 213 GND 215 USB2A_HD_DN 217 USB2A_HD_DP 219 GND 221 USB2B_D_DN 223 USB2B_D_DP 225 GND 227 TRD0P_RGMIITXD0 229 TRD0N_RGMIIRXD0 231 GND 233 TRD1N_RGMIIRXD1 235 TRD1P_RGMIITXD1 237 GND 239 TRD2P_RGMIITXD2 241 TRD2N_RGMIIRXD2 243 GND 245 TRD3N_RGMIIRXD3 247 TRD3P_RGMIITXD3 249 GND 251 BMC_RESET# 253 GPI3_ADC11 255 GPI5_ADC13 257 GPI7_ADC15 259

I2C2SCL_GPIO85 123
I2C2SDA_GPIO87 125 GND 127 GPIO89_I2C14SCL 129 GPIO91_I2C14SDA 131 GND 133 GPIO93_I2C16SCL 135 GPIO95_I2C16SDA 137 GND 139
