Nuvoton-Israel/nuvoton-info/npcm7xx-poleg/RunBMC/board_deliverables/Evaluation_RunBMC_BaseBoard_(BUV)/Design/runbmc_hsbuv_rev009_fab_b_0919.pdf

# 01 INDEX

# 13 I2C, WATCHDOG RST HEADER

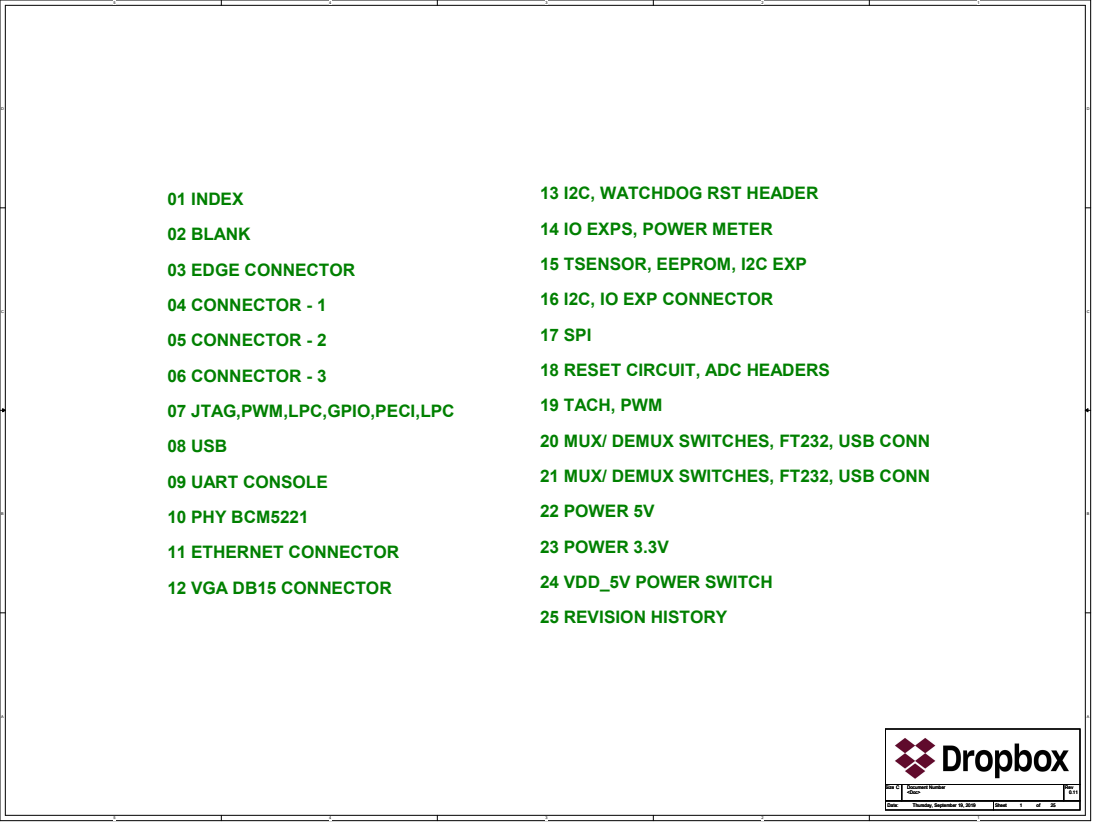
[picture p79: page 1]
25 REVISION HISTORY; Size; Document Number; Rev Date:; Sheet; of <Doc>

02 BLANK
03 EDGE CONNECTOR
04 CONNECTOR - 1
05 CONNECTOR - 2
06 CONNECTOR - 3
07 JTAG,PWM,LPC,GPIO,PECI,LPC
08 USB
09 UART CONSOLE
10 PHY BCM5221
11 ETHERNET CONNECTOR
12 VGA DB15 CONNECTOR

14 IO EXPS, POWER METER
15 TSENSOR, EEPROM, I2C EXP
16 I2C, IO EXP CONNECTOR
17 SPI
18 RESET CIRCUIT, ADC HEADERS
19 TACH, PWM
20 MUX/ DEMUX SWITCHES, FT232, USB CONN
21 MUX/ DEMUX SWITCHES, FT232, USB CONN
22 POWER 5V
23 POWER 3.3V
24 VDD_5V POWER SWITCH

Document Number Document Number Thursday, September 19, 2019 Thursday, September 19, 2019 Sheet Sheet 1 1 of <Doc> of <Doc> 25 Size 25 Size | Rev Date: Rev Date: 0.11 C 0.11 C

Thursday, September 19, 2019 | 1 25

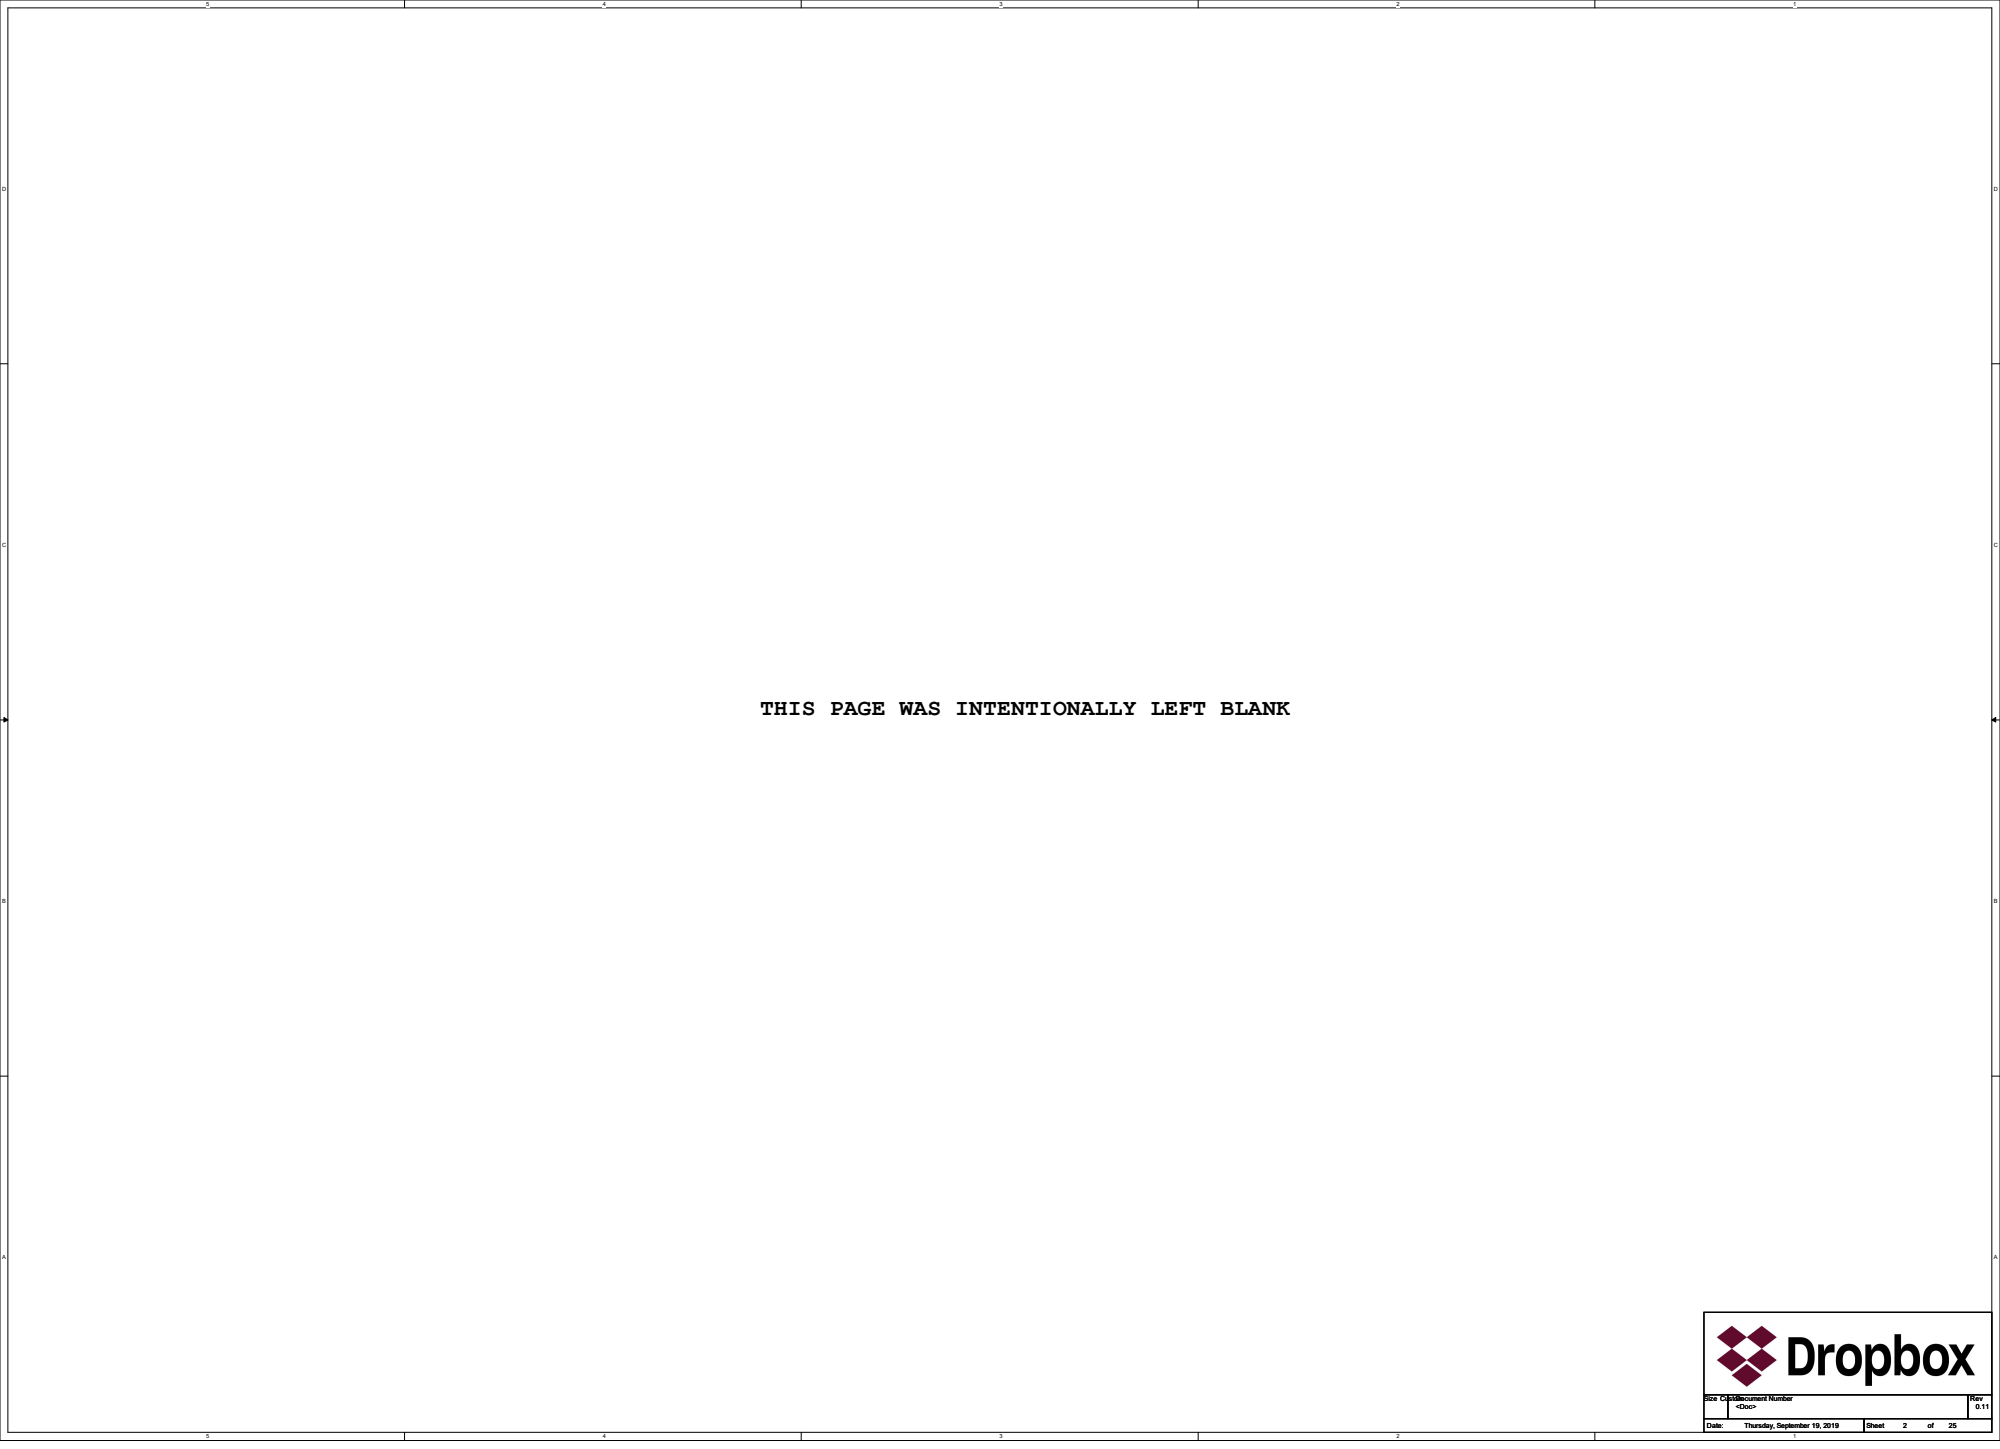
[picture p80: page 2]

THIS PAGE WAS INTENTIONALLY LEFT BLANK

Size | Document Number Document Number Document Number Thursday, September 19, 2019 Thursday, September 19, 2019 Sheet Sheet Sheet 2 2 of <Doc> of <Doc> of <Doc> 25 Size 25 Size | Rev Date: Rev Date: Rev Date: 0.11 Custom 0.11 Custom 0.11 Custom

Thursday, September 19, 2019 | 2 25

# PCIE1 GF64_PCIE_1_0-7X4-2_A1-B31-e1 POP

3.3V_A10 A10 PERST | A11 GND_A12 A12 REFCLK+ | A13 REFCLK- | A14 GND_A15 A15 PERP0 A16 PERN0 A17 GND_A18 A18 RSVD_A19 A19 GND_A20 A20 PERP1 A21 PERN1 A22 GND_A23 A23 GND_A24 A24 PERP2 A25 PERN2 A26 GND_A27 A27 GND_A28 A28 PERP3 A29 PERN3 A30 GND_A31 A31 RSVD_A32 A32

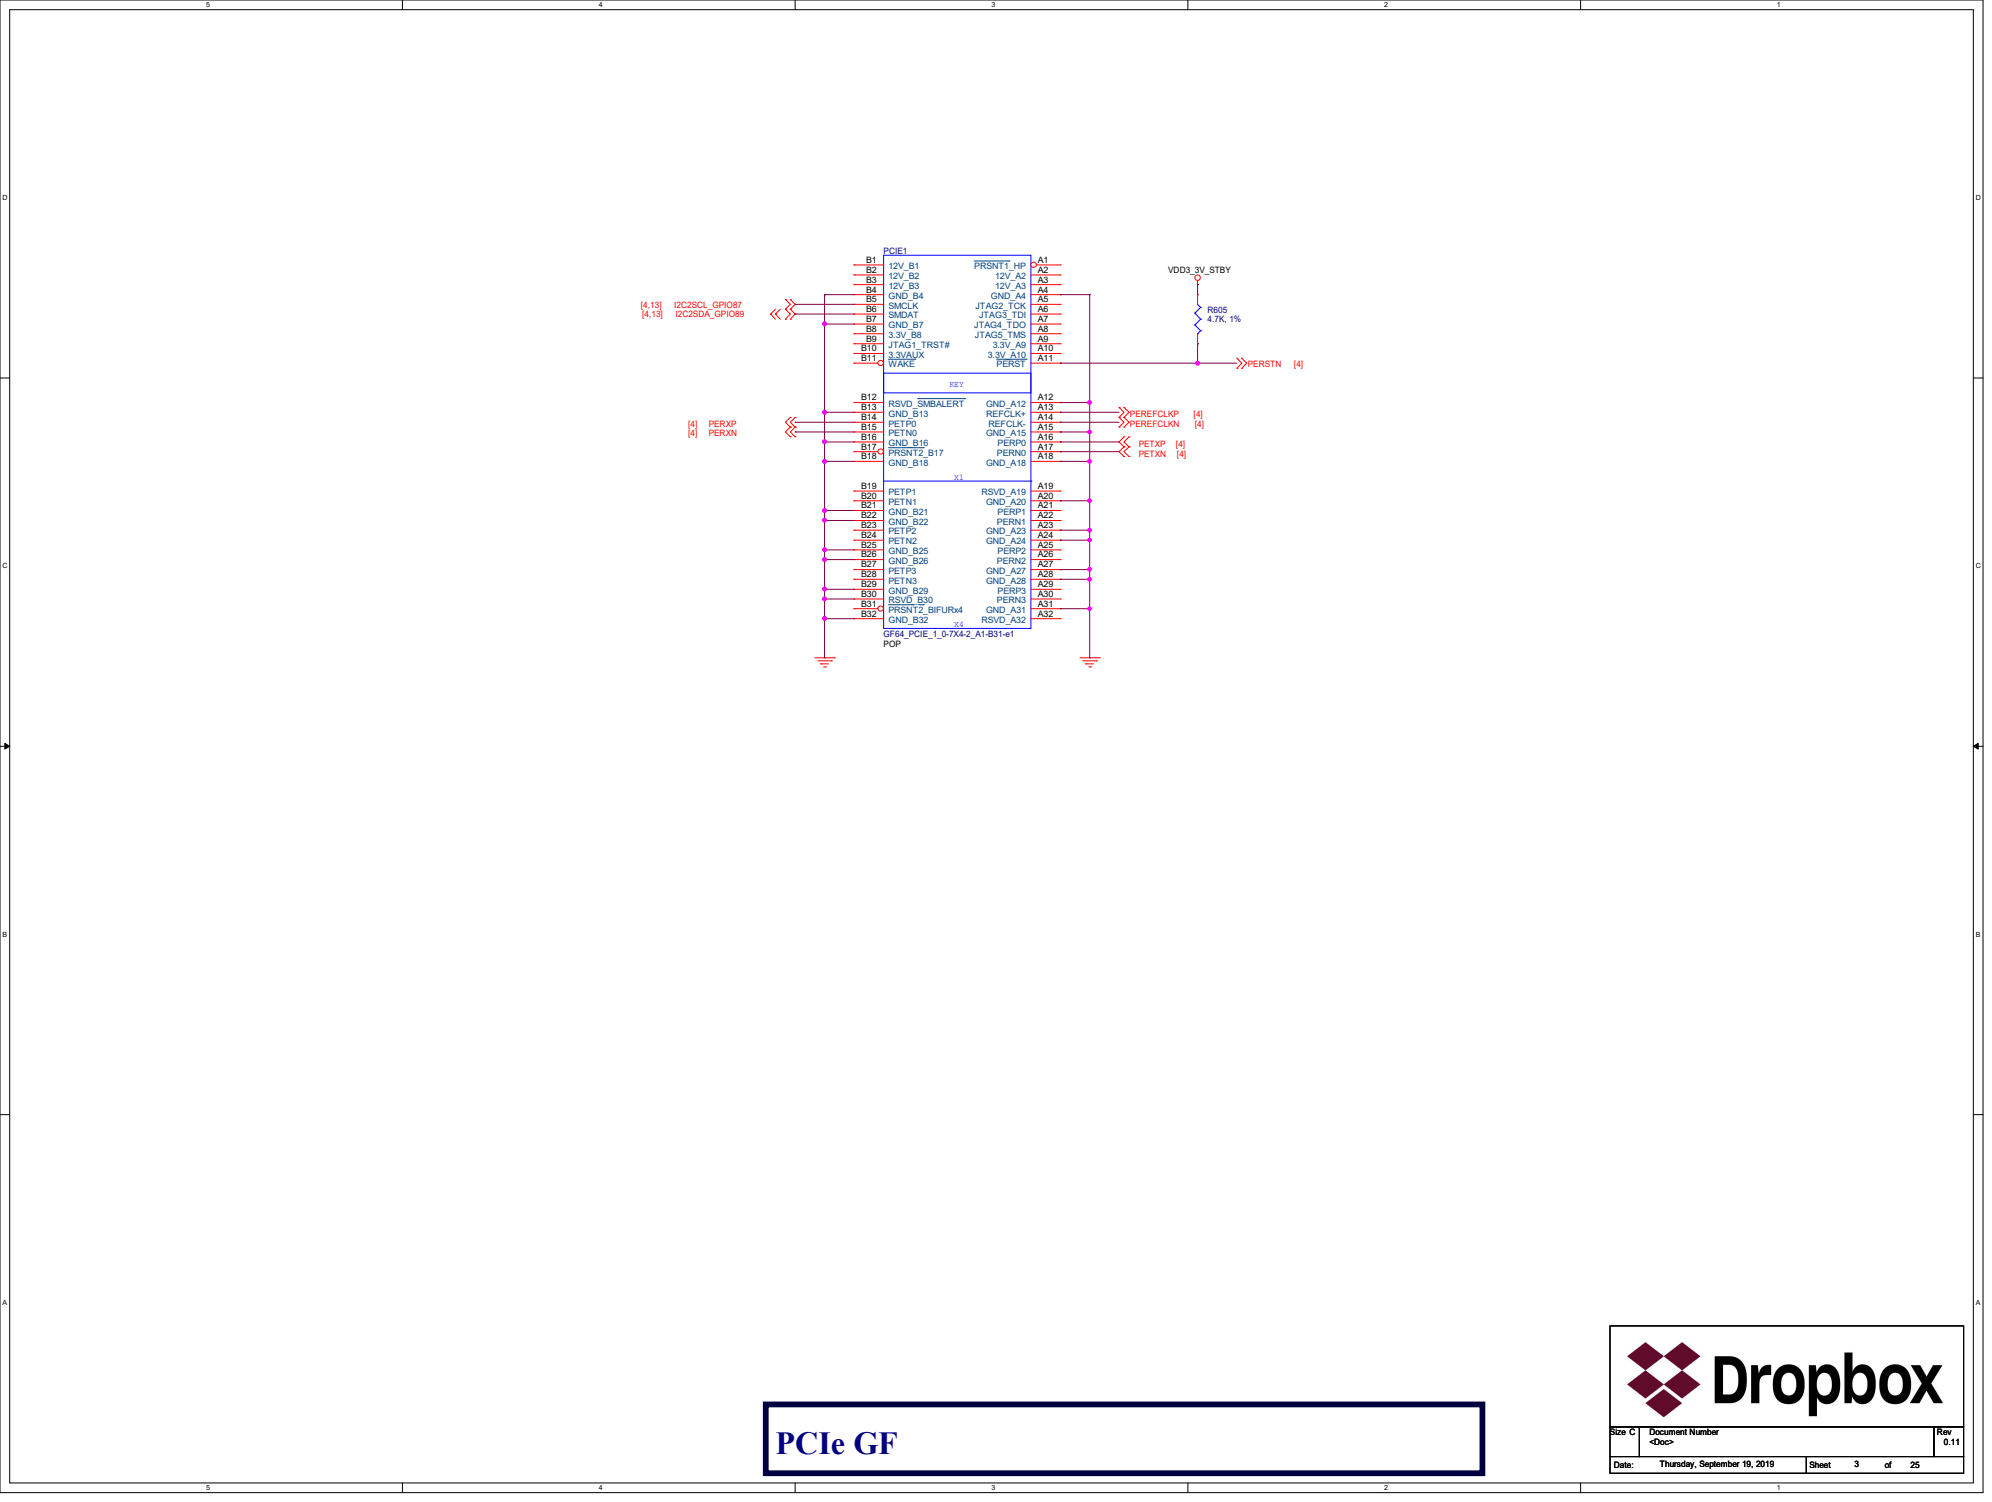
[picture p81: page 3]
PCIe GF; VDD3_3V_STBY; I2C2SCL_GPIO87; I2C2SDA_GPIO89; PERSTN; [4] PEREFCLKP; [4] PERXP; PEREFCLKN; [4] PERXN; PETXP [4] PETXN [4]; Size; Document Number; Rev Date:; Sheet; of <Doc>; Thursday, September 19, 2019; 25 Size; KEY; PRSNT1_HP A1 12V_A2 A2 12V_A3 A3 GND_A4 A4; JTAG2_TCK A5 JTAG3_TDI A6; JTAG4_TDO; JTAG5_TMS A8 3.3V_A9 A9; 12V_B1 B1 12V_B2 B2 12V_B3 B3 GND_B4 B4 SMCLK B5 SMDAT B6 GND_B7 B7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

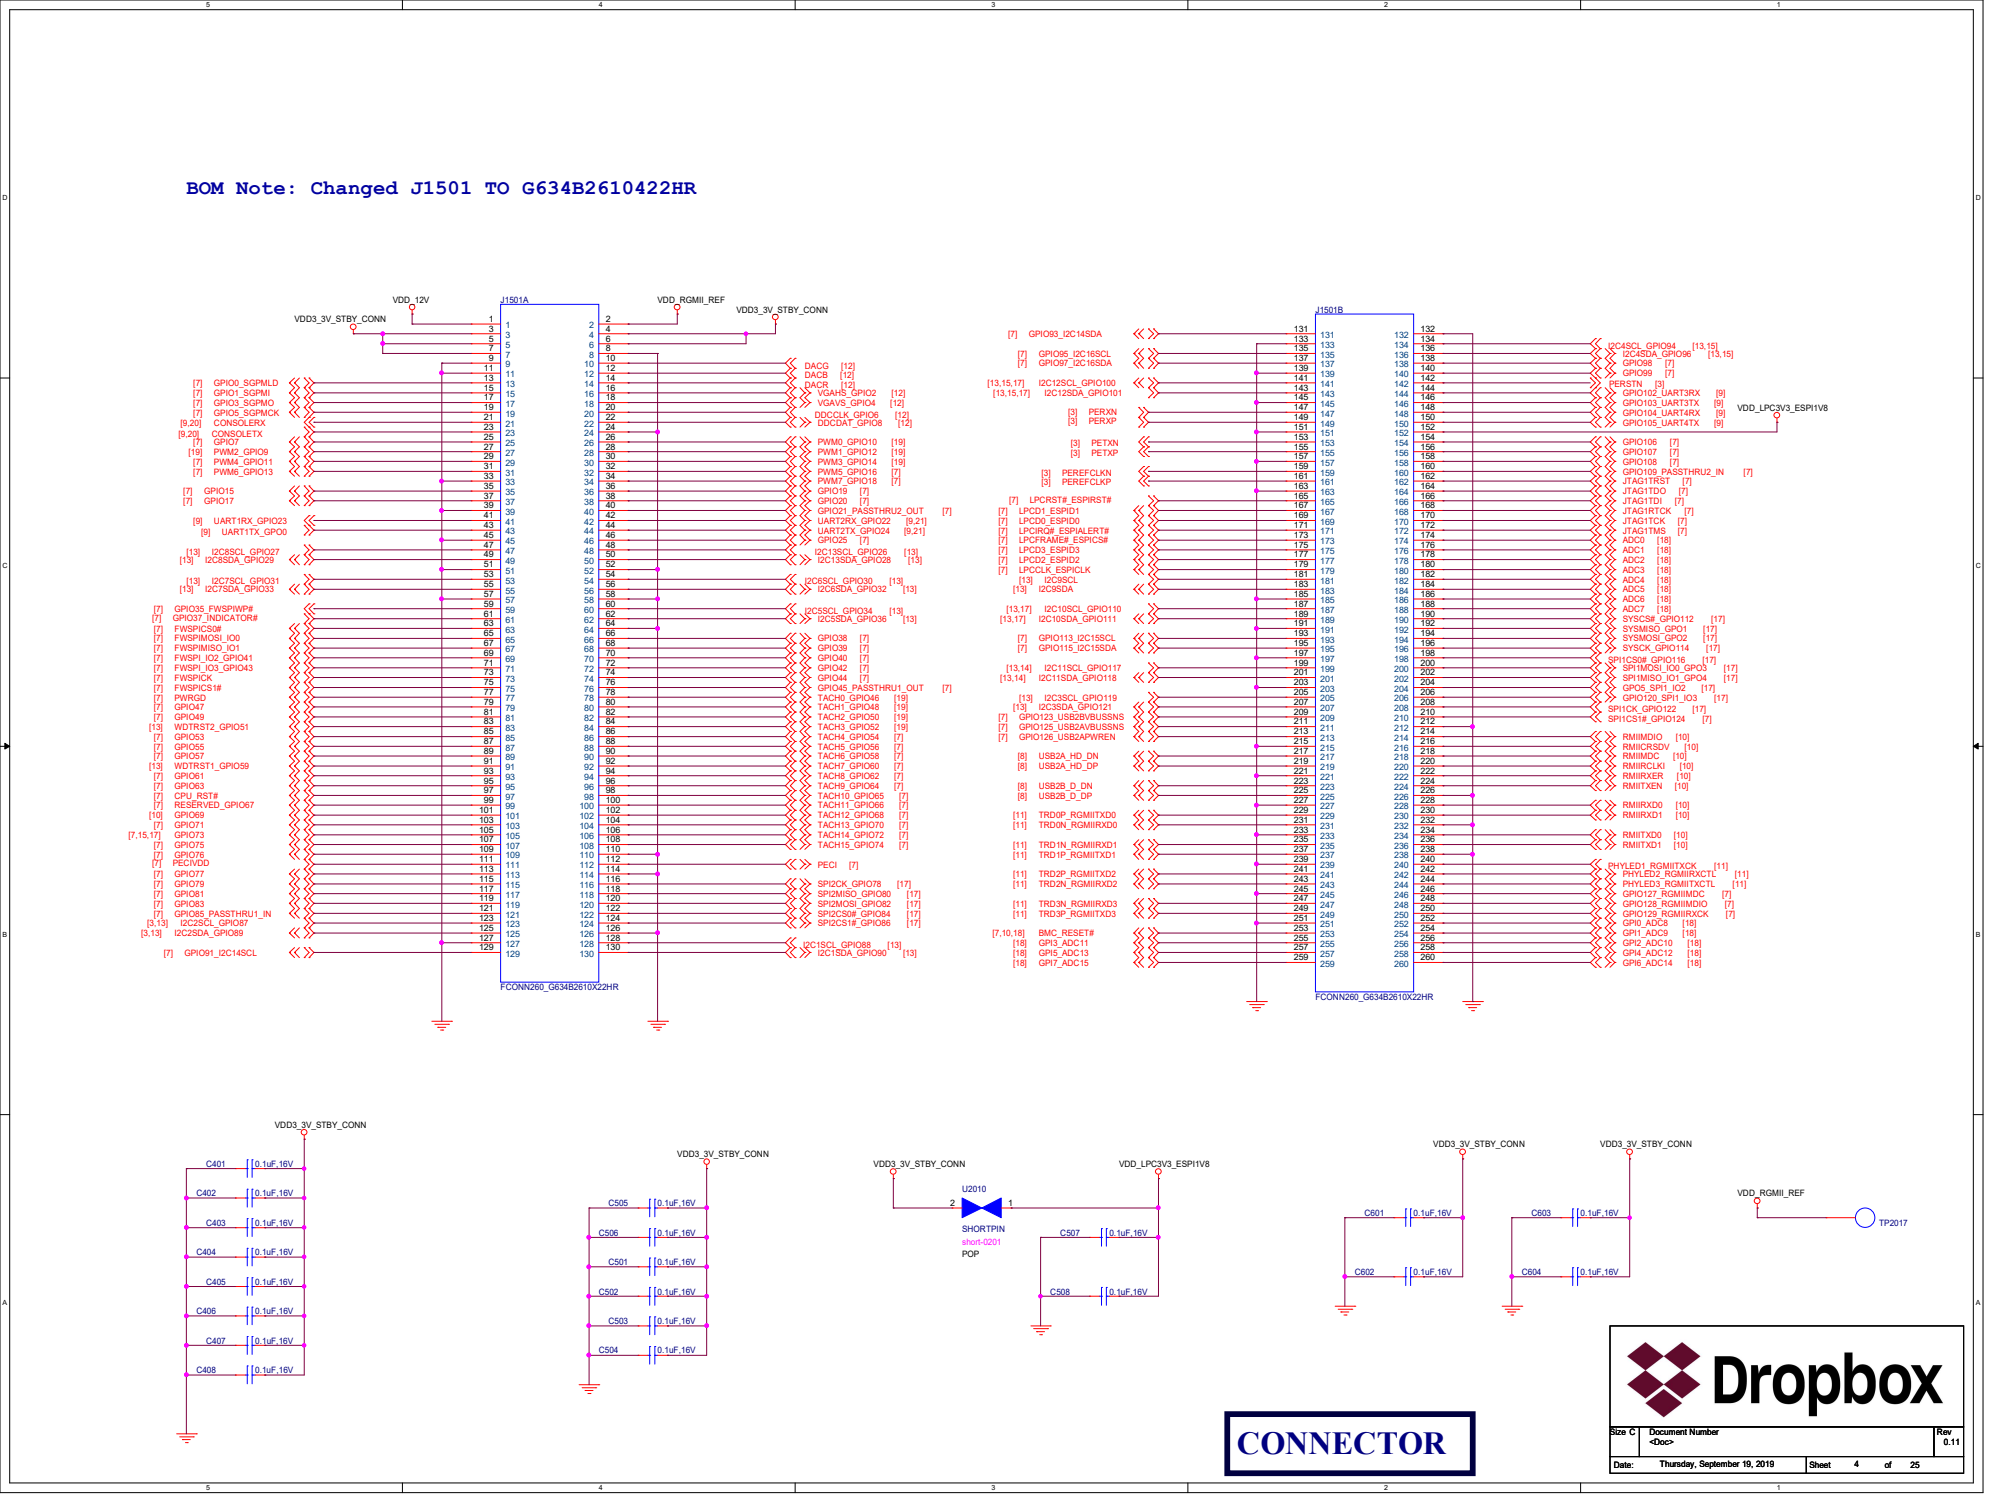
[picture p82: page 4]

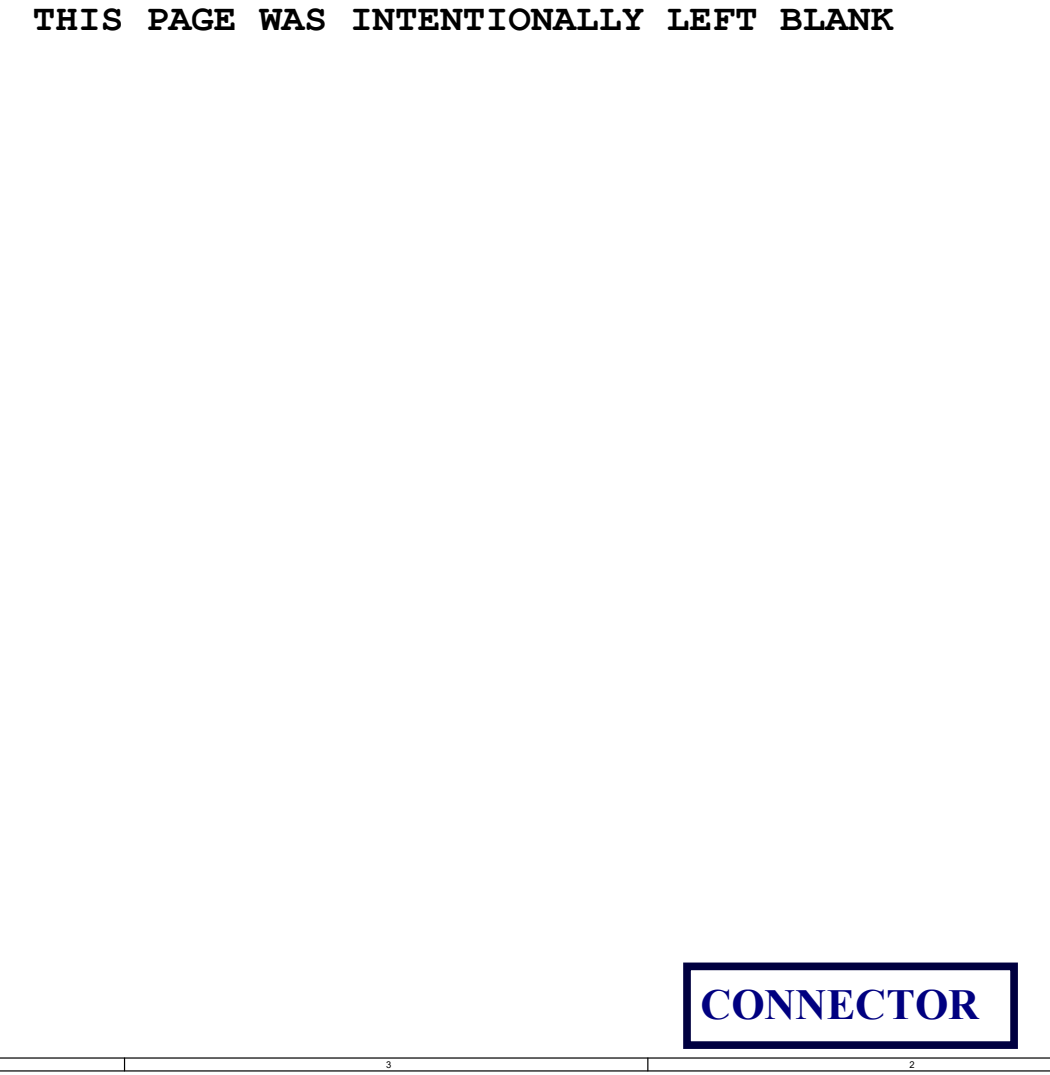
[picture p83: page 5]
CONNECTOR

THIS PAGE WAS INTENTIONALLY LEFT BLANK

Document Number Document Number Thursday, September 19, 2019 Thursday, September 19, 2019 Sheet Sheet 5 5 of <Doc> of <Doc> 25 Size 25 Size | Rev Date: Rev Date: 0.11 C 0.11 C

Thursday, September 19, 2019 | 5 25

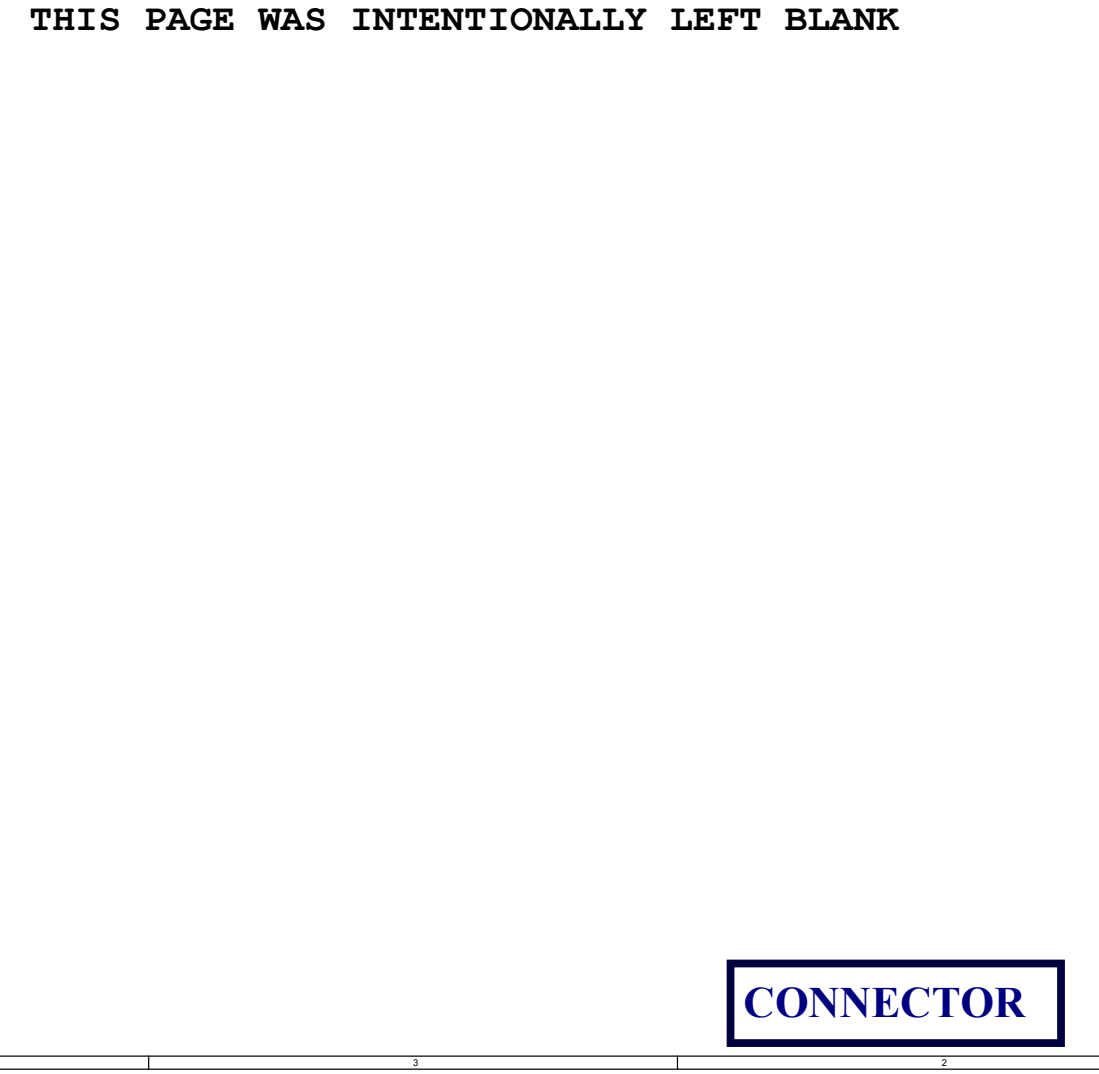
[picture p84: page 6]
CONNECTOR

THIS PAGE WAS INTENTIONALLY LEFT BLANK

Document Number Document Number Thursday, September 19, 2019 Thursday, September 19, 2019 Sheet Sheet 6 6 of <Doc> of <Doc> 25 Size 25 Size | Rev Date: Rev Date: 0.11 C 0.11 C

Thursday, September 19, 2019 | 6 25

LPC | PECI JTAG

# J705 HTST-110-01-L-D

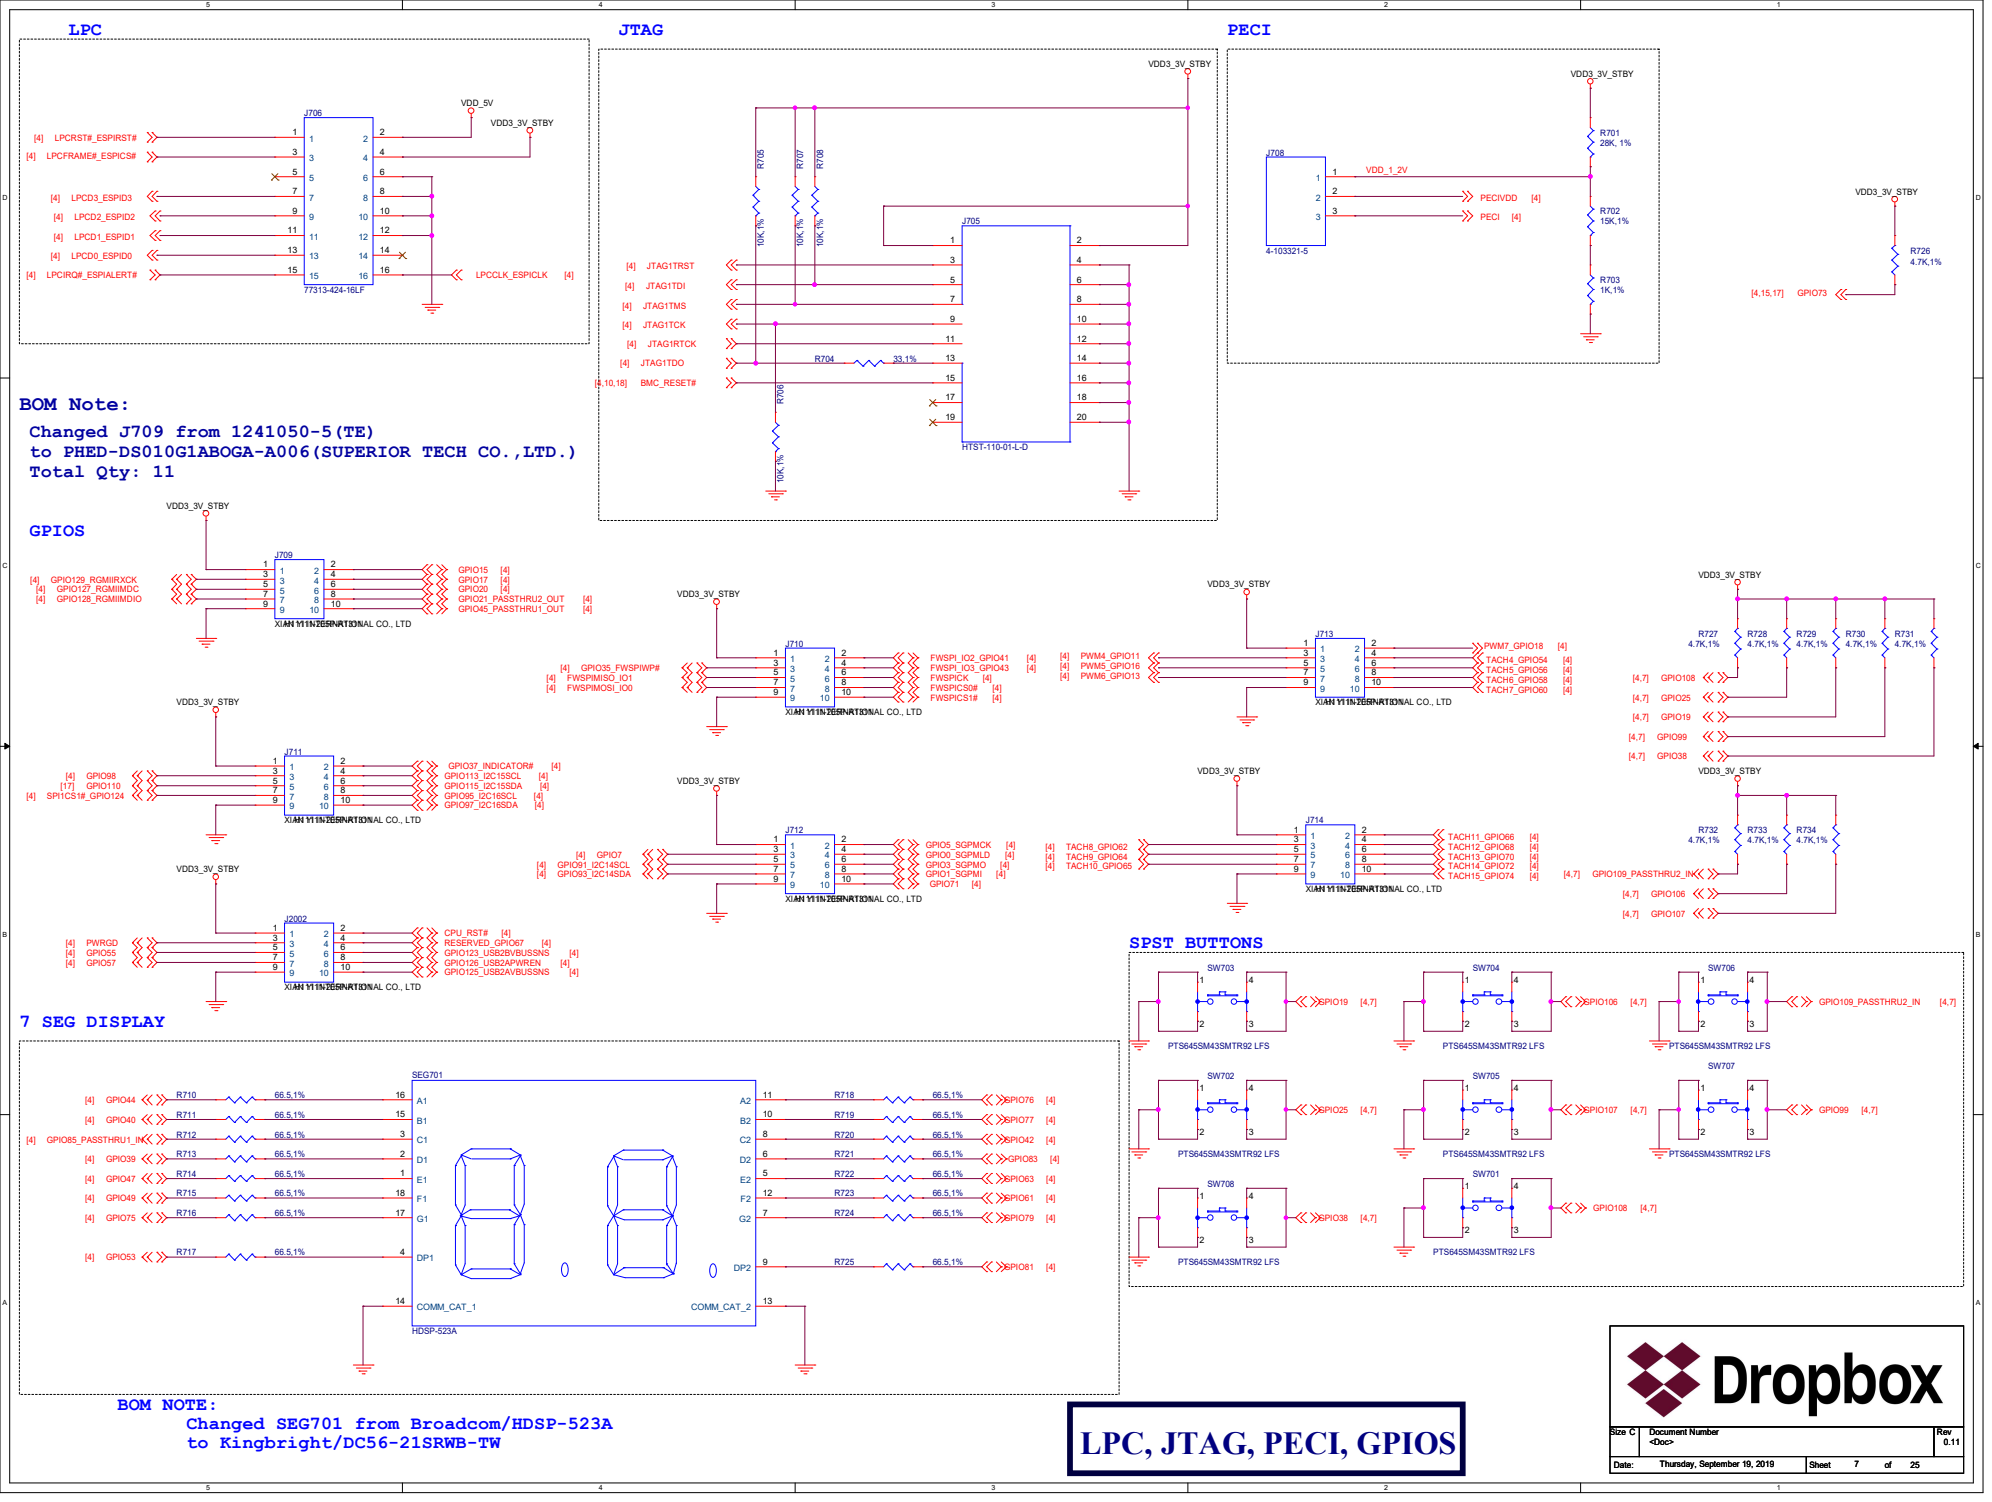
[picture p85: page 7]

BOM Note:
Changed J709 from 1241050-5(TE)
to PHED-DS010G1ABOGA-A006(SUPERIOR TECH CO.,LTD.)
Total Qty: 11

Changed SEG701 from Broadcom/HDSP-523A
to Kingbright/DC56-21SRWB-TW

LPC, JTAG, PECI, GPIOS

P5V_USB1 | CHASSIS_USB_1 P5V_USB2 | CHASSIS_USB_2

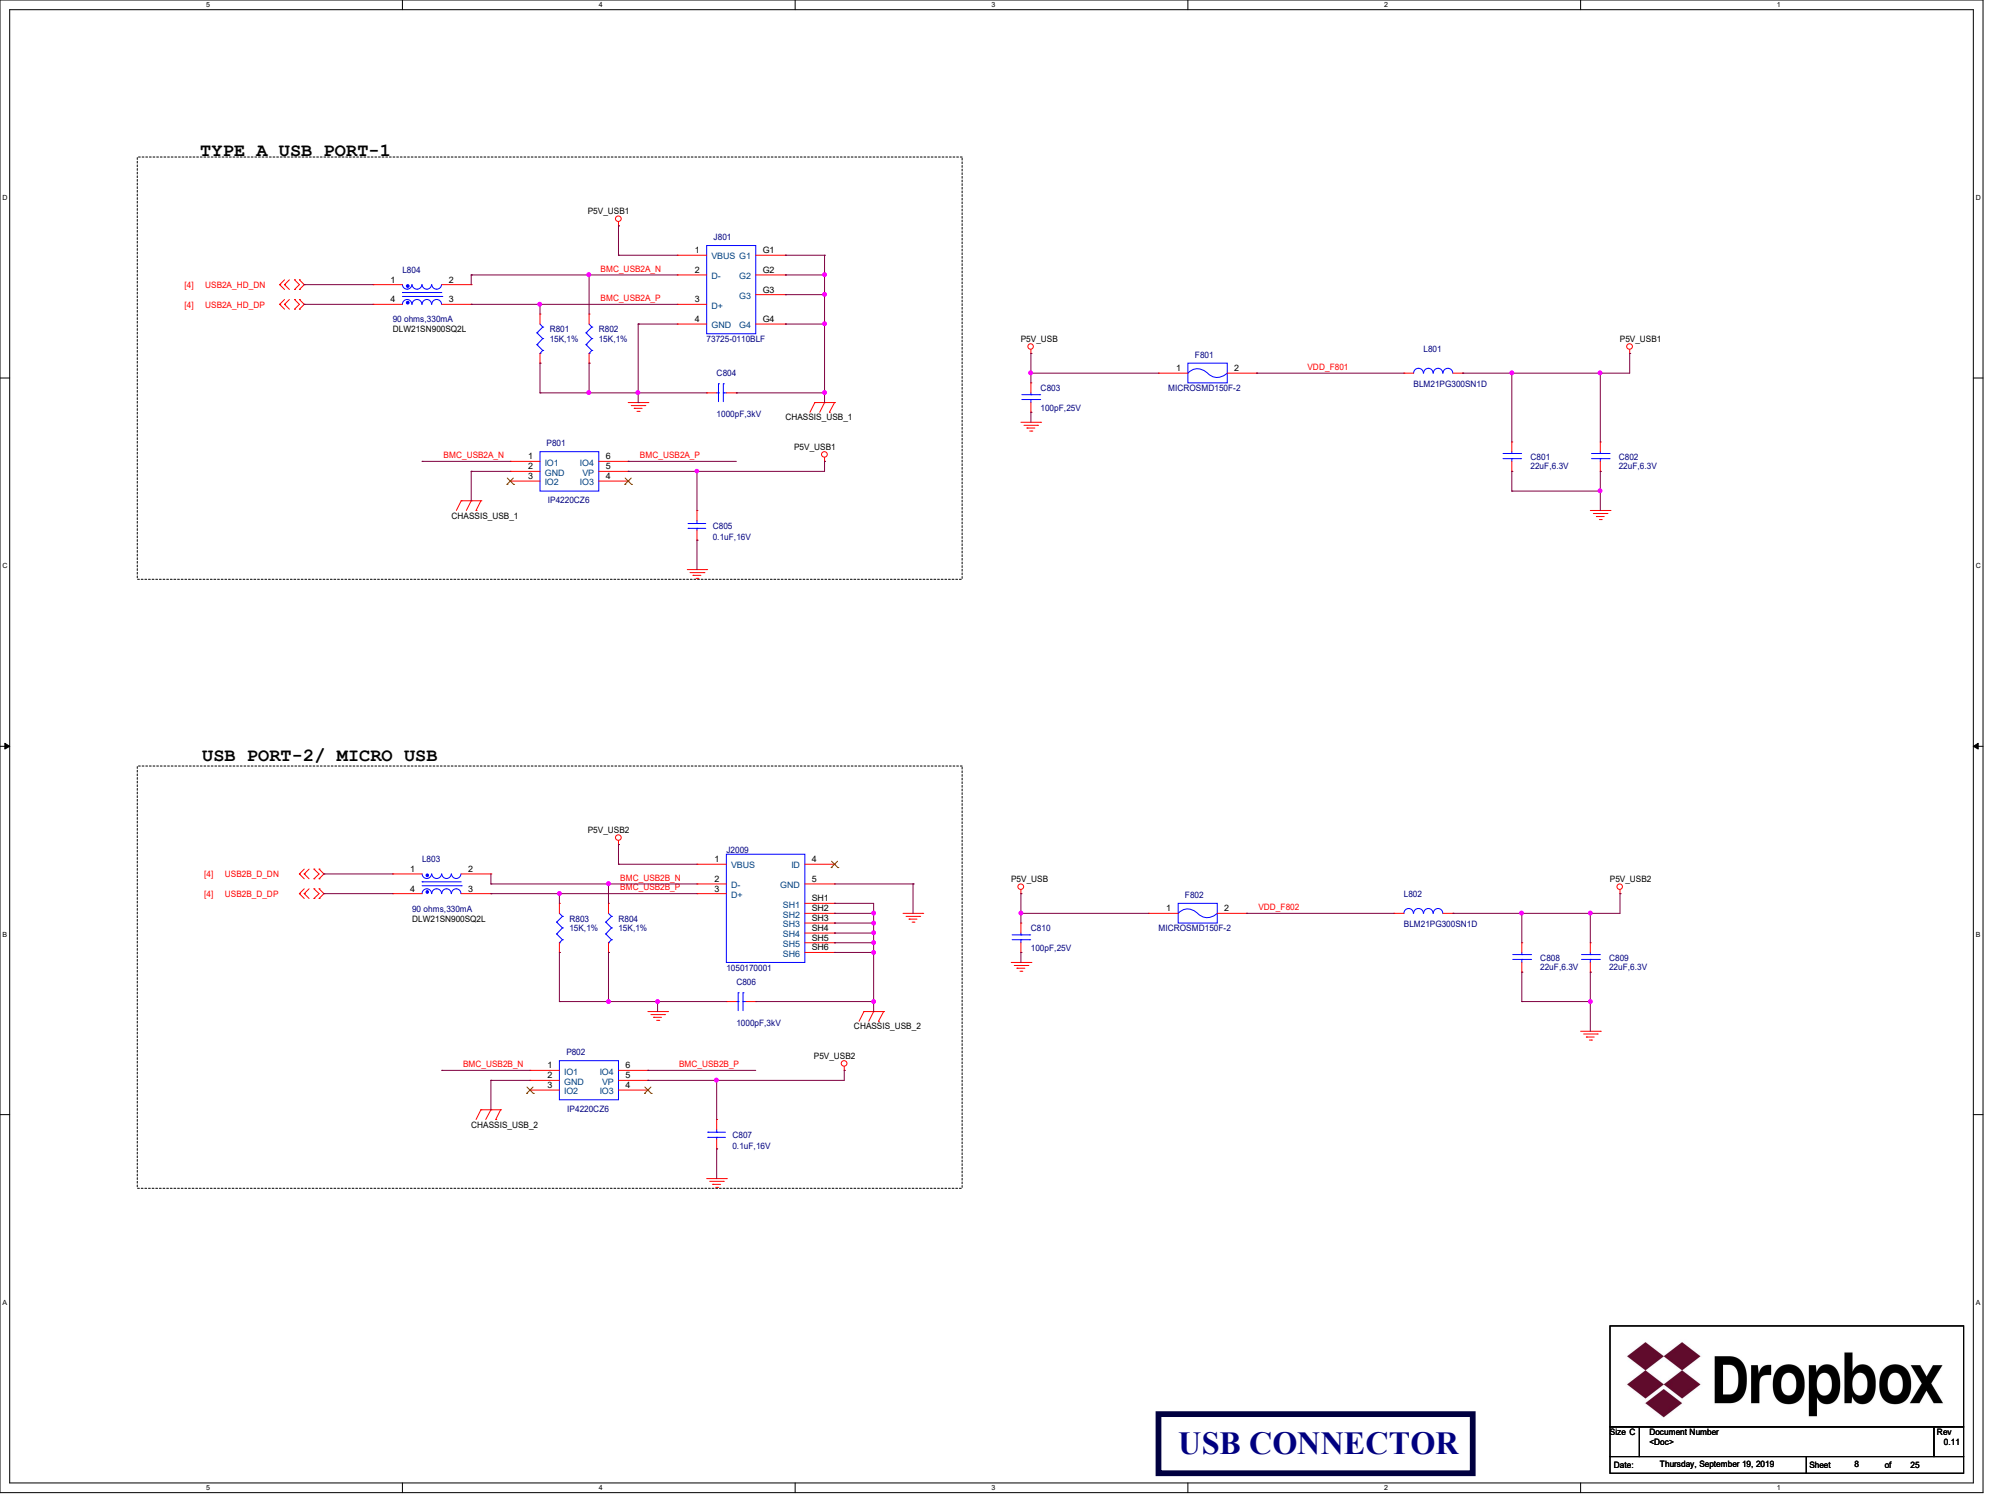
[picture p86: page 8]

USB PORT-2/ MICRO USB

# MAX 3232 -1

# UART CONSOLE -1

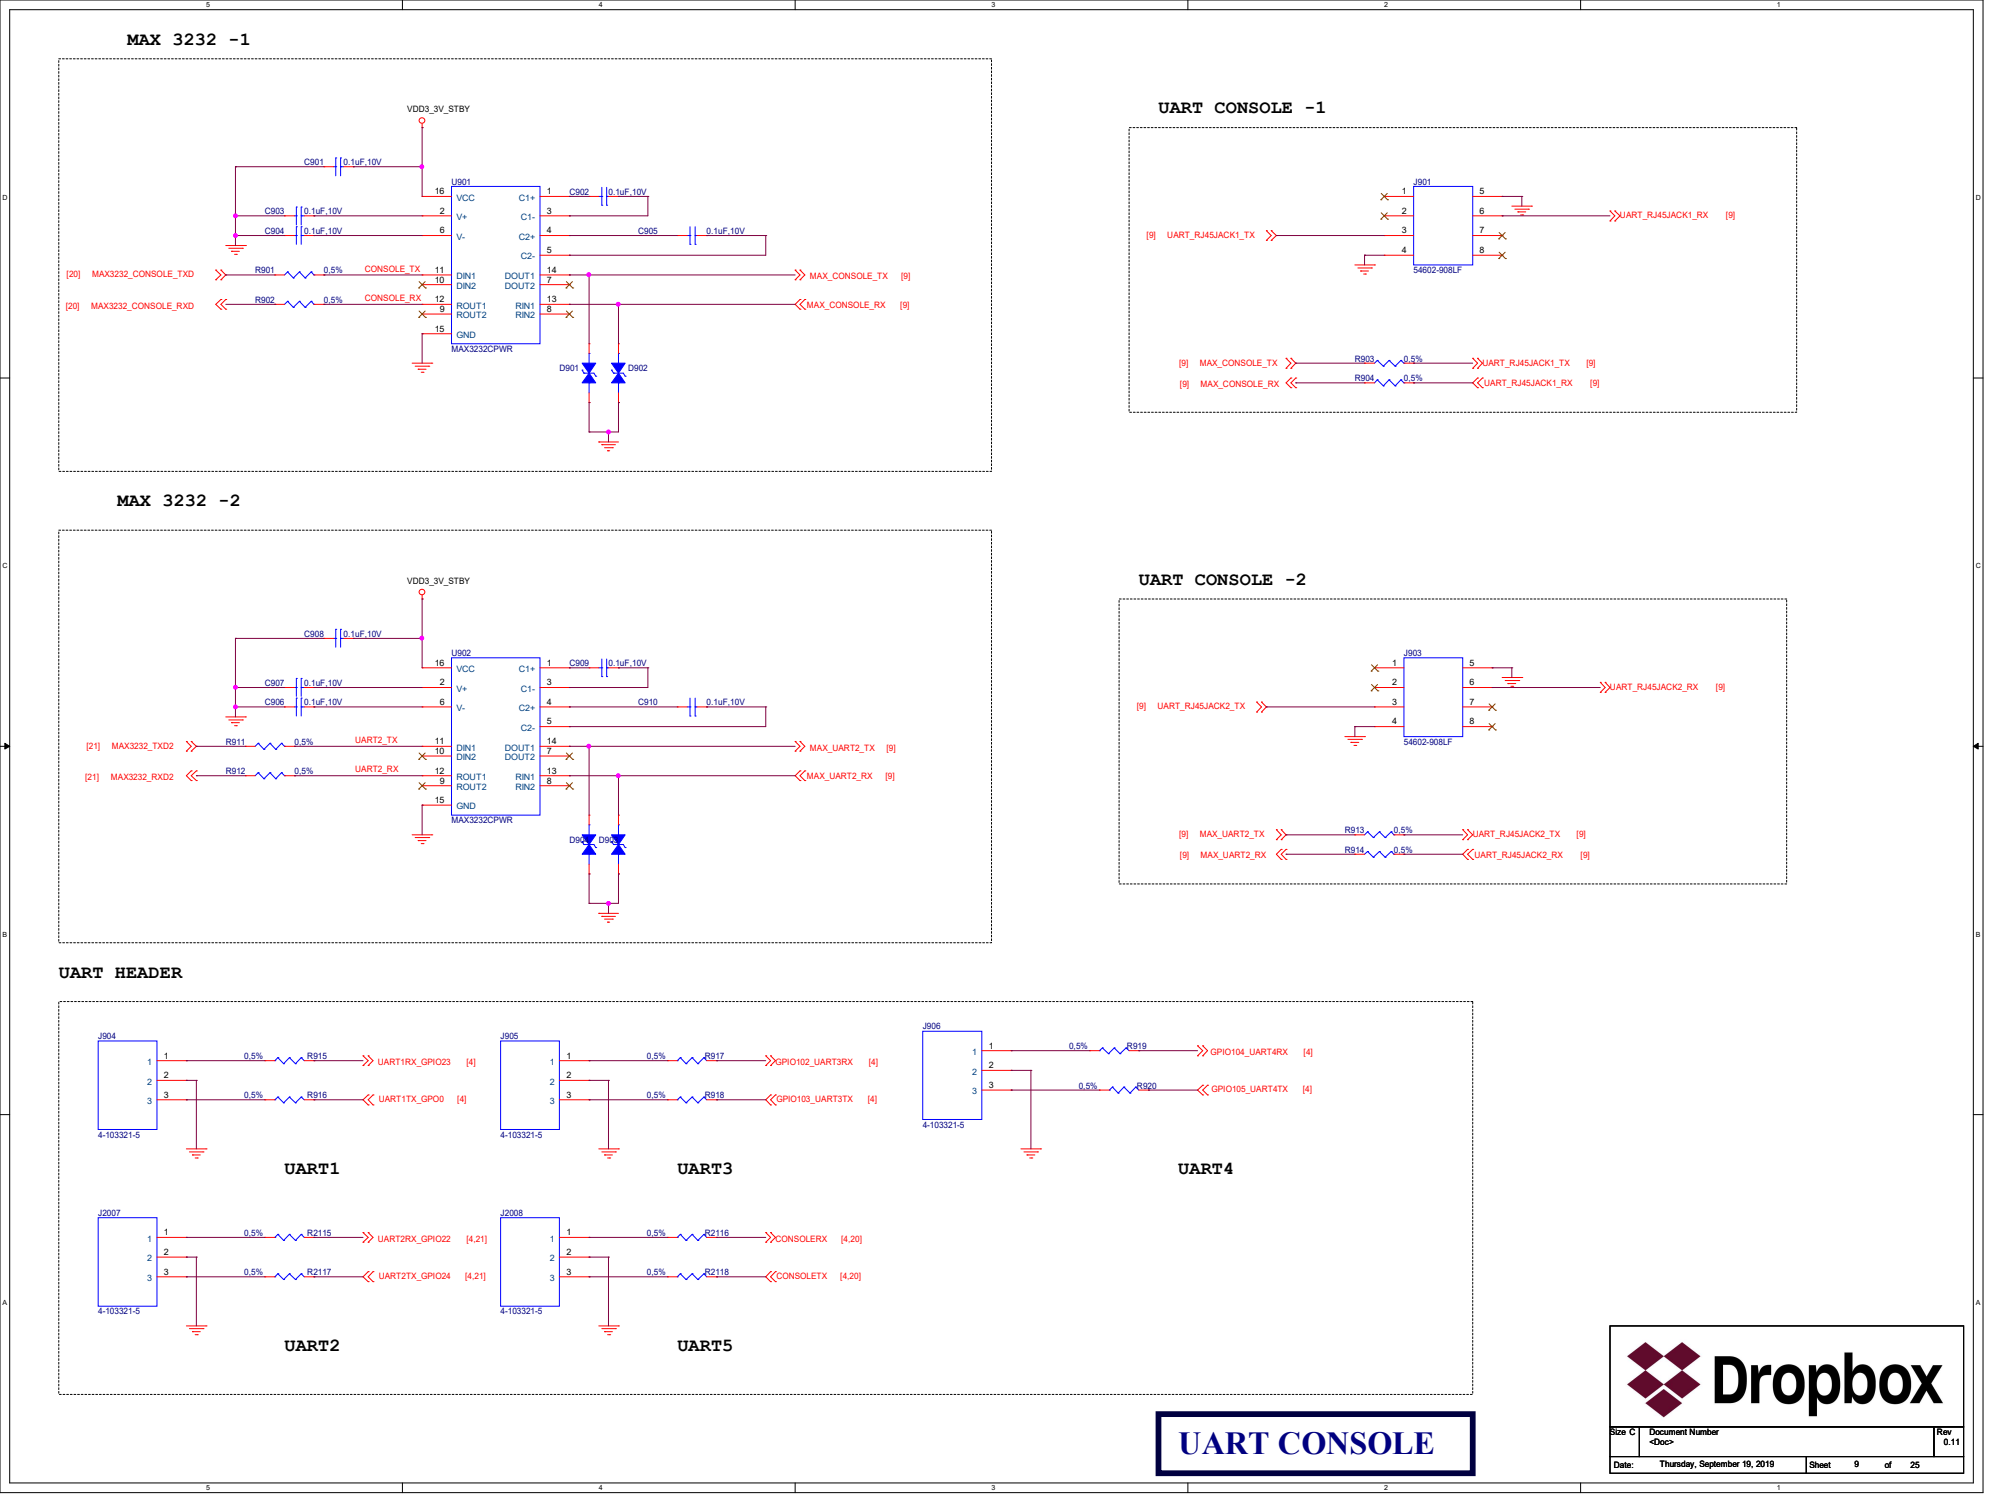
[picture p87: page 9]

# RESET CIRCUIT

# BOM Note:

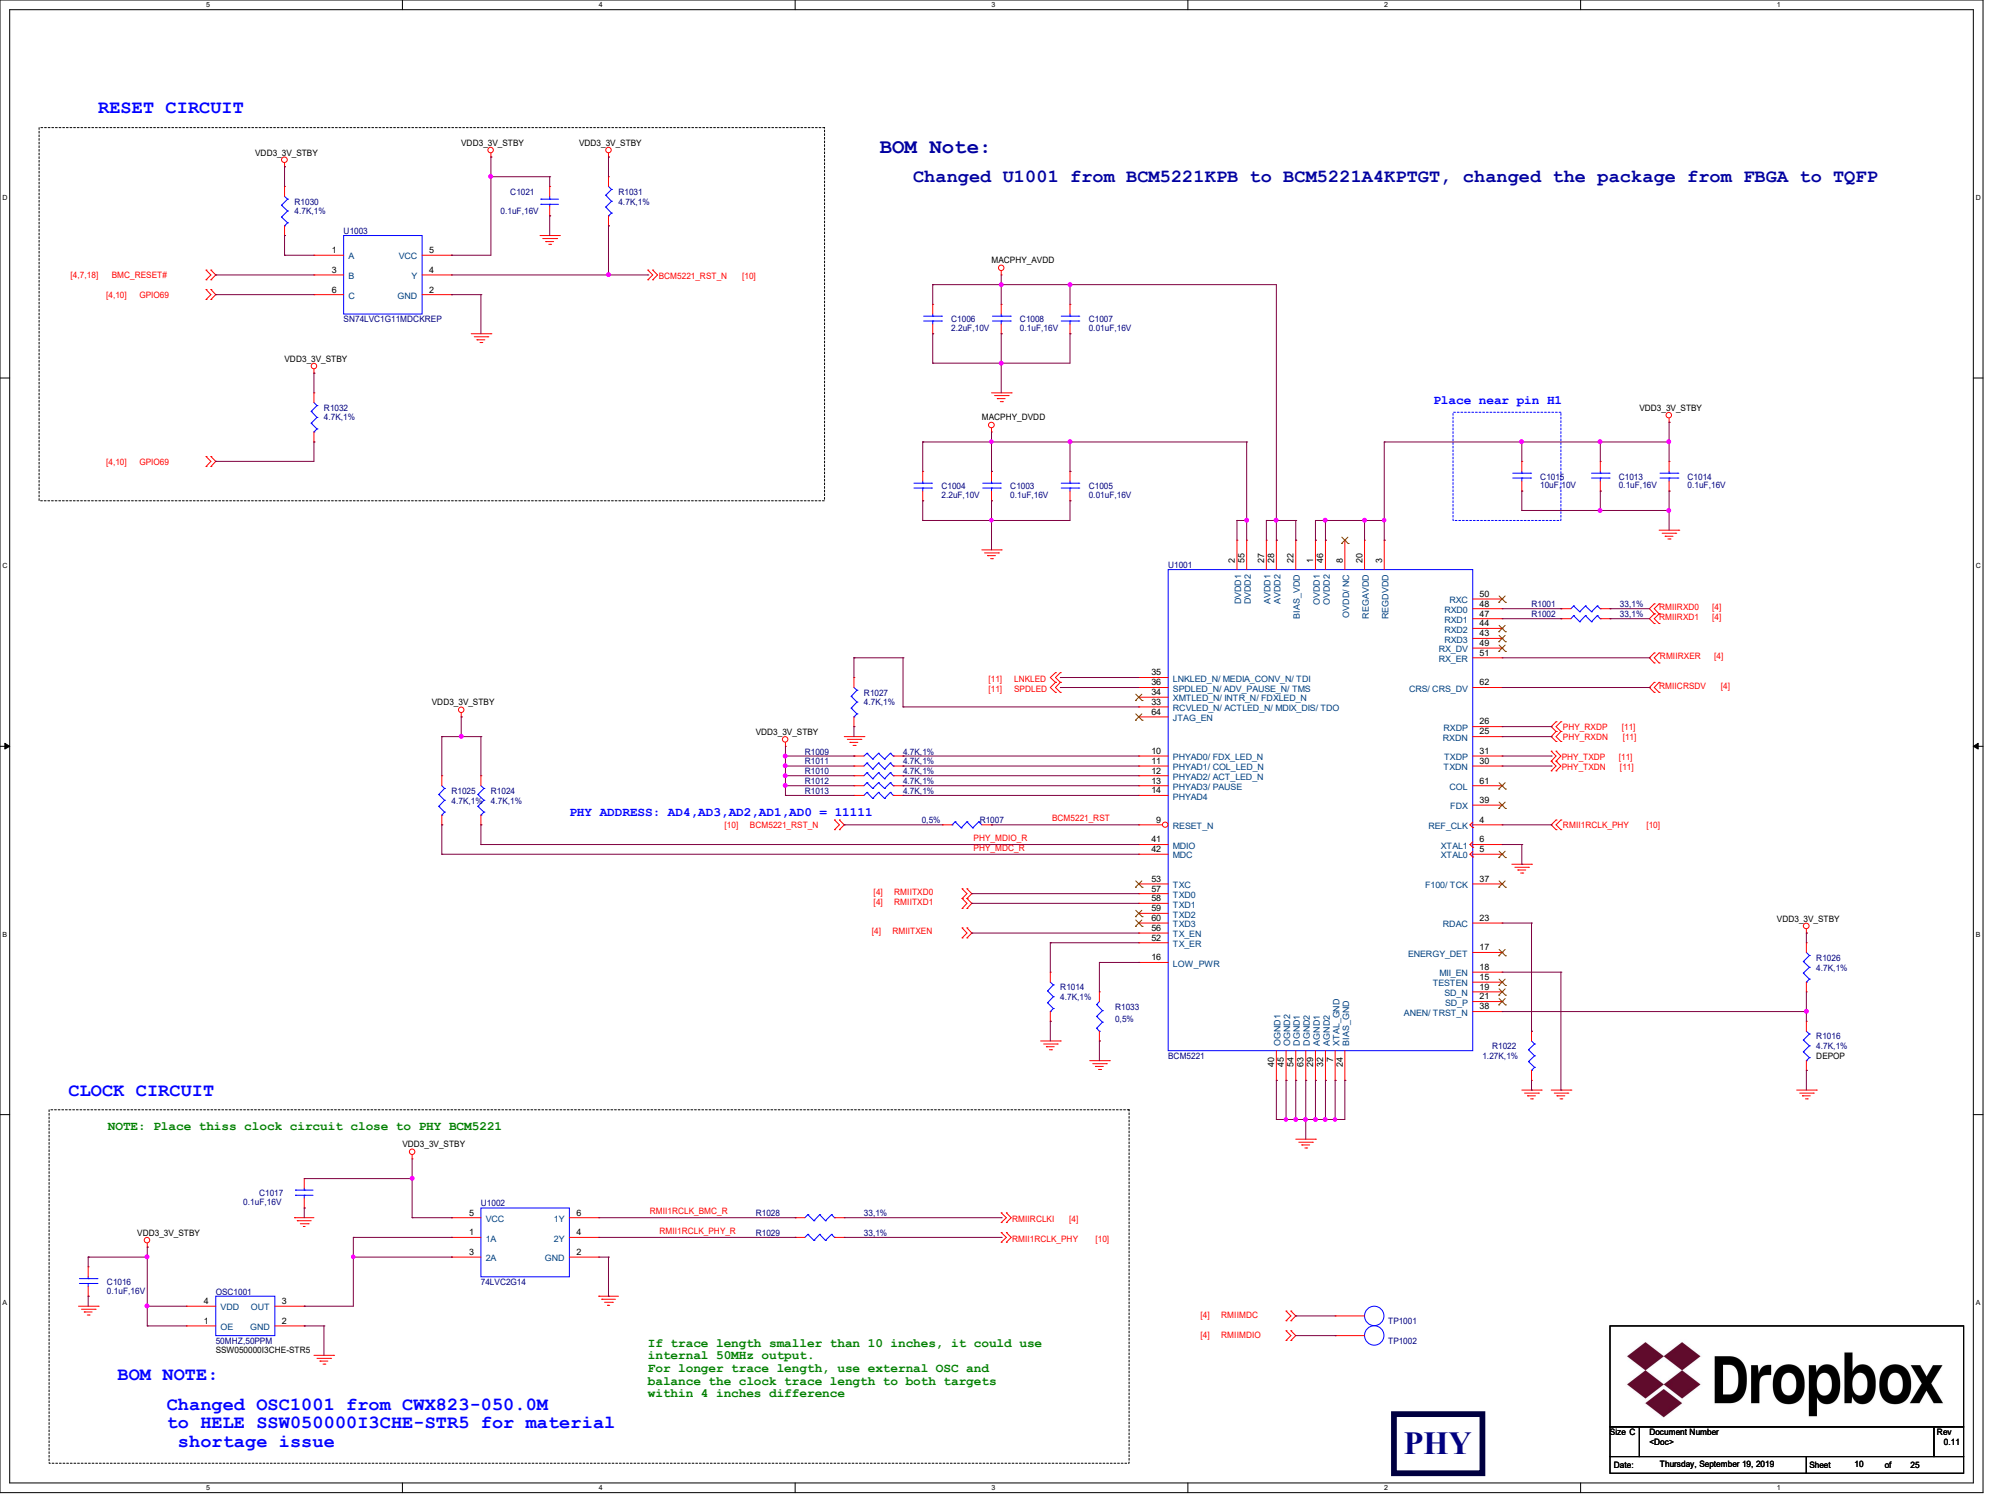
[picture p88: page 10]

Changed U1001 from BCM5221KPB to BCM5221A4KPTGT, changed the package from FBGA to TQFP

1 OVDD2 46 AVDD1 27 AVDD2 28 BIAS_VDD 22 RXC 50 RXD0 48 RXD1 47 RXD2 44 RXD3 43 RX_DV 49 RXDP 26 RXDN 25 TXDP 31 TXDN 30 COL 61 REF_CLK 4 XTAL1 6 XTAL0 5 OVDD/ NC

NOTE: Place thiss clock circuit close to PHY BCM5221

If trace length smaller than 10 inches, it could use
internal 50MHz output.
For longer trace length, use external OSC and
balance the clock trace length to both targets
within 4 inches difference

BOM NOTE:
Changed OSC1001 from CWX823-050.0M
to HELE SSW050000I3CHE-STR5 for material
shortage issue

# RMII RJ45 ETHERNET JACK

From A PHY ON HSBUV | VDD3_3V_STBY

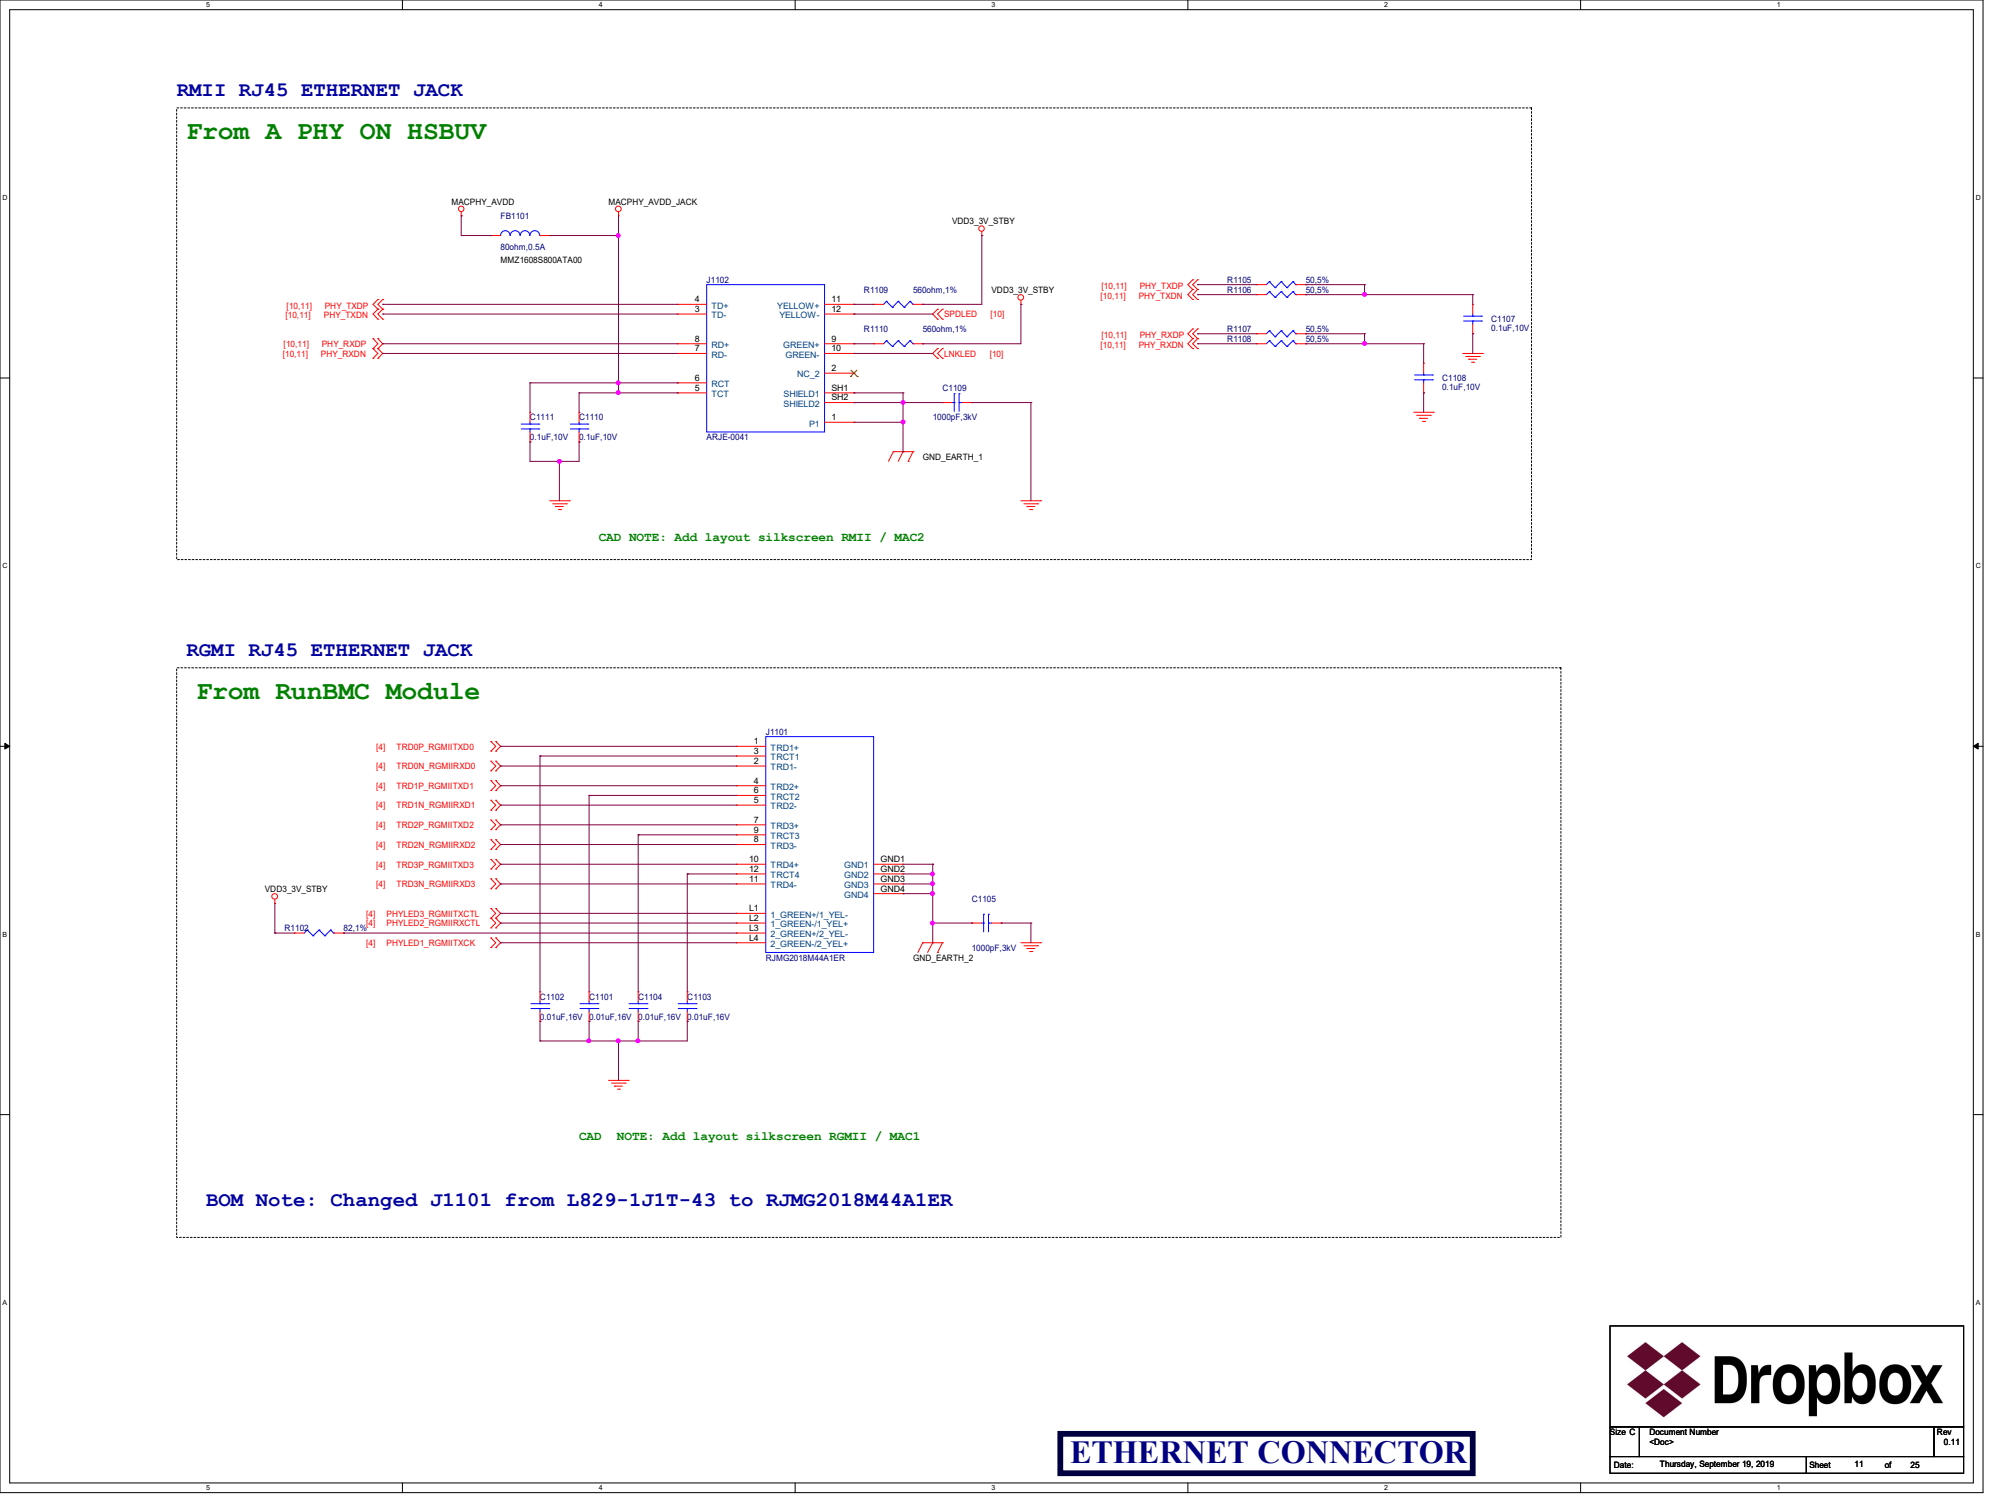
[picture p89: page 11]

CAD NOTE: Add layout silkscreen RMII / MAC2

CAD NOTE: Add layout silkscreen RGMII / MAC1

BOM Note: Changed J1101 from L829-1J1T-43 to RJMG2018M44A1ER

## Design Note: Trace impedance : 50 ohm

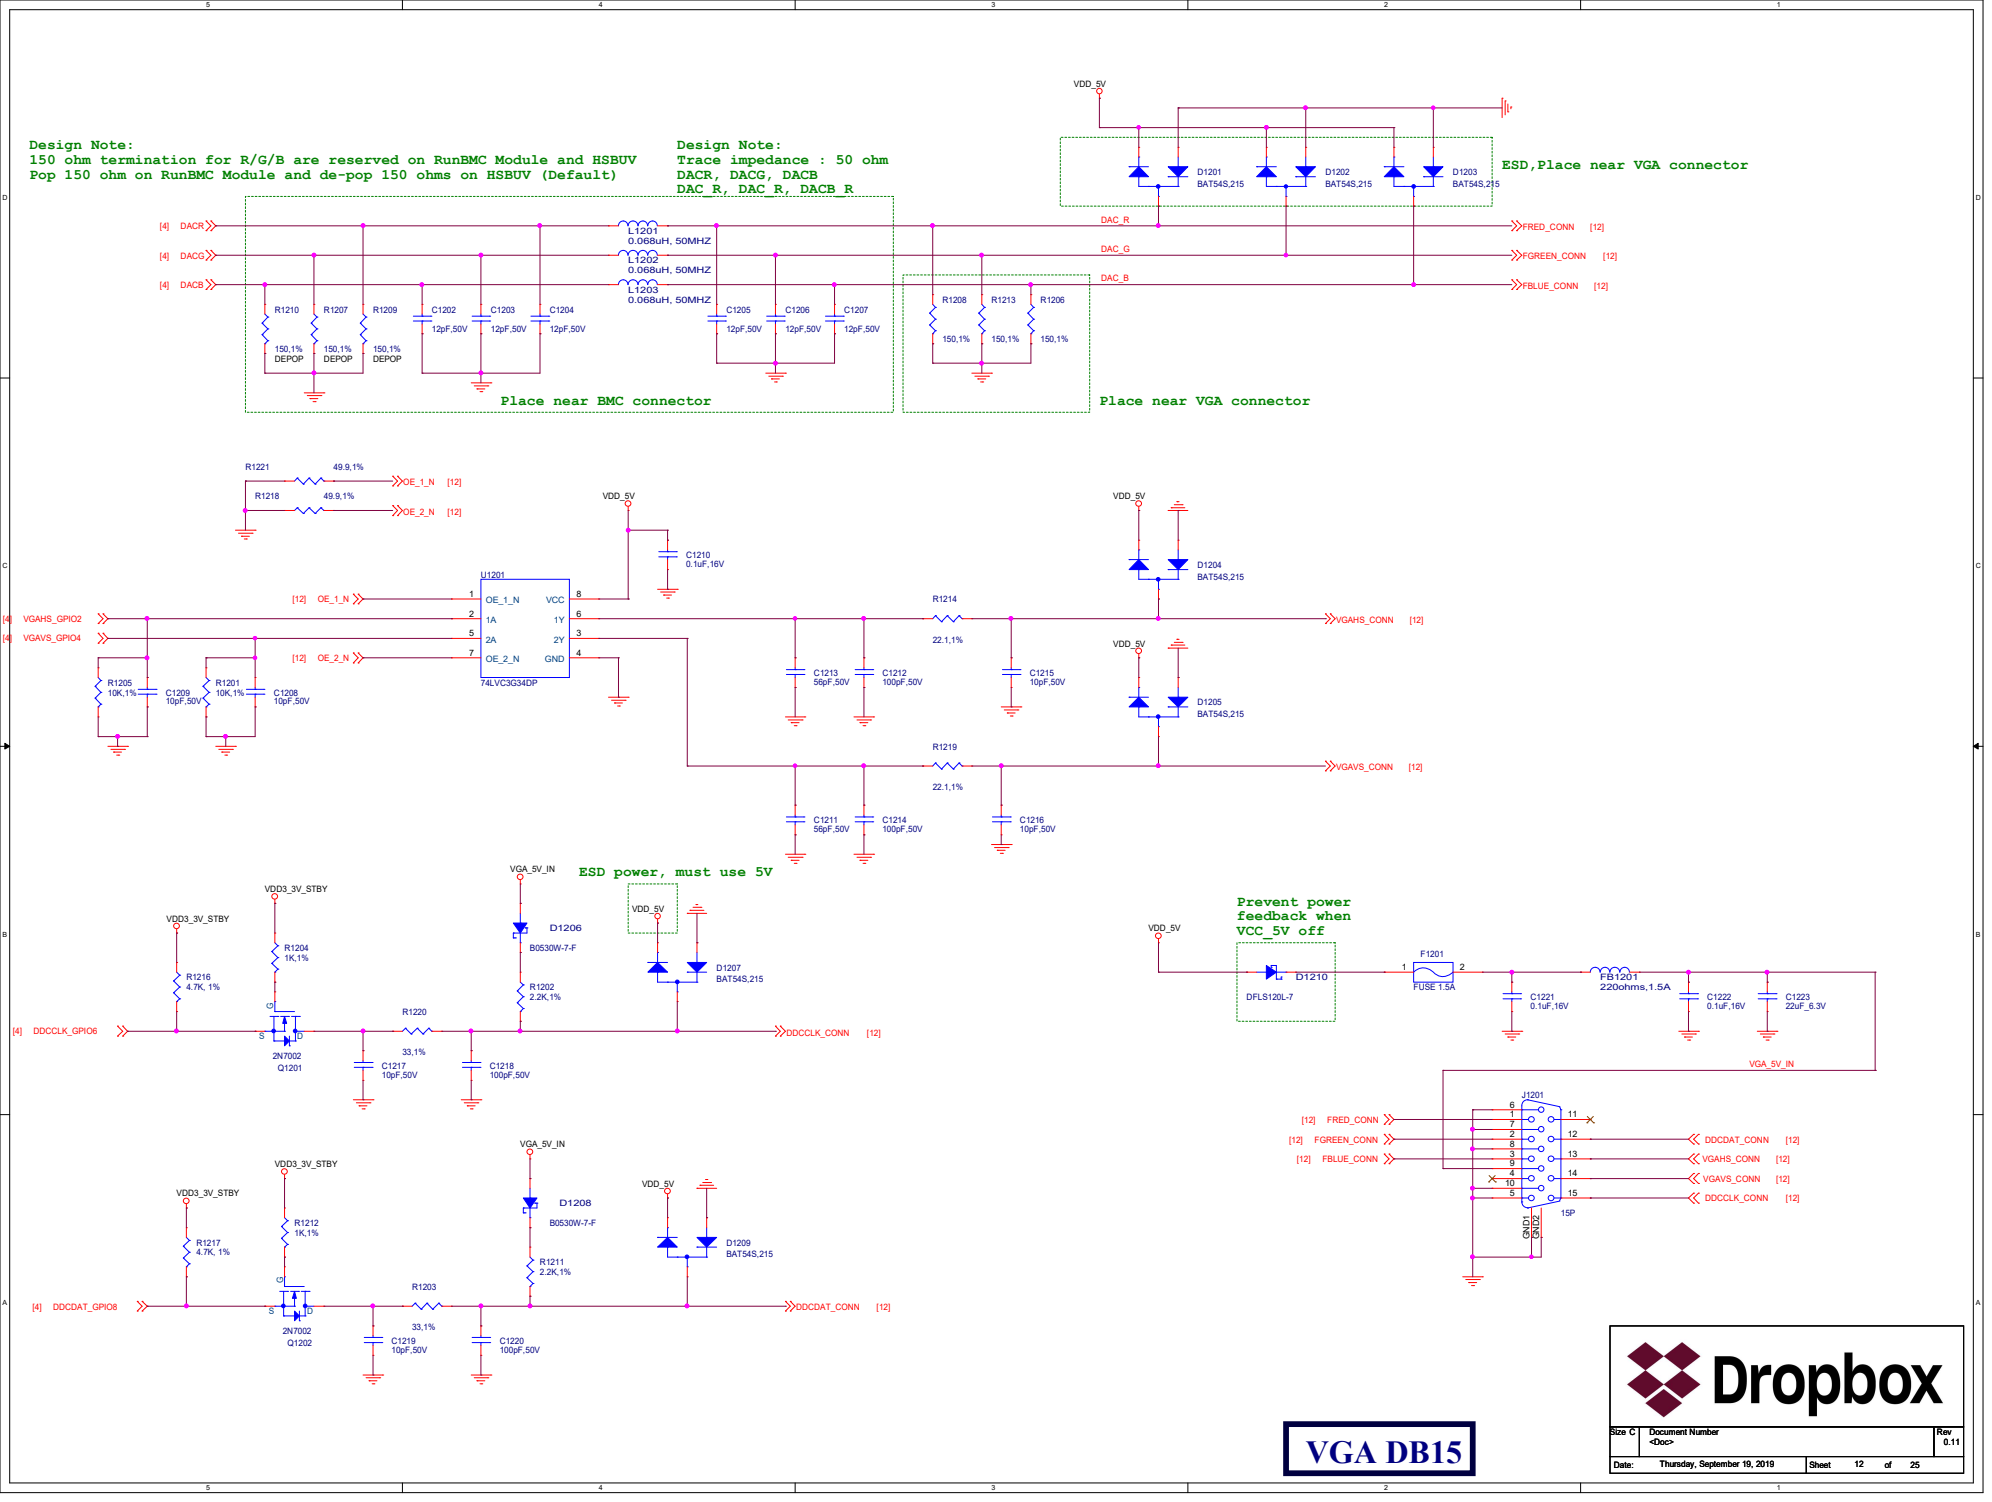
[picture p90: page 12]

Design Note:
150 ohm termination for R/G/B are reserved on RunBMC Module and HSBUV

ESD,Place near VGA connector

ESD power, must use 5V

I2C

## NOTE: Add sikscreen designators for J1301,1302,1303 (I2C1, I2C2, I2C3)

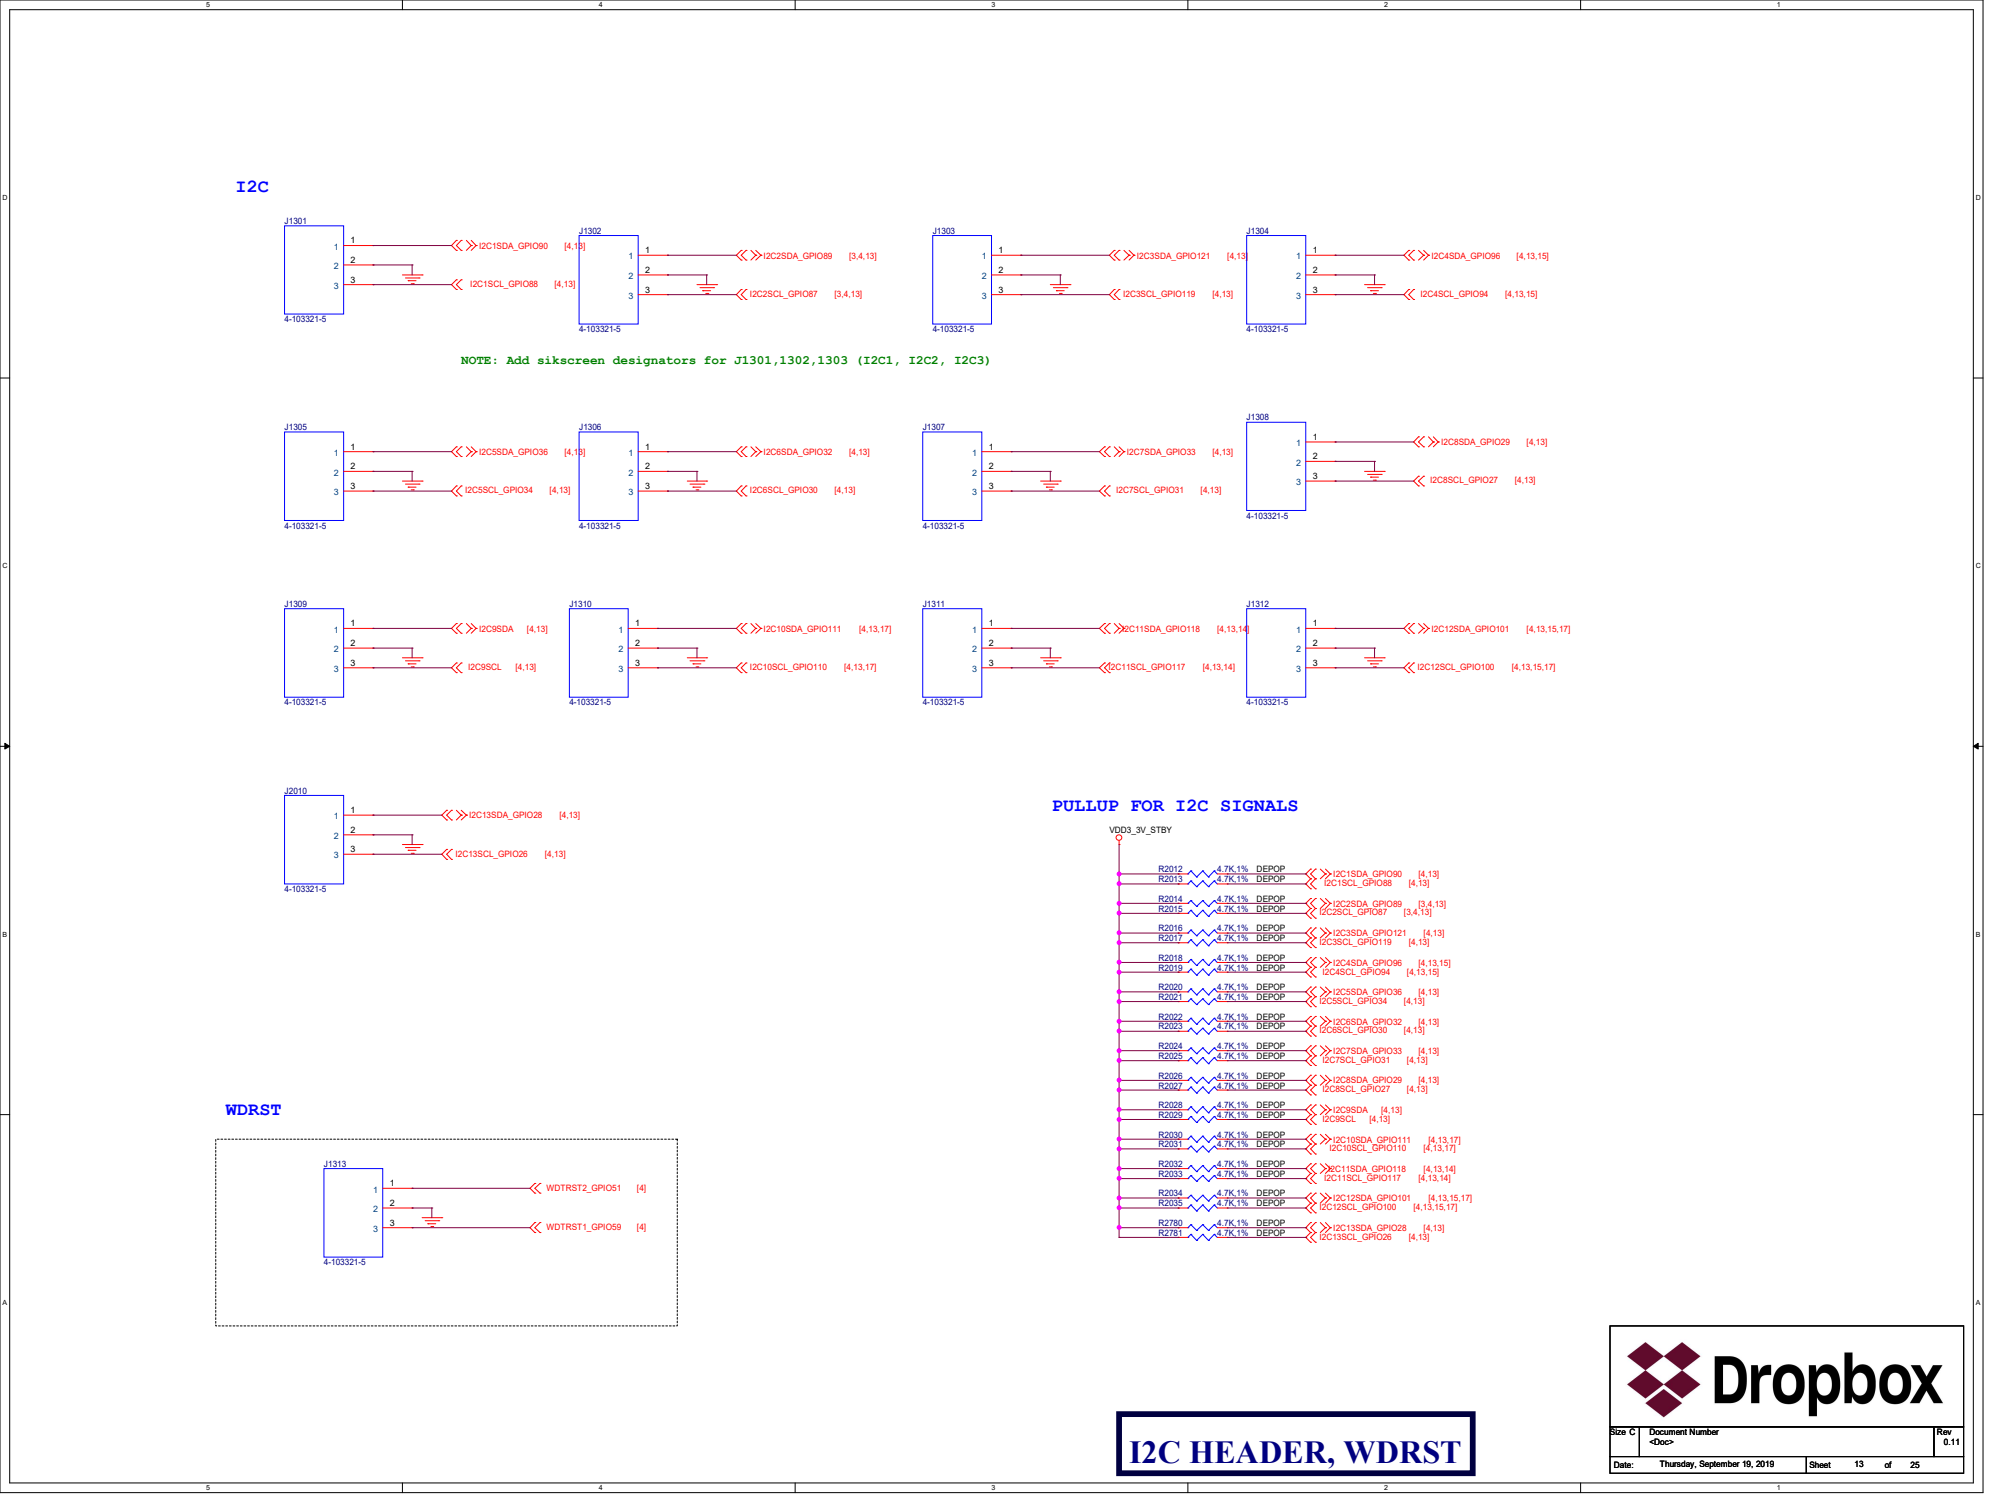
[picture p91: page 13]

# 16 BIT I2C and SMBus I/O EXPANDER

## I2C ADDRESS=0X42

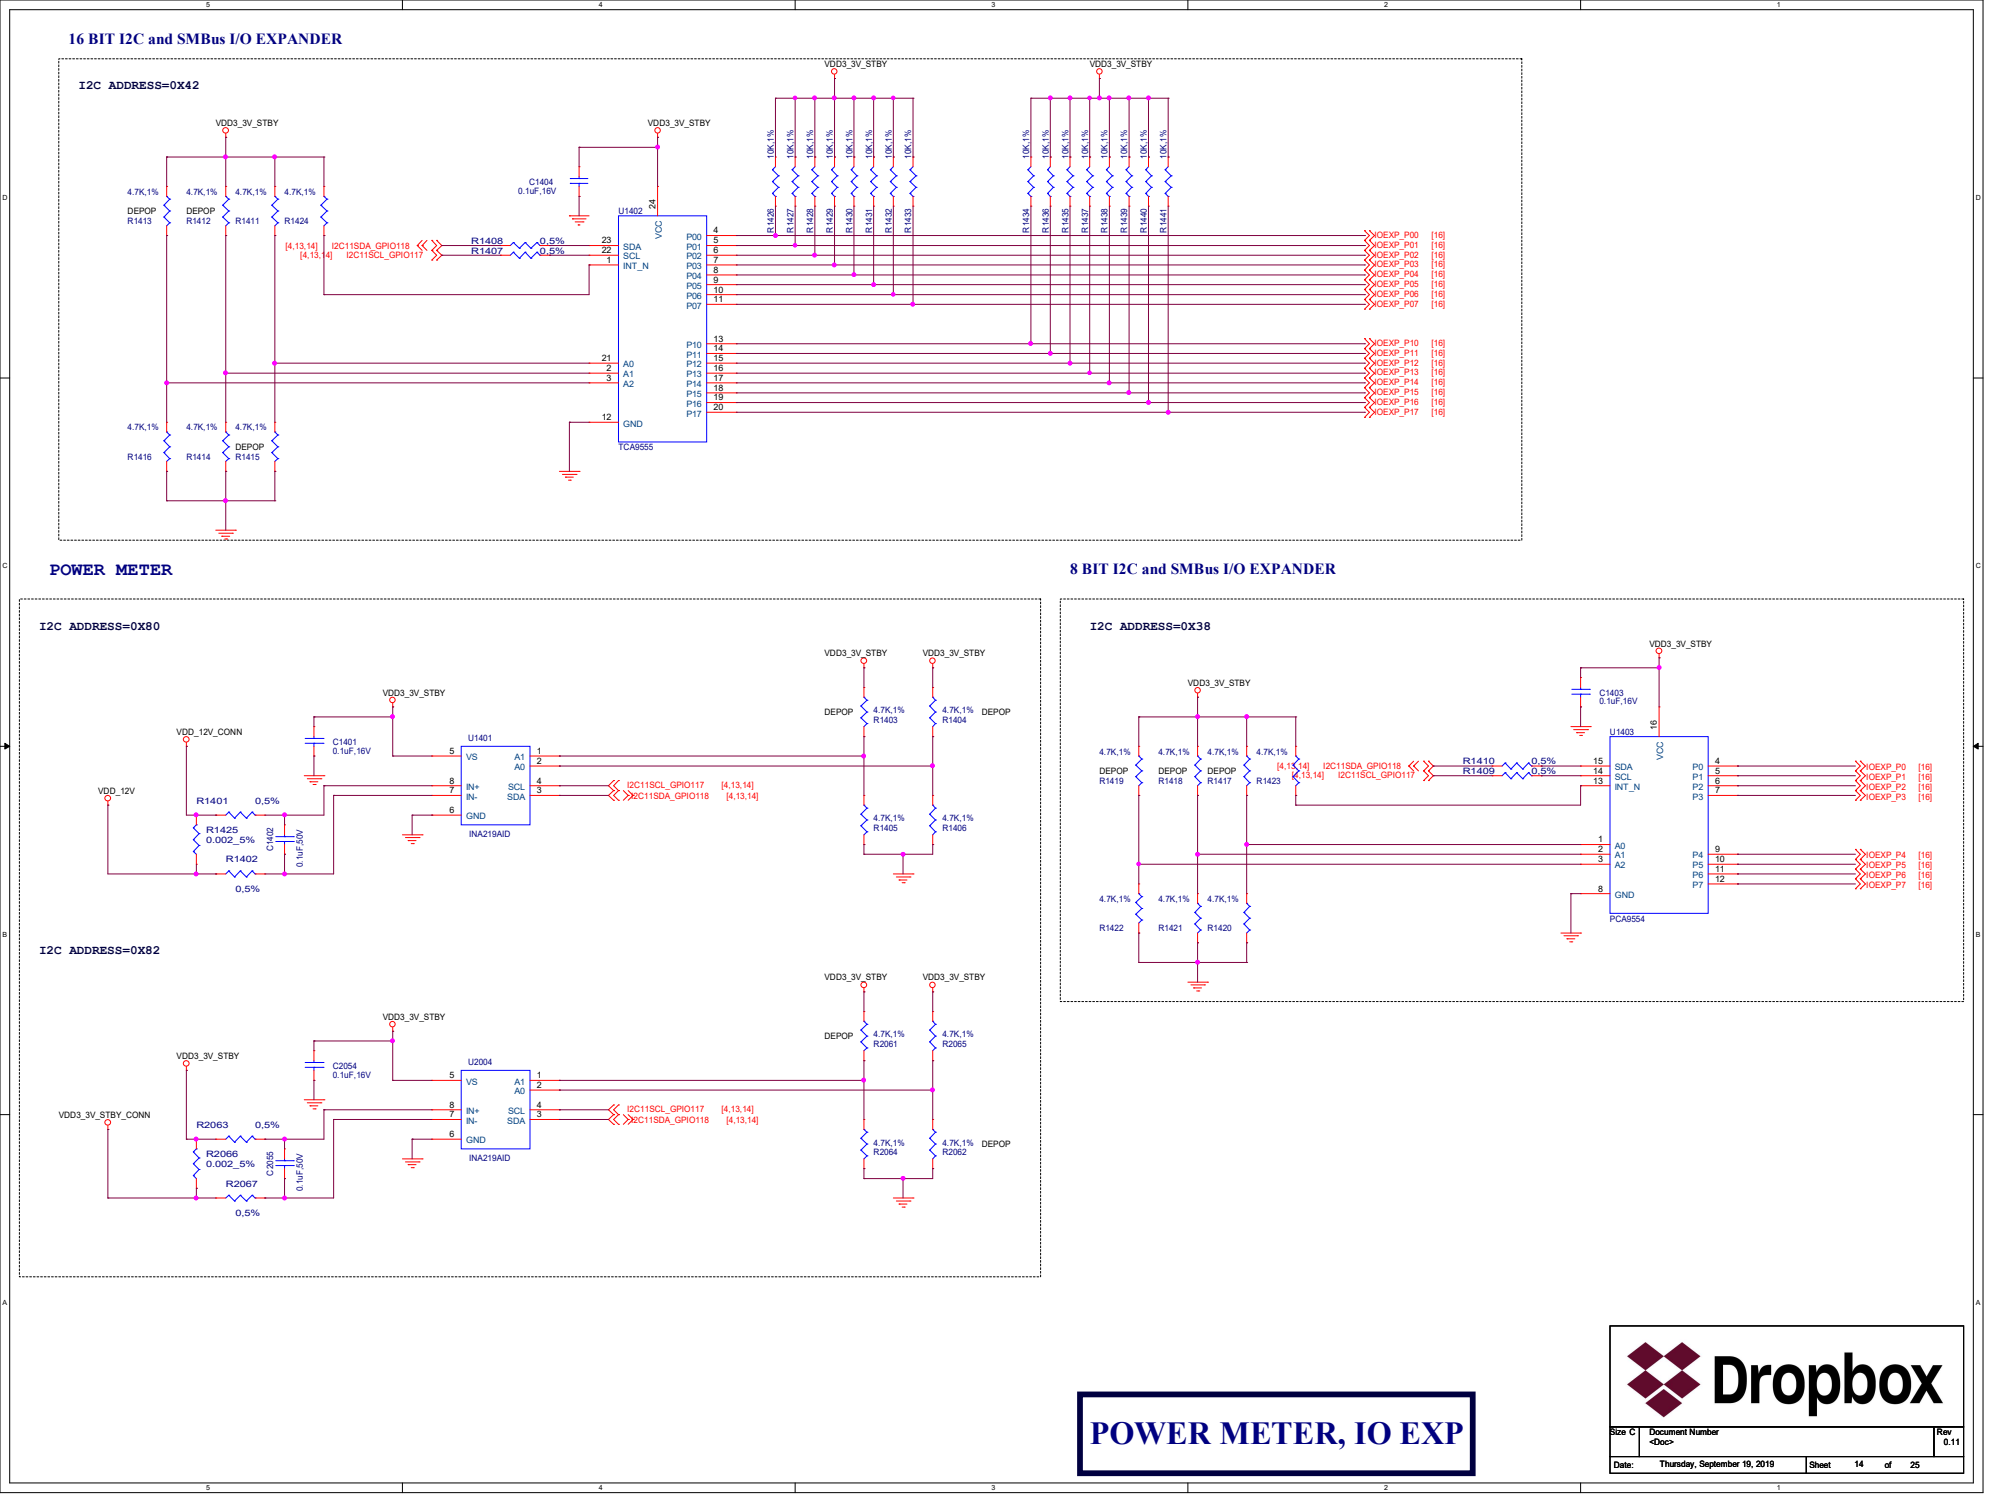
[picture p92: page 14]

8 BIT I2C and SMBus I/O EXPANDER

A1 1 A0 2 SDA 3 SCL 4 VS 5 GND 6

POWER METER, IO EXP

## I2C ADDRESS=0XE6

# I2C EXPANDER

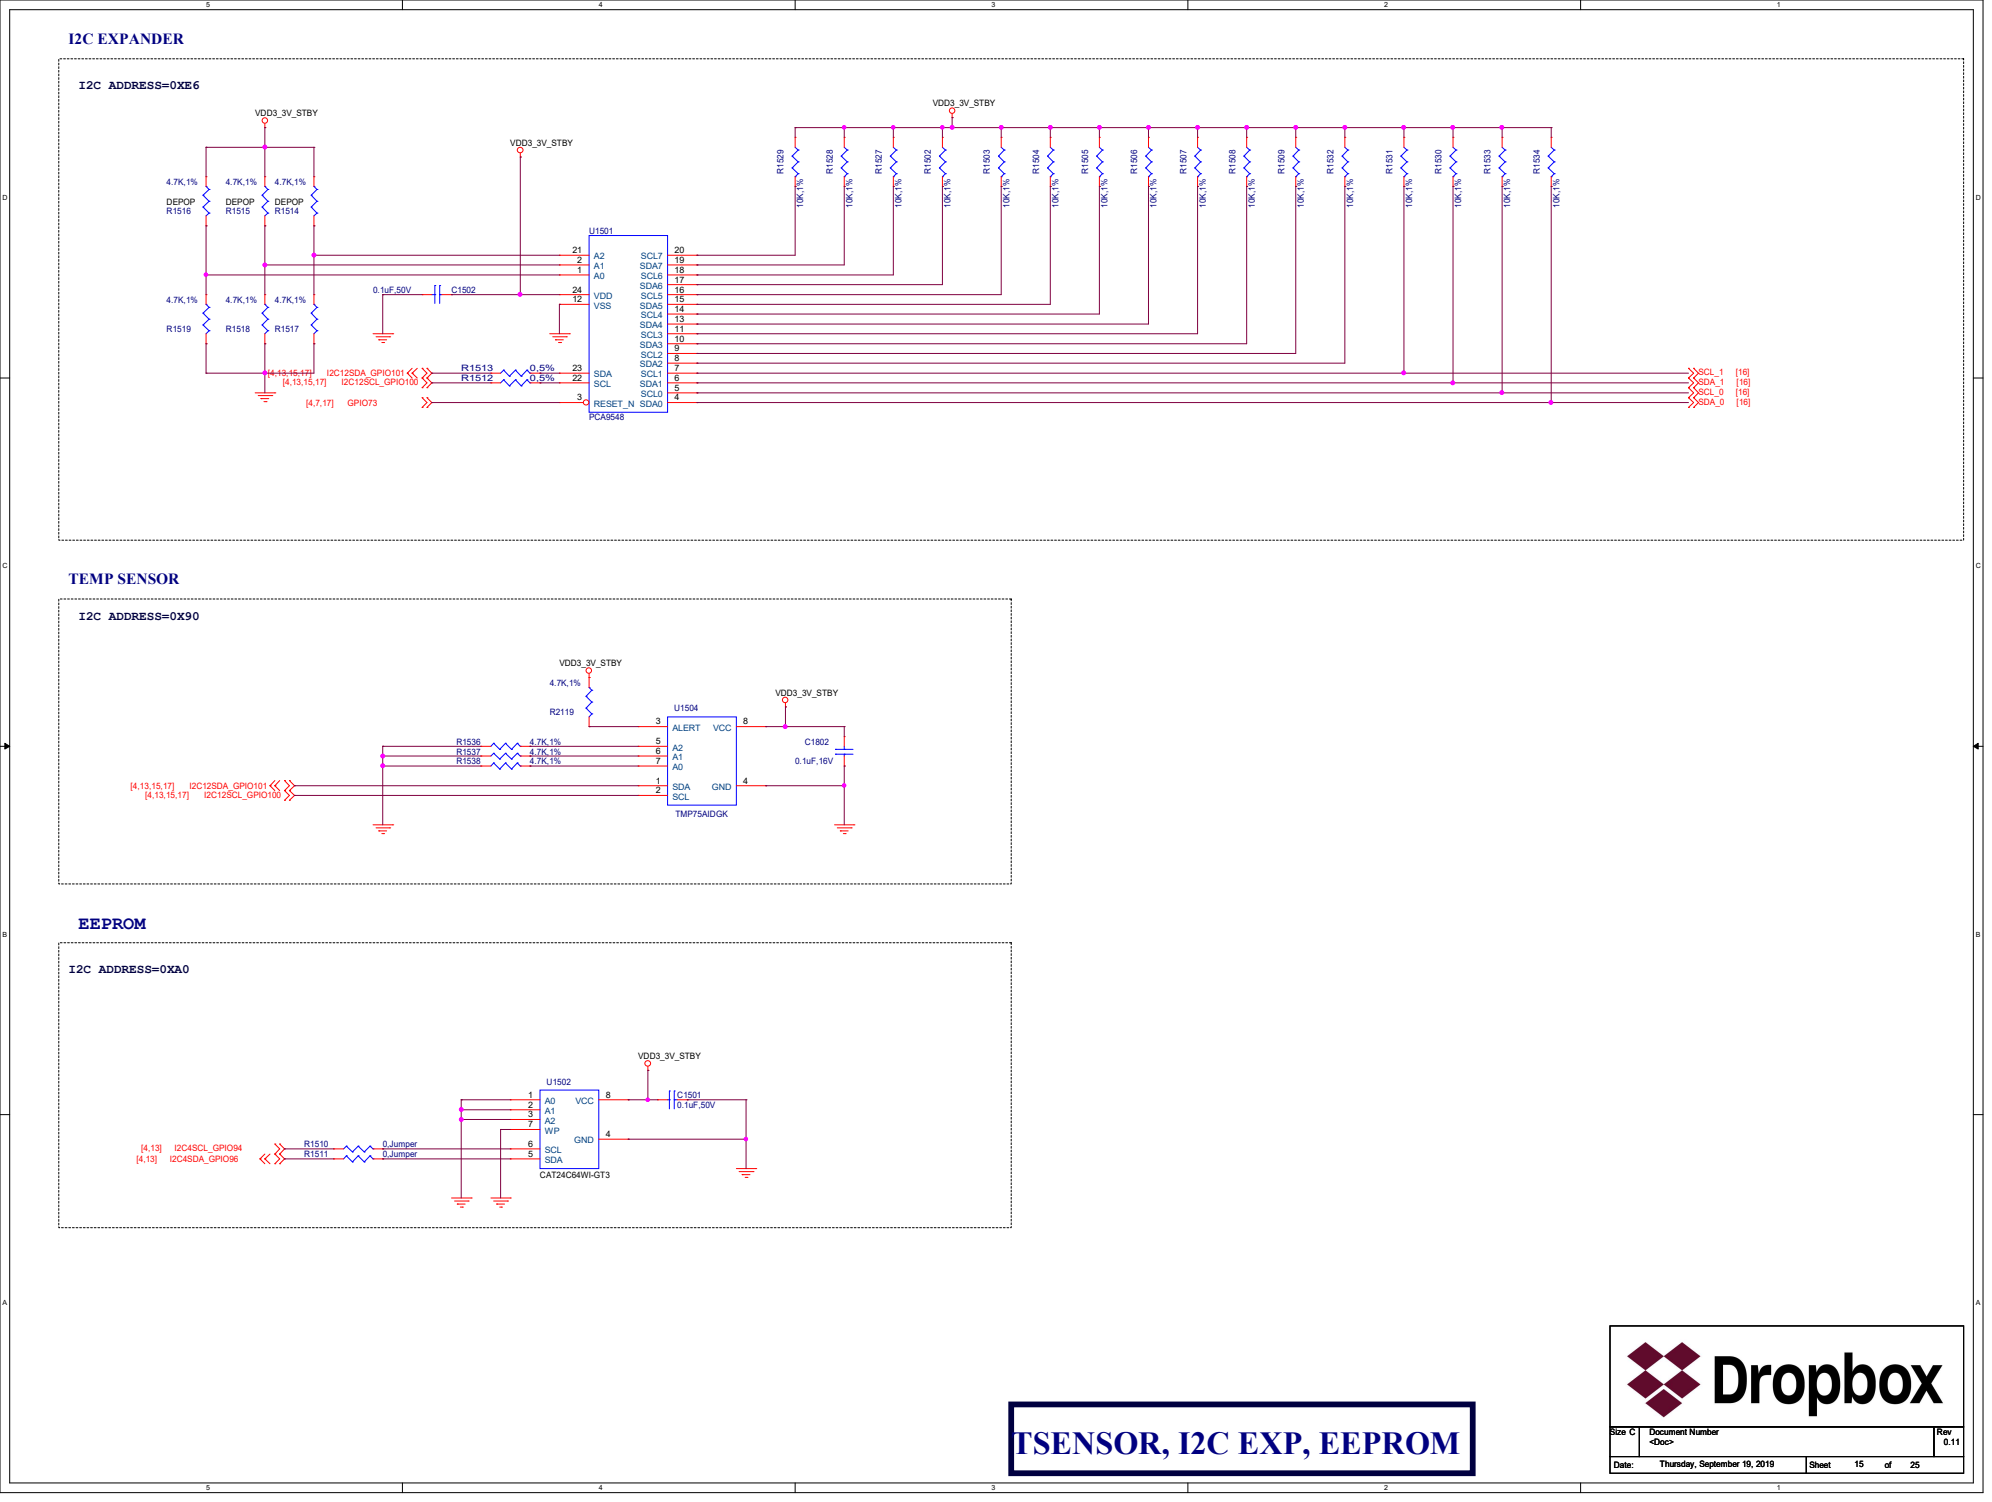
[picture p93: page 15]

# 16 BIT I/O EXPANDER

# 8 BIT I/O EXPANDER

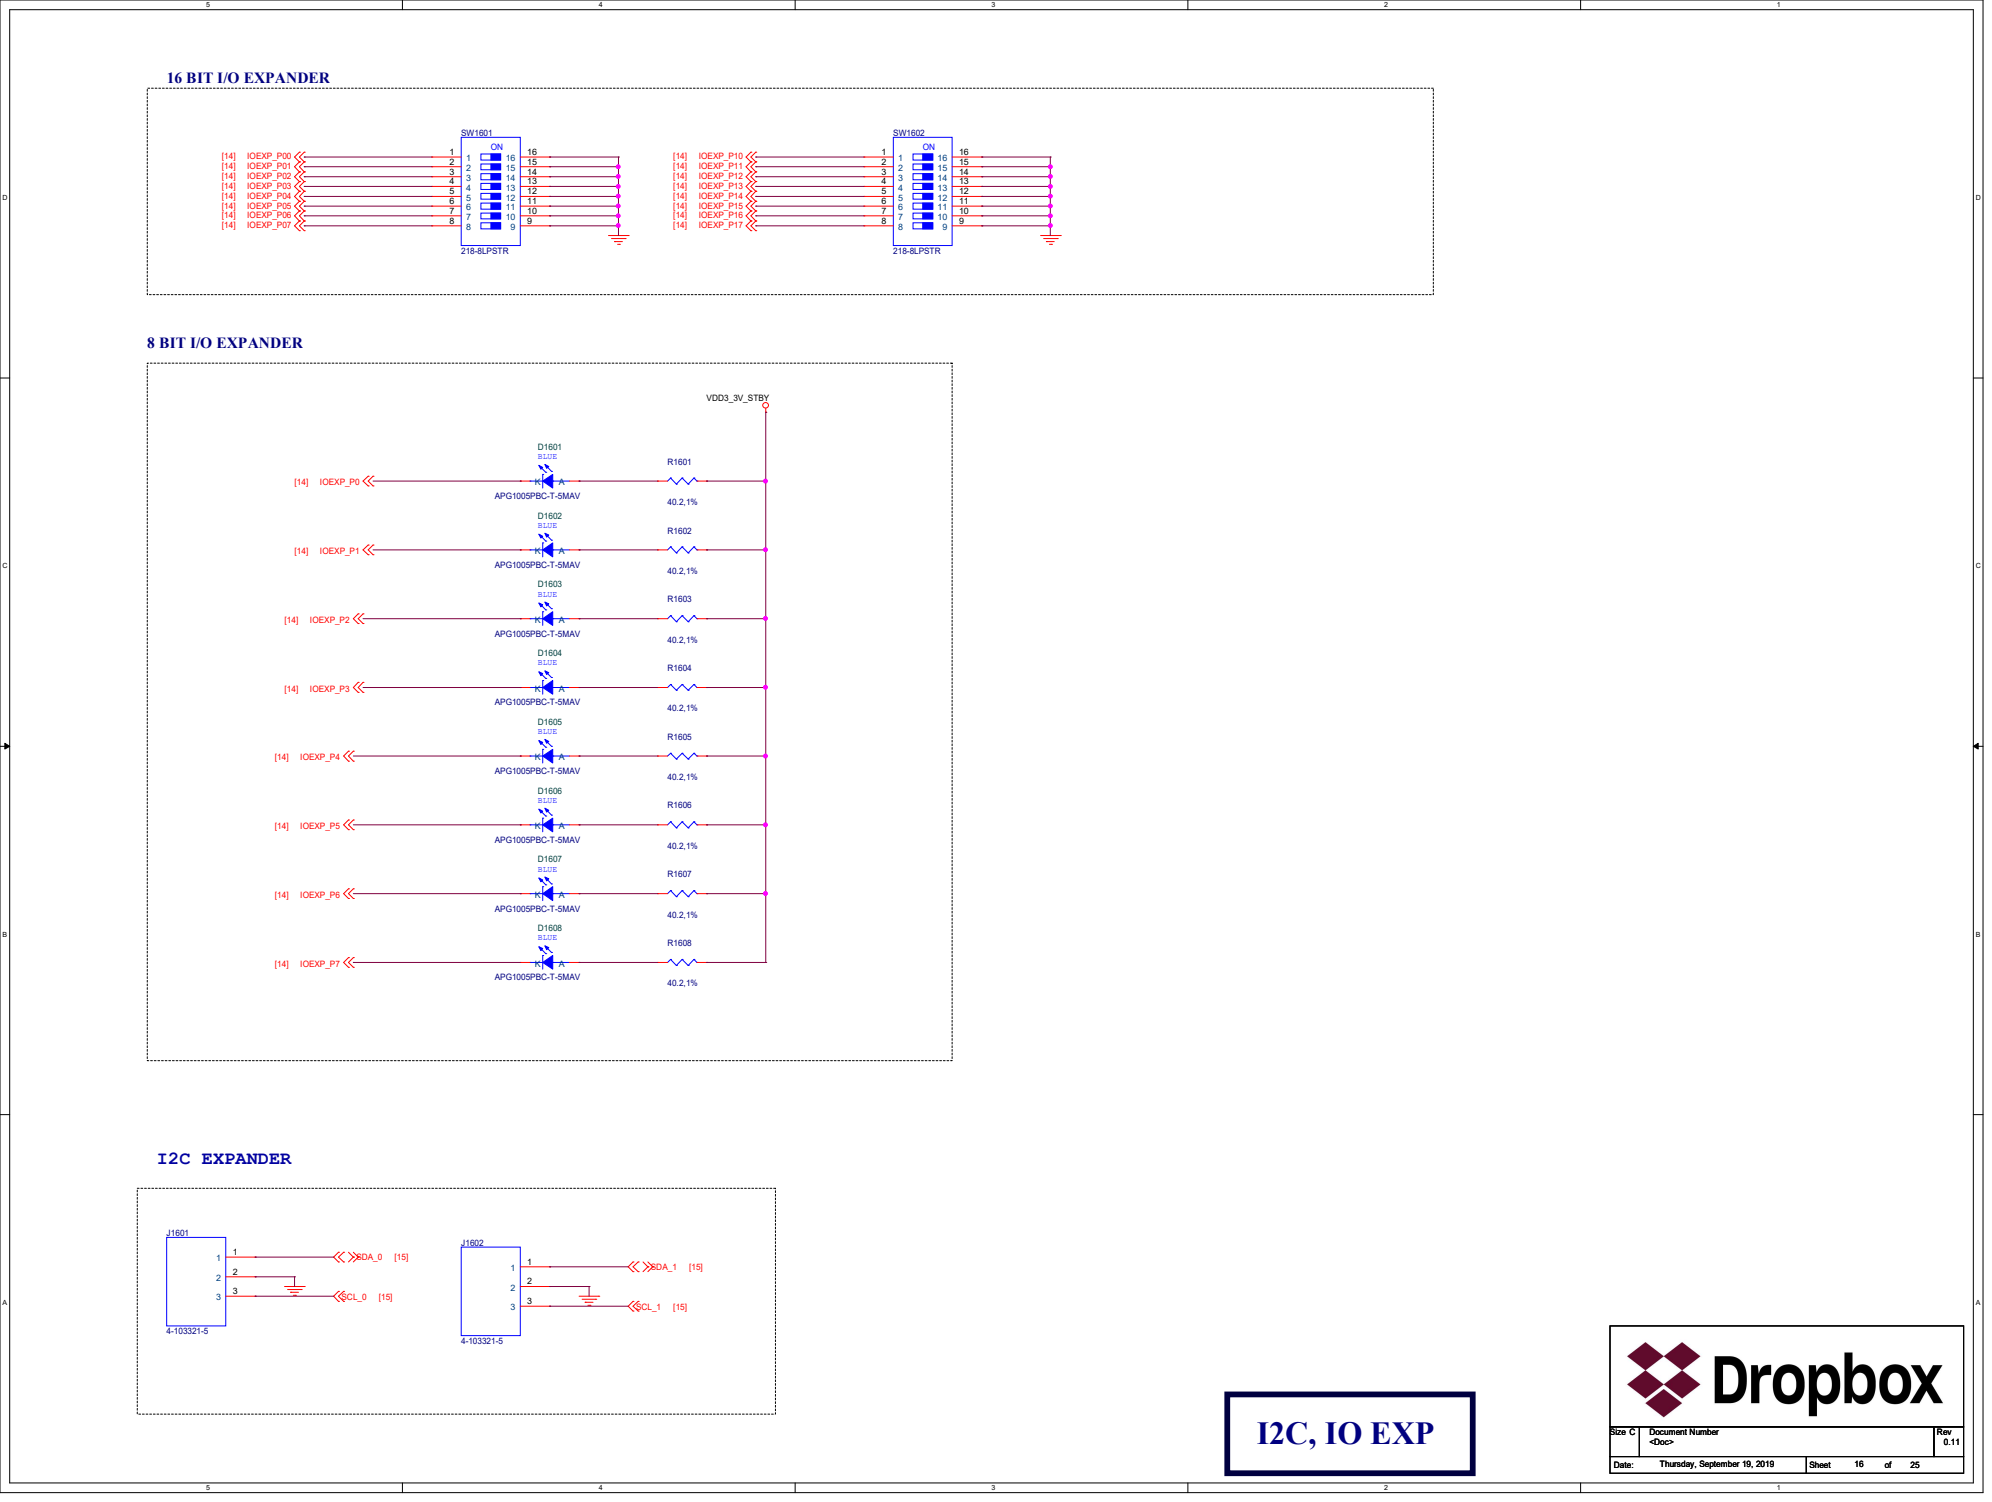
[picture p94: page 16]

# SYS SPI HEADER

# SPI_SYS FLASH SOCKET

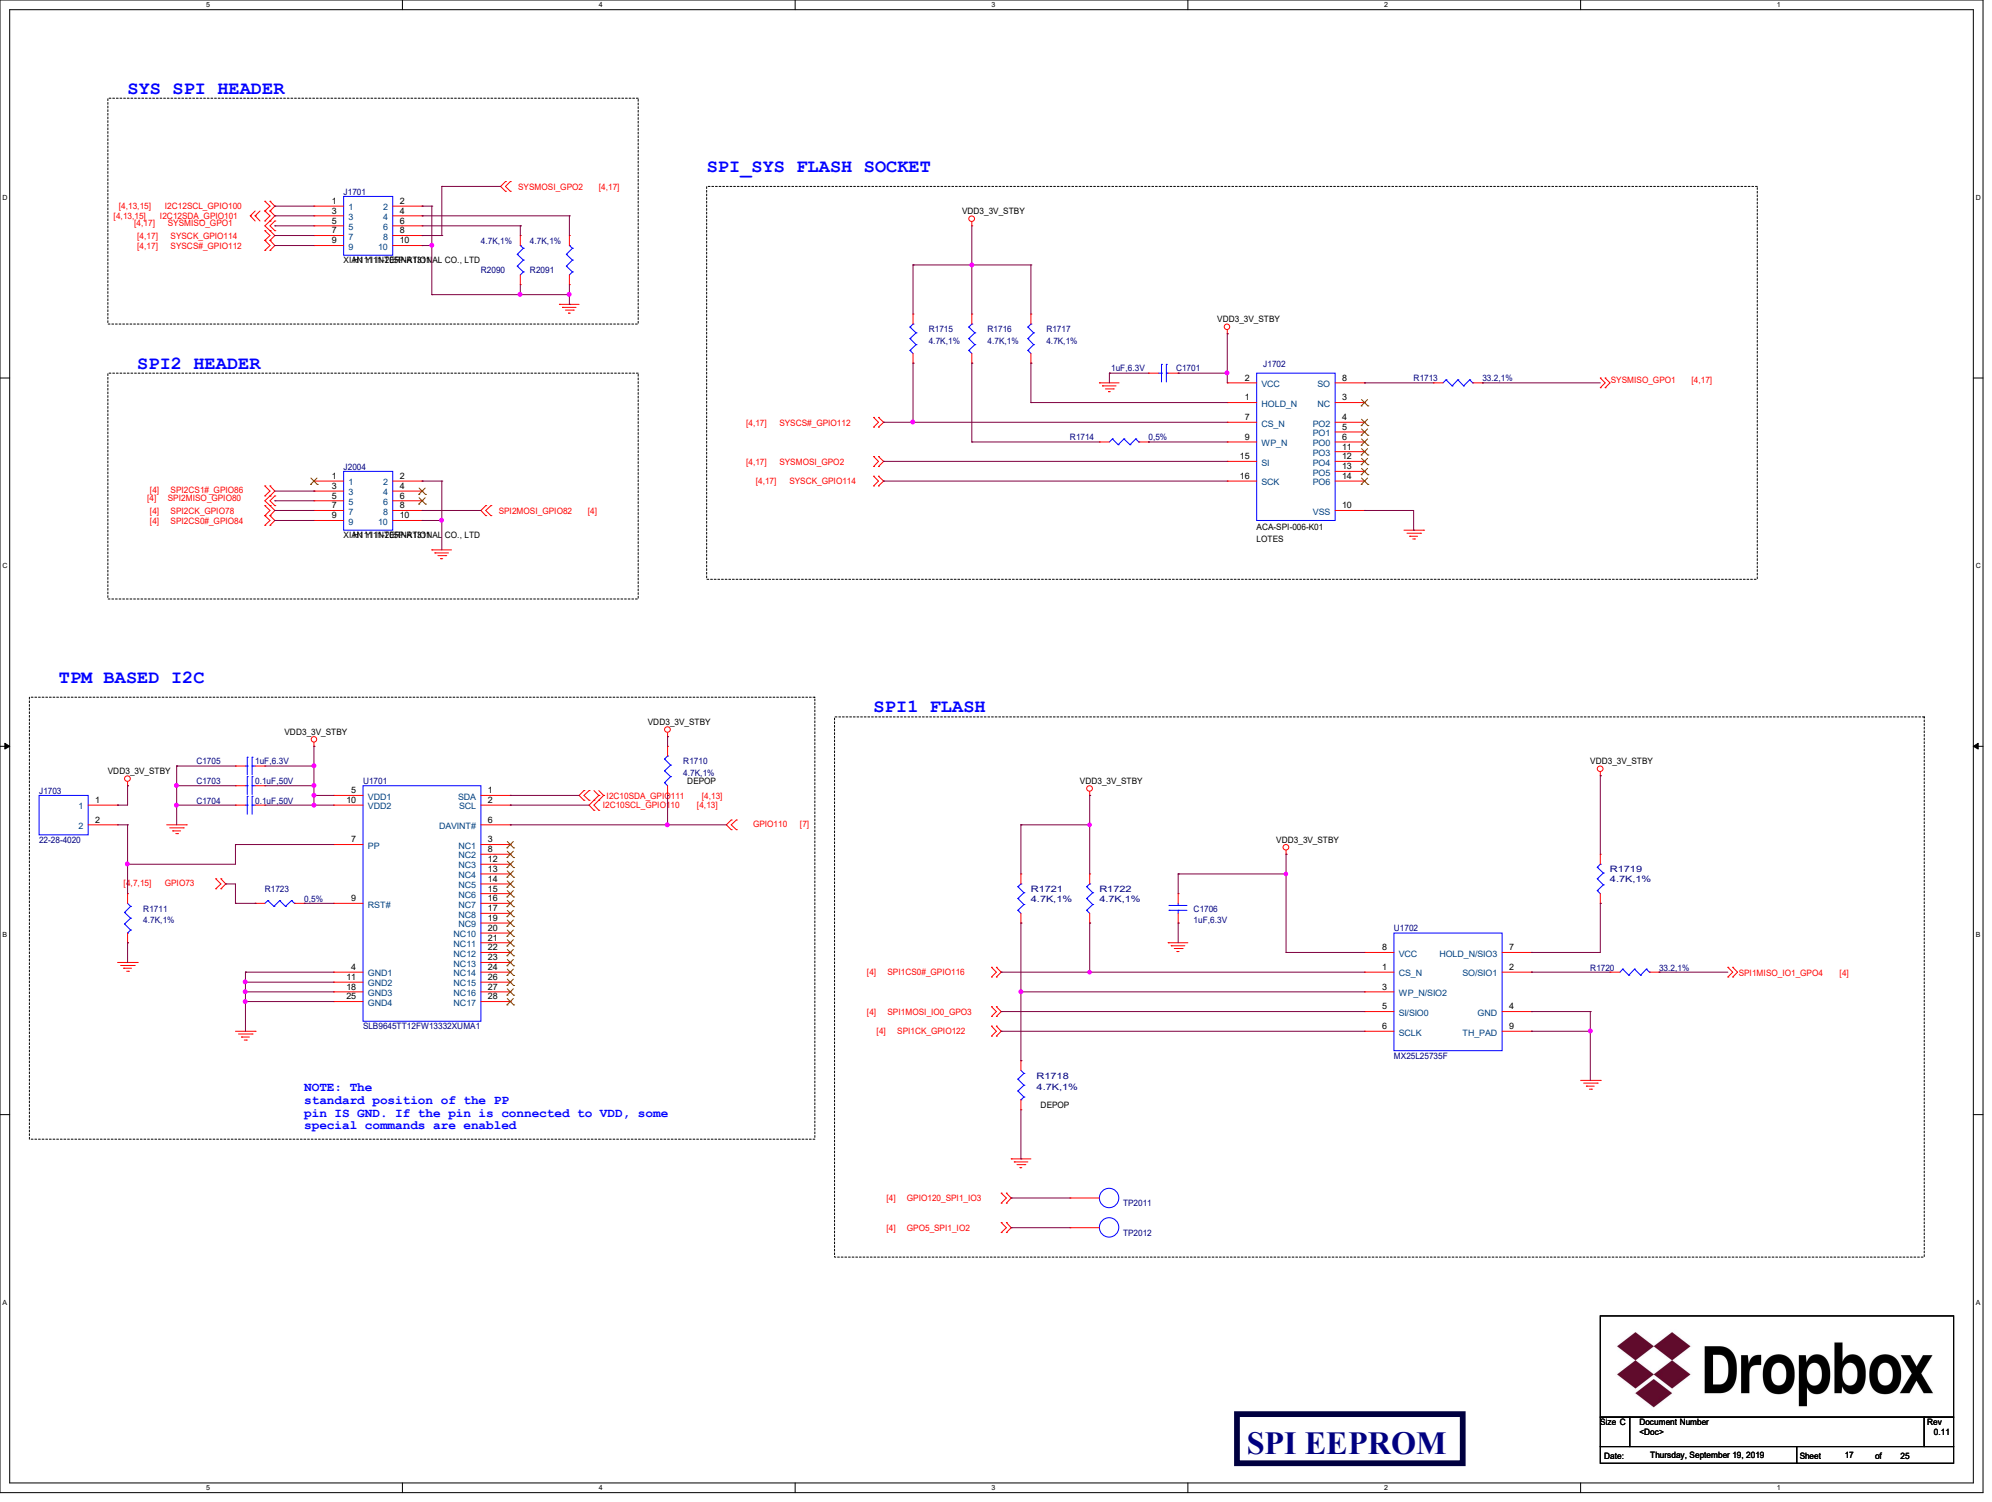
[picture p95: page 17]

NOTE: The
standard position of the PP
pin IS GND. If the pin is connected to VDD, some
special commands are enabled

# BMC RESET

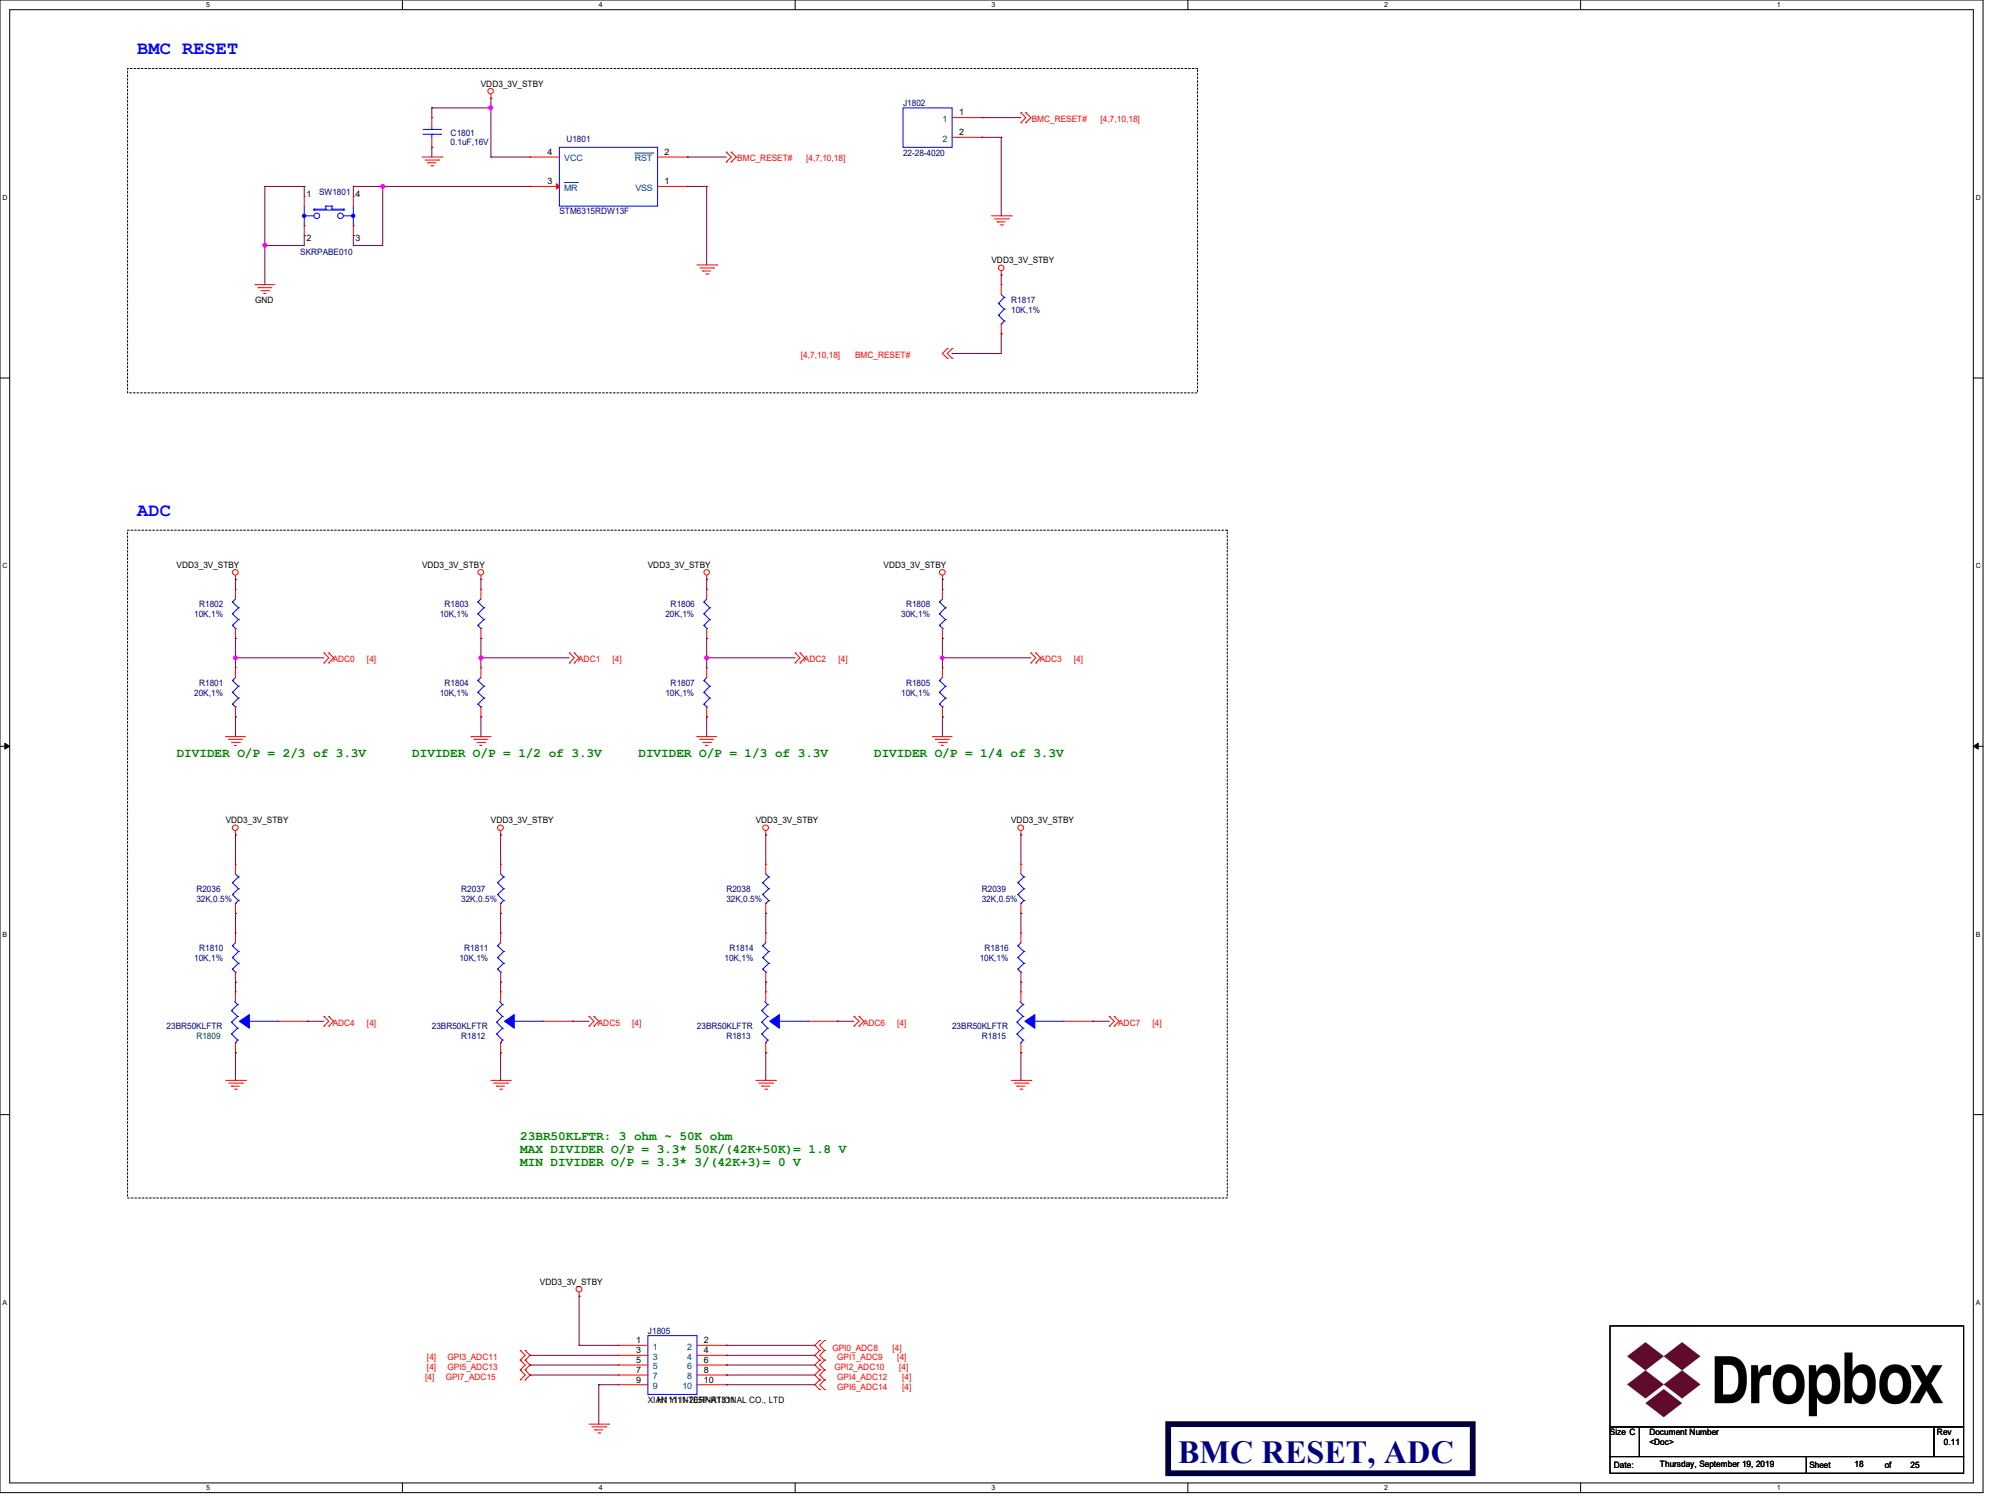
[picture p96: page 18]

Place components on signals as close as possible to the FAN connectors, up to 1 inch.
GPION0_PWM0_R | [19] TACH0_GPIO46 | [4] GPION1_PWM1_R | [19] TACH1_GPIO48 | [4] GPION2_PWM2_R | [19] TACH2_GPIO50 | [4] GPION3_PWM3_R | [19] TACH3_GPIO52 | [4]

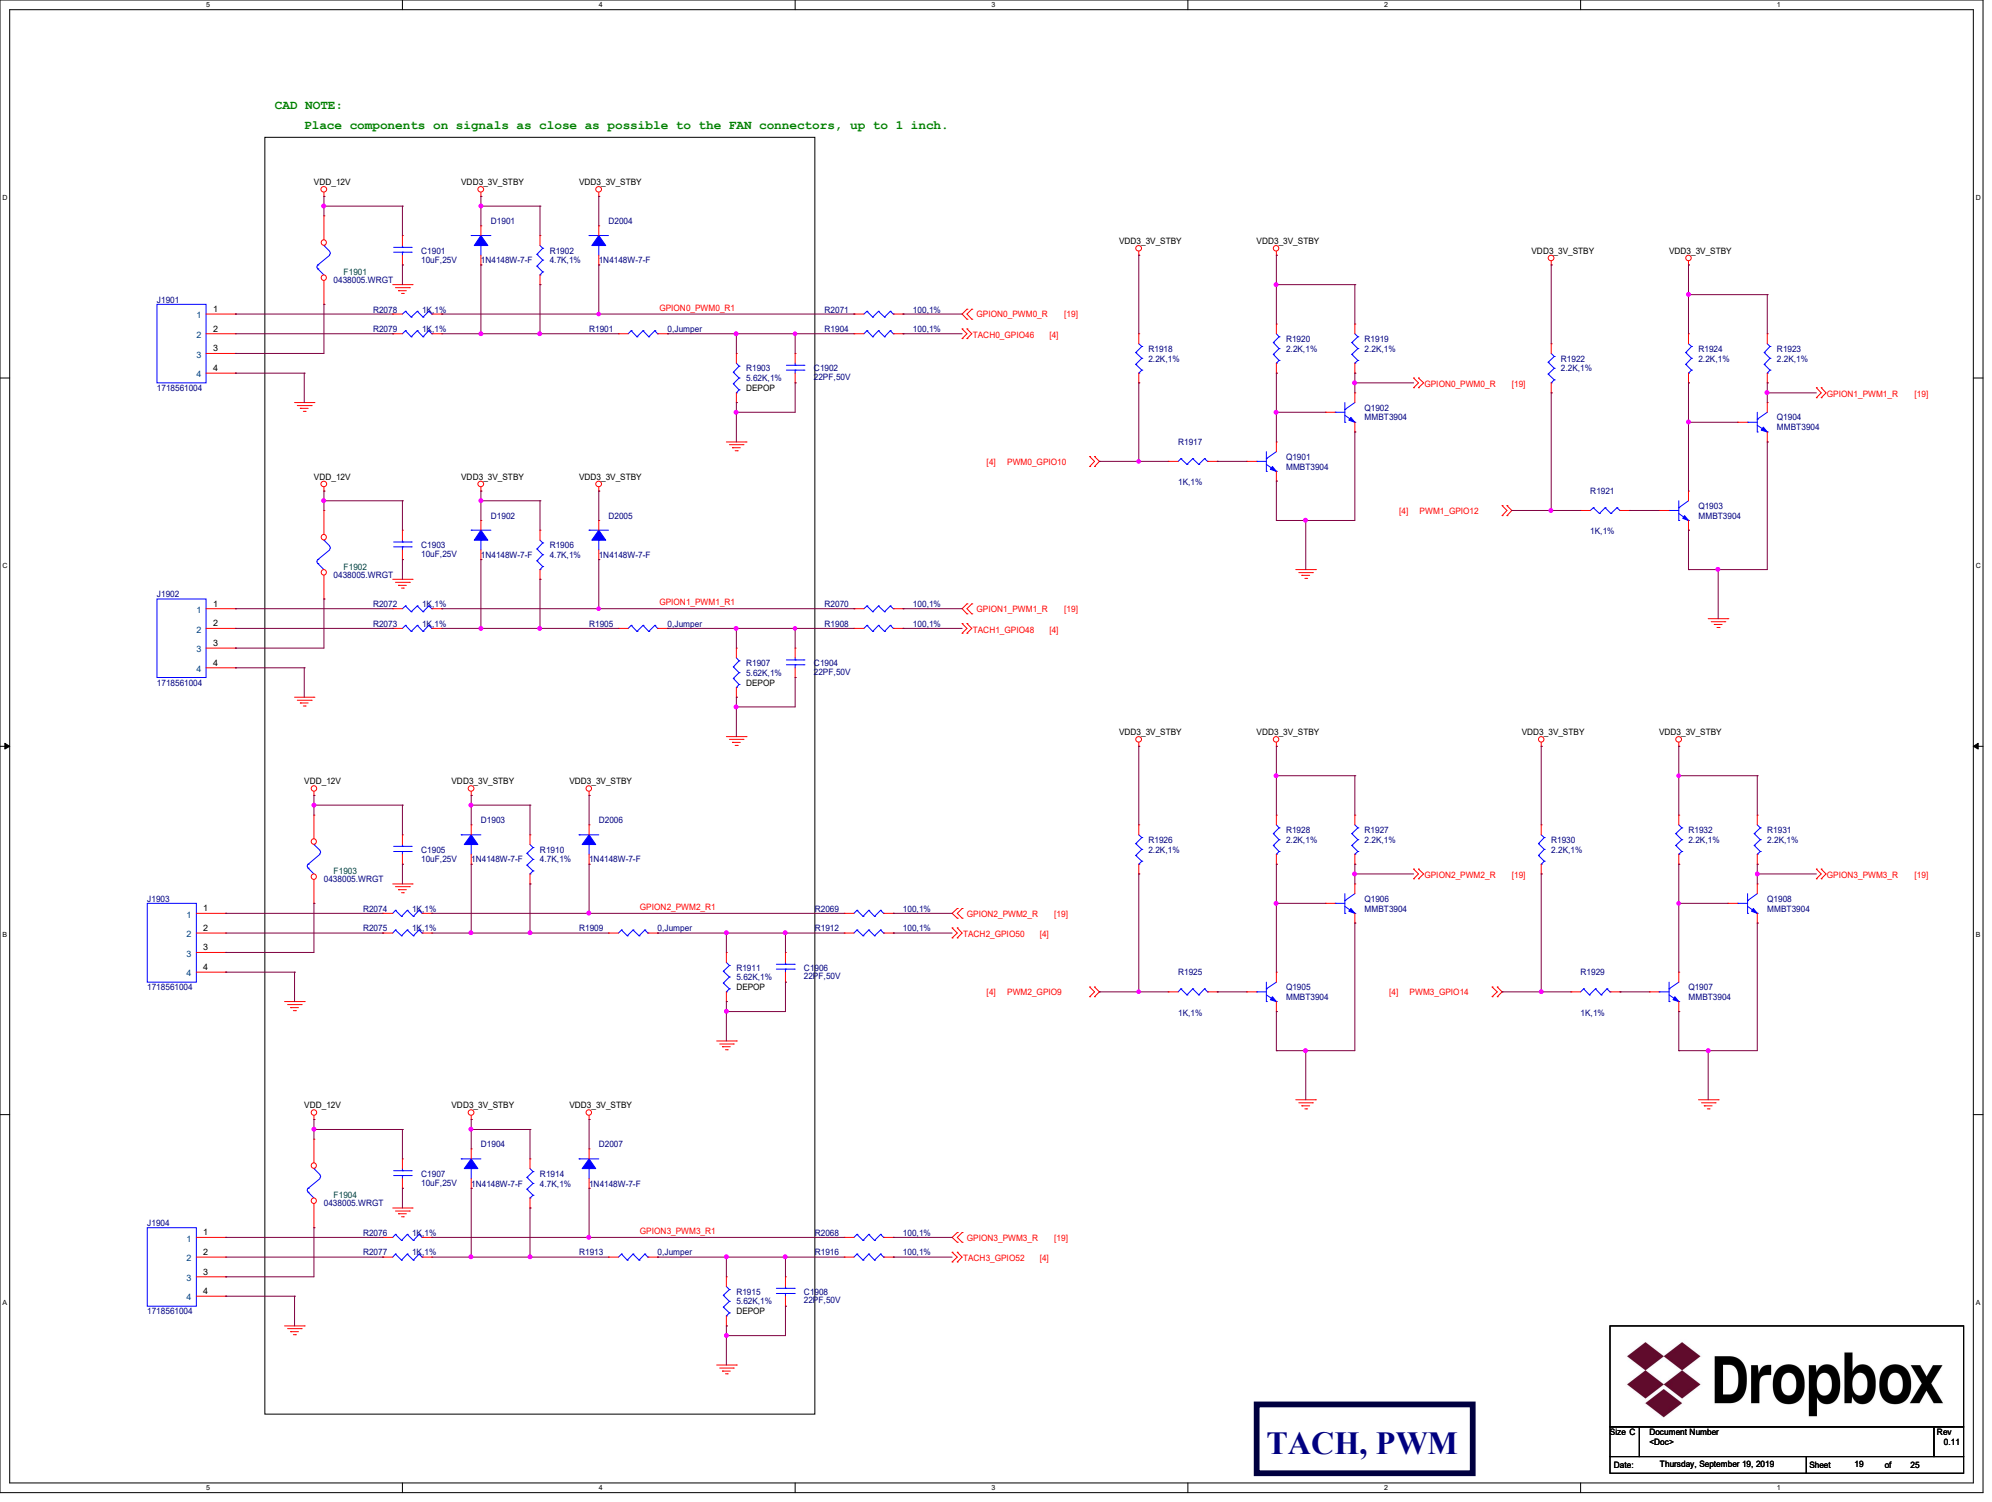
[picture p97: page 19]

# SPDT SWITCHES

# MUX/DEMUX SWITCHES

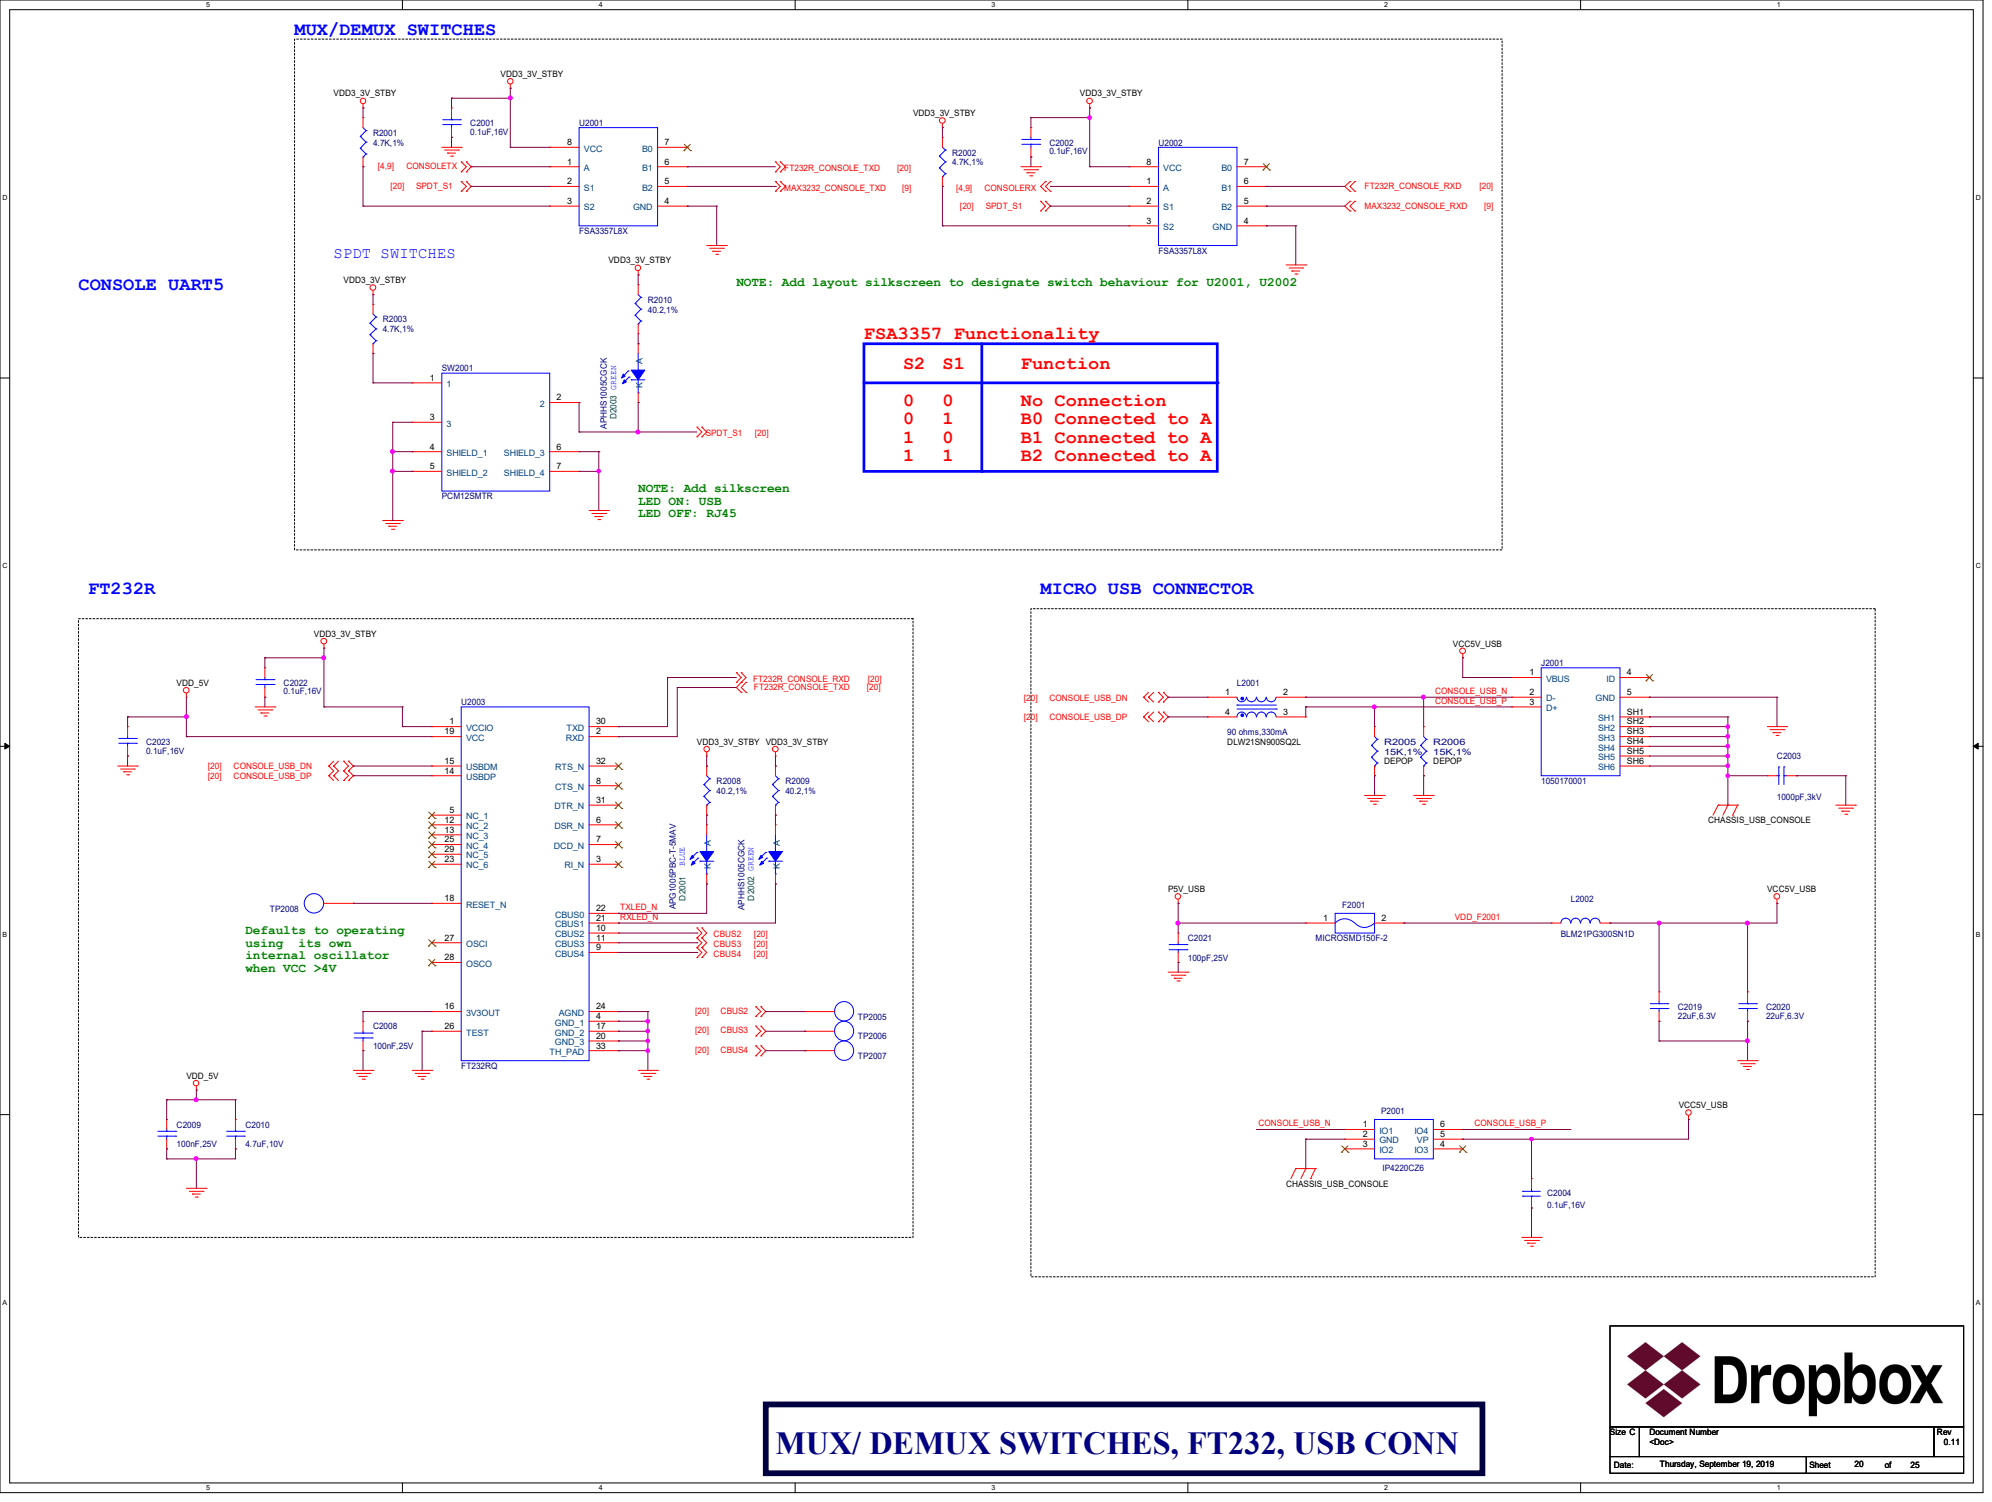
[picture p98: page 20]

NOTE: Add layout silkscreen to designate switch behaviour for U2001, U2002

MUX/ DEMUX SWITCHES, FT232, USB CONN

S2

# MUX/DEMUX SWITCHES

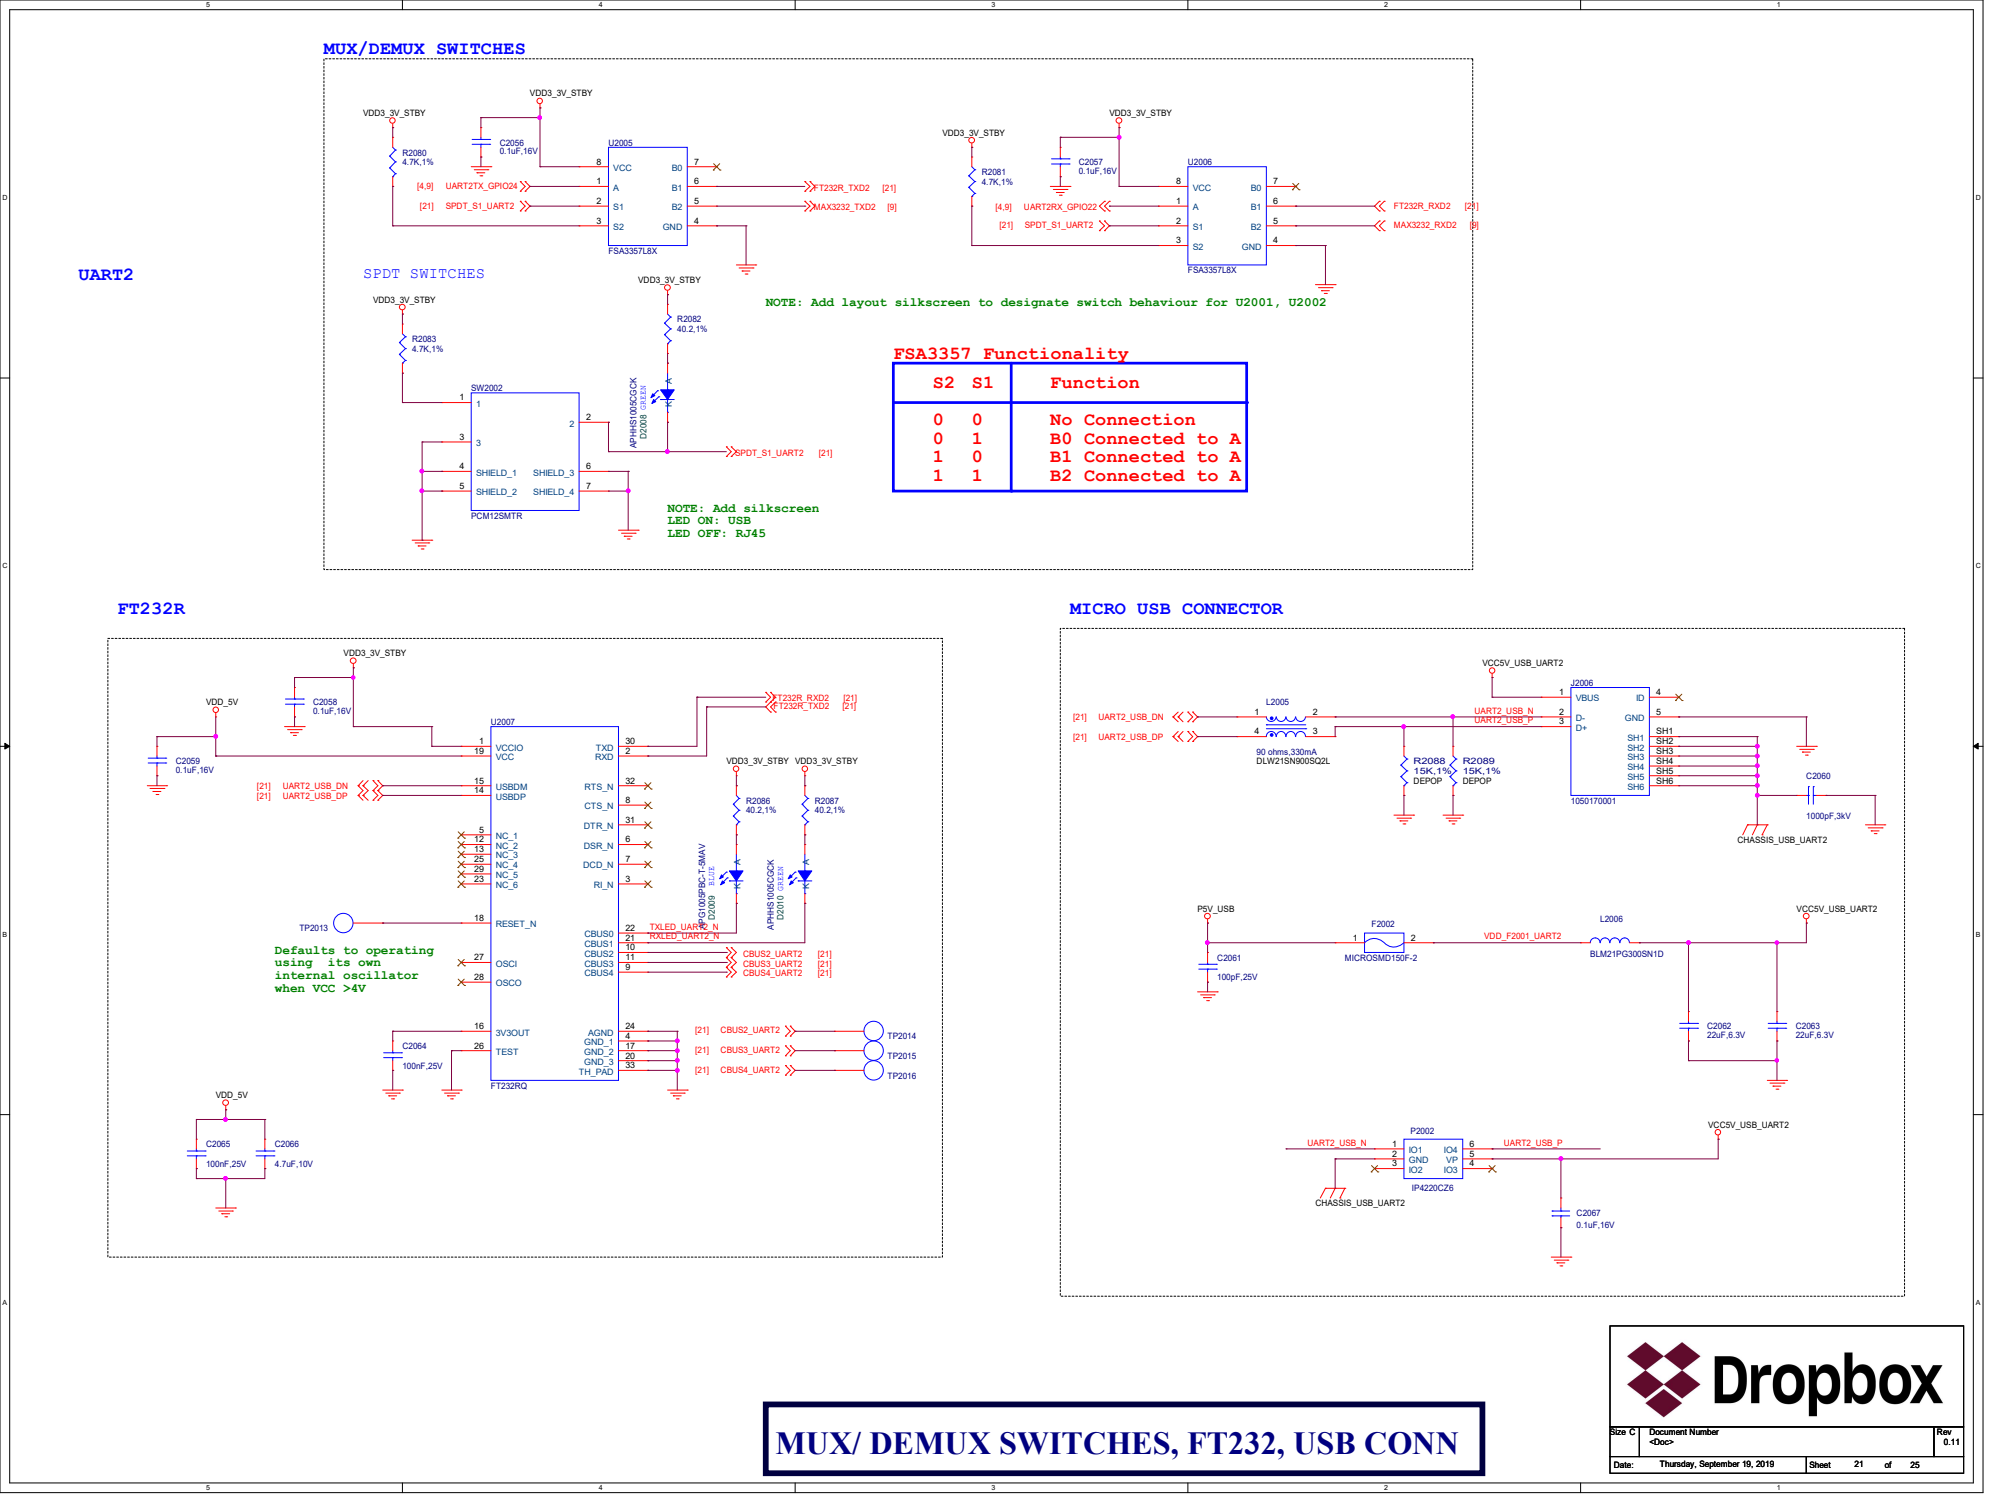
[picture p99: page 21]

NOTE: Add layout silkscreen to designate switch behaviour for U2001, U2002

MUX/ DEMUX SWITCHES, FT232, USB CONN

# PS 5V

+/-4.5%

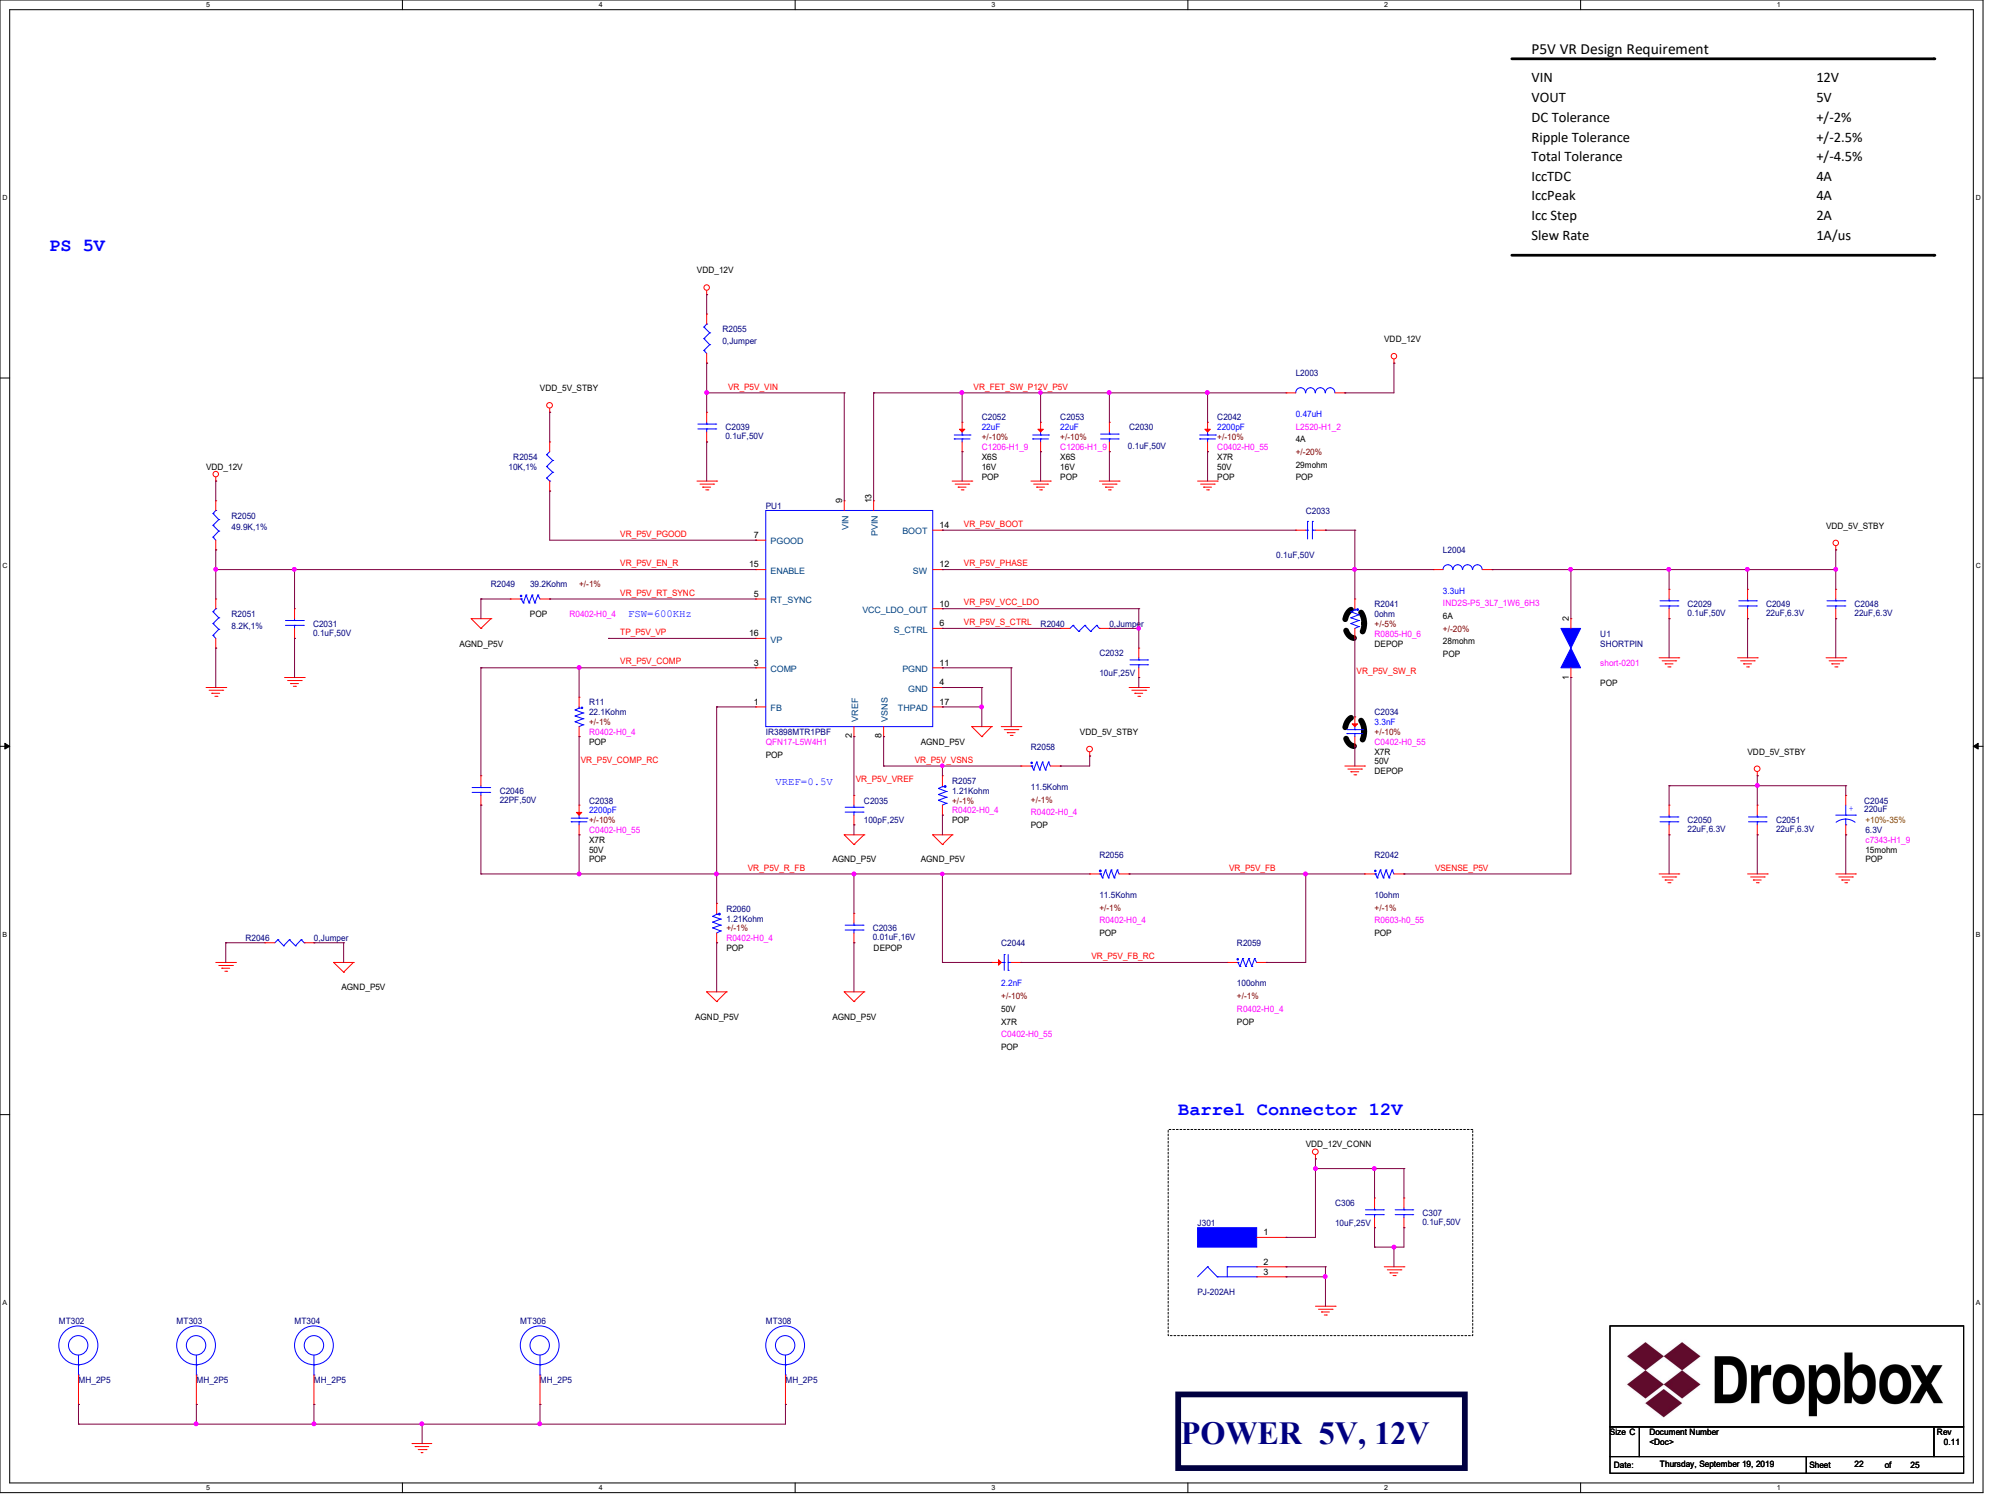
[picture p100: page 22]

9 S_CTRL 6 GND 4 THPAD 17 FB 1 COMP 3 PVIN 13 VP 16 PGND 11 R2041

+/-4.5%

# P3V3 VR Design Requirement

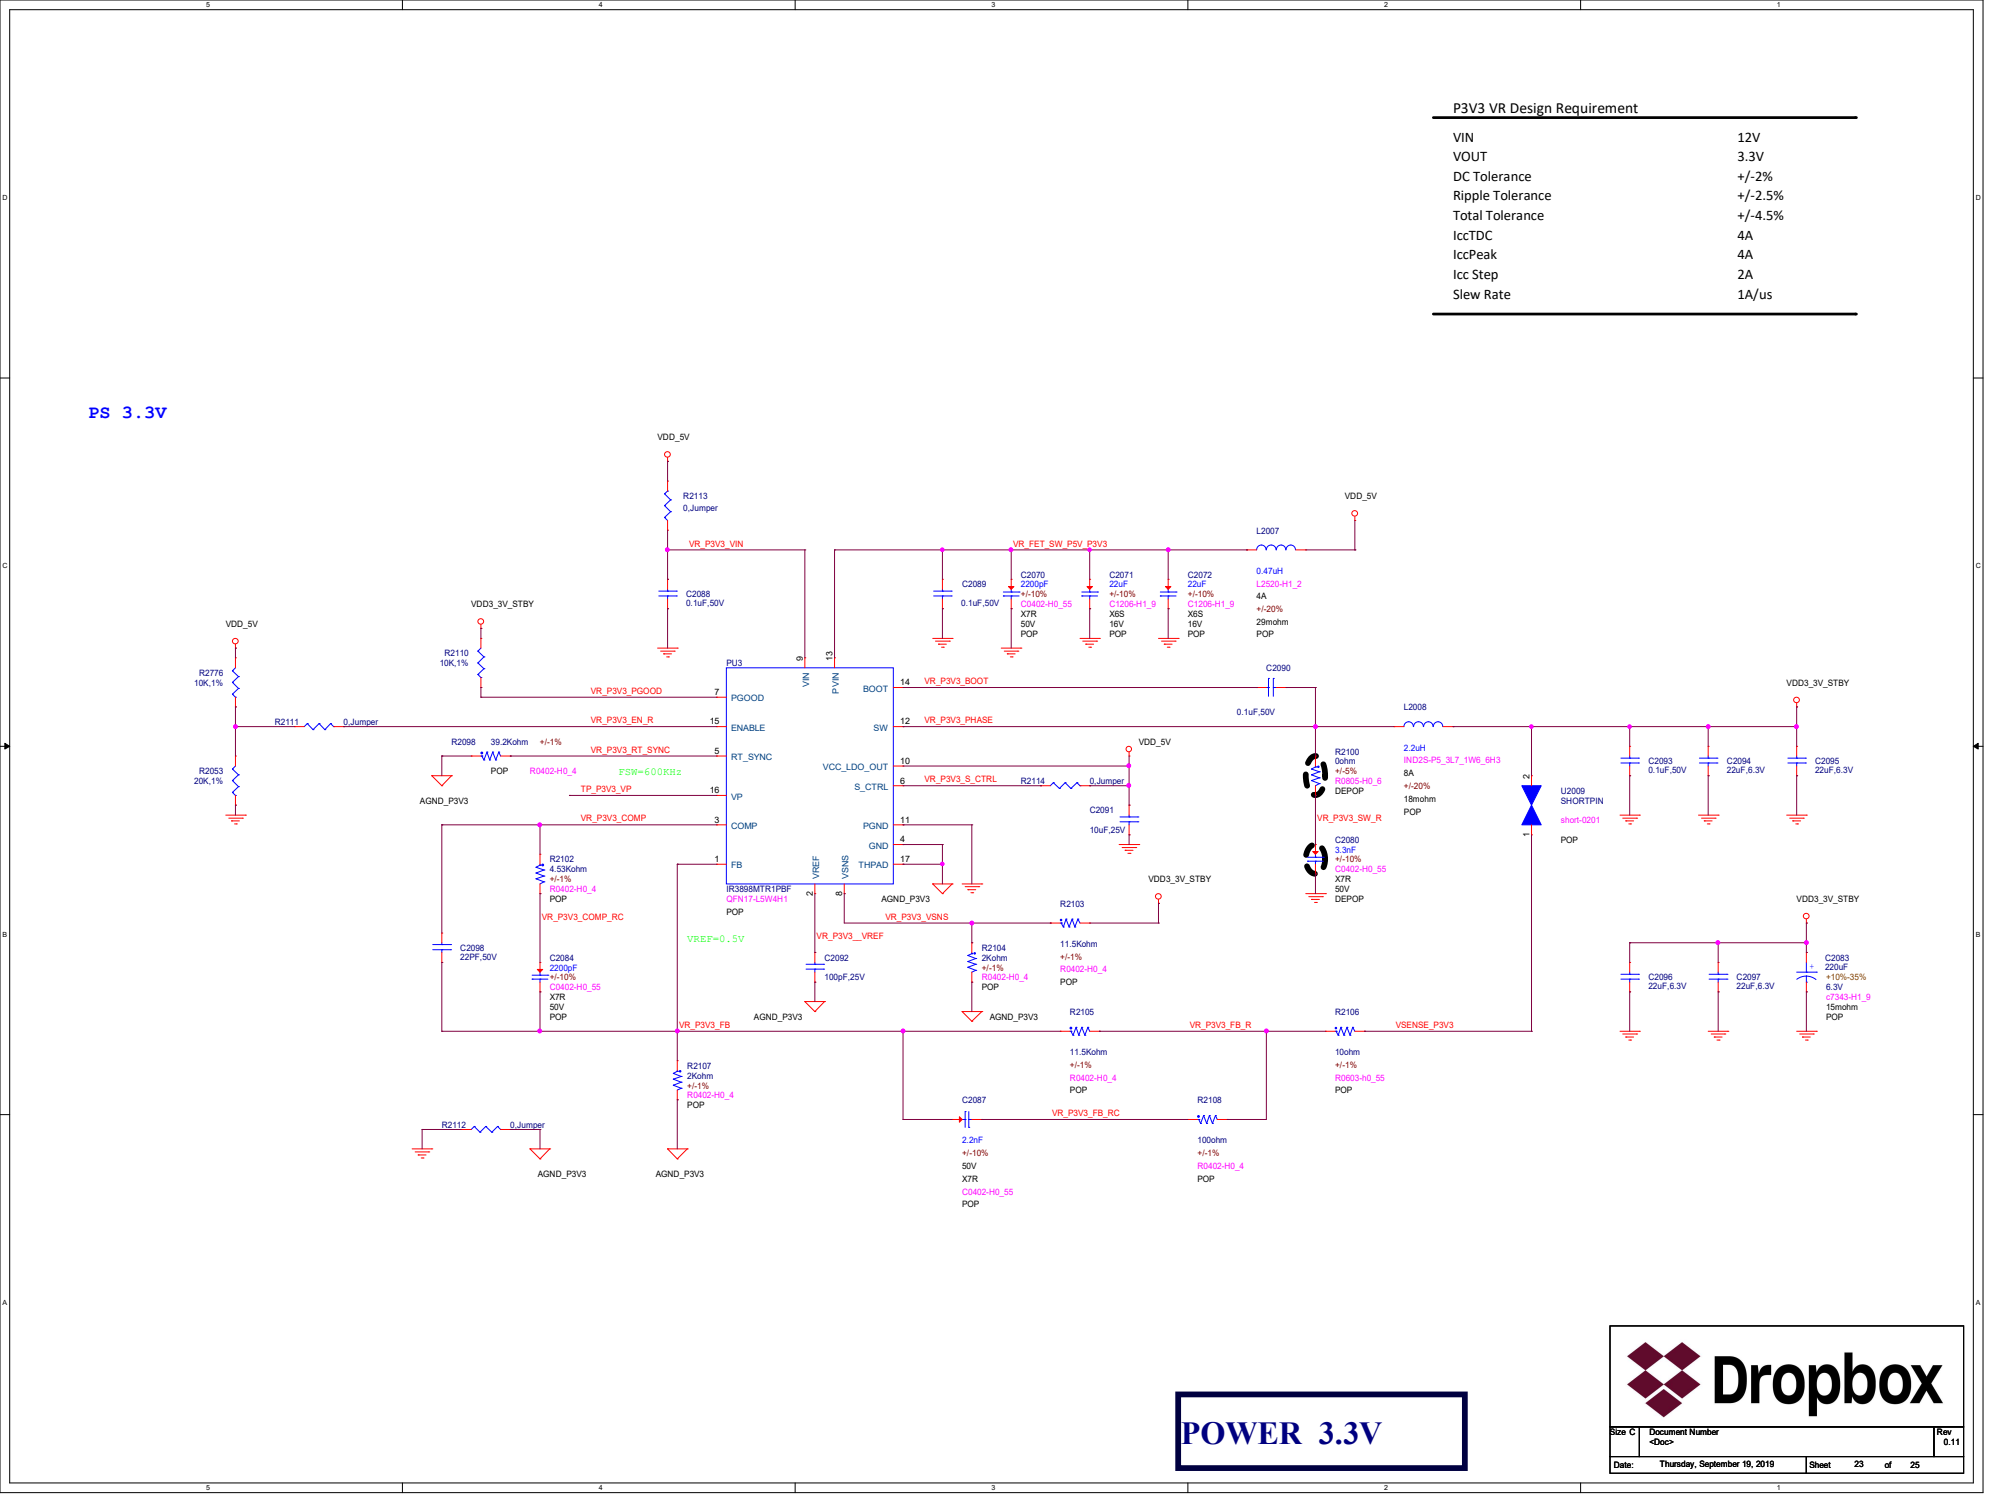
[picture p101: page 23]

9 S_CTRL 6 GND 4 THPAD 17 FB 1 COMP 3 PVIN 13 VP 16 PGND 11 C2084

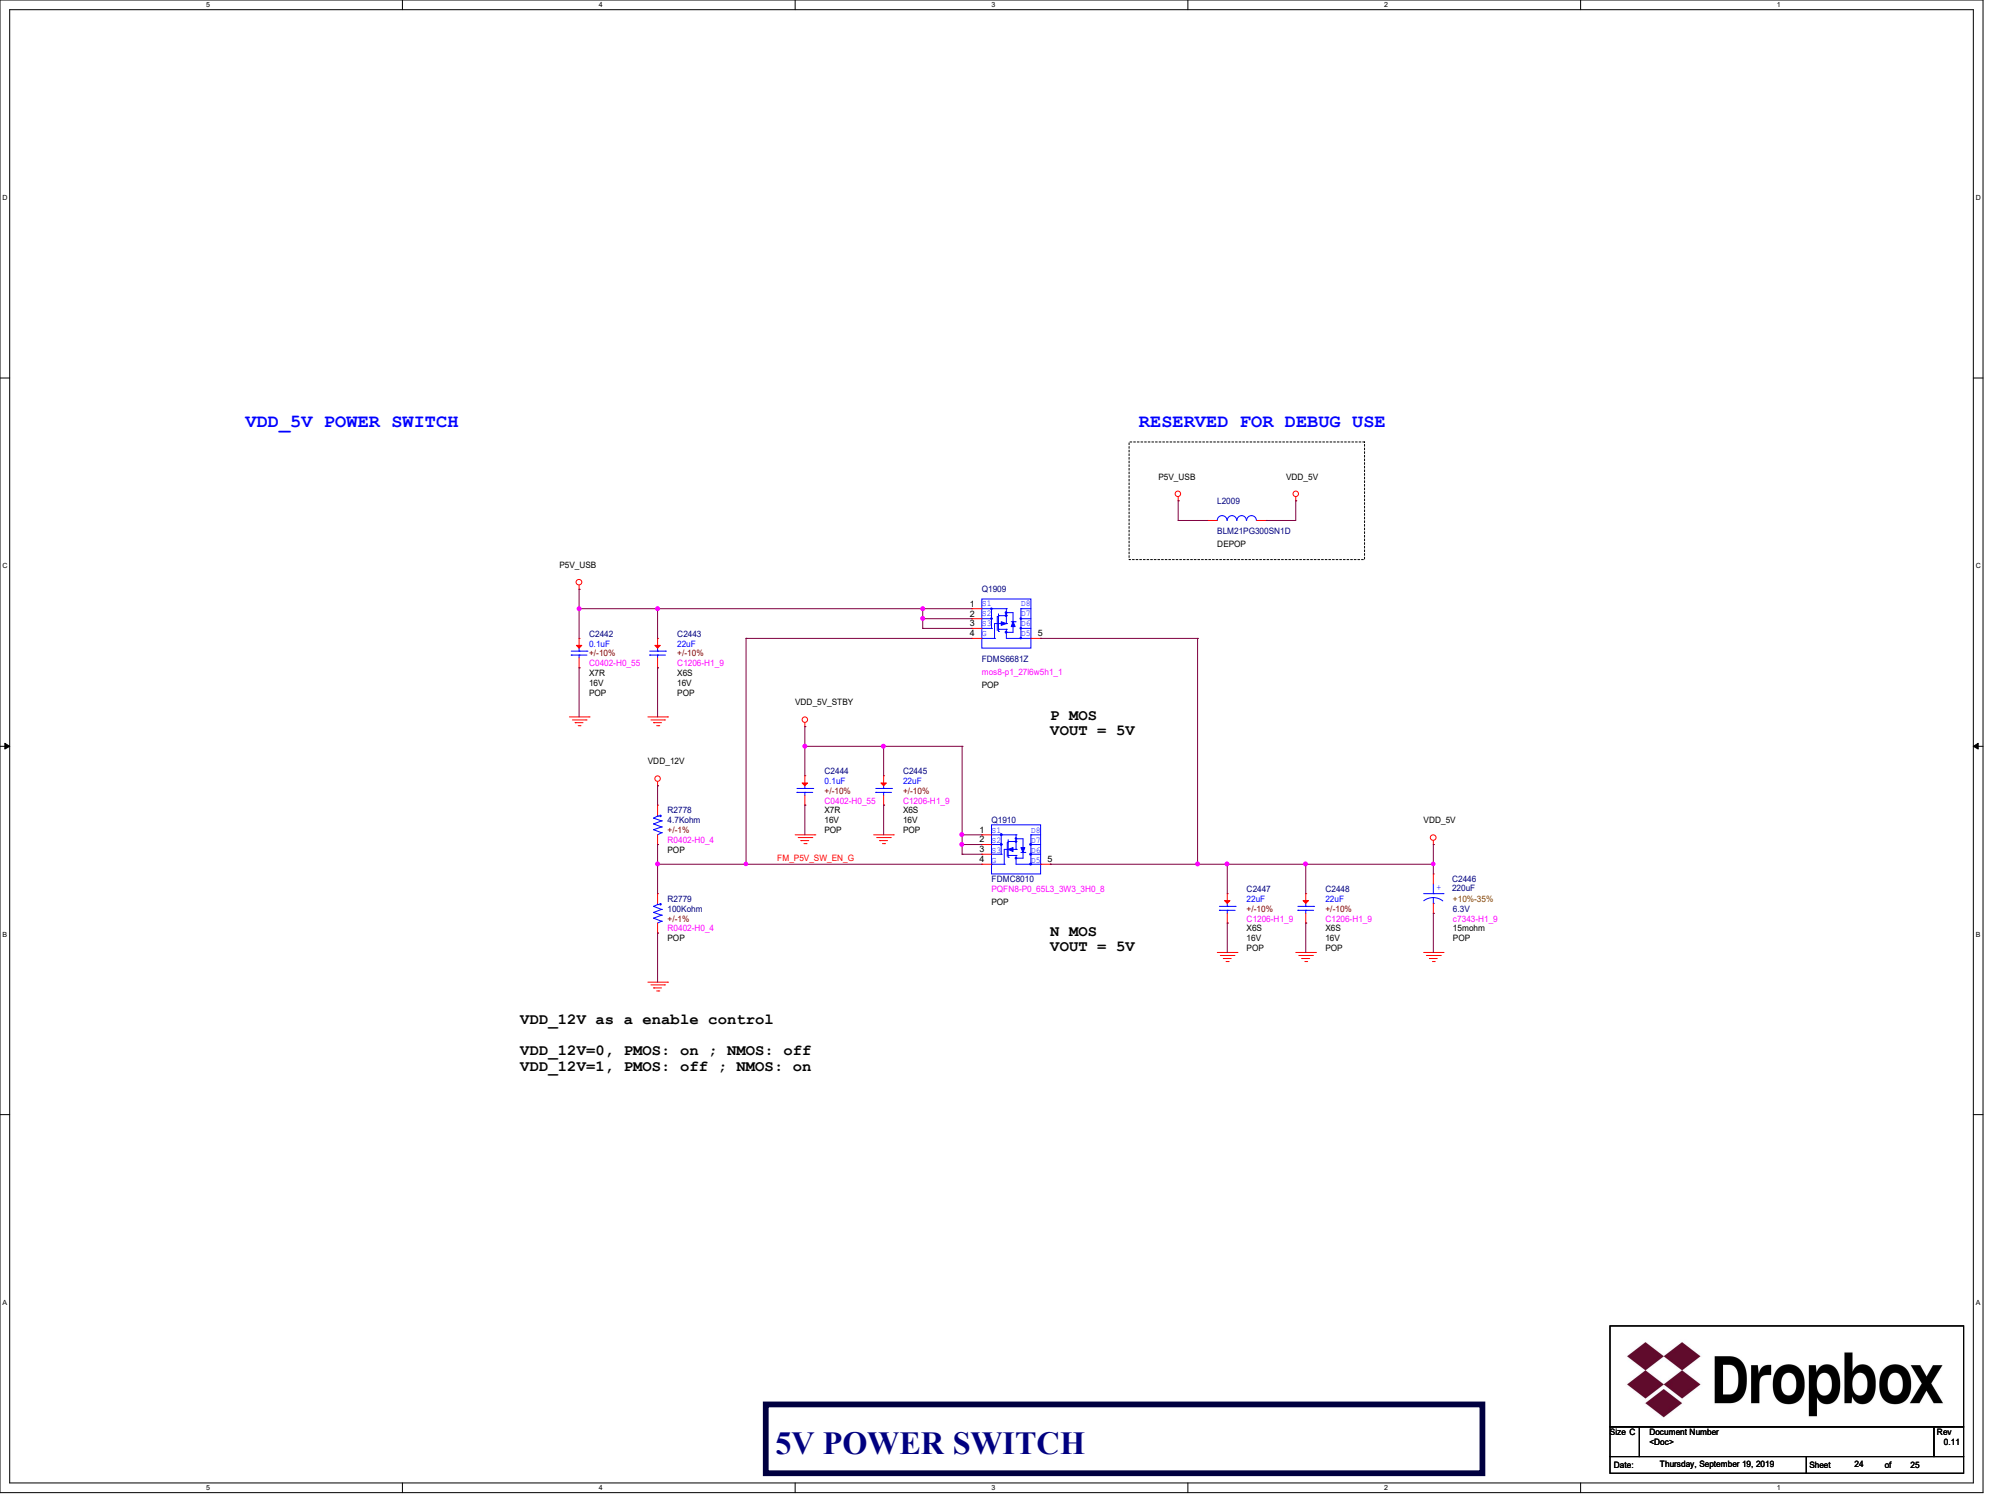
[picture p102: page 24]

VDD_12V as a enable control
VDD_12V=0, PMOS: on ; NMOS: off
VDD_12V=1, PMOS: off ; NMOS: on

# Revision History - DVT

@2019/1/17

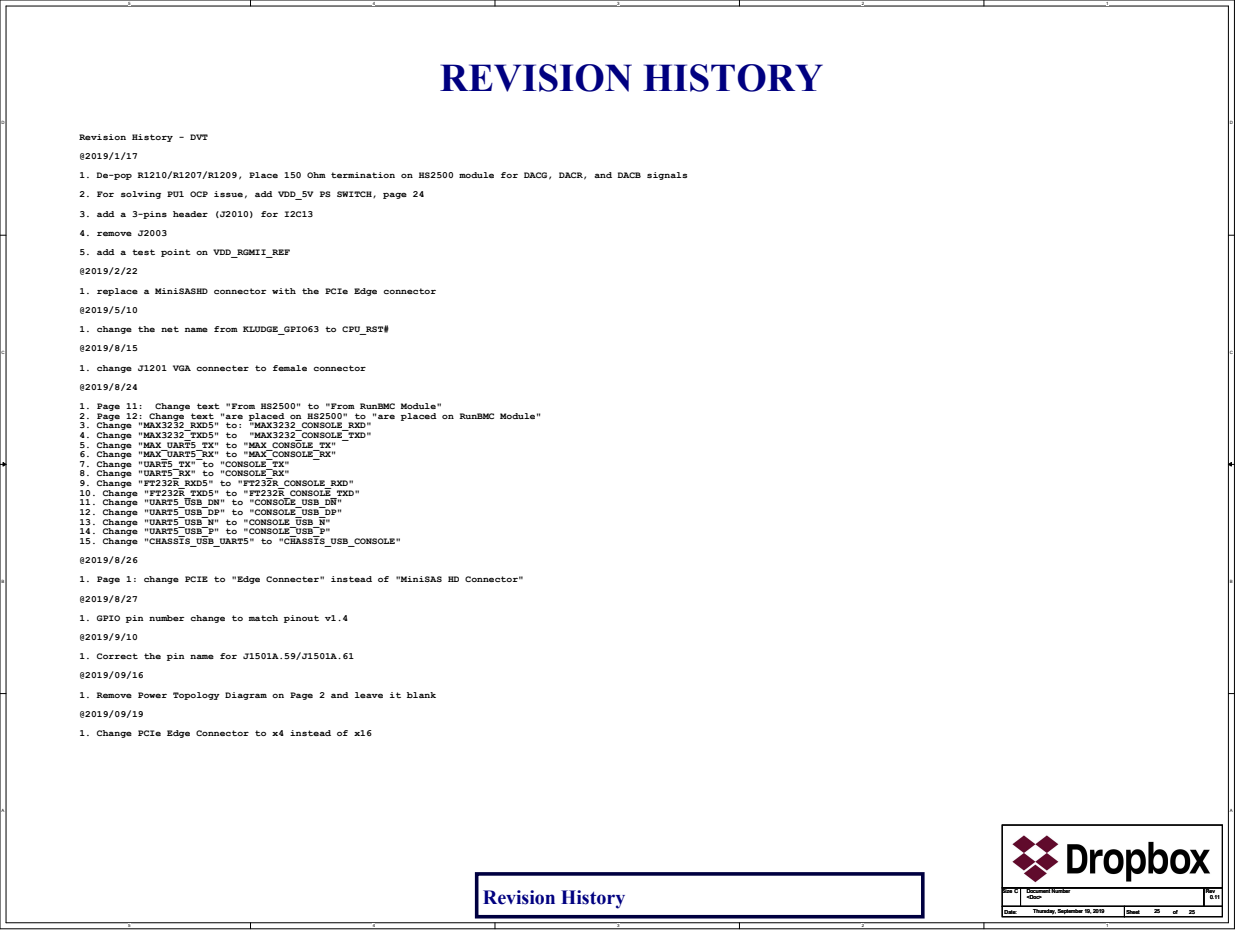
[picture p103: page 25]
Revision History; REVISION HISTORY

1. De-pop R1210/R1207/R1209, Place 150 Ohm termination on HS2500 module for DACG, DACR, and DACB signals
2. For solving PU1 OCP issue, add VDD_5V PS SWITCH, page 24
3. add a 3-pins header (J2010) for I2C13
4. remove J2003
5. add a test point on VDD_RGMII_REF
1. replace a MiniSASHD connector with the PCIe Edge connector
1. change the net name from KLUDGE_GPIO63 to CPU_RST#
1. change J1201 VGA connecter to female connector
1. Page 11: Change text "From HS2500" to "From RunBMC Module"
2. Page 12: Change text "are placed on HS2500" to "are placed on RunBMC Module"
3. Change "MAX3232_RXD5" to: "MAX3232_CONSOLE_RXD"
4. Change "MAX3232_TXD5" to "MAX3232_CONSOLE_TXD"
5. Change "MAX_UART5_TX" to "MAX_CONSOLE_TX"
6. Change "MAX_UART5_RX" to "MAX_CONSOLE_RX"
7. Change "UART5_TX" to "CONSOLE_TX"
8. Change "UART5_RX" to "CONSOLE_RX"
9. Change "FT232R_RXD5" to "FT232R_CONSOLE_RXD"
10. Change "FT232R_TXD5" to "FT232R_CONSOLE_TXD"
11. Change "UART5_USB_DN" to "CONSOLE_USB_DN"
12. Change "UART5_USB_DP" to "CONSOLE_USB_DP"
13. Change "UART5_USB_N" to "CONSOLE_USB_N"
14. Change "UART5_USB_P" to "CONSOLE_USB_P"
15. Change "CHASSIS_USB_UART5" to "CHASSIS_USB_CONSOLE"
1. Page 1: change PCIE to "Edge Connecter" instead of "MiniSAS HD Connector"
1. GPIO pin number change to match pinout v1.4
1. Correct the pin name for J1501A.59/J1501A.61
1. Remove Power Topology Diagram on Page 2 and leave it blank
1. Change PCIe Edge Connector to x4 instead of x16

Document Number Document Number Thursday, September 19, 2019 Thursday, September 19, 2019 Sheet Sheet 25 25 of <Doc> of <Doc> 25 Size 25 Size | Rev Date: Rev Date: 0.11 C 0.11 C

Thursday, September 19, 2019 | 25 25
