Nuvoton-Israel/nuvoton-info/npcm7xx-poleg/RunBMC/board_deliverables/Evaluation_RunBMC_BaseBoard_(BUV)/Rework/HSBUV_Rework_Top.pdf

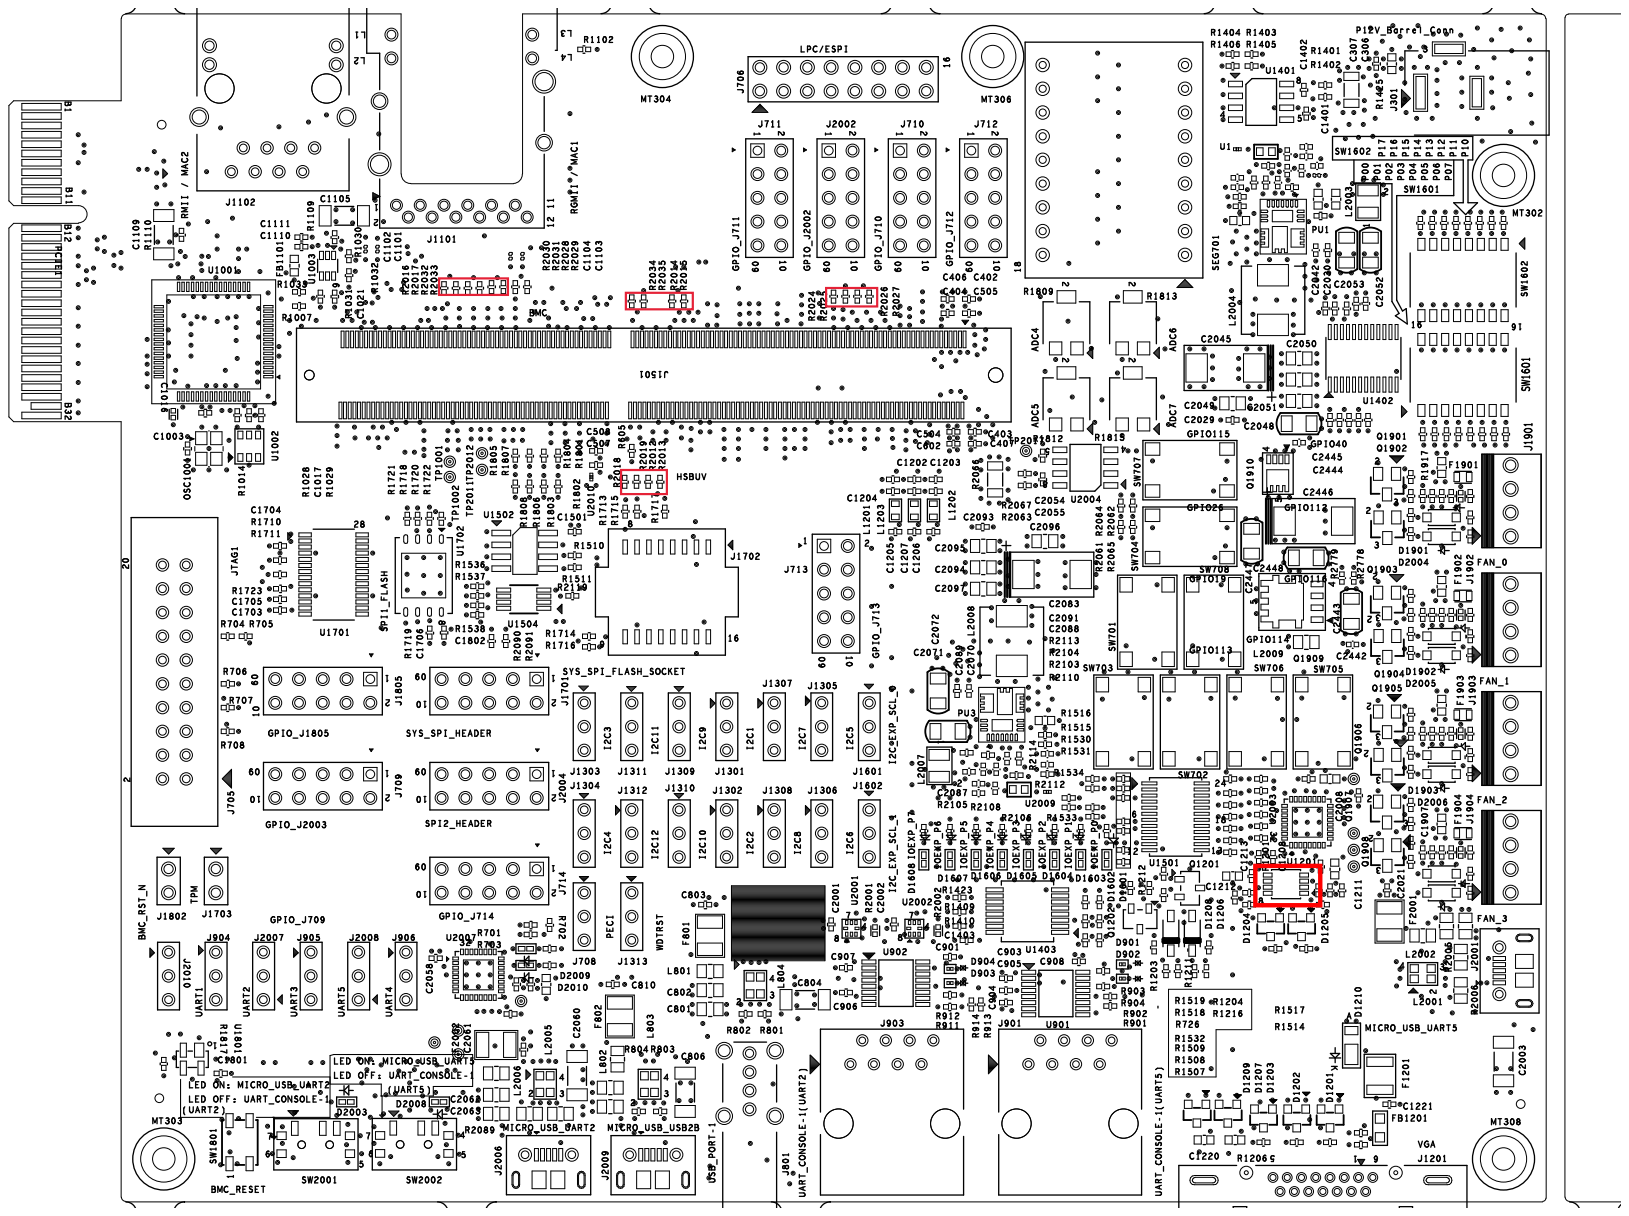
[picture p105: page 1]
