Nuvoton-Israel/nuvoton-info/(list of files, drawings)

Other design files:
npcm7xx-poleg/RunBMC/board_deliverables/Evaluation_RunBMC_BaseBoard_(BUV)/Design/runbmc_hsbuv_rev009_fab_B_0919.DSN
