Nuvoton-Israel/nuvoton-info/(commit log)

2018-06-17 Poleg initial documents
    [uboot_env_parameters.txt]
2018-06-24 add deliverables binaries for demo and schematics
    [uboot_env_parameters.txt]
2018-06-24 Add graphic drivers for BIOS, UEFI, Windows and linux
2018-11-29 Added openbmc v2.3 (removed older) and documentation updates
    [uboot_env_parameters.txt]
2019-06-06 Add RunBMC files, and change readme files
    [RunBMC_NPCM7mnx_BOM_A.1.0.xlsx]
2020-08-17 add BUV files and reconstruct folders
    [RunBMC_NPCM7mnx_BOM_A.1.0.xlsx, runbmc_hsbuv_rev009_fab_B_0919.DSN]
